kantholz44mm/cpu/documentation/protokolle/protokoll_17_10_2024.md

17.10.2024
Martin Rentschler, Matthias Raba
Besprechung zum Ablauf der Studienarbeit

# Protokoll
Allgemeines zur Betreuung (Martin):
- Individuelle Bewertung je nach Betreuer (hoher Freiheitsgrad)
- Bewertung anhand gleicher Bewertungsmatrix wie T2000 & Bachelorarbeit (evtl. kleine Gewichtungsänderungen)

Zur Wirtschaftlichkeit:
- Allgemeines wirtschaftliches Denken im Vorgehen (wie effizient ist eine Lösung)
- Dokumentierte Entscheidungsfindung mit wirtschaftlicher Betrachtung (Zeit, Prioritäten setzen, etc.)

Zwischenstand bei "Halbzeit":
- Bewertung nach gleichem Schema, gemeinesames Durchsprechen
- Daher Erwartungshaltung: Zur Halbzeit muss bewertbarer Stand vorliegen
    - Inhaltliche Struktur (Kapitelstruktur)
    - Grob die Hälfte ausgearbeitet

Frühzeitig anzeigen, wenn der Projektverlauf "aus den Fugen gerät"

Projektplanung:
- Nicht nur Zeitplan, sondern auch:
  - Bewertung, was kritische Teile sind
  - Wo steckt Potential für Verzögerungen
  - Verhalten im Problemfall
  - etc.
- Erstplan für gesamtes Projekt
  - Aktuelle Gegebenheiten
  - Realistisch darstellen, wie Ziel erreicht wird
  - Nicht final, aber seriöse, kritisch durchdachte Planung
  - Meilensteine mit Granularität von Monaten oder Wochen (von grob nach fein durcharbeiten)
  - Ist das Projekt machbar? Ist der Plan noch haltbar (kontinuierlich nachprüfen)
- Meilensteine
  - Entweder fixer Zeitpunkt
  - oder fixer Zeitpunkt mit fixem Featureset
  - Größenordnung: 3-5 Meilensteine
    - Halbzeit (Zeit)
    - Abgabe (Zeit)

Ausreichend Zeit für Puffer
Feature Creep bewusst vermeiden, auch im kleinen Rahmen

Intelligente Projektplanung:
Was ist der "Kern" der Arbeit, was ist "Bonus"
Visuell arbeiten: Alles aufs Papier, dann gruppieren und identifizieren -> Präzisierung des Rahmens

Frage Matthias: Wie viel Zeit sollte für Organisatorisches aufgewendet werden
-> Ca. 10% - 20% in planerische Fragen stecken (lieber zuviel als zu wenig)

Frage Matthias: Wie wird mit Hardware umgegangen? Wann soll ich bestellen/aufbauen
Perspektive aus Sicht des Ziels (pragmatisch): "Ich will am Ende X Leiterkarten haben, die in Schaltung XY resultieren"
Daraus Ableitung der Zwischenziele (erneut: reichlich Puffer einplanen)
Lücken in der Bearbeitungszeit (Warten auf Hardware, Bestückung, etc.) -> Andere Tätigkeiten abarbeiten
Betrachtung spätester/frühester Zeitpunkt, Hardware zu bestellen (auch für Teilbestellungen)
Brauche ich einen Prototypen? In welcher Reihenfolge werden die Komponenten aufgebaut (Stichpunkt Projektplanung)
-> Inkrementelles Vorgehen (im Kontrast zu iterativ)

Rahmenbedingungen Dokumentation:
- Standardstruktur (Stand der Technik: Grundarchitekturen, Grundlagen, etc., Fazit, Konzept, Umsetzung, Inbetriebnahme/Testing)
- 3 - 5 Kapitel
- ca. 50 - 80 Seiten

Frage Matthias: Wie viel Hardware, wie viel zur Software/Struktur/Logik
- Erklärung der Hardware-Grundbauelemente (Bottom up; Gatter, Resistoren, Dioden -> Module -> Bibliothek -> CPU)
- Hardwareteil ansonsten knapp
- Nach eigener Aufwandsabschätzung, wie viel Aufwand ist Software/Hardware
- Nicht kategorisch auftrennen, was inhaltlich oder in der Bearbeitung parallel passiert

Konkrete Aufgabenstellung:
- Bisher bereits hinreichend besprochen
- Konkretisierung: Was braucht wie lange, was wird gestrichen, was kommt dazu, was dient dem Lernziel

Empfehlung:
An etablierten Standards bleiben/orientieren
Wenn eigene ISA, dann ausreichende kritische Auseinandersetzung mit Literatur dazu (!)
Haptisches Eingabe-/Ausgabewerk, Displays/LEDs, Knöpfe, etc.
