kantholz44mm/cpu/documentation/paper/acronyms.tex

\DeclareAcronym{can}{
    short = CAN,
    long = Controller Area Network,
}

\DeclareAcronym{hmi}{
    short = HMI,
    long = Human Machine Interface,
}

\DeclareAcronym{ip}{
    short = IP,
    long = Internet Protocol,
}

\DeclareAcronym{api}{
    short = API,
    long = Application Programming Interface,
}

\DeclareAcronym{rest}{
    short = REST,
    long = Representational State Transfer,
}

\DeclareAcronym{ssh}{
    short = SSH,
    long = Secure Shell,
}

\DeclareAcronym{dll}{
    short = DLL,
    long = Dynamic-link Library,
}

\DeclareAcronym{json}{
    short = JSON,
    long = JavaScript Object Notation,
}

\DeclareAcronym{ascii}{
    short = ASCII,
    long = American Standard Code for Information Interchange
}

\DeclareAcronym{hal}{
    short = HAL,
    long = Hardware Abstraction Layer 
}

\DeclareAcronym{gui}{
    short = GUI,
    long = Graphical User Interface 
}

\DeclareAcronym{xml}{
    short = XML,
    long = Extensible Markup Language,
}

\DeclareAcronym{uuid}{
    short = UUID,
    long = Universally Unique Identifier,
}

\DeclareAcronym{usb}{
    short = USB,
    long = Universal Serial Bus,
}

\DeclareAcronym{ide}{
    short = IDE,
    long = Integrated Development Environment,
}

\DeclareAcronym{tls}{
    short = TLS,
    long = Transport Layer Security,
}

\DeclareAcronym{rpc}{
    short = RPC,
    long = Remote Procedure Call,
}

\DeclareAcronym{url}{
    short = URL,
    long = Uniform Resource Locator,
}

\DeclareAcronym{http}{
    short = HTTP,
    long = HyperText Transfer Protocol,
}

\DeclareAcronym{bsw}{
    short = BSW,
    long = Basis software,
}

\DeclareAcronym{eeprom}{
    short = EEPROM,
    long = Electronically Erasable Programmable Read-only Memory,
}

\DeclareAcronym{mcu}{
    short = MCU,
    long = Main Control Unit,
}

\DeclareAcronym{crc}{
    short = CRC,
    long = Cyclic Redundancy Check,
}

\DeclareAcronym{sent}{
    short = SENT,
    long = Single Edge Nibble Transmission,
}

\DeclareAcronym{ecu}{
    short = ECU,
    long = Electronic Control Unit,
}

\DeclareAcronym{sbc}{
    short = SBC,
    long = Single Board Computer,
}

\DeclareAcronym{cpu}{
    short = CPU,
    long = Central Processing Unit,
}

\DeclareAcronym{pcb}{
    short = PCB,
    long = Printed Circuit Board,
}

\DeclareAcronym{esd}{
    short = ESD,
    long = Electrostatic Discharge,
}

\DeclareAcronym{spc}{
    short = SPC,
    long = Short Pulse Code,
}

\DeclareAcronym{mosfet}{
    short = MOSFET,
    long = Metal Oxide Semiconductor Field Effect Transistor
}

\DeclareAcronym{bjt}{
    short = BJT,
    long = Bipolar Junction Transistor,
}

\DeclareAcronym{fm}{
    short = FM,
    long = Frequency Modulation,
}

\DeclareAcronym{am}{
    short = AM,
    long = Amplitude Modulation,
}

\DeclareAcronym{adc}{
    short = ADC,
    long = Analog to Digital Converter,
}

\DeclareAcronym{dc}{
    short = DC,
    long = Direct Current,
}

\DeclareAcronym{osi}{
    short = OSI,
    long = Open Systems Interconnect,
}

\DeclareAcronym{iso}{
    short = ISO,
    long = International Organisation for Standardisation,
}

\DeclareAcronym{tcpip}{
    short = TCP/IP,
    long = Transfer Control Protocol / Internet Protocol,
}

\DeclareAcronym{dma}{
    short = DMA,
    long = Direct memory access
}

\DeclareAcronym{pwm}{
    short = PWM,
    long = Pulse Width Modulation
}

\DeclareAcronym{i2s}{
    short = I2S,
    long = Inter-Integrated Circuit Sound
}

\DeclareAcronym{isa}{
    short = ISA,
    long = Instruction Set Architecture
}

\DeclareAcronym{lifo}{
    short = LIFO,
    long = \text{Last-In, First-Out}
}

\DeclareAcronym{mips}{
    short = MIPS,
    long = \text{Microprocessor without Interlocked Pipeline Stages}
}

\DeclareAcronym{risc}{
    short = RISC,
    long = \text{Reduced Instruction Set Computing}
}

\DeclareAcronym{cisc}{
    short = CISC,
    long = \text{Complex Instruction Set Computing}
}

\DeclareAcronym{alu}{
    short = ALU,
    long = Arithmetic Logic Unit
}

\DeclareAcronym{smd}{
    short = SMD,
    long = Surface mounted device
}

\DeclareAcronym{led}{
    short = LED,
    long = Light emitting diode
}

\DeclareAcronym{tht}{
    short = THT,
    long = Through Hole Technology
}

\DeclareAcronym{dut}{
    short = DUT,
    long = Device Under Test
}

\DeclareAcronym{ic}{
    short = IC,
    long = Integrated Circuit
}

\DeclareAcronym{ieee}{
    short = IEEE,
    long = Institute of Electrical and Electronics Engineers,
}

\DeclareAcronym{io}{
    short = IO,
    long = Input/Output,
}

\DeclareAcronym{ram}{
    short = RAM,
    long = Random access memory,
}

\DeclareAcronym{rom}{
    short = ROM,
    long = Read-Only memory
}

\DeclareAcronym{arm}{
    short = ARM,
    long = {Advanced RISC Machines (formerly Acorn RISC Machines)},
}

\DeclareAcronym{lc3}{
    short = {LC-3},
    long = {Little Computer 3},
}

\DeclareAcronym{ava}{
    short = AVA,
    long = Arithmetic Visualisation Architecture
}

\DeclareAcronym{jedec}{
    short = JEDEC,
    long = Joint Electron Device Engineering Council
}

\DeclareAcronym{ptc}{
    short = PTC,
    long = Positive Temperature Coefficient
}

\DeclareAcronym{ntc}{
    short = NTC,
    long = Negative Temperature Coefficient
}

\DeclareAcronym{uart}{
    short = UART,
    long = Universal Asynchonous Receiver/Transmitter
}

\DeclareAcronym{gpio}{
    short = GPIO,
    long = General Purpose Input/Output
}

\DeclareAcronym{icp}{
    short = ICP,
    long = In-circuit programming
}

\DeclareAcronym{icsp}{
    short = ICSP,
    long = In-circuit serial programming
}

\DeclareAcronym{emi}{
    short = EMI,
    long = Electromagnetic Interference
}

\DeclareAcronym{lsb}{
    short = LSB,
    long = Least Significant Bit
}

\DeclareAcronym{jvm}{
    short = JVM,
    long = Java Virtual Machine
}
