kantholz44mm/cpu/documentation/paper/cover.tex

\begin{titlepage}
    \begin{minipage}[t]{8.2cm}
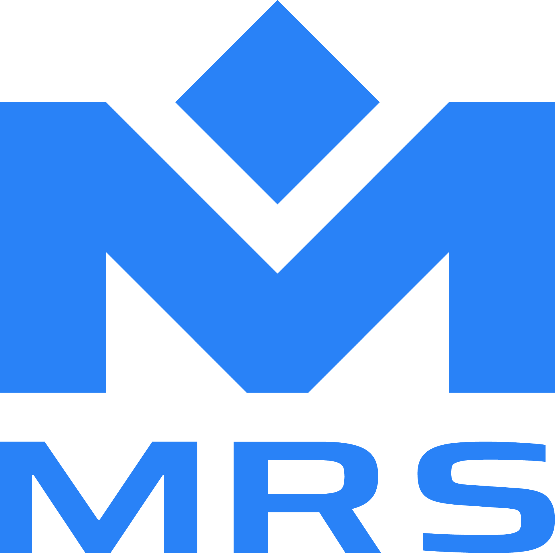
[picture p1: documentation/paper/images/logo.jpg]
        
    \end{minipage}
    \hfill
    \begin{minipage}[t]{5.4cm}
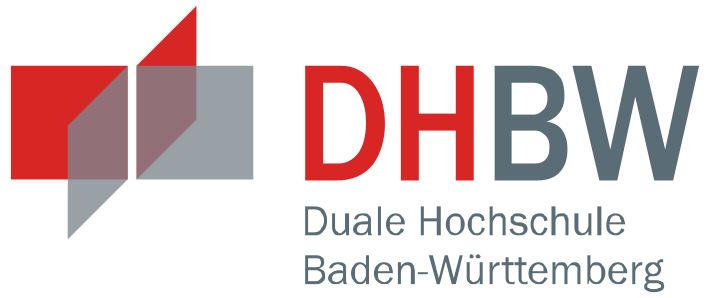
[picture p2: documentation/paper/images/dhbw.png]
        
    \end{minipage}
	\enlargethispage{20mm}
	\begin{center}
		\vspace*{12mm}	{\LARGE\textbf \vtitle }\\
		\vspace*{12mm}	{\large Student research project (T3\_3101)}\\
		\vspace*{12mm}	of the Computer Science program at\\
        \vspace*{3mm}   Cooperative State University of Baden-Württemberg (DHBW)\\
		\vspace*{12mm}	by\\
		\vspace*{3mm}		{\large\textbf  \vauthor}\\
		\vspace*{12mm}	\today\\
	\end{center}
    \begin{center}
        \renewcommand{\arraystretch}{1.2}
        \vfill
        \begin{tabular}{l|l}
            \textbf{Period of work} & \vtimespan \\
            \textbf{Registration number, Class} & \vregistrationnumber, \vcourse \\
            \textbf{Location} & Rottweil \\
            \textbf{training organisation} & \vcompany \\
            \textbf{Supervisor} & \vsupervisor \\
        \end{tabular}
        \renewcommand{\arraystretch}{1.0}
    \end{center}
    \vspace{3cm}
\end{titlepage}
