kantholz44mm/cpu/documentation/paper/appendix.tex

\appendix

\section*{}
\addtocounter{section}{1}

\subsection{Full ALU schematic} \label{app:schematic_alu}
\includepdf[pages=-, angle=90, width=0.9\textwidth]{images/appendix/schematic_alu.pdf}
\newpage

\subsection{IO unit schematic} \label{app:schematic_io}
\includepdf[pages=-, angle=90, width=0.9\textwidth]{images/appendix/schematic_io.pdf}
\newpage

\subsection{Register fabric schematic} \label{app:schematic_register_fabric}
\includepdf[pages=-, angle=90, width=0.9\textwidth]{images/appendix/schematic_register_fabric.pdf}
\newpage

\subsection{Register schematic} \label{app:schematic_register}
\includepdf[pages=-, angle=90, width=0.9\textwidth]{images/appendix/schematic_register.pdf}
\newpage

\subsection{Logic gate-level \ac{ava} simulation} \label{app:simulation_full}
\begin{center}
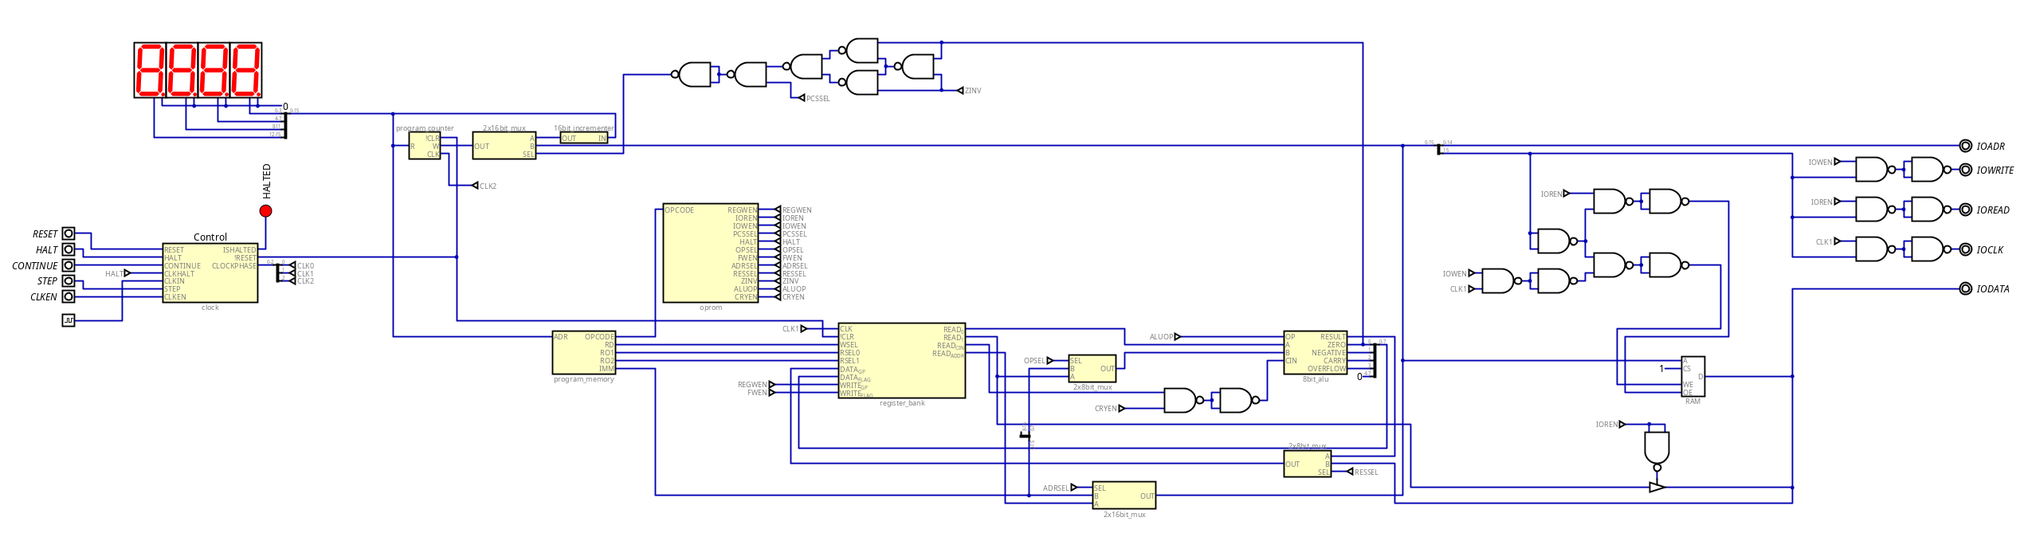
[picture p3: documentation/paper/images/appendix/logical_design_full.png]
    
\end{center}
\newpage

\subsection{Assembled CPU} \label{app:cpu_assembly}
\begin{center}
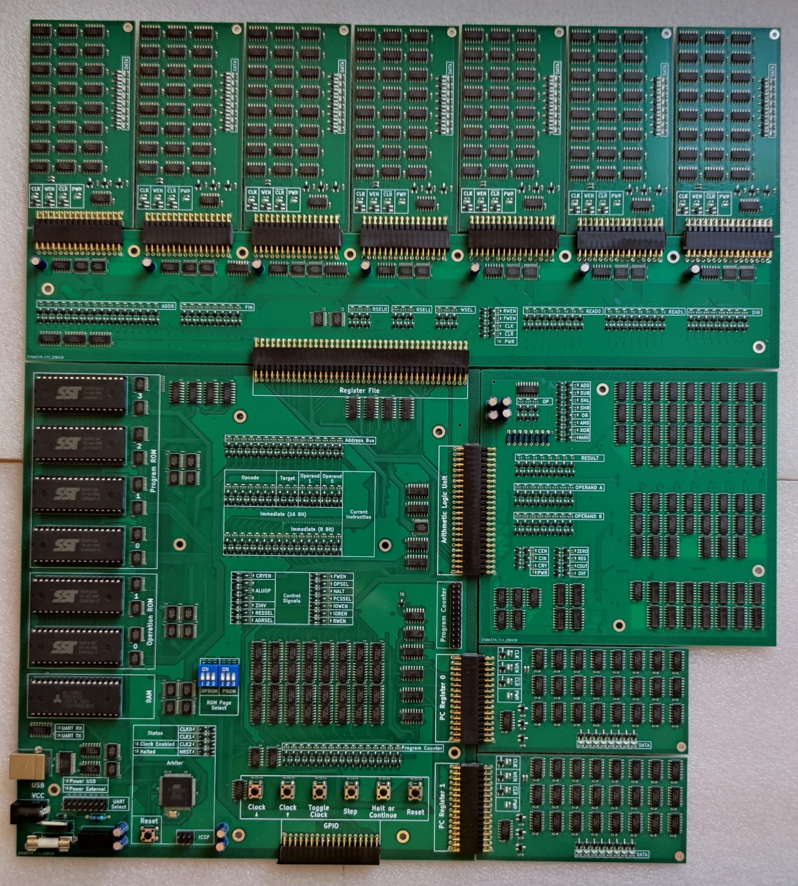
[picture p4: documentation/paper/images/pcb/full_assembly_front.jpg]

\end{center}
\newpage

\subsection{Assembled ALU circuit board} \label{app:alu_assembled}
\begin{center}
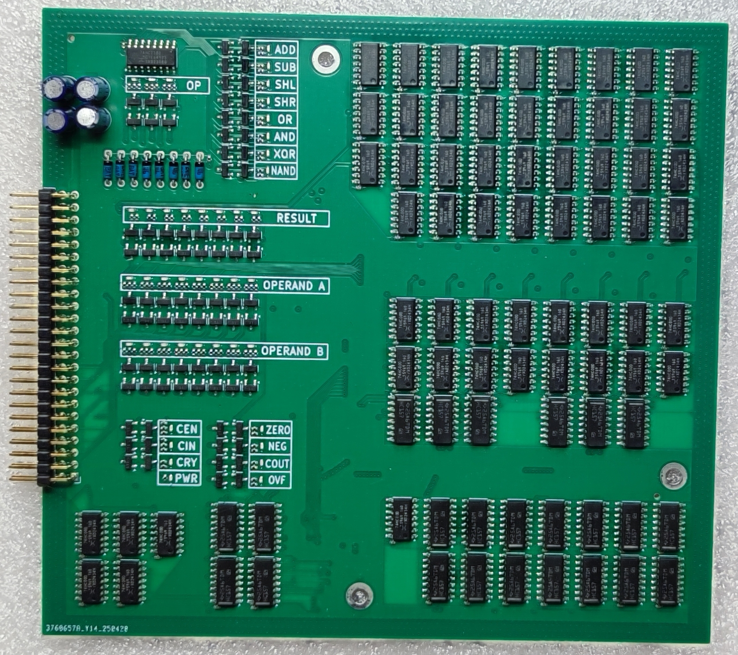
[picture p5: documentation/paper/images/pcb/alu_assembled_front.jpg]
    
\newpage
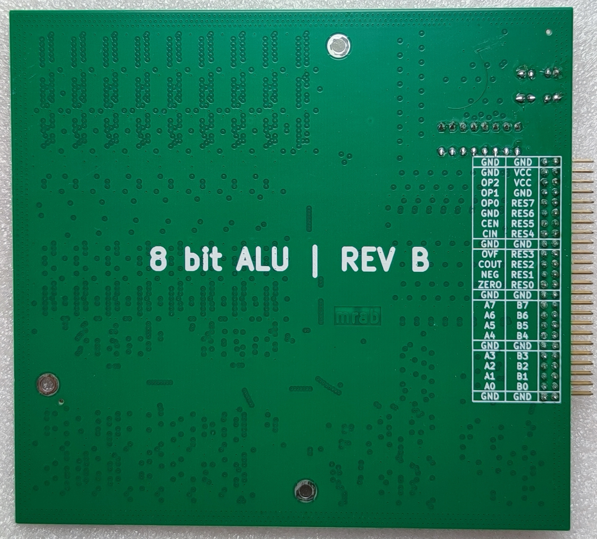
[picture p6: documentation/paper/images/pcb/alu_assembled_back.jpg]

\end{center}
\newpage

\subsection{Unassembled ALU circuit board} \label{app:alu_not_assembled}
\begin{center}
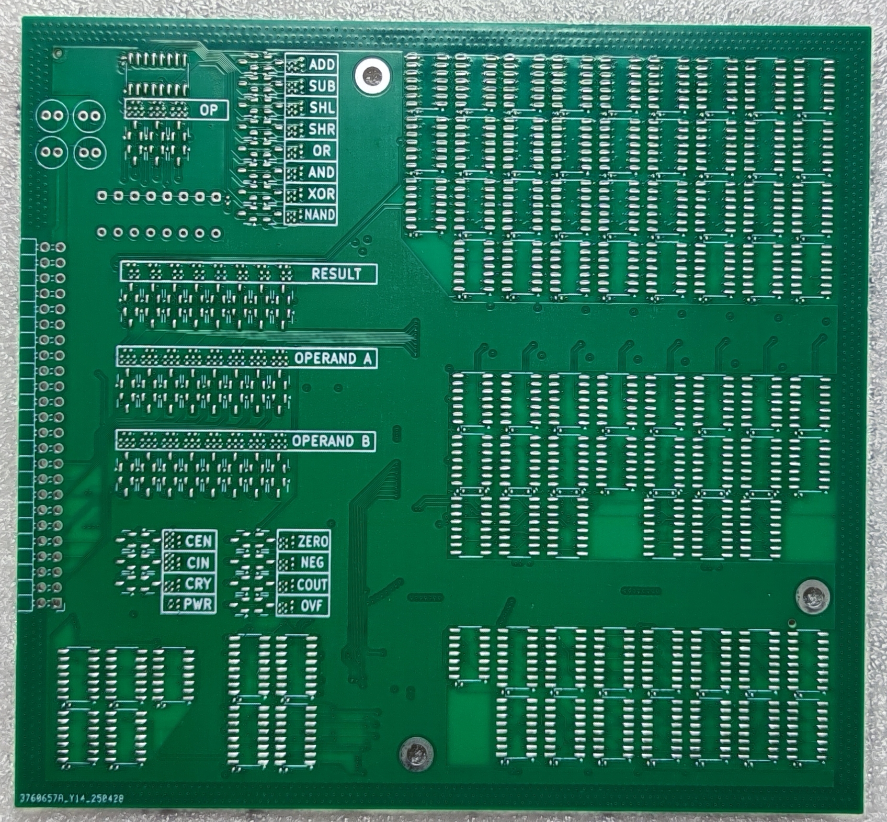
[picture p7: documentation/paper/images/pcb/alu_not_assembled_front.jpg]

\newpage
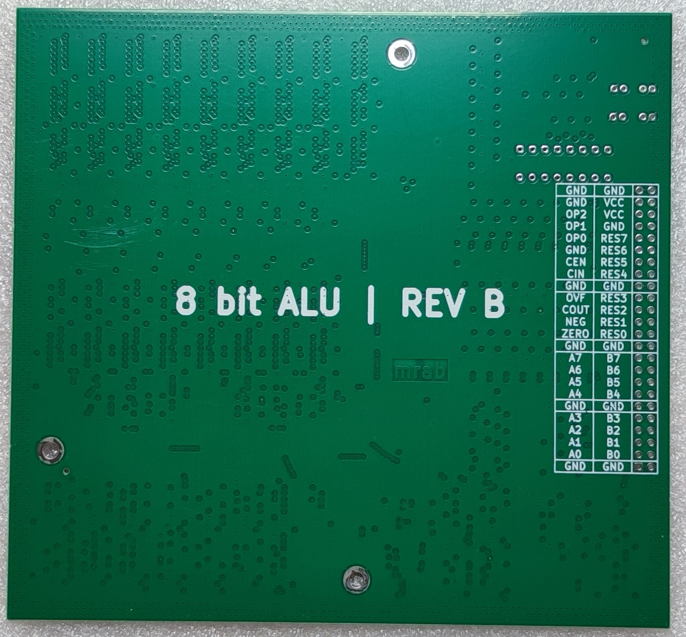
[picture p8: documentation/paper/images/pcb/alu_not_assembled_back.jpg]

\end{center}
\newpage

\subsection{Assembled register fabric circuit board} \label{app:register_fabric_assembled}
\begin{figure}[H]
    \centering
    \begin{subfigure}[b]{0.49\textwidth}
        \centering
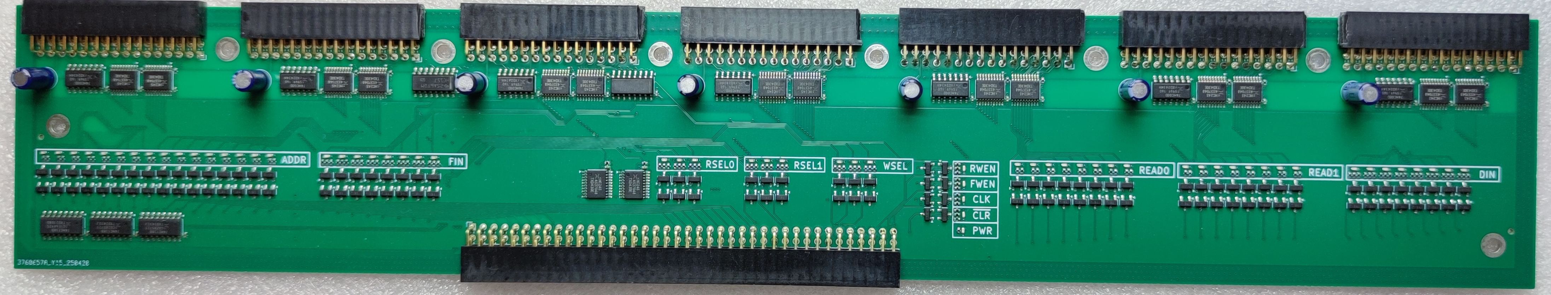
[picture p9: documentation/paper/images/pcb/fabric_assembled_front.jpg]
        
    \end{subfigure}
    \hfill % Adds spacing between subfigures
    \begin{subfigure}[b]{0.49\textwidth}
        \centering
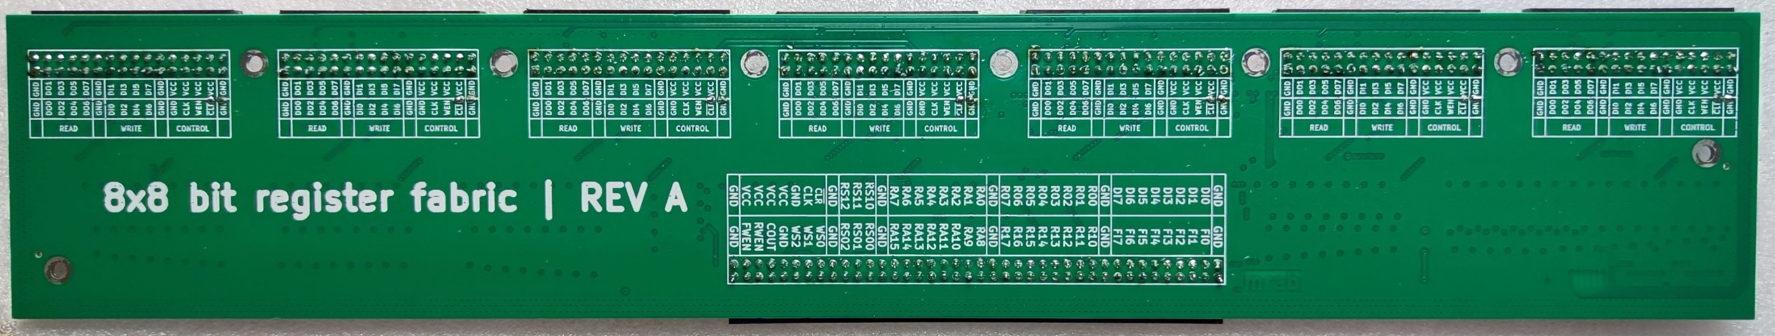
[picture p10: documentation/paper/images/pcb/fabric_assembled_back.jpg]
        
    \end{subfigure}
\end{figure}
\newpage

\subsection{Unassembled register fabric circuit board} \label{app:register_fabric_not_assembled}
\begin{figure}[H]
    \centering
    \begin{subfigure}[b]{0.49\textwidth}
        \centering
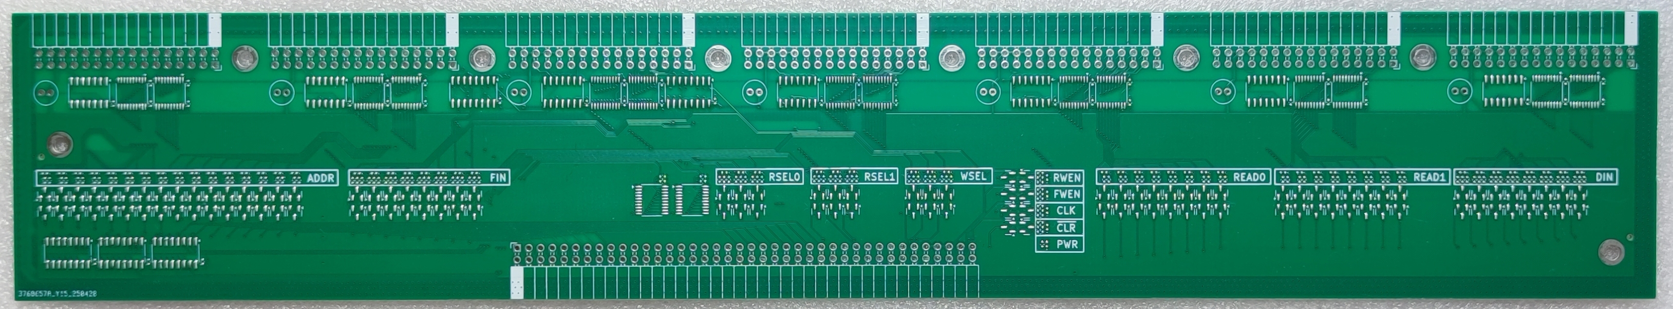
[picture p11: documentation/paper/images/pcb/fabric_not_assembled_front.jpg]
        
    \end{subfigure}
    \hfill % Adds spacing between subfigures
    \begin{subfigure}[b]{0.49\textwidth}
        \centering
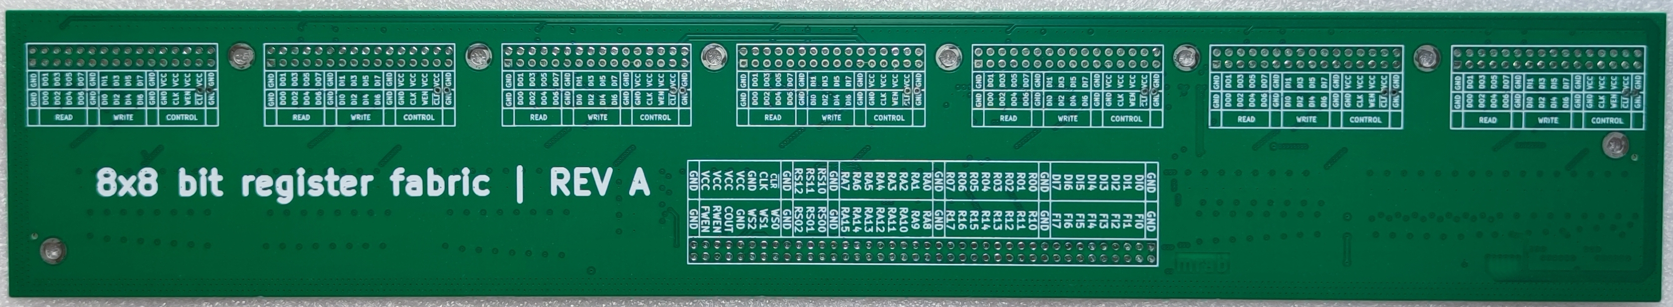
[picture p12: documentation/paper/images/pcb/fabric_not_assembled_back.jpg]
        
    \end{subfigure}
\end{figure}
\newpage

\subsection{Unassembled IO circuit board} \label{app:io_not_assembled}
\begin{center}
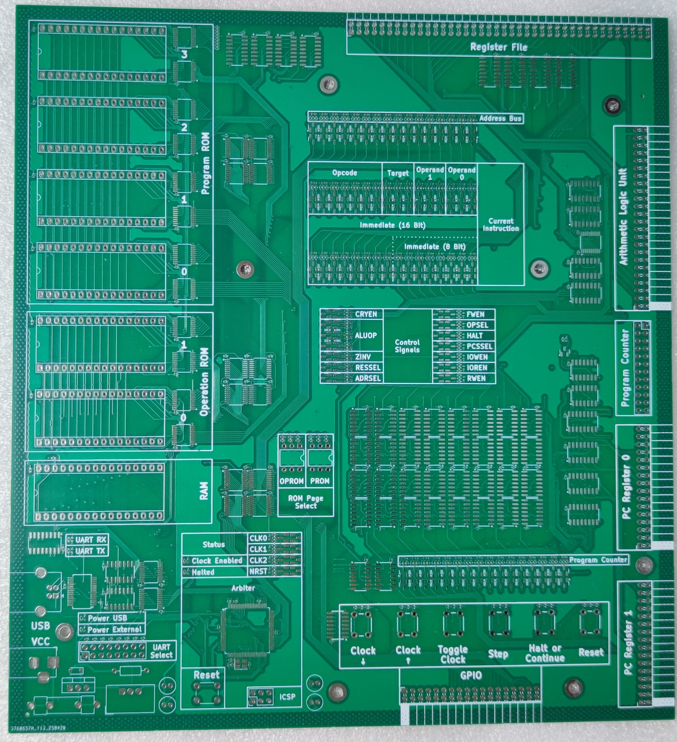
[picture p13: documentation/paper/images/pcb/io_not_assembled_front.jpg]

\newpage
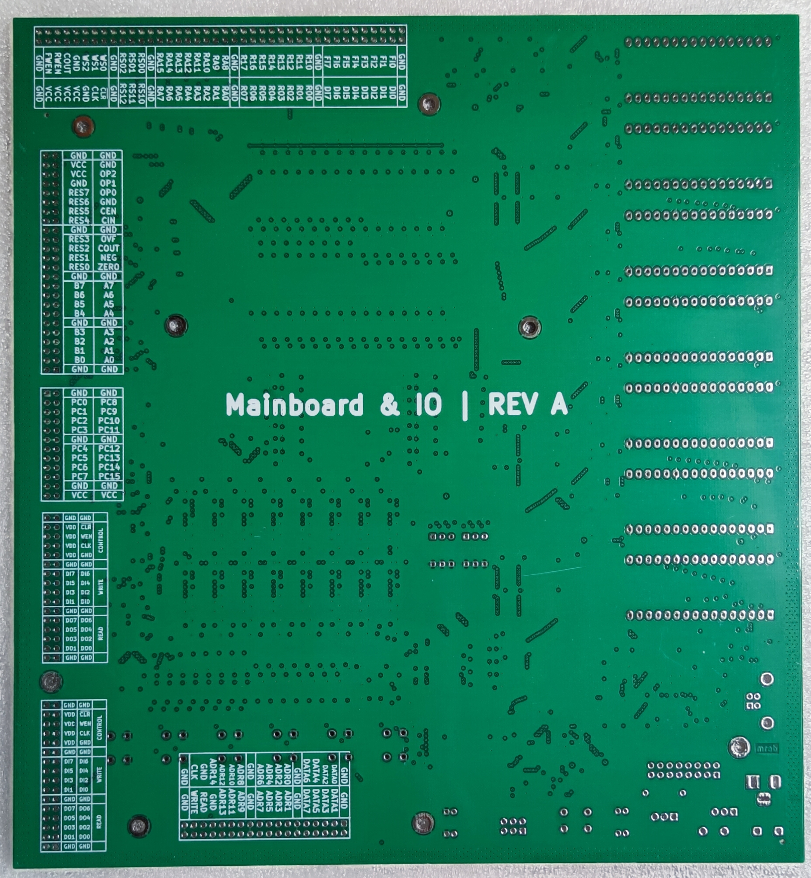
[picture p14: documentation/paper/images/pcb/io_not_assembled_back.jpg]

\end{center}
\newpage

\subsection{Assembled IO circuit board} \label{app:io_assembled}
\begin{center}
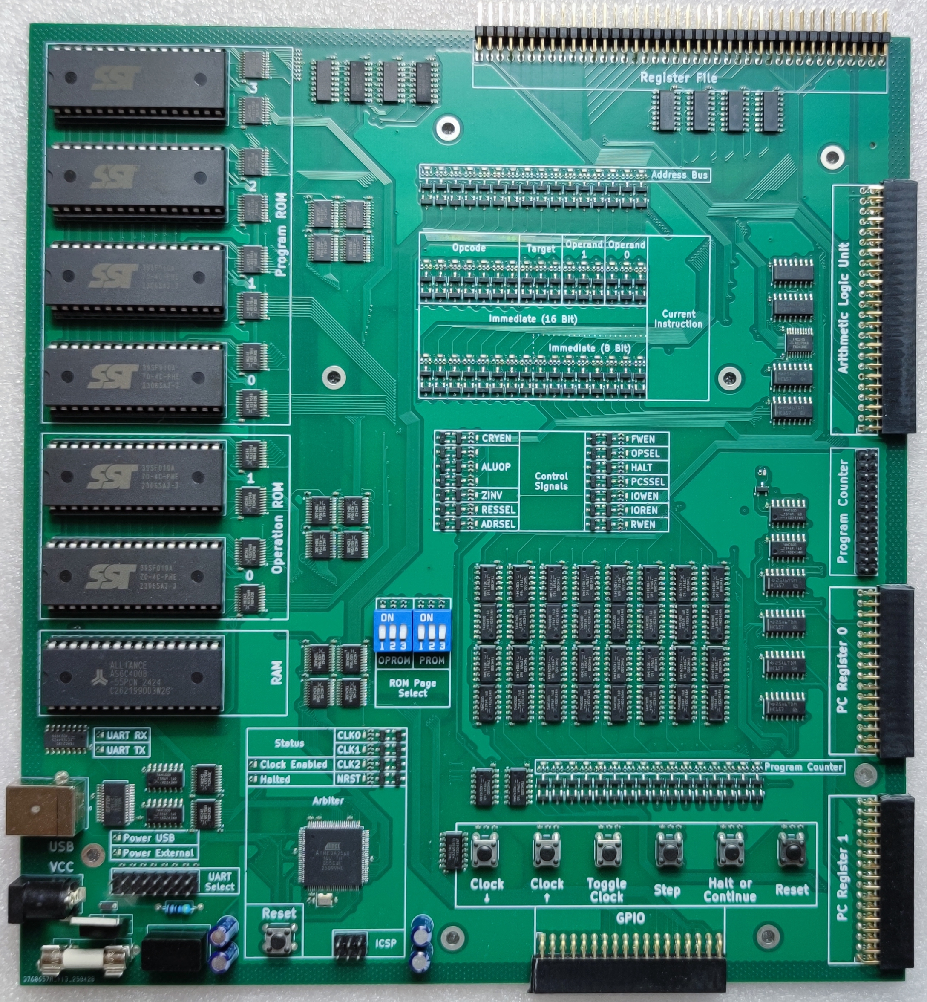
[picture p15: documentation/paper/images/pcb/io_assembled_front.jpg]

\newpage
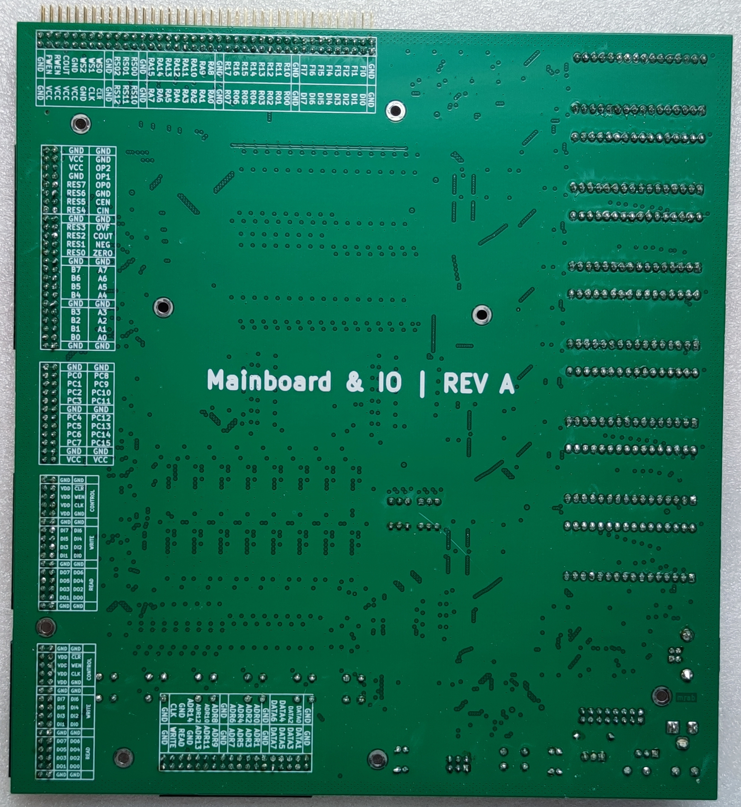
[picture p16: documentation/paper/images/pcb/io_assembled_back.jpg]

\end{center}
\newpage

\subsection{Assembled register circuit board} \label{app:register_assembled}
\begin{center}
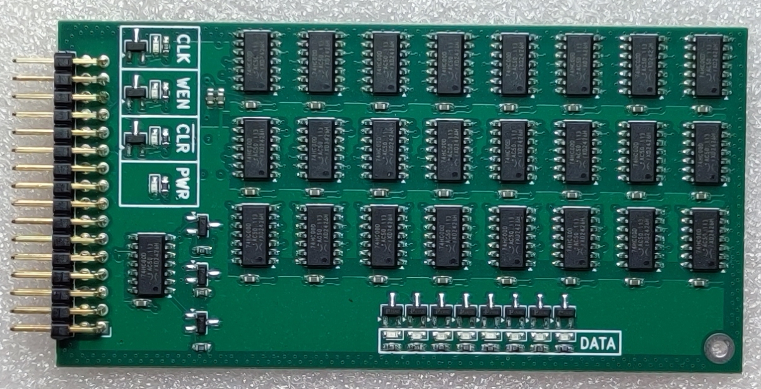
[picture p17: documentation/paper/images/pcb/register_assembled_front.jpg]
    
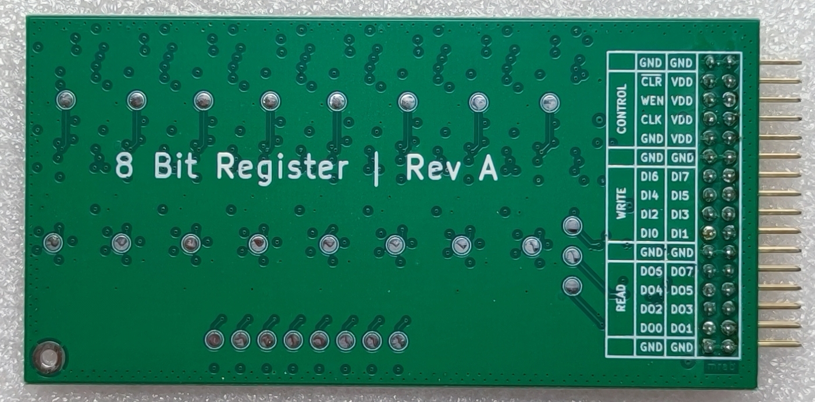
[picture p18: documentation/paper/images/pcb/register_assembled_back.jpg]

\end{center}
