kantholz44mm/cpu/documentation/organisation/notes.md

- Beschreibung Übersicht vervollständigen (Farbige Pfeile, Taktgesteuerte Elemente kennzeichnen?)
- Synchrone/Asynchrone Logik erklären
- Anfangs Designphilosophie erklären
- Kleine Historie und Einordnung in diese
