kantholz44mm/cpu/documentation/paper/statutory.tex

%!TEX root = ../dokumentation.tex

\thispagestyle{empty}
\vspace*{2em}

\section*{Statutory declaration}

I hereby declare that I have composed the present work {\itshape \vtitle} myself and without use of any other than the
cited sources and aids. Sentences or parts of sentences quoted literally are marked as such; other references
with regard to the statement and scope are indicated by full details of the publications concerned. The work
in the same or similar form has not been submitted to any examination body and has not been published.
This thesis was not yet, even in part, used in another examination or as a course performance.

I am aware that a false statement will have legal consequences.

\vspace{3em}

Horb, \today
\vspace{1em}

\\
\rule{6cm}{0.4pt}\\
\vauthor
