kantholz44mm/cpu/documentation/paper/sections/fundamentals/isa.tex

\subsection{Instruction Set Architecture}

An \ac{isa} defines the shared behavior of different implementations of said \ac{isa}. It is an abstract model that guarantees compatibility of software between computers of different implementation. This is called binary intercompatibility. It describes the supported set of instructions, their behavior, as well as a memory model. The memory model describes the number and roles of all registers, as well as the behavior of accessing memory and external interfaces. The latter part is also called the ``IO-Model'' of the \ac{isa}. An \ac{isa} may be designed to be extensible or closed for future modifications. An \ac{isa} may adhere more to the principles of \ac{risc} or \ac{cisc}, or a combination of both.

\subsubsection{ISA vs. Implementation} \label{sec:isa_vs_implementation}

An \ac{isa} is an abstract model and does not specify \textit{how} it is to be implemented. When a \ac{cpu} implementing a specific \ac{isa} is designed, the designers are largely free to choose the exact implementation details, as long as the end product adheres to the rules laid out by the \ac{isa}. The distinction between an \ac{isa} and an implementation is important; an \ac{isa} by itself cannot run code. There may be multiple implementations using vastly different electrical or logical technologies. Due to the boolean logic transformation rules mentioned in \autoref{sec:logical_operators}, there is an infinite number of possible implementations, even when the same set of electrical components is used. Many \acp{isa} also leave room for interpretation or choice when it comes to electrotechnical details such as the voltage levels used, etc. An implementation of an \ac{isa} is also referred to as a microarchitecture. For example, the microarchitecture used by Intel for their flagship x86 \acp{cpu} is called the ``P6'' microarchitecture \cite{intel1997p6}.

\subsubsection{Memory} \label{sec:fundamentals_isa_memory}

A digital computer operates on data, which is stored within some memory. An \ac{isa} must define how this data is organised and used so that software is guaranteed to behave as expected regardless of the implementation.

\paragraph*{Memory Model} \label{sec:fundamentals_isa_memory_model}

The memory model of an \ac{isa} specifies how the data within the system is laid out. A memory in this context is any electrical circuit that stores some number of bits of information for later use. Registers store temporary data such as operands, results or variables and are intended to be frequently read from and written to. They are addressed directly by the programmer through their individual names. Formally, this class of memory is called the internal storage of a \ac{cpu} \cite{bryant2015computer}. In addition to the set of registers, cache also falls into this category. However, since cache is implementation-dependent and may be implemented transparently to the programmer and to the \ac{isa}, it is not discussed here.

Most useful programs are larger than the amount of data that fits into the register set. Most programs also use far more memory to store temporary data such as variables. Therefore, in addition to the registers, other memories are available to the programmer. These memories are typically orders of magnitude slower to access when compared to the internal storage, especially the registers. However, in turn, they offer orders of magnitude more storage. In this context, all of these memories shall be referred to as ``main memories''. All memories that are physically implemented must be finite in size. Therefore, they are divided up into cells of usefully sized data.

A ``word'' is the smallest, atomic unit of data used by most operations of an \ac{isa}. It is specified as the number of bits that form one word, usually a power of two. For example, in a 32 bit architecture, the \texttt{ADD} operation will most likely operate on two 32 bit operands, ouputting another 32 bit result. The lowest level data storage units of the same \ac{isa} will most likely be designed to also contain 32 bit words to contain one operand or result each. Each word of $n$ bits can represent $2^n$ different values. This is typically a power of 2, since many of the circuits used to implement such systems naturally favor such sizes. This includes decoders, multiplexers and similar circuits. Early processors such as the Intel 4004 had a word size of 4 bits, meaning one word can represent 16 distinct values. Most modern systems have either 32 or 64 bit processors. However, even so, the venerable byte has remained as the smallest practical, individually addressable unit of bits, consisting of 8 bits each. It can therefore represent 256 distinct values. It has proven to be a good middle ground in terms of granularity and size. Most \ac{ram} and \ac{rom} components are byte-addressible, meaning they also handle data with a size of 8 bits each. If the programmer needs to process data that does not fit into a single word, multiple words can be used and processed in sequence to form arbitrarily large data. 

Similarly, multiple registers can be concatenated to hold a larger piece of data. For example, the \ac{mips} architecture uses two dedicated 32 bit registers ``HI'' and ``LO'' to store results of multiplication or division, since these can easily overflow a single 32 bit register when doing an operation with 32 bit operands \cite{mips1995}. Similarly, throughout the evolution of the x86 \ac{isa}, the initial 8 bit registers were first expanded to 16, then to 32, and most recently to 64 bit registers. To retain backwards compatibility, the smaller sections remain accessible to the programmer.  

\begin{figure}[H]
    \centering
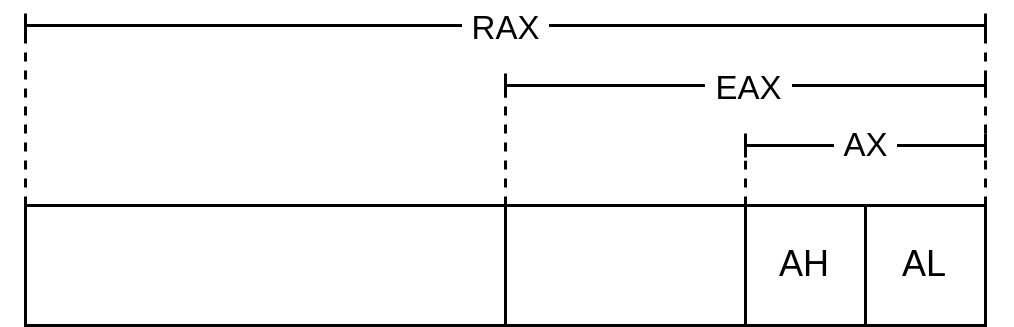
[picture p48: documentation/paper/images/drawio/x86_register_size.png]
      % Replace with your image file
    \caption[Composition of an x86 register]{Composition of a general purpose register in the x86 architecture. Each square represents one byte.}
    \label{fig:x86_register_sizes}
\end{figure}

\autoref{fig:x86_register_sizes} shows the composition of a single general purpose register in the x86 architecture. The Intel 8086 was the first processor to implement the x86 \ac{isa}. It featured 8 general purpose 8 bit registers, which could be accessed in pairs of two to form 4 16 bit registers \cite[p. 1-6]{intelASM86Manual1983}. For example, the \texttt{AH} and \texttt{AL} registers can be accessed by some instructions as the 16 bit register \texttt{AX}. This pattern was extended to form 32 and eventually 64 bit registers. Using multiple registers in combination to form a single larger memory can be used by an \ac{isa} to index into larger memories than would otherwise be possible. It is also common practice for an \ac{isa} to feature registers of different sizes, including ones larger than the native word size. Again, this way, larger memories can be indexed, which can be used to increase the maximum size and complexity of programs.
\clearpage
Depending on the way the memory can be accessed by the programmer, an \ac{isa} falls into one of three proven memory models:

\begin{itemize}
    \item Von Neumann
    \item Harvard
    \item Modified Harvard
\end{itemize}

In a machine obeying the Von Neumann memory model, there is only one global memory space, which contains both data and program instructions. In a Harvard architecture, these memories have a separate address space. A modified Harvard architecture is functionally the same as a regular Harvard one, but the software can access the instruction memory as if it was data, while still being stored in a separate memory. This is the memory model used by many modern \ac{isa}. Having two separate memories for storing data and program instructions has the main benefit of allowing different word and address sizes.

\paragraph*{Memory mapped \ac{io}}

Some of the address space available to the programmer can have an \ac{io} device connected to it. This is called ``memory mapped \ac{io}''. In this method, main memory and \ac{io} devices use the same, shared address space. This allows the \ac{cpu} to use regular memory operations to interact with heterogenous devices such as \ac{gpio}, \acp{adc} or other \acp{cpu} by simply reading or writing to the address. One example for this practice is the memory mapping of the original GameBoy console. The memory region \texttt{0x8000} - \texttt{0xA000} is mapped to the video \ac{ram} used by the graphics unit. Therefore, modifying data in this address region modifies the colors of the pixels shown by the display\cite{nintendo_gb_manual_v1_1}. 

Memory mapped \ac{io} is contrasted by port-based \ac{io}, in which there are dedicated \ac{io} ports with their own address or name space. These must be accessed by special instructions such as \texttt{OUTB} or \texttt{INB}.

\paragraph*{Execution Model} \label{sec:fundamentals_isa_execution_model}

An execution model describes how the computer achieves computation. This means the order of execution and the number and location of operands and results. As with the memory model, there are multiple options to choose from:

\begin{figure}[H]
    \centering
    \begin{subfigure}[b]{0.3\textwidth}
        \centering
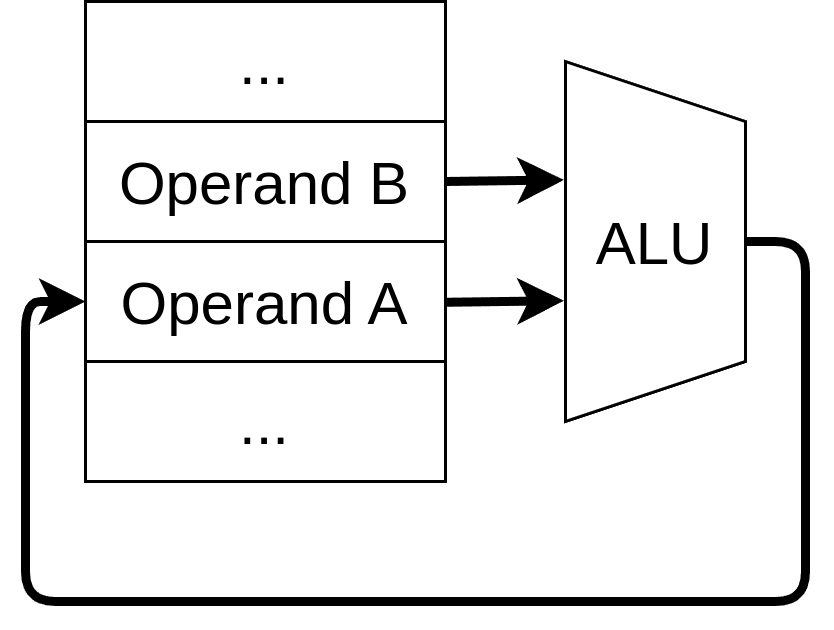
[picture p49: documentation/paper/images/drawio/stack_architecture.png]
         % Replace with your image file
        \caption{Stack based architecture}
        \label{fig:stack_based_architecture}
    \end{subfigure}
    \hfill % Adds spacing between subfigures
    \begin{subfigure}[b]{0.3\textwidth}
        \centering
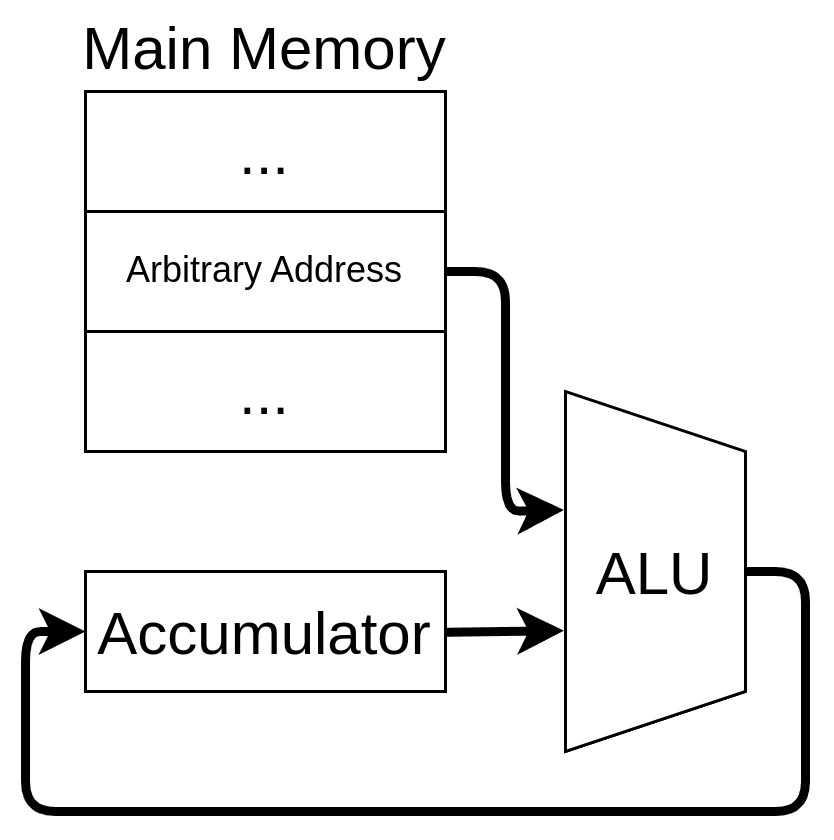
[picture p50: documentation/paper/images/drawio/accumulator_architecture.png]
         % Replace with your image file
        \caption{Accumulator architecture}
        \label{fig:accumulator_architecture}
    \end{subfigure}
    \hfill
    \begin{subfigure}[b]{0.3\textwidth}
        \centering
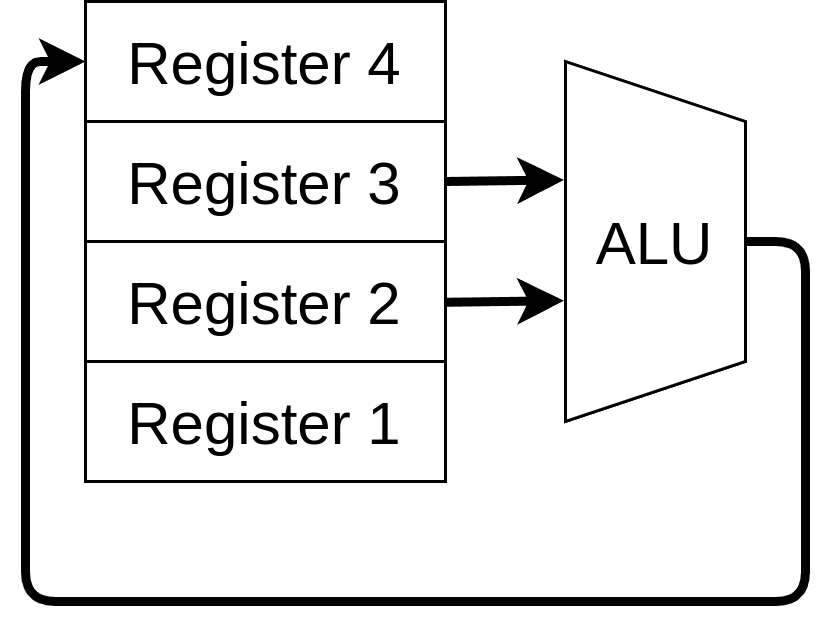
[picture p51: documentation/paper/images/drawio/register_architecture.png]
         % Replace with your image file
        \caption{Register architecture}
        \label{fig:register_architecture}
    \end{subfigure}

    \caption[Execution models]{Working principle of the three execution models Stack, Accumulator and Register}
    \label{fig:execution_models}
\end{figure}

The stack based model uses a single working memory, which is organised by the \ac{lifo} principle. The operands of an operation are always the elements at a specified offset from the stack top. For example, an addition may pop the top two elements off the top of the stack and push the result back ontop. This method has the advantage of not having to specify operand locations in the instruction, allowing for more compact code. However, it lacks the ability to randomly access memory and frequent stack operations can be slow. Since implementing a stack in software instead of hardware is trivial and quite performant on modern hardware, many programming languages are implemented as virtual stack machines. For example, the \ac{jvm}\cite{oracle_jvms_8} and popular python distribution ``CPython''\cite{ike-nwosu2024pythonvm} are implemented as stack machines.

The accumulator-based execution model has a fixed number of registers, one of which is the designated accumulator register. All operations that output a value will store this result in the accumulator register. The accumulator register is also always one of the operands to an operation. The other operand, if required, is read either from memory or from another register, which can either also be fixed or freely chosen by the programmer, depending on the instruction encoding scheme. This execution model is easy to implement and the instructions are also smaller compared to fully addressable operand/destination registers. It is often used in early \ac{cpu} such as the Intel 8008 and 6502 \cite{schlyter200513}. However, its performance is limited by the bottleneck of the accumulator register. it also requires frequent transfers between memory and registers or between registers to save intermediary results, which would otherwise be overwritten by another operation.

The register based execution model provides a fixed set of registers. This model is subdivided further into the ``Register-Register'' and ``Memory-Register'' models. \autoref{fig:register_architecture} shows the former, which is also known as a ``Load-Store architecture'', since the only way of transferring data between registers and memory is via the dedicated load and store operations. All operands and result destinations of an arithmetic operation are registers. The ``Memory-Register'' model allows operations to be read from memory instead. Due to the bottleneck in speed of modern memories, many modern register based architectures are of the Load-Store variant. The register based execution model is highly flexible and well understood. Operands and intermediary results can be reused efficiently and compilers can deterministically optimize register allocation, allowing for higher performance. This is the model used by most prevalent architectures.

\paragraph*{Addressing modes}

There are many different modes of addressing memories. An addressing mode specifies which memory is accessed, and how the address for that memory is calculated. \autoref{fig:addressing_modes_general} shows a hierarchical overview of types of modes of addressing. The complexity and number of arithmetic operations required for each mode increase with column, starting at the left. Within each column, complexity increases from top to bottom.

\begin{figure}[H]
    \centering
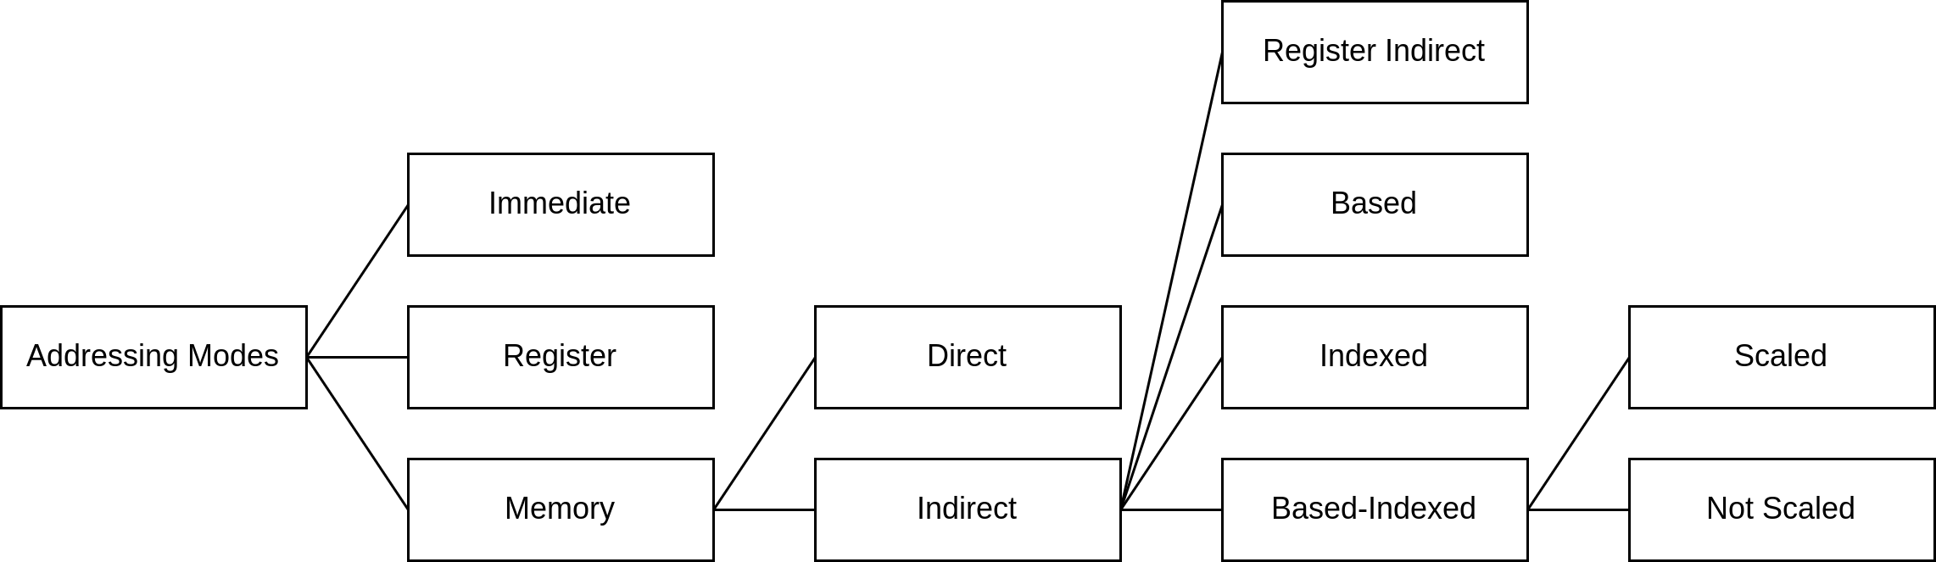
[picture p52: documentation/paper/images/drawio/addressing_modes_general.png]
      % Replace with your image file
    \caption[Hierarchical overview of addressing modes]{Hierarchical overview of addressing modes (Modified from S. Dandamudi, laid out horizontally and compacted for readability \cite{sivarama_addrmodes})}
    \label{fig:addressing_modes_general}
\end{figure}

Again, the complexity increases starting from the left. The more complex an addressing mode is, the more additional hardware is required. For the given modes, the most complex one is referred to as ``Base + Index + Scale + Displacement''. In this mode, the resulting memory address is calculated like so:

$$ \text{Base} + \text{Index} * \text{Scale} + \text{Displacement} $$

This requires additional hardware for performing the additions and multiplication. Note that the ``Scale'' is restricted to 1, 2, 4 or 8 and can therefore be implemented by shifting the index to the left by 1, 2, 3 or 4 bits. In most modern, and some older architectures, the addressing modes can be quite numerous and complex. For example, the Intel 6502 has 13 different addressing modes \cite[13.2.1]{schlyter200513}. However, an \ac{isa} need not implement a large number of addressing modes in order to be useful. For example, the Intel 8008 \ac{cpu} only has 3 addressing modes (Register, Register Indirect and Immediate) \cite{cpu-world8008}. The complex addressing modes are useful when implementing features of high-level programming languages such as arrays or structured data.

\subsubsection{Instructions}

An instruction is the atomic building block of programs. In \ac{risc} architectures, instructions generally do a single thing and side-effects are minimal. In \ac{cisc} architectures, a single instruction may do several things such as incrementing a counter and modifying both the contents of memory and some register.

\paragraph*{Opcodes}

Every instruction is identified by its unique ``Opcode'', which is a discrete number. Based on this number, the processor must infer the number and layout of operands and set up the internal state for execution of the given instruction. The number of bits available for encoding the opcodes determines the maximum number of instructions supported by an \ac{isa}. Not all opcodes within this available range must be assigned. Depending on the design philosophy, unassigned opcodes may be equivalent to NOPs or cause undefined behavior. In some \acp{isa}, the number of bits per opcode is variable. For example, in the widely used x86 \ac{isa}, the opcode can be between 8 and 24 bits \cite{mahoney2021enumerating}. More frequently used operations are assigned a shorter opcode to increase code density. An architecture may also split the opcode into multiple parts, deferring analysis of the full opcode to different stages of instruction decoding. This allows designers to more efficiently use the available index space of any n-bit opcode, also increasing code density.

\paragraph*{Types of Instruction}

Instructions can be divided up into different types based on their effects. There are instructions that perform some calculation and store the result in a target memory location. These instructions will be referred to as ``arithmetic instructions''. There are also instructions that do not calculate anything but simply move data between memories. Most \ac{risc} architectures follow the ``Load-Store'' paradigm. This paradigm says that only a select few instructions interact with main memory, whereas the rest of the instructions, including all arithmetic ones, interact only with immediate data and registers. These instructions will be referred to as ``transfer instructions''. Another important class of instruction is the ``control flow instruction''. As the name suggests, this type of instruction usually does not compute anything either, but is responsible for the decision making process within the \ac{cpu}. Upon executing such an instruction, the program counter, instead of being incremented, is overwritten with a value from a memory. This is called branching. There are unconditional and conditional branches, which only overwrite the program counter if some predicate is met. This predicate is typically dictated by a flag stemming from the result of the last arithmetic instruction. Branching is required for implementing function calls and general conditional execution, i.e ``Do X if Y, otherwise do Z''. An architecture may have instructions that fit into multiple categories. For example, the \ac{arm} architecture allows any instruction to be executed conditionally\cite{armv7m_manual} by storing condition bits in its instruction encoding.

\paragraph*{Instruction Encoding}

In order for a processor to understand each instruction, it must be laid out in a predictable, well defined manner. This is called the instruction encoding format. This encoding must include all information required for performing a desired operation. The encoding must include the opcode, all operands and any additional settings required for executing an operation. Since different operations require a different number and type of operands, it can be useful to define a variable length encoding scheme to save memory and increase code density. On the other hand, variable length encodings require additional logic to determine the length from a given opcode and fetch the required number of bytes from memory. This introduces complexity in an implementation, as well as increasing the number of logic gates required. Typically, this also causes the fetch phase to take more than a single clock cycle. For these reasons, many \ac{risc} architectures use a fixed length encoding. Since different types of instructions require different combinations of options and operands, \acp{isa} may define multiple distinct encoding schemes. The instruction decoder can then choose the corresponding format for each opcode.

\begin{figure}[H]
    \centering
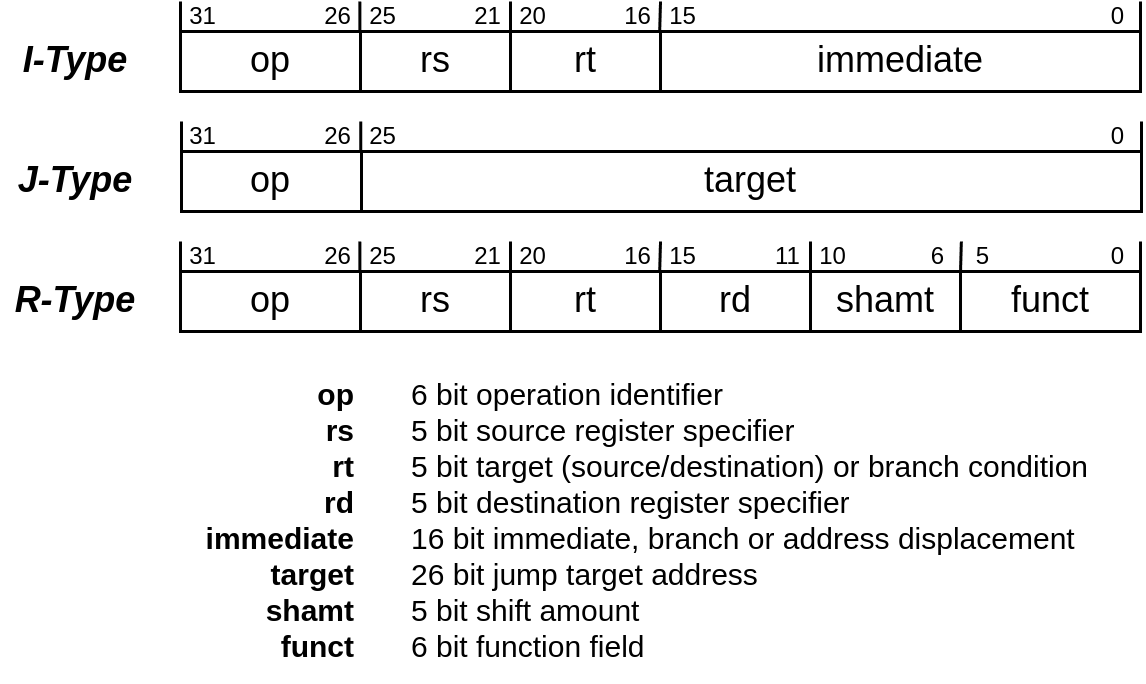
[picture p53: documentation/paper/images/drawio/mips_instruction_encoding.png]
      % Replace with your image file
    \caption[MIPS32 instruction encoding scheme]{MIPS 32 bit instruction encoding scheme and field descriptions. Numbers above fields represent bit positions within the instruction (modified from Charles Price, aggregated information of multiple tables in section A-15 and A-16 \cite{mips1995})}
    \label{fig:mips_instruction_encoding}
\end{figure}

\autoref{fig:mips_instruction_encoding} shows the instruction encoding scheme of the \ac{mips} architecture, including brief descriptions of the individual fields. Since \ac{mips} is intended to be used as an educational tool, the instruction encoding is rather simple when compared to other \acp{isa}. Each instruction is encoded as a fixed length datum of 32 bits, which corresponds to one machine word in \ac{mips} IV \cite{mips1995}. There are 3 types of encoding which cover every instruction in the architecture. I-type instructions use 16 bit immediate values, one source and one destination register. This encoding is used for arithmetic instructions that require access to an immediate value, hence the name. J-type instructions have only a single piece of data, which contains a 26 bit offset used for implementing far jumps and branches. R-type encoding is used for operations that require two operands from registers, as well as a destination register. The ``funct'' field identifies the arithmetic operation for the \ac{alu} to perform. For example, the value 32 in this field represents addition, while 34 represents subtraction \cite{mips1995}. The ``shamt'' field allows a programmer to shift the bits of the \ac{alu} result by a signed number. Since \ac{mips} defines 32 general purpose registers, all register identifiers in all encodings must have $log_2(32) = 5$ bits. Similarly, due to the length of 6 bits of the ``opcode'' field, the \ac{isa} is limited to a total of 64 different instructions (ignoring the ``funct'' field).

\begin{figure}[H]
    \centering
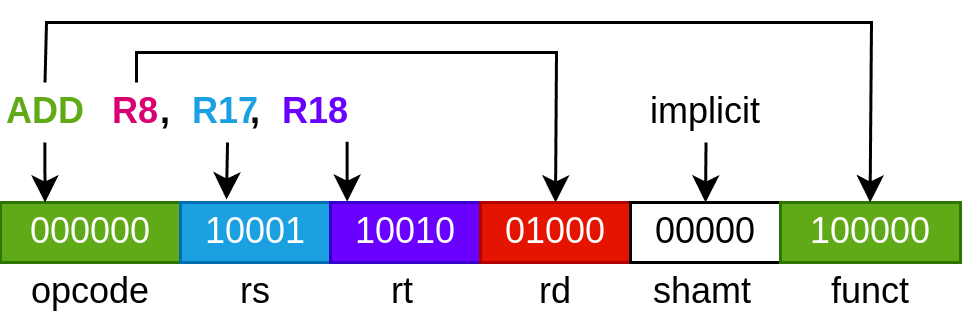
[picture p54: documentation/paper/images/drawio/mips_instruction_encoding_example.png]
      % Replace with your image file
    \caption[Exemplary instruction encoding in MIPS IV]{Exemplary instruction encoding of \texttt{ADD R8, R17, R18} in the MIPS IV architecture}
    \label{fig:mips_instruction_encoding_example}
\end{figure}

\autoref{fig:mips_instruction_encoding_example} shows an example of how this encoding works in practice. In the example, the instruction \texttt{ADD R8, R17, R18} is encoded. Since the operation requires two register operands as well as one output register, the R-type encoding is used. Each of the three operands is assigned as an integer value to its corresponding field. The opcode is 0 for all R-type instructions (This can be used by the decoder to recognize the type). The \ac{alu} operation of addition is assigned the value 32, therefore this is encoded into the ``funct'' field. The instruction contains no shifting of the result, therefore the ``shamt'' field is set to 0.

\paragraph*{Microcode}

With increasing complexity of individual instructions, more and more complex hardware is required to execute them. To retain a manageable level of complexity, complex operations can be split further into suboperations. These suboperations or microoperations form the instruction set that is directly executable on any given implementation or microarchitecture. The set of all supported microoperations is called microcode of an implementation. Any given instruction on the \ac{isa} level can then be implemented by one or more of these microoperations. Since programmers write their software for an \ac{isa} and not for a microarchitecture, this must be implemented in a way that is transparent to the programmer.

Depending on the level of abstraction that this microcode provides, it is classified as either ``horizontal'' or ``vertical''. Horizontal microcode provides less of an abstraction over the hardware than its vertical counterpart. In microarchitectures using horizontal microcode, each microoperation is a direct binary representation of control signals. When the microoperation is executed, the control signals are applied to the relevant multiplexers and switches within the \ac{cpu}. In vertical microcode, each microoperation has a distinct opcode, similar to the \ac{isa}-level opcodes. The opcode serves as an identifier instead of a set of control signals. An additional hardware unit the decodes and interprets each microoperation. This approach resembles its own \ac{risc} computer that then implements another, possibly even \ac{cisc} \ac{isa}. As an example for vertical microcode, this set of microinstructions may be used to implement addition:

\newpage
\begin{enumerate}
    \item Enable register A output
    \item Enable ALU input A
    \item Enable register B output
    \item Enable ALU input B
    \item Compute A + B
    \item Enable register C input
\end{enumerate}

In horizontal microcode, each \ac{isa} operation may correspond to one or more microcode control words. During each clock cycle, one control word is executed. Therefore, executing an instruction with $n$ control words takes $n$ clock cycles. If a microarchitecture consists only of instructions where $n = 1$, it is called a single cycle processor. Otherwise, it is considered a multicycle processor. All control words must be the same size, therefore every instruction must provide a value for every control signal. Many instructions use only a small portion of the available hardware units, therefore a lot of the control word table is used for instructing hardware to remain inert.

\begin{figure}[H]
    \centering
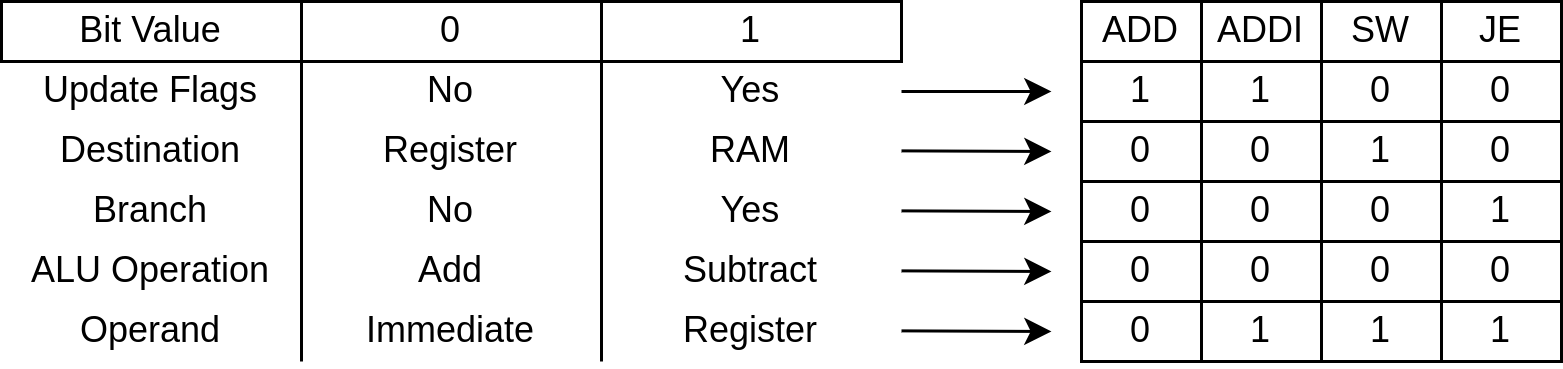
[picture p55: documentation/paper/images/drawio/microcode_horizontal.png]
      % Replace with your image file
    \caption[Control signals in horizontal microcde]{Exemplary equivalent of individual instructions in horizontal microcode}
    \label{fig:horizontal_microcode}
\end{figure}

\autoref{fig:horizontal_microcode} shows the control signals that each \ac{isa} operation maps to in an exemplary \ac{isa}. Each control signal may be used to setup internal multiplexers or other switching circuitry. In \autoref{fig:horizontal_microcode}, only the JE instruction has the ``Branch'' bit set. In practice, this can be used to control a multiplexer that selects whether to increment the program counter or load a jump target. This can be seen in \autoref{fig:pc_multiplexer}.

\begin{figure}[H]
    \centering
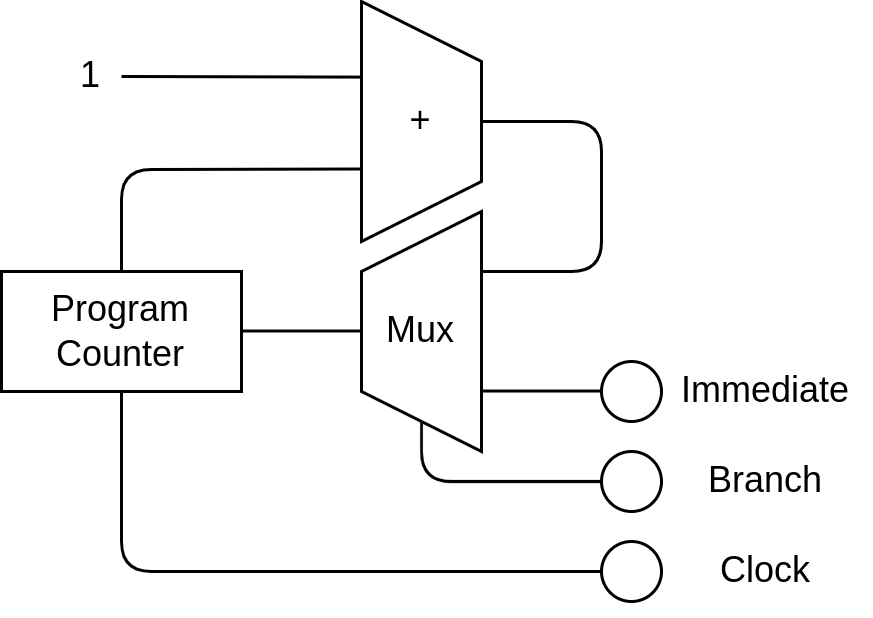
[picture p56: documentation/paper/images/drawio/pc_multiplexer.png]
    
    \caption[Multiplexer implementing conditional branching]{Multiplexer used to select between incrementing PC and loading a branch address}
    \label{fig:pc_multiplexer}
\end{figure}
