kantholz44mm/cpu/documentation/paper/images/1bit_register_schematic.png

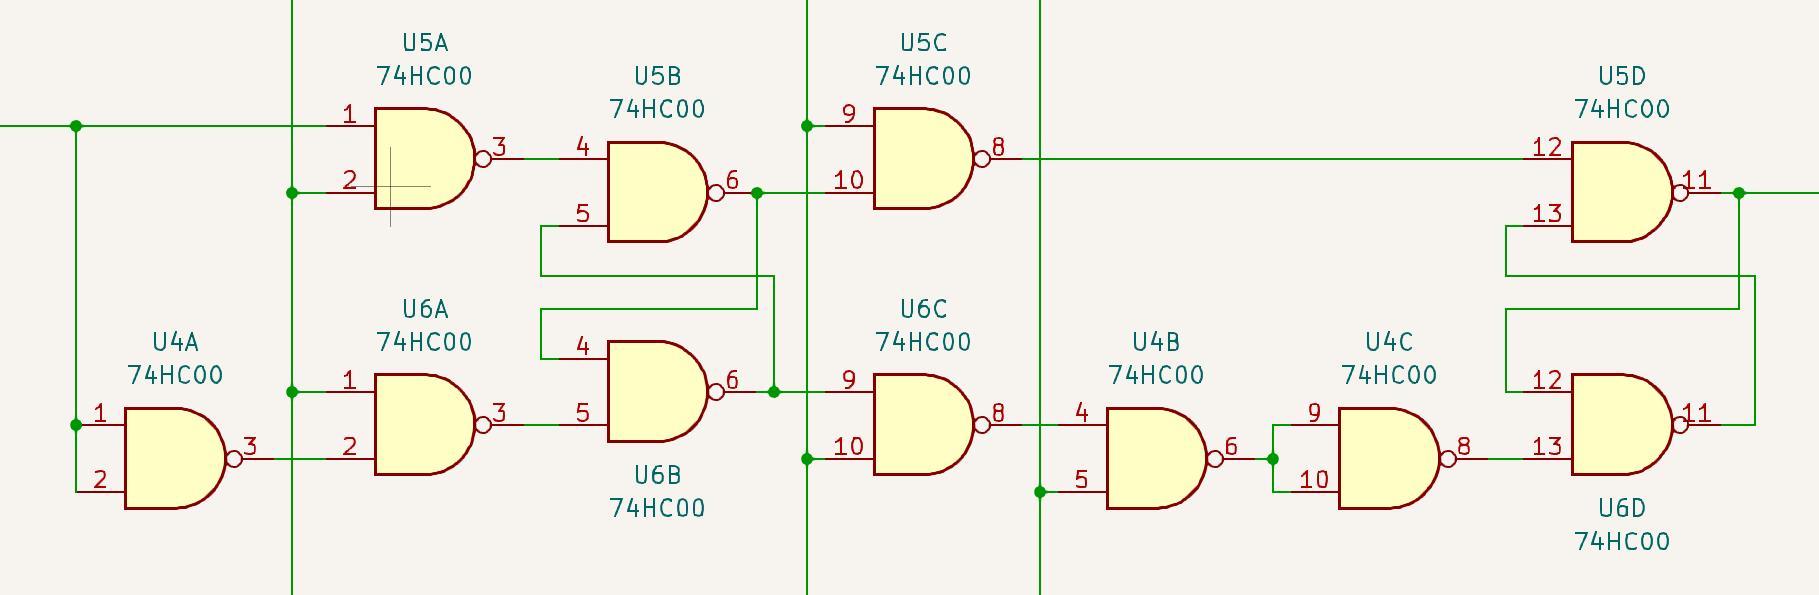
documentation/paper/images/1bit_register_schematic.png
