kantholz44mm/cpu/documentation/paper/images/pcb/IMG_20250529_153454.jpg

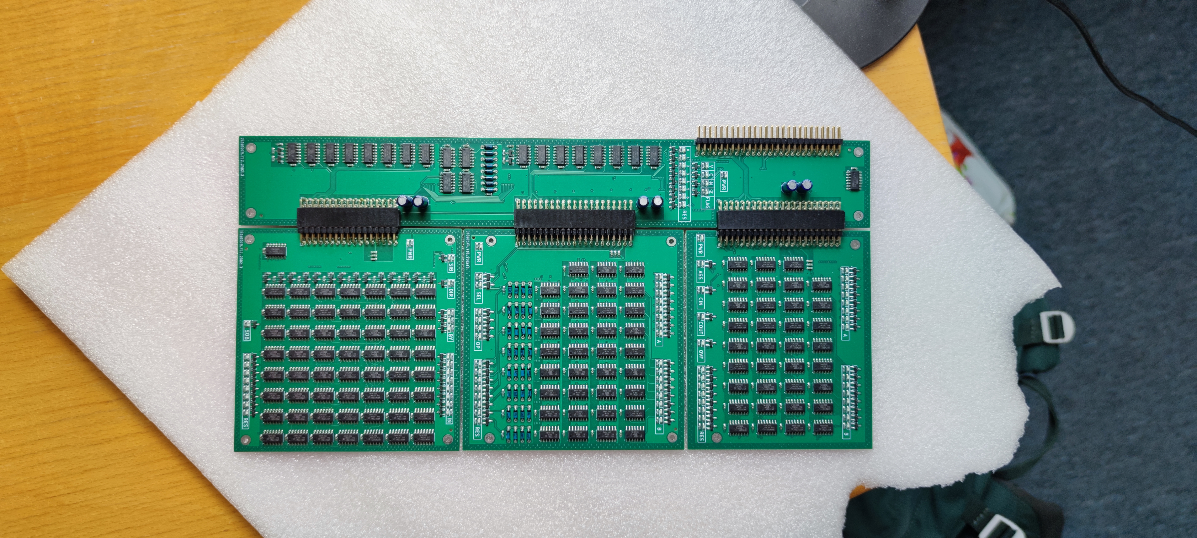
documentation/paper/images/pcb/IMG_20250529_153454.jpg
