kantholz44mm/cpu/documentation/paper/images/pcb/IMG_20250529_153522.jpg

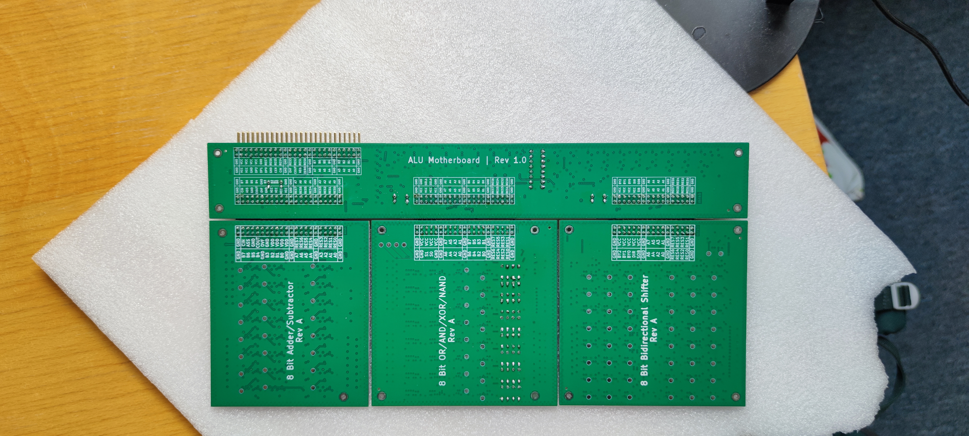
documentation/paper/images/pcb/IMG_20250529_153522.jpg
