kantholz44mm/cpu/documentation/paper/images/pcb/IMG_20250529_154052.jpg

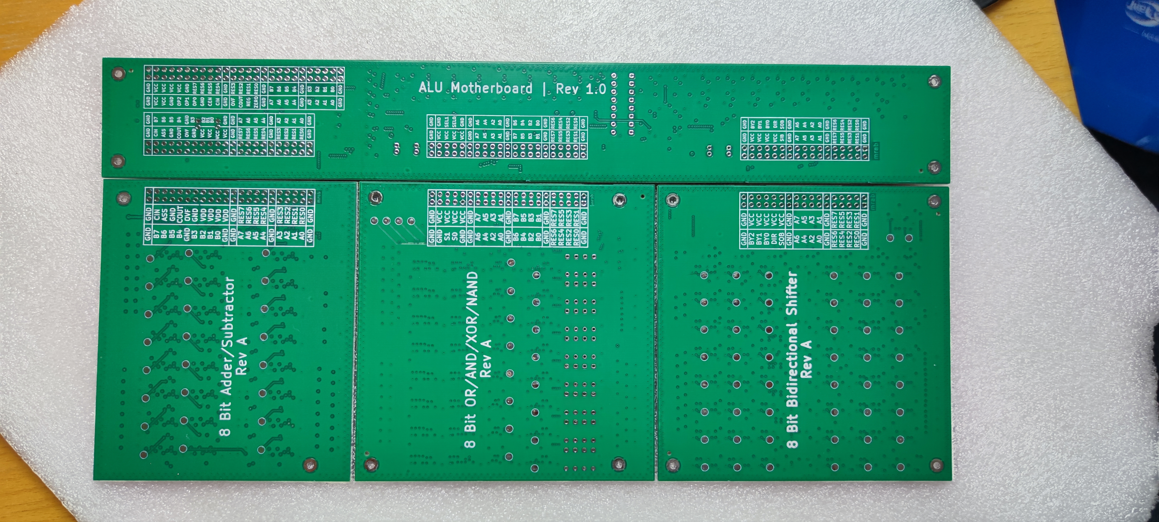
documentation/paper/images/pcb/IMG_20250529_154052.jpg
