kantholz44mm/cpu/documentation/paper/images/register_connector_schematic.png

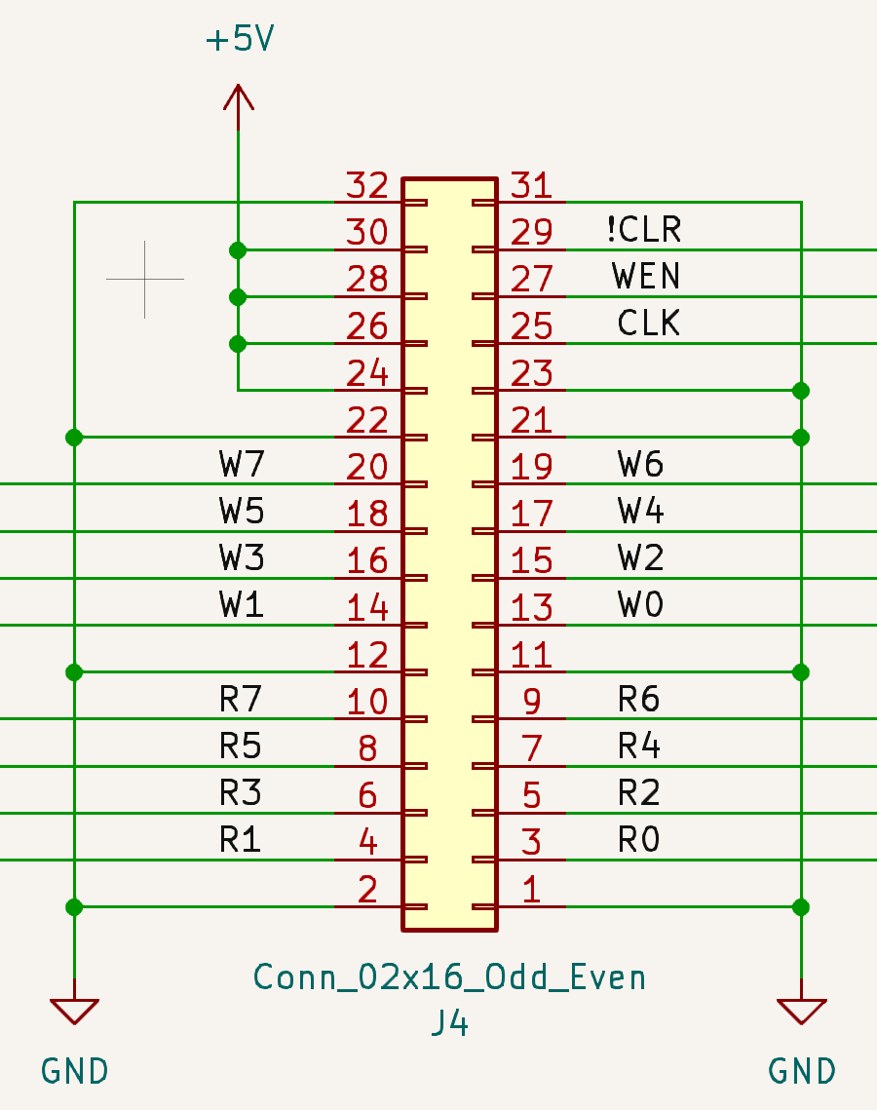
documentation/paper/images/register_connector_schematic.png
