kantholz44mm/cpu/hardware/documentation/connector_add_sub.png

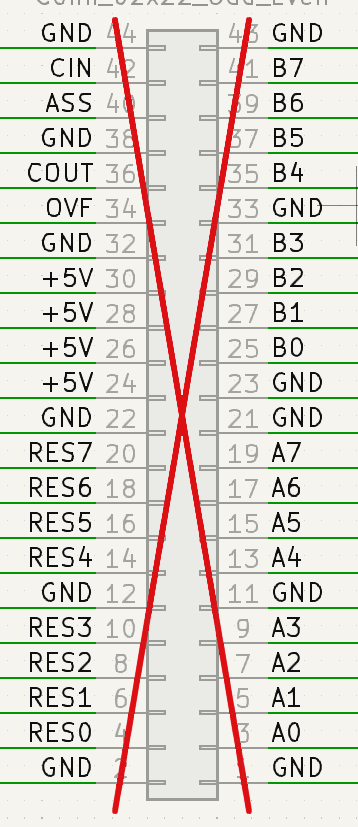
hardware/documentation/connector_add_sub.png
