kantholz44mm/cpu/hardware/documentation/connector_bitops.png

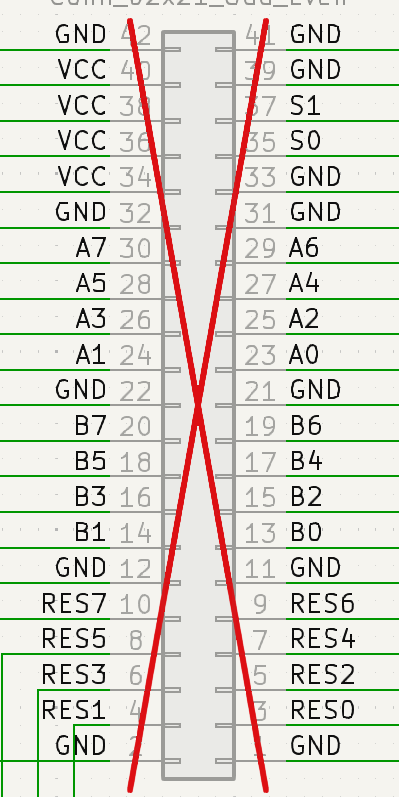
hardware/documentation/connector_bitops.png
