kantholz44mm/cpu/hardware/documentation/connector_shift.png

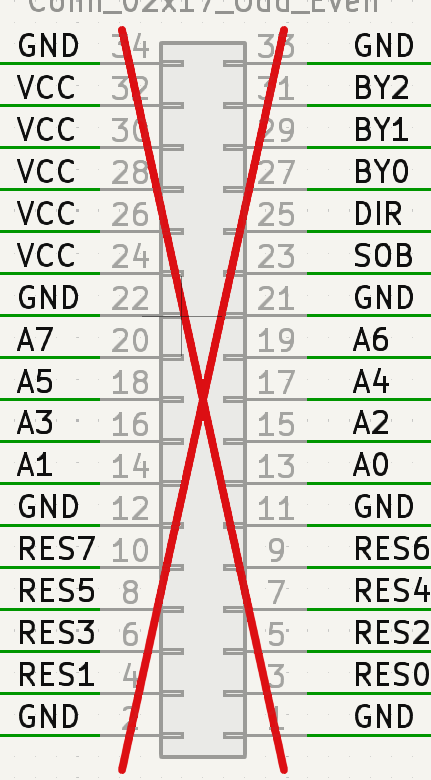
hardware/documentation/connector_shift.png
