kantholz44mm/cpu/hardware/documentation/datapath.png

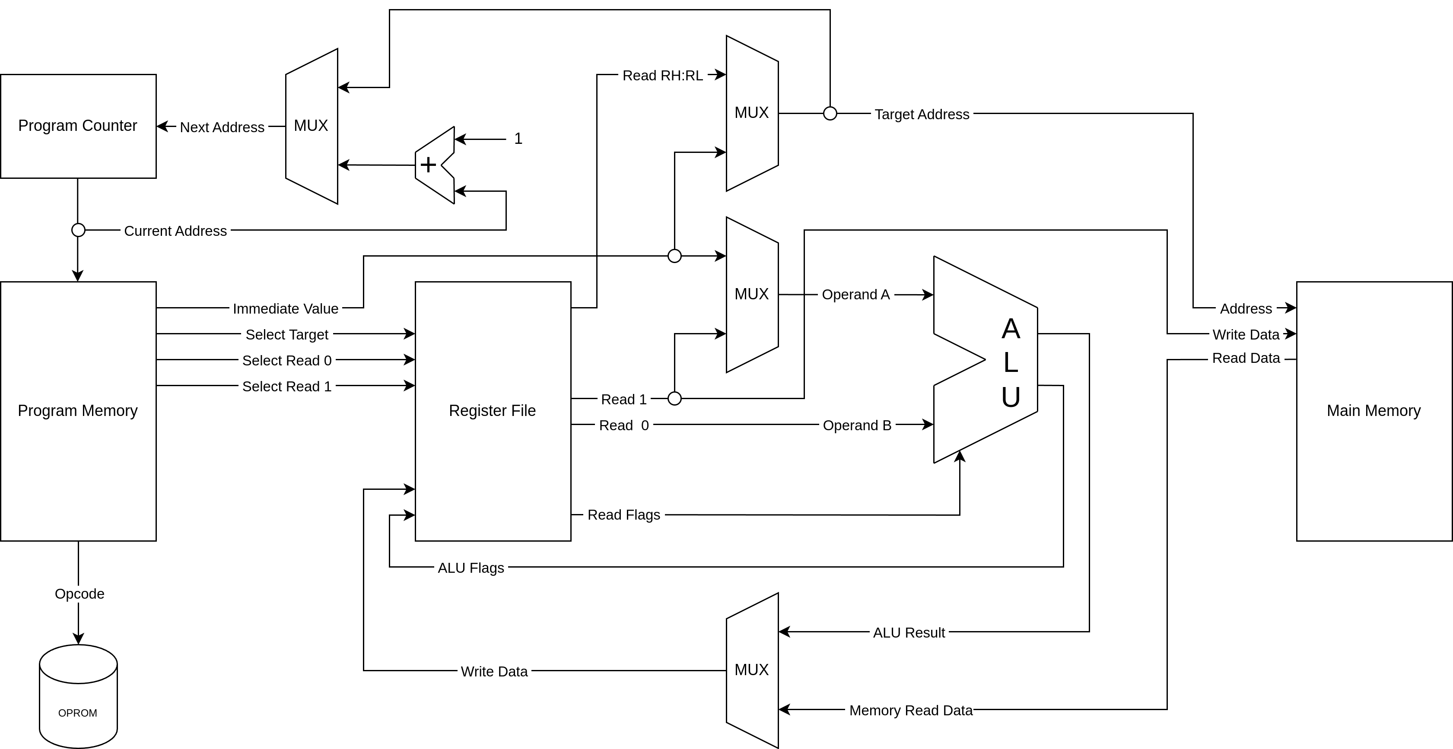
hardware/documentation/datapath.png
