kantholz44mm/cpu/hardware/documentation/layout.png

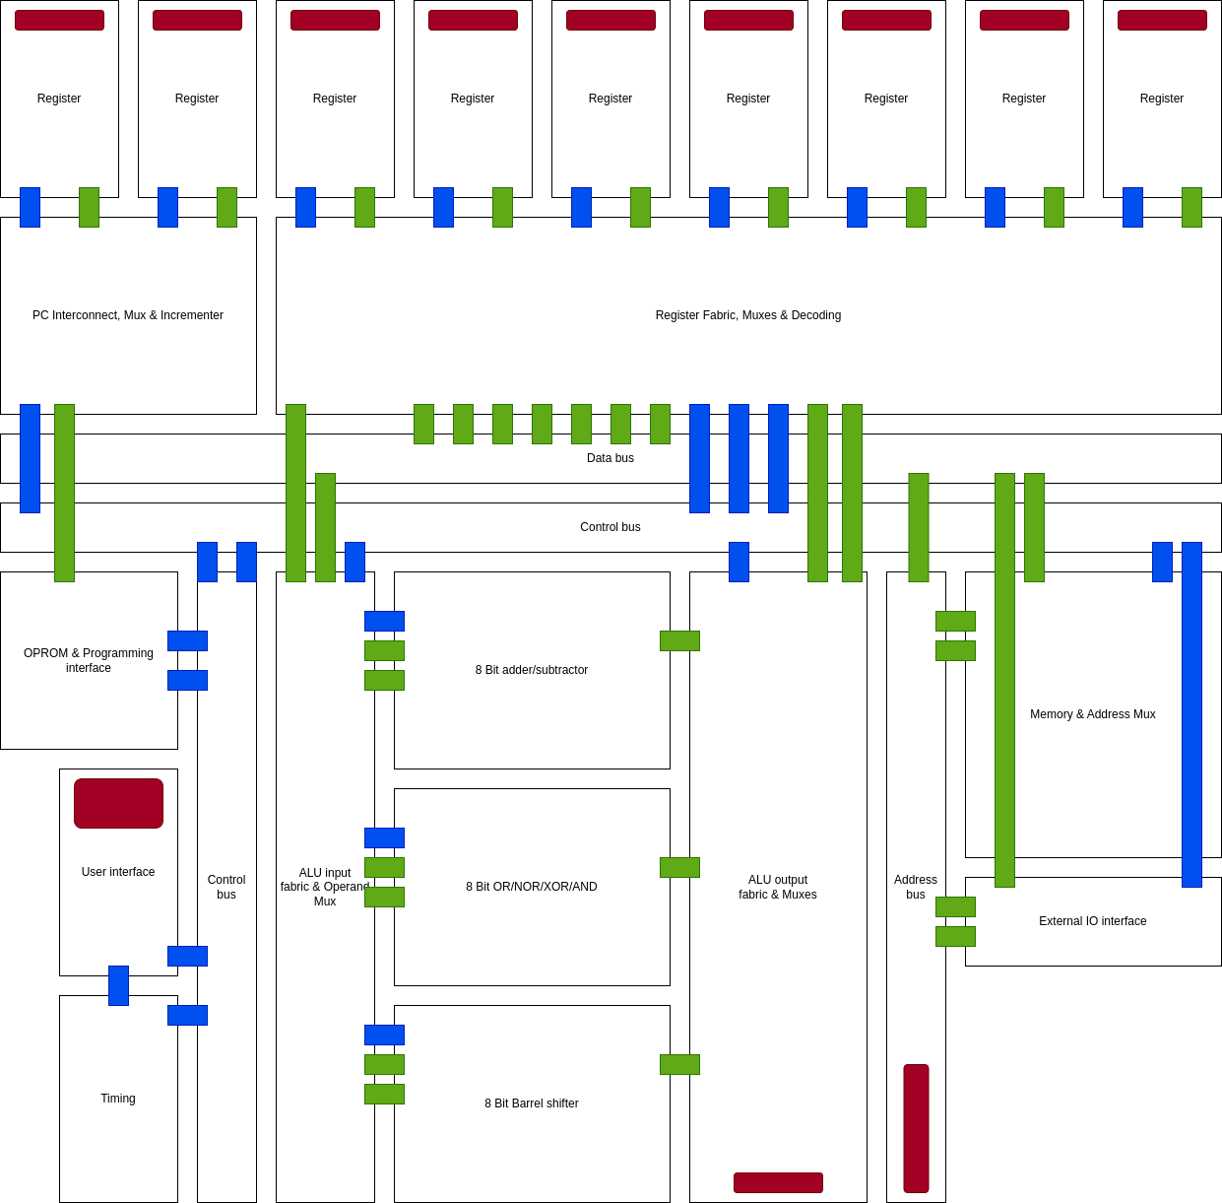
hardware/documentation/layout.png
