kantholz44mm/cpu/hardware/register/production/bom.csv

Designator | Footprint | Quantity | Value | LCSC Part #
C1, C10, C11, C12, C13, C14, C15, C16, C17, C18, C19, C2, C20, C21, C22, C23, C24, C25, C3, C4, C5, C6, C7, C8, C9 | 0603 | 25 | 330nF | C2918485
C26, C27 | 0603 | 2 | 10uF | C2909630
D1, D10, D11, D12, D2, D3, D4, D5, D6, D7, D8, D9 | 0603 | 12 | LED | C84267
Q1, Q10, Q11, Q12, Q13, Q14, Q2, Q3, Q4, Q5, Q6, Q7, Q8, Q9 | SOT-23_Handsoldering | 14 | IRLML6244 | C5123965
R1, R10, R11, R12, R13, R14, R15, R2, R3, R4, R5, R6, R7, R8, R9 | 0603 | 15 | 1000 | C21190
U1, U10, U11, U12, U13, U14, U15, U16, U17, U18, U19, U2, U20, U21, U22, U23, U24, U25, U3, U4, U5, U6, U7, U8, U9 | SOIC-14_3.9x8.7mm_P1.27mm | 25 | 74HC00 | C5586
