kantholz44mm/cpu/hardware/alu_shift/production/bom.csv

Designator | Footprint | Quantity | Value | LCSC Part #
C1, C10, C11, C14, C15, C16, C17, C18, C19, C20, C21, C24, C25, C26, C27, C28, C29, C30, C31, C34, C35, C36, C37, C38, C39, C4, C40, C41, C44, C45, C46, C47, C48, C49, C5, C50, C51, C54, C55, C56, C57, C58, C59, C6, C60, C61, C64, C65, C66, C67, C68, C69, C7, C70, C71, C8, C9 | 0603 | 57 | 330nF | C2918485
C12, C2, C3 | 0603 | 3 | 10uF | C2909630
D1, D10, D11, D12, D13, D14, D15, D16, D17, D18, D19, D2, D20, D21, D22, D23, D3, D4, D5, D6, D7, D8, D9 | 0603 | 23 | LED | C84267
Q1, Q10, Q11, Q12, Q13, Q14, Q15, Q16, Q17, Q18, Q19, Q2, Q20, Q21, Q22, Q23, Q24, Q25, Q26, Q27, Q28, Q29, Q3, Q30, Q31, Q32, Q33, Q34, Q35, Q36, Q4, Q5, Q6, Q7, Q8, Q9 | SOT-23-3 | 36 | IRLML6244 | C5123965
R1, R10, R11, R12, R13, R14, R15, R16, R17, R18, R19, R2, R20, R21, R22, R23, R24, R25, R26, R27, R28, R29, R3, R30, R31, R32, R33, R34, R35, R36, R37, R38, R39, R4, R40, R41, R42, R43, R44, R5, R6, R7, R8, R9 | 0603 | 44 | 1000 | C21190
U1, U10, U11, U12, U13, U14, U15, U16, U17, U18, U19, U2, U20, U21, U22, U23, U24, U25, U26, U27, U28, U29, U3, U30, U31, U32, U33, U34, U35, U36, U37, U38, U39, U4, U40, U41, U42, U43, U44, U45, U46, U47, U48, U49, U5, U50, U51, U52, U53, U54, U55, U56, U57, U6, U7, U8, U9 | SOIC-14_3.9x8.7mm_P1.27mm | 57 | 74HC00 | C5586
