kantholz44mm/cpu/documentation/paper/images/alu_adder_subtractor_back_assembled.jpg

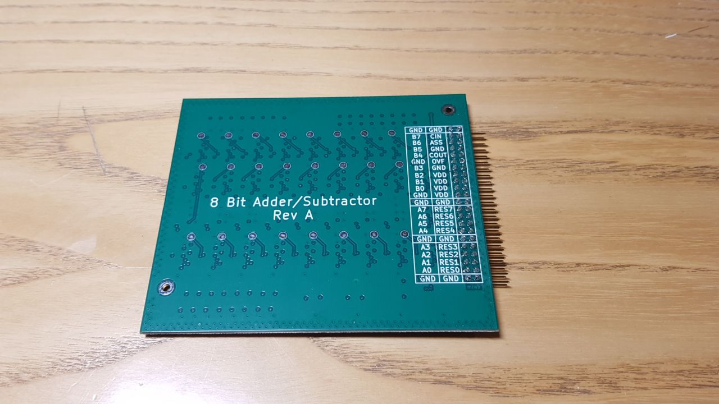
documentation/paper/images/alu_adder_subtractor_back_assembled.jpg
