kantholz44mm/cpu/documentation/paper/images/alu_adder_subtractor_front_assembled.jpg

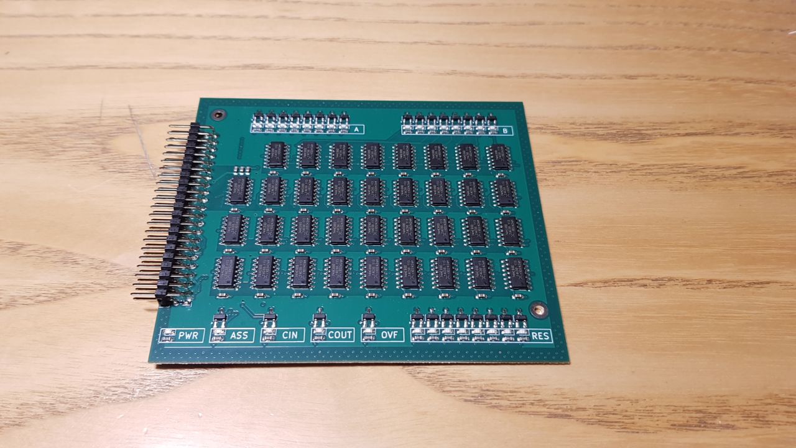
documentation/paper/images/alu_adder_subtractor_front_assembled.jpg
