kantholz44mm/cpu/documentation/paper/images/register_back_assembled.jpg

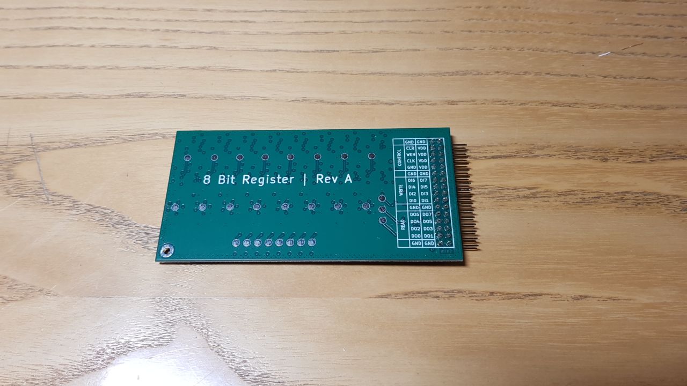
documentation/paper/images/register_back_assembled.jpg
