kantholz44mm/cpu/documentation/paper/images/register_front_assembled.jpg

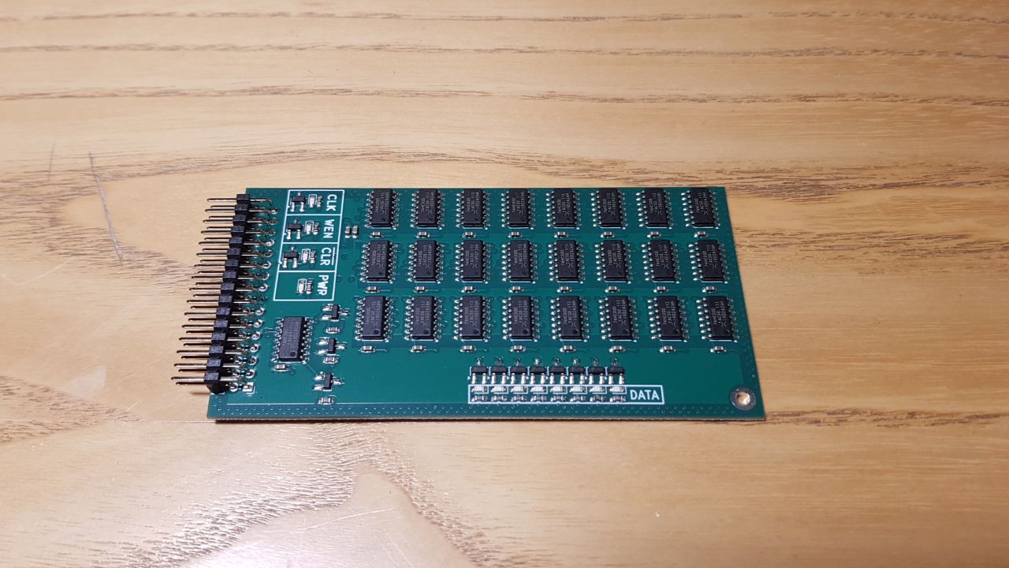
documentation/paper/images/register_front_assembled.jpg
