kantholz44mm/cpu/documentation/paper/images/alu_adder_subtractor_in_test_jig.jpg

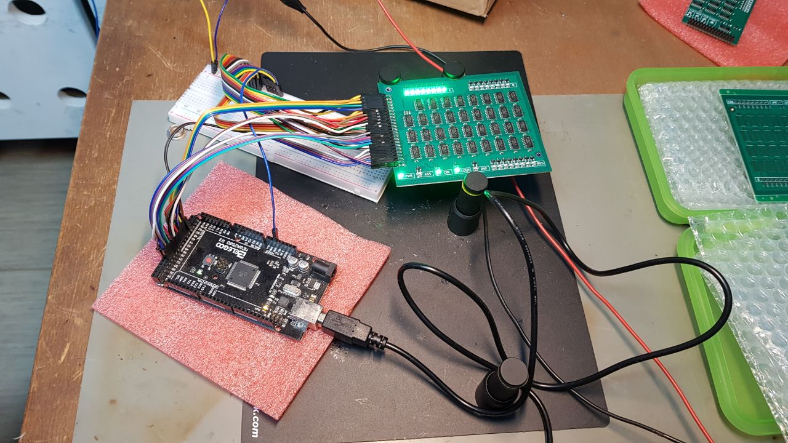
documentation/paper/images/alu_adder_subtractor_in_test_jig.jpg
