kantholz44mm/cpu/documentation/paper/images/appendix/schematic_alu.pdf

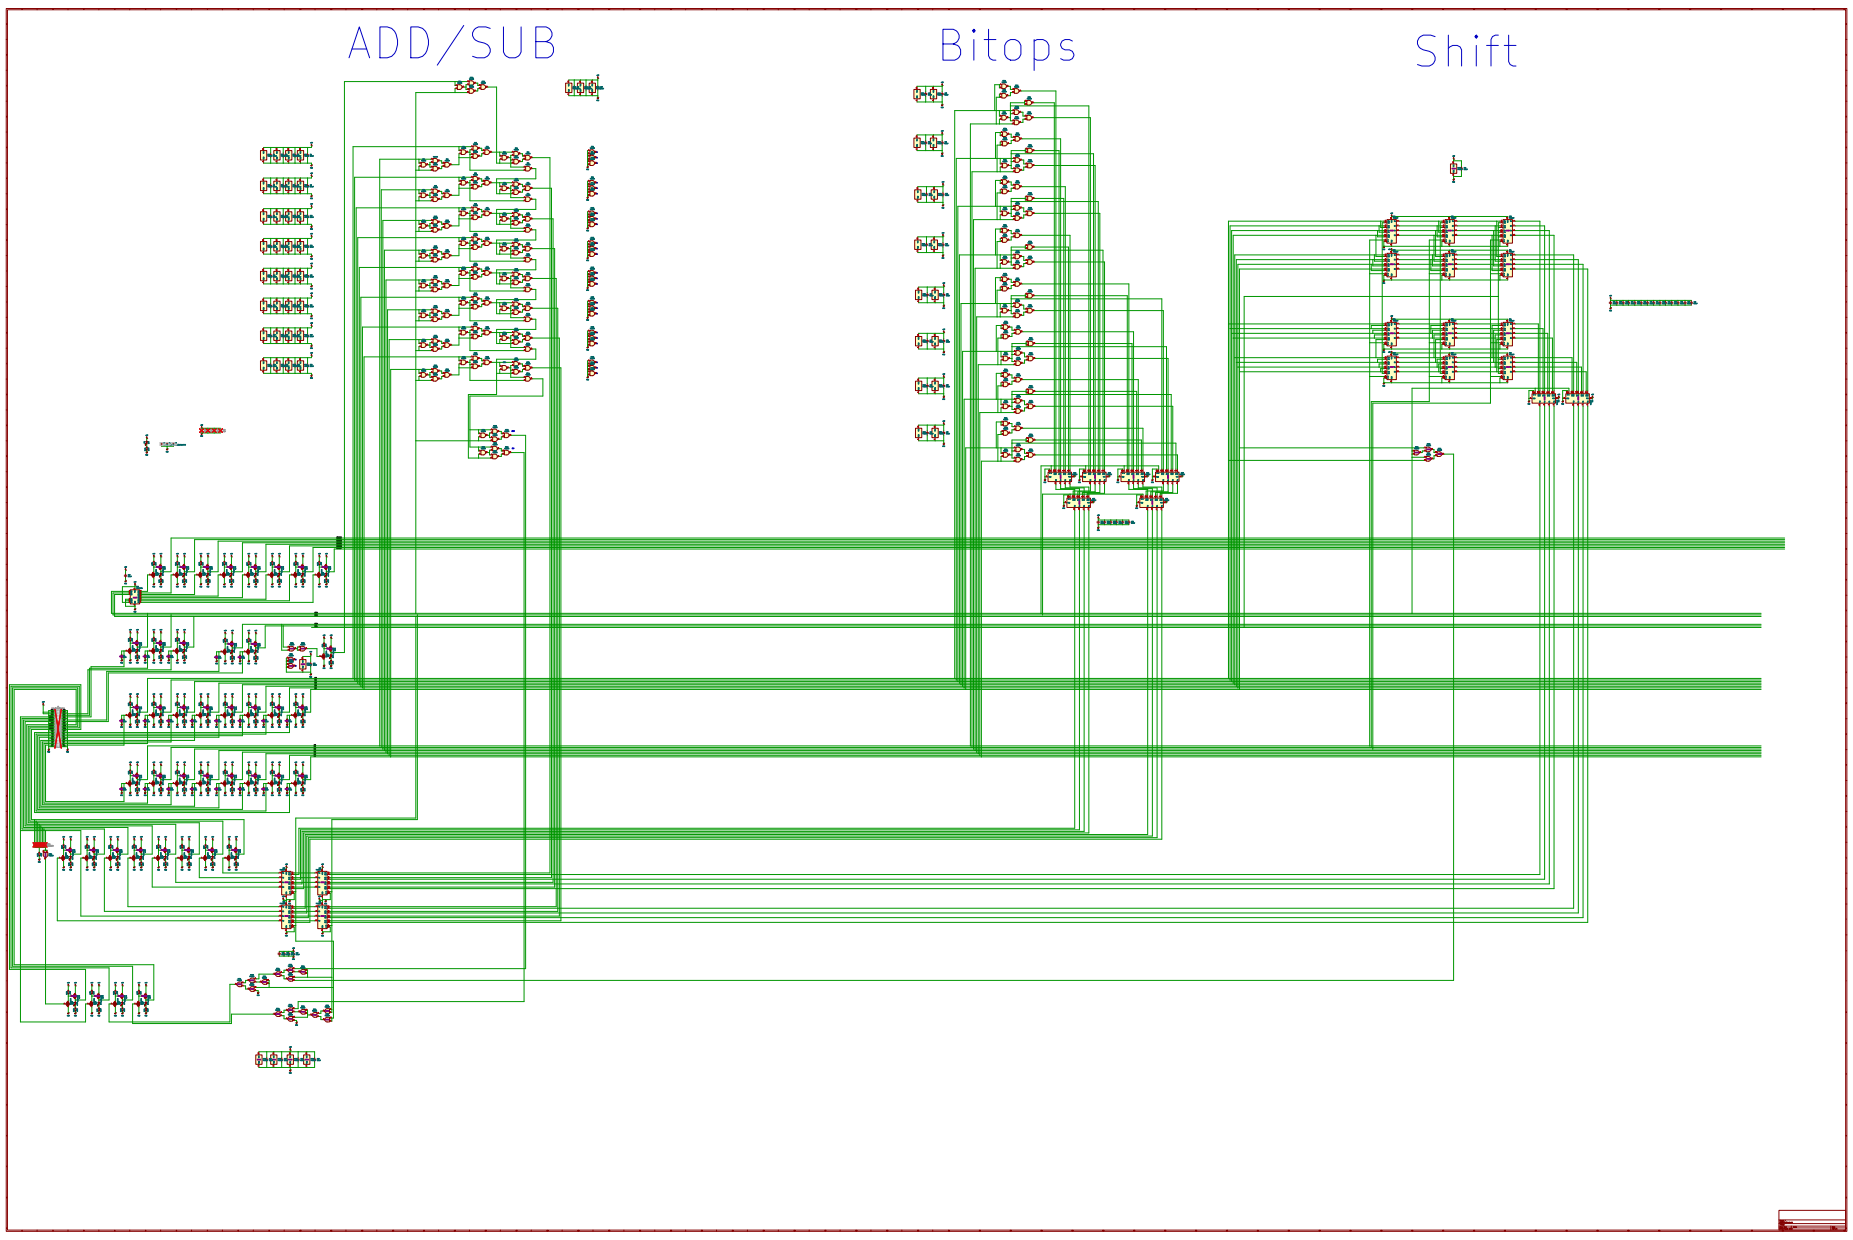
[picture p94: page 1]
