kantholz44mm/cpu/documentation/paper/images/appendix/schematic_io.pdf

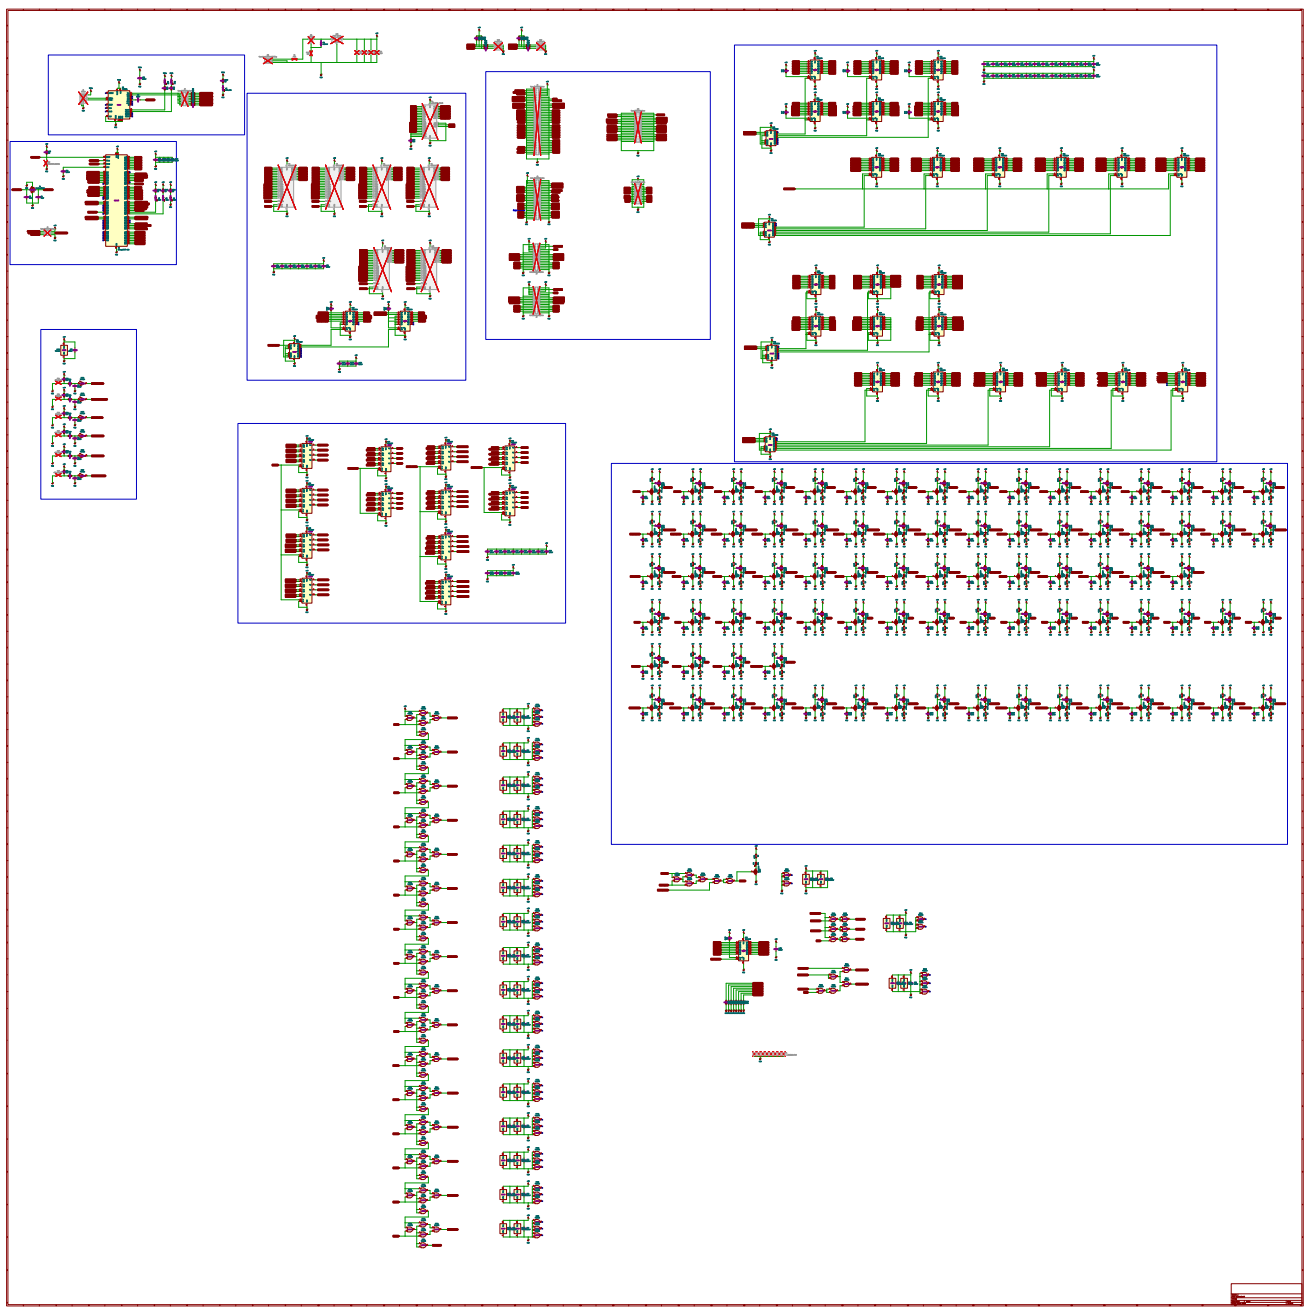
[picture p95: page 1]
