kantholz44mm/cpu/documentation/paper/images/appendix/schematic_register.pdf

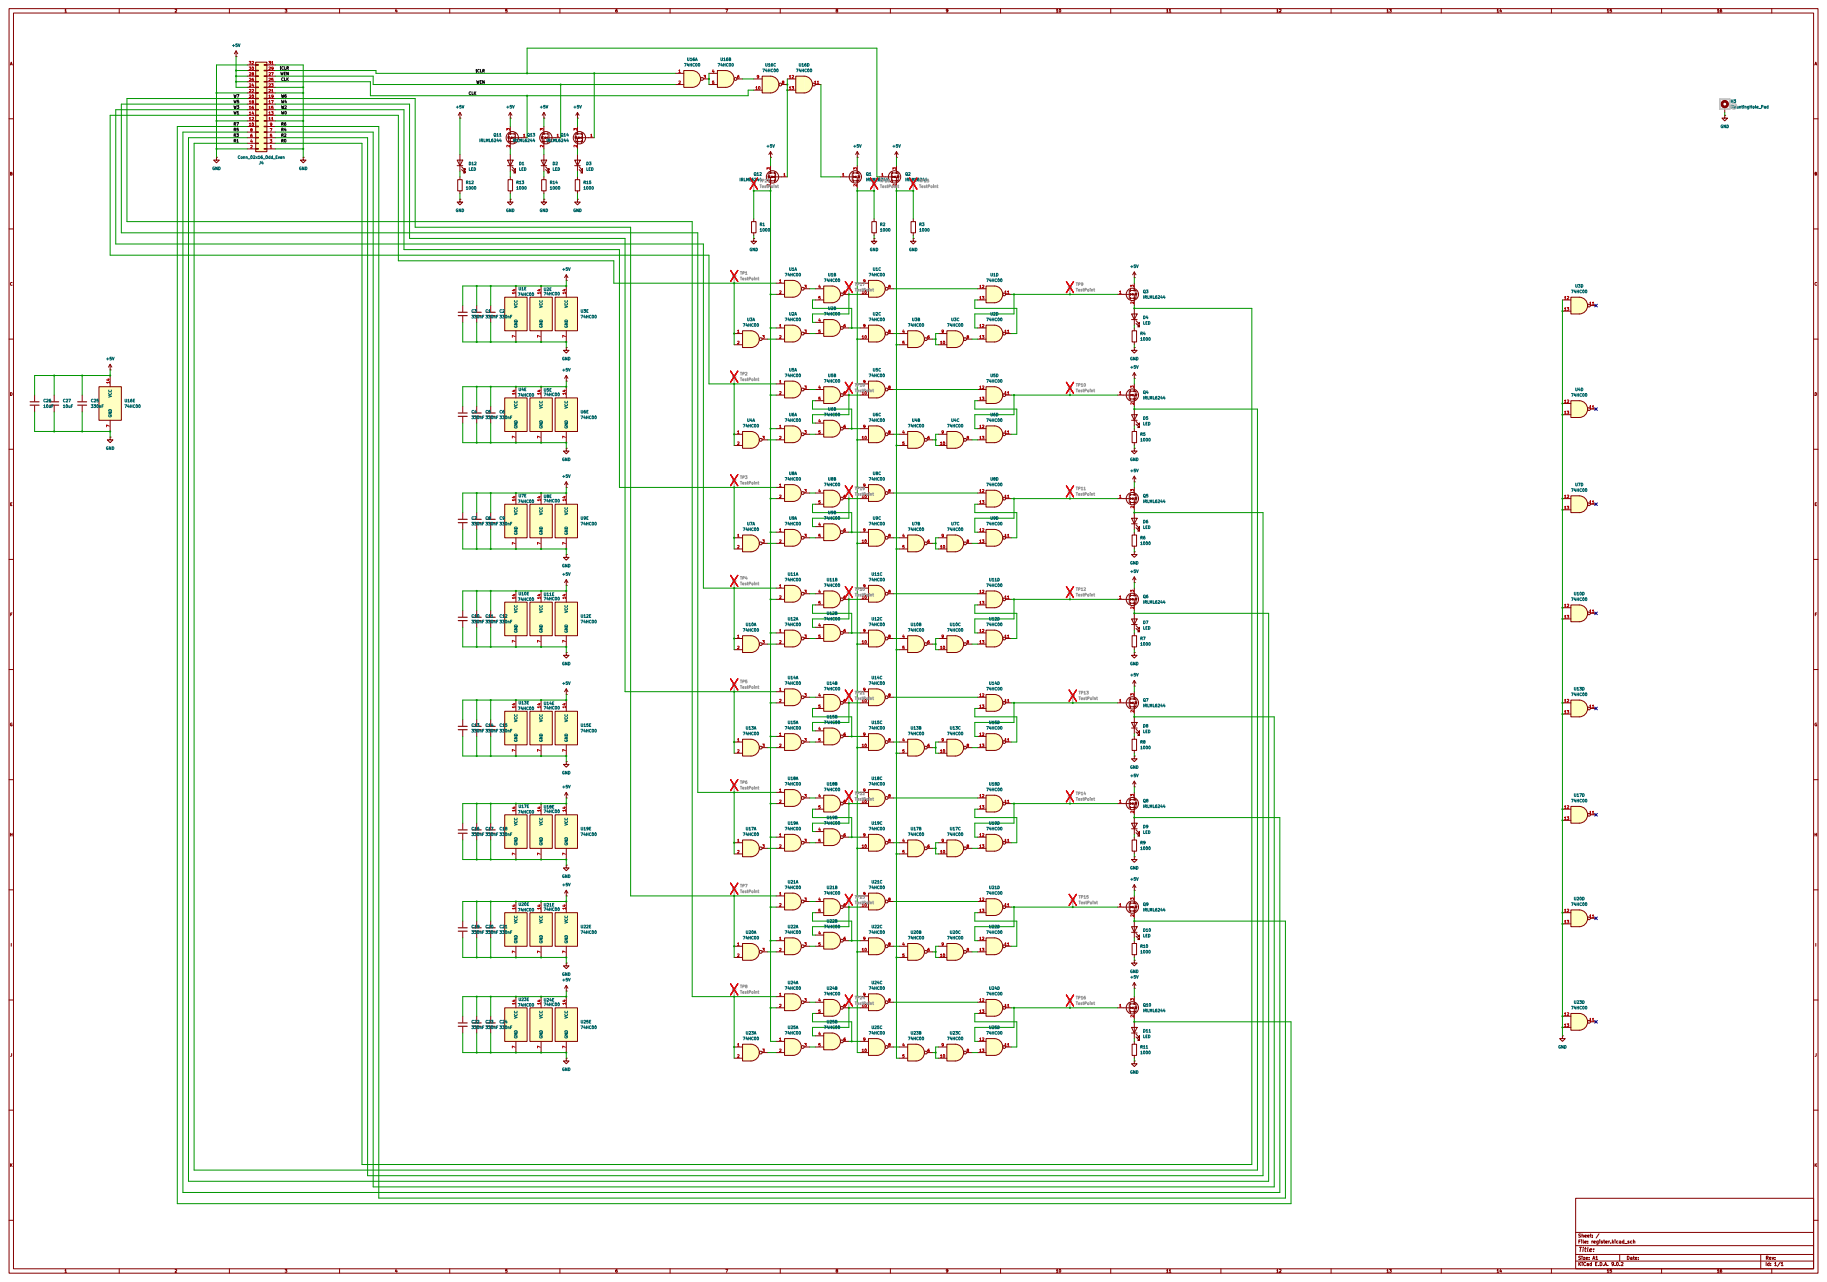
[picture p96: page 1]
