kantholz44mm/cpu/documentation/paper/images/appendix/schematic_register_fabric.pdf

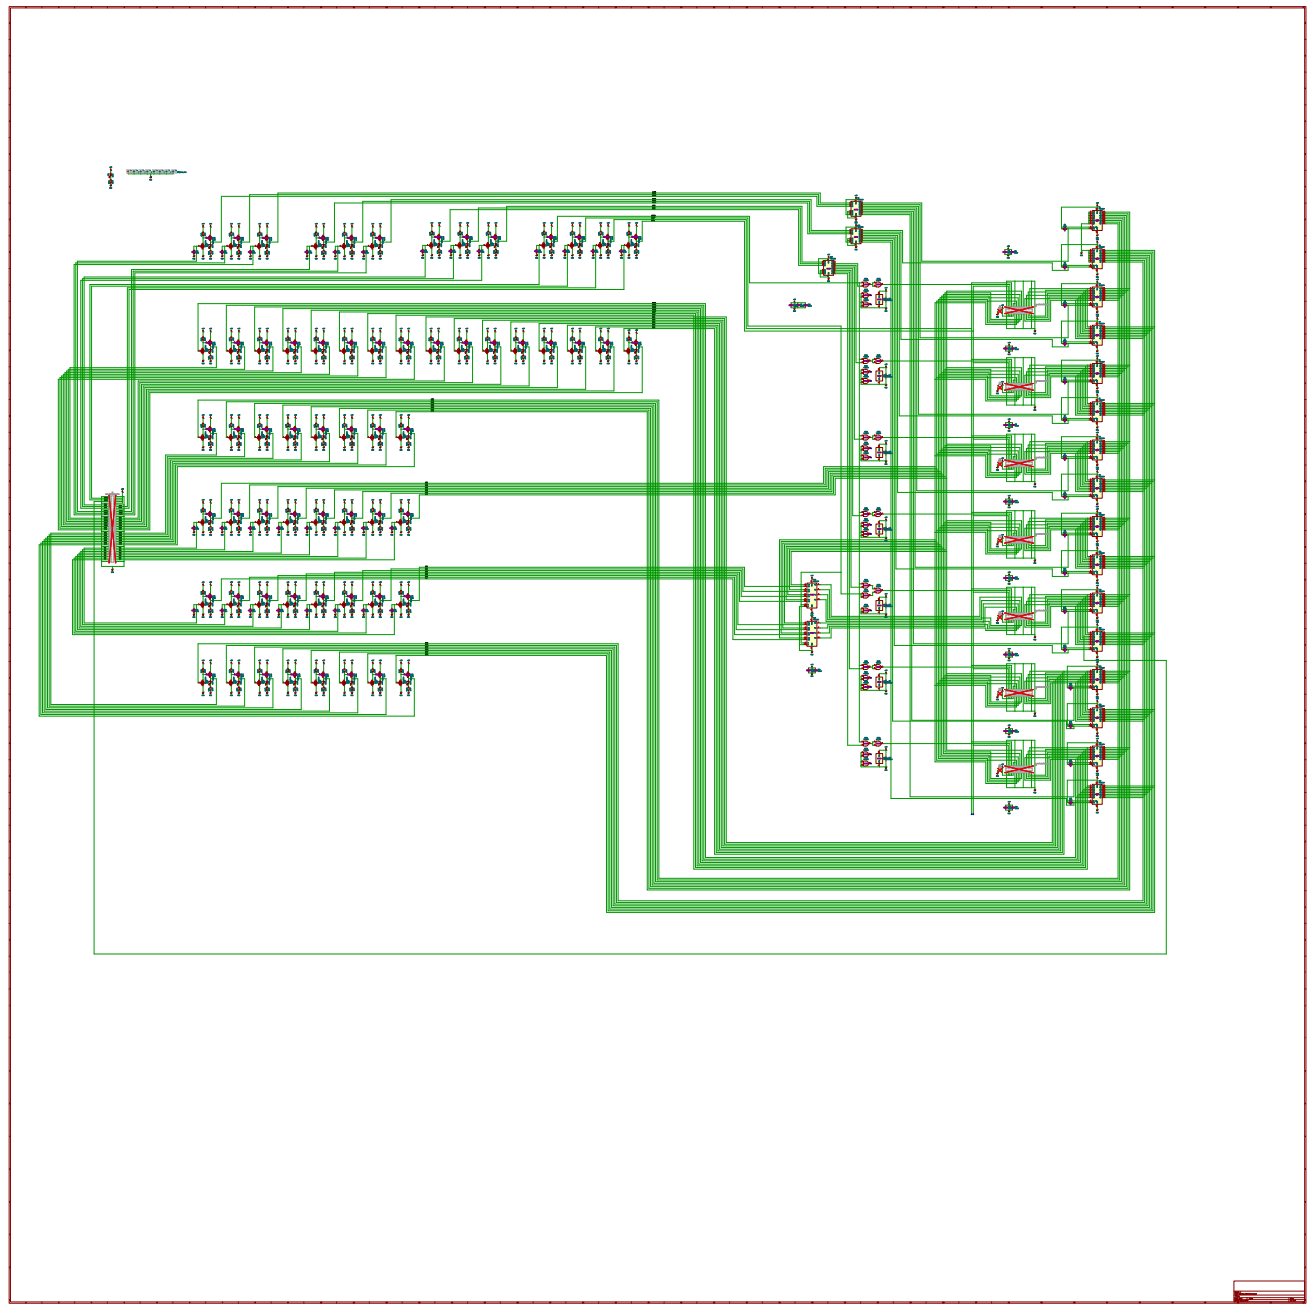
[picture p97: page 1]
