kantholz44mm/cpu/(list of files, drawings)

Other design files:
hardware/alu_add_sub/freerouting.dsn
hardware/alu_add_sub/temp-freerouting.dsn
