kantholz44mm/cpu/hardware/alu/alu.kicad_pcb

## KiCad design hardware/alu/alu.kicad_pcb (2025-04-27)

Schematic: alu.kicad_sch

Parts:
C1, C2, C3, C4, C5, C6, C7, C8, C9, C10, C11, C12, C13, C14, C15, C16, C17, C18, C19, C20, C21, C22, C23, C24, C25, C26, C27, C28, C29, C30, C31, C32, C33, C34, C35, C40, C41, C42, C43, C44, C45, C46, C47, C50, C51, C52, C53, C54, C55, C56, C57, C58, C59, C60, C61, C62, C63, C64, C65, C66, C67, C68, C69, C70, C71, C72, C73, C77, C78, C79, C80, C81, C82, C83, C84, C85, C90, C91, C92, C93, C94, C95: 330nF; C_0402_1005Metric; LCSC C77020
C86, C87, C88, C89: 22pF; C_Radial_D5.0mm_H11.0mm_P2.00mm; not fitted
D30, D31, D32, D33, D34, D35, D36, D37, D38, D39, D40, D41, D42, D43, D44, D45, D46, D47, D48, D49, D50, D51, D52, D63, D89, D90, D91, D92, D93, D137, D138, D139, D140, D141, D142, D143, D144, D145, D146, D147, D148, D149, D150: LED; LED_0402_1005Metric; LCSC C965793
D124, D125, D126, D127, D128, D129, D130, D131: D_Schottky; DO35_Packed; not fitted
H1, H2, H3: MountingHole_Pad; MountingHole_3.2mm_M3_ISO7380_Pad_TopBottom
J8: Conn_02x24_Odd_Even; PinHeader_2x24_P2.54mm_Horizontal; not fitted
Q93, Q96, Q98, Q100, Q102, Q104, Q106, Q108, Q110, Q112, Q114, Q116, Q118, Q120, Q122, Q124, Q126, Q128, Q130, Q132, Q134, Q136, Q138, Q140, Q142, Q144, Q146, Q148, Q150, Q152, Q154, Q156, Q158, Q160, Q162, Q164, Q166, Q168, Q170, Q172, Q174, Q176: IRLML6402; SOT-23; LCSC C2886430
Q94, Q95, Q97, Q99, Q101, Q103, Q105, Q107, Q109, Q111, Q113, Q115, Q117, Q119, Q121, Q123, Q125, Q127, Q129, Q131, Q133, Q135, Q137, Q139, Q141, Q143, Q145, Q147, Q149, Q151, Q153, Q155, Q157, Q159, Q161, Q163, Q165, Q167, Q169, Q171, Q173, Q175: IRLML6244; SOT-23; LCSC C5123965
R1, R2, R3, R4, R5, R6, R7, R8, R9, R10, R11, R12, R13, R14, R15, R16, R17, R18, R19, R20, R21: 100K; R_0402_1005Metric; LCSC C60491
R107, R108, R109, R110, R111, R112, R113, R114, R115, R116, R117, R118, R119, R120, R121, R122, R123, R124, R125, R126, R127, R128, R129, R130, R131, R132, R133, R134, R135, R136, R137, R138, R139, R140, R141, R142, R143, R144, R145, R146, R147, R148, R149, R150, R151, R152, R153, R154, R155, R156, R157, R158, R159, R160, R161, R162, R163, R164, R165, R166, R167, R168, R169, R170, R171, R172, R173, R174, R175, R176, R177, R178, R179, R180, R181, R182, R183, R184, R185, R186, R187, R188, R189, R190, R191, R192: 1000; R_0402_1005Metric; LCSC C106235
U1, U2, U3, U4, U5, U6, U7, U8, U9, U10, U11, U12, U13, U14, U15, U16, U17, U18, U19, U20, U21, U22, U23, U24, U25, U26, U27, U28, U29, U30, U31, U32, U33, U34, U35, U36, U37, U38, U39, U40, U41, U44, U45, U46, U47, U48, U49, U56, U57, U64, U65, U72, U73, U74, U75, U83, U87: 74HC00; SOIC-14_3.9x8.7mm_P1.27mm; LCSC C5586
U42, U43, U50, U51, U52, U53, U54, U55, U58, U59, U60, U61, U62, U63, U66, U67, U71, U84, U85, U86, U88, U89, U90, U91: 74LS157; SOIC-16_3.9x9.9mm_P1.27mm; LCSC C6823
U68: 74HCT238; SOIC-16_3.9x9.9mm_P1.27mm; LCSC C5620

Connections:
+5V: C1.1, C2.1, C3.1, C4.1, C5.1, C6.1, C7.1, C8.1, C9.1, C10.1, C11.1, C12.1, C13.1, C14.1, C15.1, C16.1, C17.1, C18.1, C19.1, C20.1, C21.1, C22.1, C23.1, C24.1, C25.1, C26.1, C27.1, C28.1, C29.1, C30.1, C31.1, C32.1, C33.1, C34.1, C35.1, C40.1, C41.1, C42.1, C43.1, C44.1, C45.1, C46.1, C47.1, C50.1, C51.1, C52.1, C53.1, C54.1, C55.1, C56.1, C57.1, C58.1, C59.1, C60.1, C61.1, C62.1, C63.1, C64.1, C65.1, C66.1, C67.1, C68.1, C69.1, C70.1, C71.1, C72.1, C73.1, C77.1, C78.1, C79.1, C80.1, C81.1, C82.1, C83.1, C84.1, C85.1, C86.1, C87.1, C88.1, C89.1, C90.1, C91.1, C92.1, C93.1, C94.1, C95.1, D52.2 (A), J8.44, J8.46, Q93.2 (S), Q96.2 (S), Q98.2 (S), Q100.2 (S), Q102.2 (S), Q104.2 (S), Q106.2 (S), Q108.2 (S), Q110.2 (S), Q112.2 (S), Q114.2 (S), Q116.2 (S), Q118.2 (S), Q120.2 (S), Q122.2 (S), Q124.2 (S), Q126.2 (S), Q128.2 (S), Q130.2 (S), Q132.2 (S), Q134.2 (S), Q136.2 (S), Q138.2 (S), Q140.2 (S), Q142.2 (S), Q144.2 (S), Q146.2 (S), Q148.2 (S), Q150.2 (S), Q152.2 (S), Q154.2 (S), Q156.2 (S), Q158.2 (S), Q160.2 (S), Q162.2 (S), Q164.2 (S), Q166.2 (S), Q168.2 (S), Q170.2 (S), Q172.2 (S), Q174.2 (S), Q176.2 (S), R107.2, R108.2, R109.2, R110.2, R111.2, R112.2, R113.2, R114.2, R115.2, R116.2, R117.2, R118.2, R119.2, R120.2, R121.2, R122.2, R123.2, R124.2, R125.2, R126.2, R127.2, R128.2, R129.2, R130.2, R131.2, R132.2, R133.2, R134.2, R135.2, R136.2, R137.2, R138.2, R139.2, R140.2, R141.2, R142.2, R144.2, R146.2, R184.2, R186.2, R188.2, R190.2, U1.14 (VCC), U2.14 (VCC), U3.14 (VCC), U4.14 (VCC), U5.14 (VCC), U6.14 (VCC), U7.14 (VCC), U8.14 (VCC), U9.14 (VCC), U10.14 (VCC), U11.14 (VCC), U12.14 (VCC), U13.14 (VCC), U14.14 (VCC), U15.14 (VCC), U16.14 (VCC), U17.14 (VCC), U18.14 (VCC), U19.14 (VCC), U20.14 (VCC), U21.14 (VCC), U22.14 (VCC), U23.14 (VCC), U24.14 (VCC), U25.14 (VCC), U26.14 (VCC), U27.14 (VCC), U28.14 (VCC), U29.14 (VCC), U30.14 (VCC), U31.14 (VCC), U32.14 (VCC), U33.14 (VCC), U34.14 (VCC), U35.14 (VCC), U36.14 (VCC), U37.14 (VCC), U38.14 (VCC), U39.14 (VCC), U40.14 (VCC), U41.14 (VCC), U42.16 (VCC), U43.16 (VCC), U44.14 (VCC), U45.14 (VCC), U46.14 (VCC), U47.14 (VCC), U48.14 (VCC), U49.14 (VCC), U50.16 (VCC), U51.16 (VCC), U52.16 (VCC), U53.16 (VCC), U54.16 (VCC), U55.16 (VCC), U56.14 (VCC), U57.14 (VCC), U58.16 (VCC), U59.16 (VCC), U60.16 (VCC), U61.16 (VCC), U62.16 (VCC), U63.16 (VCC), U64.14 (VCC), U65.14 (VCC), U66.16 (VCC), U67.16 (VCC), U68.6 (E3), U68.16 (VCC), U71.16 (VCC), U72.14 (VCC), U73.14 (VCC), U74.14 (VCC), U75.14 (VCC), U83.14 (VCC), U84.16 (VCC), U85.16 (VCC), U86.16 (VCC), U87.14 (VCC), U88.16 (VCC), U89.16 (VCC), U90.16 (VCC), U91.16 (VCC)
/A0: J8.3, Q94.1 (G), R1.1
/A1: J8.5, Q95.1 (G), R3.1
/A2: J8.7, Q97.1 (G), R2.1
/A3: J8.9, Q99.1 (G), R4.1
/A4: J8.13, Q101.1 (G), R5.1
/A5: J8.15, Q103.1 (G), R6.1
/A6: J8.17, Q105.1 (G), R7.1
/A7: J8.19, Q107.1 (G), R8.1
/B0: J8.4, Q109.1 (G), R21.1
/B1: J8.6, Q111.1 (G), R20.1
/B2: J8.8, Q113.1 (G), R19.1
/B3: J8.10, Q115.1 (G), R18.1
/B4: J8.14, Q117.1 (G), R17.1
/B5: J8.16, Q119.1 (G), R16.1
/B6: J8.18, Q121.1 (G), R15.1
/B7: J8.20, Q123.1 (G), R14.1
/CEN: J8.35, Q125.1 (G), R12.1
/CIN: J8.33, Q127.1 (G), R13.1
/COUT: D50.2 (A), J8.27, Q174.3 (D)
/IA0: D35.2 (A), Q93.3 (D), U1.1, U1.4, U36.1, U36.2, U44.1, U44.4, U54.2 (I0a), U54.6 (I1b), U62.2 (I0a), U87.10
/IA1: D36.2 (A), Q96.3 (D), U5.1, U5.4, U37.1, U37.2, U45.1, U45.4, U54.5 (I0b), U54.10 (I1c), U62.3 (I1a), U62.5 (I0b)
/IA2: D37.2 (A), Q98.3 (D), U9.1, U9.4, U38.1, U38.2, U46.1, U46.4, U54.11 (I0c), U54.13 (I1d), U62.6 (I1b), U62.11 (I0c)
/IA3: D38.2 (A), Q100.3 (D), U13.1, U13.4, U39.1, U39.2, U47.1, U47.4, U54.14 (I0d), U55.3 (I1a), U62.10 (I1c), U62.14 (I0d)
/IA4: D39.2 (A), Q102.3 (D), U17.1, U17.4, U40.1, U40.2, U48.1, U48.4, U55.2 (I0a), U55.6 (I1b), U62.13 (I1d), U63.2 (I0a)
/IA5: D40.2 (A), Q104.3 (D), U21.1, U21.4, U55.5 (I0b), U55.10 (I1c), U56.1, U56.2, U63.3 (I1a), U63.5 (I0b), U64.1, U64.4
/IA6: D41.2 (A), Q106.3 (D), U25.1, U25.4, U41.1, U41.2, U49.1, U49.4, U55.11 (I0c), U55.13 (I1d), U63.6 (I1b), U63.11 (I0c)
/IA7: D42.2 (A), Q108.3 (D), U29.1, U29.4, U55.14 (I0d), U57.1, U57.2, U63.10 (I1c), U63.14 (I0d), U65.1, U65.4, U87.4
/IB0: D141.2 (A), Q110.3 (D), U4.1, U4.4, U36.4, U36.5, U44.2, U44.10, U54.1 (S), U55.1 (S), U62.1 (S), U63.1 (S)
/IB1: D140.2 (A), Q112.3 (D), U8.1, U8.4, U37.4, U37.5, U45.2, U45.10, U58.1 (S), U59.1 (S), U66.1 (S), U67.1 (S)
/IB2: D139.2 (A), Q114.3 (D), U12.1, U12.4, U38.4, U38.5, U46.2, U46.10, U60.1 (S), U61.1 (S), U71.1 (S), U84.1 (S)
/IB3: D138.2 (A), Q116.3 (D), U16.1, U16.4, U39.4, U39.5, U47.2, U47.10
/IB4: D137.2 (A), Q118.3 (D), U20.1, U20.4, U40.4, U40.5, U48.2, U48.10
/IB5: D45.2 (A), Q120.3 (D), U24.1, U24.4, U56.4, U56.5, U64.2, U64.10
/IB6: D44.2 (A), Q122.3 (D), U28.1, U28.4, U41.4, U41.5, U49.2, U49.10
/IB7: D43.2 (A), Q124.3 (D), U32.1, U32.4, U57.4, U57.5, U65.2, U65.10
/ICEN: D33.2 (A), Q126.3 (D), U83.2
/ICIN: D34.2 (A), Q128.3 (D), U83.1
/ICRY: D144.2 (A), Q152.3 (D), U33.1, U33.4, U54.3 (I1a), U58.3 (I1a), U58.6 (I1b), U60.3 (I1a), U60.6 (I1b), U60.10 (I1c), U60.13 (I1d), U63.13 (I1d), U67.10 (I1c), U67.13 (I1d), U84.3 (I1a), U84.6 (I1b), U84.10 (I1c), U84.13 (I1d)
/IOP0: D30.2 (A), Q130.3 (D), U4.2, U4.10, U8.2, U8.10, U12.2, U12.10, U16.2, U16.10, U20.2, U20.10, U24.2, U24.10, U28.2, U28.10, U32.2, U32.10, U33.2, U33.10, U35.2, U35.10, U42.1 (S), U43.1 (S), U51.1 (S), U53.1 (S), U68.1 (A0), U85.1 (S), U86.1 (S), U87.1, U87.2, U87.9
/IOP1: D31.2 (A), Q132.3 (D), U50.1 (S), U52.1 (S), U68.2 (A1), U72.10, U72.12, U72.13, U75.4, U75.5, U90.1 (S), U91.1 (S)
/IOP2: D32.2 (A), Q134.3 (D), U68.3 (A2), U73.10, U73.12, U73.13, U75.9, U75.10, U88.1 (S), U89.1 (S)
/IOPSEL0: D63.2 (A), Q136.3 (D)
/IOPSEL1: D89.2 (A), Q138.3 (D)
/IOPSEL2: D90.2 (A), Q140.3 (D)
/IOPSEL3: D91.2 (A), Q142.3 (D)
/IOPSEL4: D92.2 (A), Q144.3 (D)
/IOPSEL5: D93.2 (A), Q146.3 (D)
/IOPSEL6: D142.2 (A), Q148.3 (D)
/IOPSEL7: D143.2 (A), Q150.3 (D)
/NEG: D49.2 (A), J8.25, Q172.3 (D)
/OP0: J8.39, Q129.1 (G), R9.1
/OP1: J8.41, Q131.1 (G), R10.1
/OP2: J8.43, Q133.1 (G), R11.1
/ORES0: D48.2 (A), D128.2 (A), J8.24, Q168.3 (D)
/ORES1: D47.2 (A), D129.2 (A), J8.26, Q166.3 (D)
/ORES2: D46.2 (A), D130.2 (A), J8.28, Q164.3 (D)
/ORES3: D131.2 (A), D149.2 (A), J8.30, Q162.3 (D)
/ORES4: D127.2 (A), D148.2 (A), J8.34, Q160.3 (D)
/ORES5: D126.2 (A), D147.2 (A), J8.36, Q158.3 (D)
/ORES6: D125.2 (A), D146.2 (A), J8.38, Q156.3 (D)
/ORES7: D124.2 (A), D145.2 (A), J8.40, Q154.3 (D), Q171.1 (G)
/OVF: D51.2 (A), J8.29, Q176.3 (D)
/ZERO: D150.2 (A), J8.23, Q170.3 (D)
GND: C1.2, C2.2, C3.2, C4.2, C5.2, C6.2, C7.2, C8.2, C9.2, C10.2, C11.2, C12.2, C13.2, C14.2, C15.2, C16.2, C17.2, C18.2, C19.2, C20.2, C21.2, C22.2, C23.2, C24.2, C25.2, C26.2, C27.2, C28.2, C29.2, C30.2, C31.2, C32.2, C33.2, C34.2, C35.2, C40.2, C41.2, C42.2, C43.2, C44.2, C45.2, C46.2, C47.2, C50.2, C51.2, C52.2, C53.2, C54.2, C55.2, C56.2, C57.2, C58.2, C59.2, C60.2, C61.2, C62.2, C63.2, C64.2, C65.2, C66.2, C67.2, C68.2, C69.2, C70.2, C71.2, C72.2, C73.2, C77.2, C78.2, C79.2, C80.2, C81.2, C82.2, C83.2, C84.2, C85.2, C86.2, C87.2, C88.2, C89.2, C90.2, C91.2, C92.2, C93.2, C94.2, C95.2, H1.1, H2.1, H3.1, J8.1, J8.2, J8.11, J8.12, J8.21, J8.22, J8.31, J8.32, J8.37, J8.42, J8.45, J8.47, J8.48, Q94.2 (S), Q95.2 (S), Q97.2 (S), Q99.2 (S), Q101.2 (S), Q103.2 (S), Q105.2 (S), Q107.2 (S), Q109.2 (S), Q111.2 (S), Q113.2 (S), Q115.2 (S), Q117.2 (S), Q119.2 (S), Q121.2 (S), Q123.2 (S), Q125.2 (S), Q127.2 (S), Q129.2 (S), Q131.2 (S), Q133.2 (S), Q135.2 (S), Q137.2 (S), Q139.2 (S), Q141.2 (S), Q143.2 (S), Q145.2 (S), Q147.2 (S), Q149.2 (S), Q151.2 (S), Q153.2 (S), Q155.2 (S), Q157.2 (S), Q159.2 (S), Q161.2 (S), Q163.2 (S), Q165.2 (S), Q167.2 (S), Q169.2 (S), Q171.2 (S), Q173.2 (S), Q175.2 (S), R1.2, R2.2, R3.2, R4.2, R5.2, R6.2, R7.2, R8.2, R9.2, R10.2, R11.2, R12.2, R13.2, R14.2, R15.2, R16.2, R17.2, R18.2, R19.2, R20.2, R21.2, R143.1, R145.1, R147.1, R148.1, R149.1, R150.1, R151.1, R152.1, R153.1, R154.1, R155.1, R156.1, R157.1, R158.1, R159.1, R160.1, R161.1, R162.1, R163.1, R164.1, R165.1, R166.1, R167.1, R168.1, R169.1, R170.1, R171.1, R172.1, R173.1, R174.1, R175.1, R176.1, R177.1, R178.1, R179.1, R180.1, R181.1, R182.1, R183.1, R185.1, R187.1, R189.1, R191.1, R192.1, U1.7 (GND), U2.7 (GND), U3.4, U3.5, U3.7 (GND), U3.9, U3.10, U3.12, U3.13, U4.7 (GND), U5.7 (GND), U6.7 (GND), U7.4, U7.5, U7.7 (GND), U7.9, U7.10, U7.12, U7.13, U8.7 (GND), U9.7 (GND), U10.7 (GND), U11.4, U11.5, U11.7 (GND), U11.9, U11.10, U11.12, U11.13, U12.7 (GND), U13.7 (GND), U14.7 (GND), U15.4, U15.5, U15.7 (GND), U15.9, U15.10, U15.12, U15.13, U16.7 (GND), U17.7 (GND), U18.7 (GND), U19.4, U19.5, U19.7 (GND), U19.9, U19.10, U19.12, U19.13, U20.7 (GND), U21.7 (GND), U22.7 (GND), U23.4, U23.5, U23.7 (GND), U23.9, U23.10, U23.12, U23.13, U24.7 (GND), U25.7 (GND), U26.7 (GND), U27.4, U27.5, U27.7 (GND), U27.9, U27.10, U27.12, U27.13, U28.7 (GND), U29.7 (GND), U30.7 (GND), U31.4, U31.5, U31.7 (GND), U31.9, U31.10, U31.12, U31.13, U32.7 (GND), U33.7 (GND), U34.7 (GND), U35.7 (GND), U36.7 (GND), U37.7 (GND), U38.7 (GND), U39.7 (GND), U40.7 (GND), U41.7 (GND), U42.8 (GND), U42.15 (E), U43.8 (GND), U43.15 (E), U44.7 (GND), U45.7 (GND), U46.7 (GND), U47.7 (GND), U48.7 (GND), U49.7 (GND), U50.8 (GND), U50.15 (E), U51.8 (GND), U51.15 (E), U52.8 (GND), U52.15 (E), U53.8 (GND), U53.15 (E), U54.8 (GND), U54.15 (E), U55.8 (GND), U55.15 (E), U56.7 (GND), U57.7 (GND), U58.8 (GND), U58.15 (E), U59.8 (GND), U59.15 (E), U60.8 (GND), U60.15 (E), U61.8 (GND), U61.15 (E), U62.8 (GND), U62.15 (E), U63.8 (GND), U63.15 (E), U64.7 (GND), U65.7 (GND), U66.8 (GND), U66.15 (E), U67.8 (GND), U67.15 (E), U68.4 (~E1), U68.5 (~E2), U68.8 (GND), U71.8 (GND), U71.15 (E), U72.7 (GND), U73.7 (GND), U73.9, U74.7 (GND), U74.9, U75.7 (GND), U83.7 (GND), U83.9, U83.10, U83.12, U83.13, U84.8 (GND), U84.15 (E), U85.8 (GND), U85.15 (E), U86.8 (GND), U86.15 (E), U87.7 (GND), U88.8 (GND), U88.15 (E), U89.8 (GND), U89.15 (E), U90.8 (GND), U90.15 (E), U91.8 (GND), U91.15 (E)
unnamed: D30.1 (K), R143.2
unnamed: D31.1 (K), R145.2
unnamed: D32.1 (K), R147.2
unnamed: D33.1 (K), R148.2
unnamed: D34.1 (K), R149.2
unnamed: D35.1 (K), R150.2
unnamed: D36.1 (K), R151.2
unnamed: D37.1 (K), R152.2
unnamed: D38.1 (K), R153.2
unnamed: D39.1 (K), R154.2
unnamed: D40.1 (K), R155.2
unnamed: D41.1 (K), R156.2
unnamed: D42.1 (K), R157.2
unnamed: D43.1 (K), R158.2
unnamed: D44.1 (K), R159.2
unnamed: D45.1 (K), R160.2
unnamed: D46.1 (K), R180.2
unnamed: D47.1 (K), R181.2
unnamed: D48.1 (K), R182.2
unnamed: D49.1 (K), R187.2
unnamed: D50.1 (K), R189.2
unnamed: D51.1 (K), R191.2
unnamed: D52.1 (K), R192.2
unnamed: D63.1 (K), R166.2
unnamed: D89.1 (K), R167.2
unnamed: D90.1 (K), R168.2
unnamed: D91.1 (K), R169.2
unnamed: D92.1 (K), R170.2
unnamed: D93.1 (K), R171.2
unnamed: D124.1 (K), D125.1 (K), D126.1 (K), D127.1 (K), D128.1 (K), D129.1 (K), D130.1 (K), D131.1 (K), R183.2, U75.12, U75.13
unnamed: D137.1 (K), R161.2
unnamed: D138.1 (K), R162.2
unnamed: D139.1 (K), R163.2
unnamed: D140.1 (K), R164.2
unnamed: D141.1 (K), R165.2
unnamed: D142.1 (K), R172.2
unnamed: D143.1 (K), R173.2
unnamed: D144.1 (K), R174.2
unnamed: D145.1 (K), R175.2
unnamed: D146.1 (K), R176.2
unnamed: D147.1 (K), R177.2
unnamed: D148.1 (K), R178.2
unnamed: D149.1 (K), R179.2
unnamed: D150.1 (K), R185.2
unnamed: Q93.1 (G), Q94.3 (D), R107.1
unnamed: Q95.3 (D), Q96.1 (G), R108.1
unnamed: Q97.3 (D), Q98.1 (G), R110.1
unnamed: Q99.3 (D), Q100.1 (G), R112.1
unnamed: Q101.3 (D), Q102.1 (G), R114.1
unnamed: Q103.3 (D), Q104.1 (G), R116.1
unnamed: Q105.3 (D), Q106.1 (G), R118.1
unnamed: Q107.3 (D), Q108.1 (G), R120.1
unnamed: Q109.3 (D), Q110.1 (G), R122.1
unnamed: Q111.3 (D), Q112.1 (G), R124.1
unnamed: Q113.3 (D), Q114.1 (G), R126.1
unnamed: Q115.3 (D), Q116.1 (G), R128.1
unnamed: Q117.3 (D), Q118.1 (G), R130.1
unnamed: Q119.3 (D), Q120.1 (G), R132.1
unnamed: Q121.3 (D), Q122.1 (G), R134.1
unnamed: Q123.3 (D), Q124.1 (G), R136.1
unnamed: Q125.3 (D), Q126.1 (G), R138.1
unnamed: Q127.3 (D), Q128.1 (G), R140.1
unnamed: Q129.3 (D), Q130.1 (G), R142.1
unnamed: Q131.3 (D), Q132.1 (G), R144.1
unnamed: Q133.3 (D), Q134.1 (G), R146.1
unnamed: Q135.3 (D), Q136.1 (G), R109.1
unnamed: Q135.1 (G), U68.15 (Y0)
unnamed: Q137.3 (D), Q138.1 (G), R111.1
unnamed: Q137.1 (G), U68.14 (Y1)
unnamed: Q139.3 (D), Q140.1 (G), R113.1
unnamed: Q139.1 (G), U68.13 (Y2)
unnamed: Q141.3 (D), Q142.1 (G), R115.1
unnamed: Q141.1 (G), U68.12 (Y3)
unnamed: Q143.3 (D), Q144.1 (G), R117.1
unnamed: Q143.1 (G), U68.11 (Y4)
unnamed: Q145.3 (D), Q146.1 (G), R119.1
unnamed: Q145.1 (G), U68.10 (Y5)
unnamed: Q147.3 (D), Q148.1 (G), R121.1
unnamed: Q147.1 (G), U68.9 (Y6)
unnamed: Q149.3 (D), Q150.1 (G), R123.1
unnamed: Q149.1 (G), U68.7 (Y7)
unnamed: Q151.3 (D), Q152.1 (G), R141.1
unnamed: Q151.1 (G), U83.6
unnamed: Q153.3 (D), Q154.1 (G), R125.1
unnamed: Q153.1 (G), U89.12 (Zd)
unnamed: Q155.3 (D), Q156.1 (G), R127.1
unnamed: Q155.1 (G), U89.9 (Zc)
unnamed: Q157.3 (D), Q158.1 (G), R129.1
unnamed: Q157.1 (G), U89.7 (Zb)
unnamed: Q159.3 (D), Q160.1 (G), R131.1
unnamed: Q159.1 (G), U89.4 (Za)
unnamed: Q161.3 (D), Q162.1 (G), R133.1
unnamed: Q161.1 (G), U88.12 (Zd)
unnamed: Q163.3 (D), Q164.1 (G), R135.1
unnamed: Q163.1 (G), U88.9 (Zc)
unnamed: Q165.3 (D), Q166.1 (G), R137.1
unnamed: Q165.1 (G), U88.7 (Zb)
unnamed: Q167.3 (D), Q168.1 (G), R139.1
unnamed: Q167.1 (G), U88.4 (Za)
unnamed: Q169.3 (D), Q170.1 (G), R184.1
unnamed: Q169.1 (G), U75.11
unnamed: Q171.3 (D), Q172.1 (G), R186.1
unnamed: Q173.3 (D), Q174.1 (G), R188.1
unnamed: Q173.1 (G), U73.3
unnamed: Q175.3 (D), Q176.1 (G), R190.1
unnamed: Q175.1 (G), U74.3
unnamed: U1.3, U1.5, U1.9, U3.2
unnamed: U1.2, U1.10, U4.11
unnamed: U1.11, U2.1, U2.4
unnamed: U1.6, U1.12
unnamed: U1.8, U1.13
unnamed: U2.3, U2.5, U2.9, U3.1
unnamed: U2.2, U2.10, U33.11
unnamed: U2.6, U2.12
unnamed: U2.8, U2.13
unnamed: U3.3, U6.2, U6.10
unnamed: U4.3, U4.5, U4.9
unnamed: U4.6, U4.12
unnamed: U4.8, U4.13
unnamed: U5.3, U5.5, U5.9, U7.2
unnamed: U5.2, U5.10, U8.11
unnamed: U5.11, U6.1, U6.4
unnamed: U5.6, U5.12
unnamed: U5.8, U5.13
unnamed: U6.3, U6.5, U6.9, U7.1
unnamed: U6.6, U6.12
unnamed: U6.8, U6.13
unnamed: U8.3, U8.5, U8.9
unnamed: U8.6, U8.12
unnamed: U8.8, U8.13
unnamed: U9.6, U9.12
unnamed: U9.8, U9.13
unnamed: U9.11, U10.1, U10.4
unnamed: U10.3, U10.5, U10.9, U11.1
unnamed: U7.3, U10.2, U10.10
unnamed: U10.6, U10.12
unnamed: U10.8, U10.13
unnamed: U9.3, U9.5, U9.9, U11.2
unnamed: U11.3, U14.2, U14.10
unnamed: U12.3, U12.5, U12.9
unnamed: U9.2, U9.10, U12.11
unnamed: U12.6, U12.12
unnamed: U12.8, U12.13
unnamed: U13.3, U13.5, U13.9, U15.2
unnamed: U13.2, U13.10, U16.11
unnamed: U13.11, U14.1, U14.4
unnamed: U13.6, U13.12
unnamed: U13.8, U13.13
unnamed: U14.3, U14.5, U14.9, U15.1
unnamed: U14.6, U14.12
unnamed: U14.8, U14.13
unnamed: U15.3, U18.2, U18.10
unnamed: U16.3, U16.5, U16.9
unnamed: U16.6, U16.12
unnamed: U16.8, U16.13
unnamed: U17.3, U17.5, U17.9, U19.2
unnamed: U17.2, U17.10, U20.11
unnamed: U17.11, U18.1, U18.4
unnamed: U17.6, U17.12
unnamed: U17.8, U17.13
unnamed: U18.3, U18.5, U18.9, U19.1
unnamed: U18.6, U18.12
unnamed: U18.8, U18.13
unnamed: U19.3, U22.2, U22.10
unnamed: U20.3, U20.5, U20.9
unnamed: U20.6, U20.12
unnamed: U20.8, U20.13
unnamed: U21.3, U21.5, U21.9, U23.2
unnamed: U21.2, U21.10, U24.11
unnamed: U21.11, U22.1, U22.4
unnamed: U21.6, U21.12
unnamed: U21.8, U21.13
unnamed: U22.3, U22.5, U22.9, U23.1
unnamed: U22.6, U22.12
unnamed: U22.8, U22.13
unnamed: U23.3, U26.2, U26.10
unnamed: U24.3, U24.5, U24.9
unnamed: U24.6, U24.12
unnamed: U24.8, U24.13
unnamed: U25.3, U25.5, U25.9, U27.2
unnamed: U25.2, U25.10, U28.11
unnamed: U25.11, U26.1, U26.4
unnamed: U25.6, U25.12
unnamed: U25.8, U25.13
unnamed: U26.3, U26.5, U26.9, U27.1
unnamed: U26.6, U26.12
unnamed: U26.8, U26.13
unnamed: U27.3, U30.2, U30.10, U34.2, U34.10
unnamed: U28.3, U28.5, U28.9
unnamed: U28.6, U28.12
unnamed: U28.8, U28.13
unnamed: U29.3, U29.5, U29.9, U31.2
unnamed: U29.2, U29.10, U32.11
unnamed: U29.11, U30.1, U30.4
unnamed: U29.6, U29.12
unnamed: U29.8, U29.13
unnamed: U30.3, U30.5, U30.9, U31.1
unnamed: U30.6, U30.12
unnamed: U30.8, U30.13
unnamed: U31.3, U34.1, U34.4, U35.1, U35.4
unnamed: U32.3, U32.5, U32.9
unnamed: U32.6, U32.12
unnamed: U32.8, U32.13
unnamed: U33.3, U33.5, U33.9
unnamed: U33.6, U33.12
unnamed: U33.8, U33.13
unnamed: U34.3, U34.5, U34.9
unnamed: U34.11, U74.5
unnamed: U34.6, U34.12
unnamed: U34.8, U34.13
unnamed: U35.3, U35.5, U35.9
unnamed: U35.11, U72.5
unnamed: U35.6, U35.12
unnamed: U35.8, U35.13
unnamed: U36.3, U36.9
unnamed: U36.6, U36.10
unnamed: U37.3, U37.9
unnamed: U37.6, U37.10
unnamed: U38.3, U38.9
unnamed: U38.6, U38.10
unnamed: U39.3, U39.9
unnamed: U39.6, U39.10
unnamed: U40.3, U40.9
unnamed: U40.6, U40.10
unnamed: U41.3, U41.9
unnamed: U41.6, U41.10
unnamed: U39.8, U42.2 (I0a)
unnamed: U38.8, U42.5 (I0b)
unnamed: U37.8, U42.11 (I0c)
unnamed: U36.8, U42.14 (I0d)
unnamed: U39.11, U42.3 (I1a)
unnamed: U38.11, U42.6 (I1b)
unnamed: U37.11, U42.10 (I1c)
unnamed: U36.11, U42.13 (I1d)
unnamed: U42.4 (Za), U50.2 (I0a)
unnamed: U42.7 (Zb), U50.5 (I0b)
unnamed: U42.9 (Zc), U50.11 (I0c)
unnamed: U42.12 (Zd), U50.14 (I0d)
unnamed: U43.2 (I0a), U47.11
unnamed: U43.5 (I0b), U46.11
unnamed: U43.11 (I0c), U45.11
unnamed: U43.14 (I0d), U44.11
unnamed: U39.12, U39.13, U43.3 (I1a), U47.3, U47.5, U47.9
unnamed: U38.12, U38.13, U43.6 (I1b), U46.3, U46.5, U46.9
unnamed: U37.12, U37.13, U43.10 (I1c), U45.3, U45.5, U45.9
unnamed: U36.12, U36.13, U43.13 (I1d), U44.3, U44.5, U44.9
unnamed: U43.4 (Za), U50.3 (I1a)
unnamed: U43.7 (Zb), U50.6 (I1b)
unnamed: U43.9 (Zc), U50.10 (I1c)
unnamed: U43.12 (Zd), U50.13 (I1d)
unnamed: U44.6, U44.12
unnamed: U44.8, U44.13
unnamed: U45.6, U45.12
unnamed: U45.8, U45.13
unnamed: U46.6, U46.12
unnamed: U46.8, U46.13
unnamed: U47.6, U47.12
unnamed: U47.8, U47.13
unnamed: U48.6, U48.12
unnamed: U48.8, U48.13
unnamed: U49.6, U49.12
unnamed: U49.8, U49.13
unnamed: U50.4 (Za), U88.13 (I1d)
unnamed: U50.7 (Zb), U88.10 (I1c)
unnamed: U50.9 (Zc), U88.6 (I1b)
unnamed: U50.12 (Zd), U88.3 (I1a)
unnamed: U51.2 (I0a), U57.8
unnamed: U41.8, U51.5 (I0b)
unnamed: U51.11 (I0c), U56.8
unnamed: U40.8, U51.14 (I0d)
unnamed: U51.3 (I1a), U57.11
unnamed: U41.11, U51.6 (I1b)
unnamed: U51.10 (I1c), U56.11
unnamed: U40.11, U51.13 (I1d)
unnamed: U51.4 (Za), U52.2 (I0a)
unnamed: U51.7 (Zb), U52.5 (I0b)
unnamed: U51.9 (Zc), U52.11 (I0c)
unnamed: U51.12 (Zd), U52.14 (I0d)
unnamed: U52.3 (I1a), U53.4 (Za)
unnamed: U52.6 (I1b), U53.7 (Zb)
unnamed: U52.10 (I1c), U53.9 (Zc)
unnamed: U52.13 (I1d), U53.12 (Zd)
unnamed: U52.4 (Za), U89.13 (I1d)
unnamed: U52.7 (Zb), U89.10 (I1c)
unnamed: U52.9 (Zc), U89.6 (I1b)
unnamed: U52.12 (Zd), U89.3 (I1a)
unnamed: U53.2 (I0a), U65.11
unnamed: U49.11, U53.5 (I0b)
unnamed: U53.11 (I0c), U64.11
unnamed: U48.11, U53.14 (I0d)
unnamed: U53.3 (I1a), U57.12, U57.13, U65.3, U65.5, U65.9
unnamed: U41.12, U41.13, U49.3, U49.5, U49.9, U53.6 (I1b)
unnamed: U53.10 (I1c), U56.12, U56.13, U64.3, U64.5, U64.9
unnamed: U40.12, U40.13, U48.3, U48.5, U48.9, U53.13 (I1d)
unnamed: U54.4 (Za), U58.2 (I0a), U58.10 (I1c)
unnamed: U54.7 (Zb), U58.5 (I0b), U58.13 (I1d)
unnamed: U54.9 (Zc), U58.11 (I0c), U59.3 (I1a)
unnamed: U54.12 (Zd), U58.14 (I0d), U59.6 (I1b)
unnamed: U55.4 (Za), U59.2 (I0a), U59.10 (I1c)
unnamed: U55.7 (Zb), U59.5 (I0b), U59.13 (I1d)
unnamed: U55.9 (Zc), U59.11 (I0c)
unnamed: U55.12 (Zd), U59.14 (I0d)
unnamed: U56.3, U56.9
unnamed: U56.6, U56.10
unnamed: U57.3, U57.9
unnamed: U57.6, U57.10
unnamed: U58.4 (Za), U60.2 (I0a), U61.3 (I1a)
unnamed: U58.7 (Zb), U60.5 (I0b), U61.6 (I1b)
unnamed: U58.9 (Zc), U60.11 (I0c), U61.10 (I1c)
unnamed: U58.12 (Zd), U60.14 (I0d), U61.13 (I1d)
unnamed: U59.4 (Za), U61.2 (I0a)
unnamed: U59.7 (Zb), U61.5 (I0b)
unnamed: U59.9 (Zc), U61.11 (I0c)
unnamed: U59.12 (Zd), U61.14 (I0d)
unnamed: U60.4 (Za), U86.14 (I0d)
unnamed: U60.7 (Zb), U86.11 (I0c)
unnamed: U60.9 (Zc), U86.5 (I0b)
unnamed: U60.12 (Zd), U86.2 (I0a)
unnamed: U61.4 (Za), U85.14 (I0d)
unnamed: U61.7 (Zb), U85.11 (I0c)
unnamed: U61.9 (Zc), U85.5 (I0b)
unnamed: U61.12 (Zd), U85.2 (I0a)
unnamed: U62.4 (Za), U66.2 (I0a)
unnamed: U62.7 (Zb), U66.5 (I0b)
unnamed: U62.9 (Zc), U66.3 (I1a), U66.11 (I0c)
unnamed: U62.12 (Zd), U66.6 (I1b), U66.14 (I0d)
unnamed: U63.4 (Za), U66.10 (I1c), U67.2 (I0a)
unnamed: U63.7 (Zb), U66.13 (I1d), U67.5 (I0b)
unnamed: U63.9 (Zc), U67.3 (I1a), U67.11 (I0c)
unnamed: U63.12 (Zd), U67.6 (I1b), U67.14 (I0d)
unnamed: U64.6, U64.12
unnamed: U64.8, U64.13
unnamed: U65.6, U65.12
unnamed: U65.8, U65.13
unnamed: U66.4 (Za), U71.2 (I0a)
unnamed: U66.7 (Zb), U71.5 (I0b)
unnamed: U66.9 (Zc), U71.11 (I0c)
unnamed: U66.12 (Zd), U71.14 (I0d)
unnamed: U67.4 (Za), U71.3 (I1a), U84.2 (I0a)
unnamed: U67.7 (Zb), U71.6 (I1b), U84.5 (I0b)
unnamed: U67.9 (Zc), U71.10 (I1c), U84.11 (I0c)
unnamed: U67.12 (Zd), U71.13 (I1d), U84.14 (I0d)
unnamed: U71.4 (Za), U86.13 (I1d)
unnamed: U71.7 (Zb), U86.10 (I1c)
unnamed: U71.9 (Zc), U86.6 (I1b)
unnamed: U71.12 (Zd), U86.3 (I1a)
unnamed: U72.1, U72.8
unnamed: U72.2, U72.6
unnamed: U72.3, U73.5
unnamed: U72.9, U87.11
unnamed: U72.4, U72.11
unnamed: U73.1, U73.8
unnamed: U73.2, U73.6
unnamed: U73.4, U73.11
unnamed: U74.1, U74.8
unnamed: U74.2, U74.6
unnamed: U74.10, U74.12, U74.13, U75.3
unnamed: U74.4, U74.11
unnamed: U75.1, U75.8
unnamed: U75.2, U75.6
unnamed: U83.3, U83.4, U83.5
unnamed: U84.4 (Za), U85.13 (I1d)
unnamed: U84.7 (Zb), U85.10 (I1c)
unnamed: U84.9 (Zc), U85.6 (I1b)
unnamed: U84.12 (Zd), U85.3 (I1a)
unnamed: U85.4 (Za), U91.13 (I1d)
unnamed: U85.7 (Zb), U91.10 (I1c)
unnamed: U85.9 (Zc), U91.6 (I1b)
unnamed: U85.12 (Zd), U91.3 (I1a)
unnamed: U86.4 (Za), U90.13 (I1d)
unnamed: U86.7 (Zb), U90.10 (I1c)
unnamed: U86.9 (Zc), U90.6 (I1b)
unnamed: U86.12 (Zd), U90.3 (I1a)
unnamed: U87.3, U87.5
unnamed: U87.6, U87.12
unnamed: U87.8, U87.13
unnamed: U88.2 (I0a), U90.4 (Za)
unnamed: U88.5 (I0b), U90.7 (Zb)
unnamed: U88.11 (I0c), U90.9 (Zc)
unnamed: U88.14 (I0d), U90.12 (Zd)
unnamed: U89.2 (I0a), U91.4 (Za)
unnamed: U89.5 (I0b), U91.7 (Zb)
unnamed: U89.11 (I0c), U91.9 (Zc)
unnamed: U89.14 (I0d), U91.12 (Zd)
unnamed: U2.11, U90.2 (I0a)
unnamed: U6.11, U90.5 (I0b)
unnamed: U10.11, U90.11 (I0c)
unnamed: U14.11, U90.14 (I0d)
unnamed: U18.11, U91.2 (I0a)
unnamed: U22.11, U91.5 (I0b)
unnamed: U26.11, U91.11 (I0c)
unnamed: U30.11, U91.14 (I0d)

Notes on the sheet:
Shift
Bitops
OVF
COUT
ADD/SUB

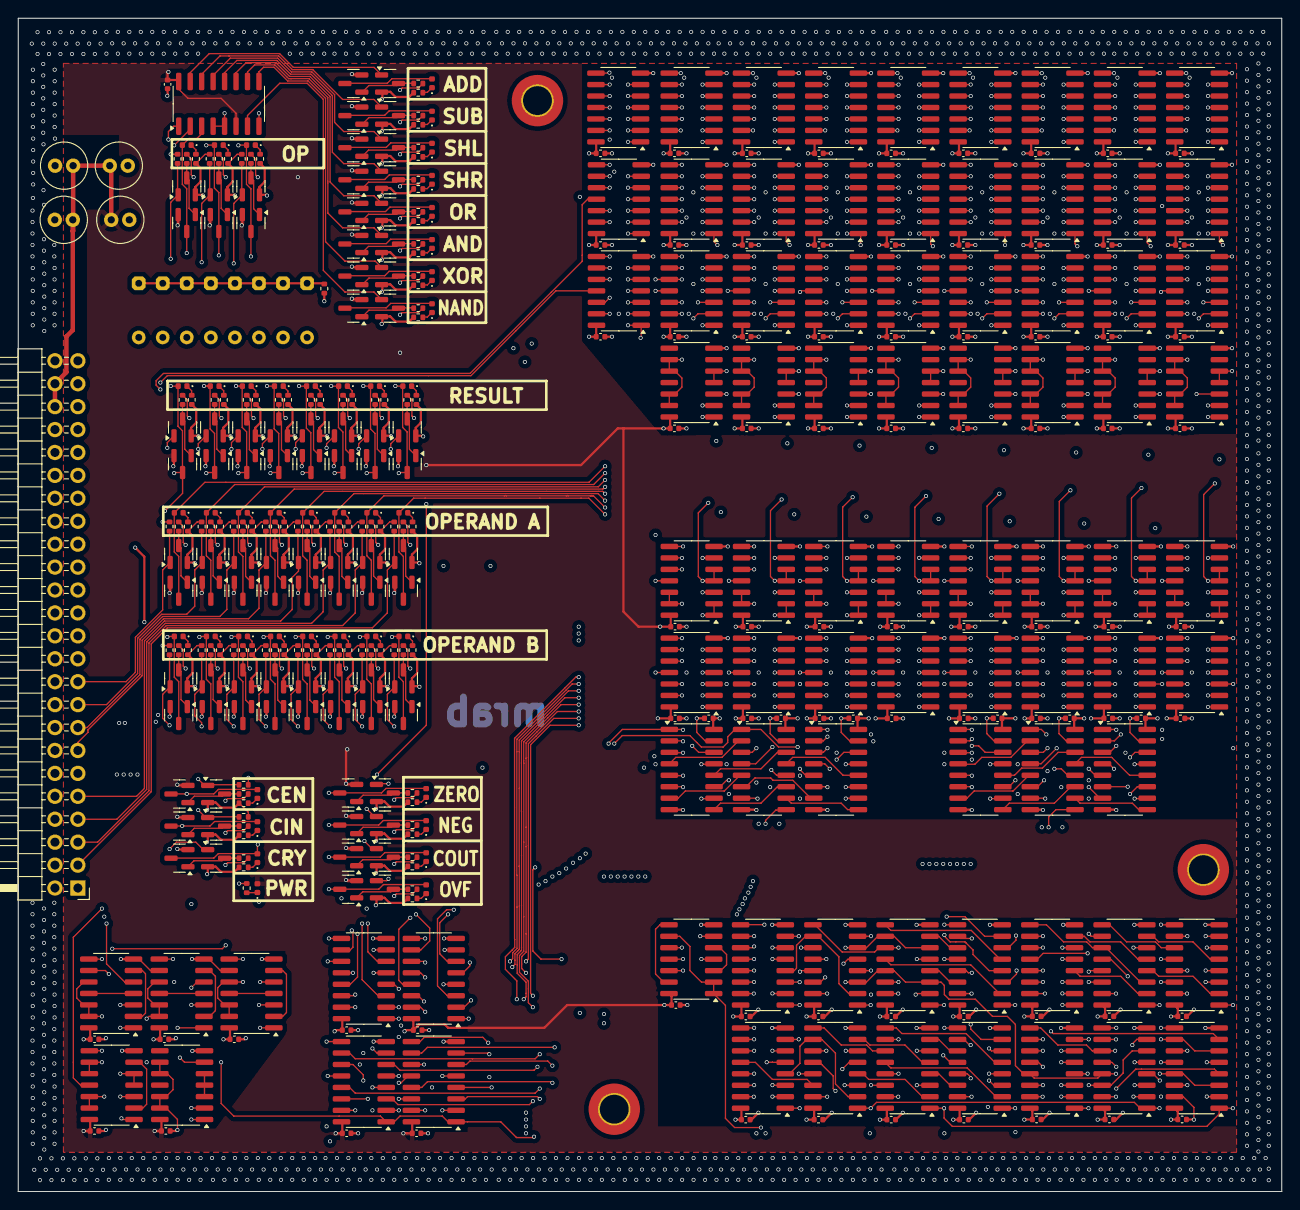
[picture p98: board alu.kicad_pcb from above]

Board: 4 copper layers, 140.0 x 130.0 mm, 414 parts (0 on the bottom side), 457 nets.
