kantholz44mm/cpu/hardware/register/register.kicad_pcb

## KiCad design hardware/register/register.kicad_pcb (2025-03-20)

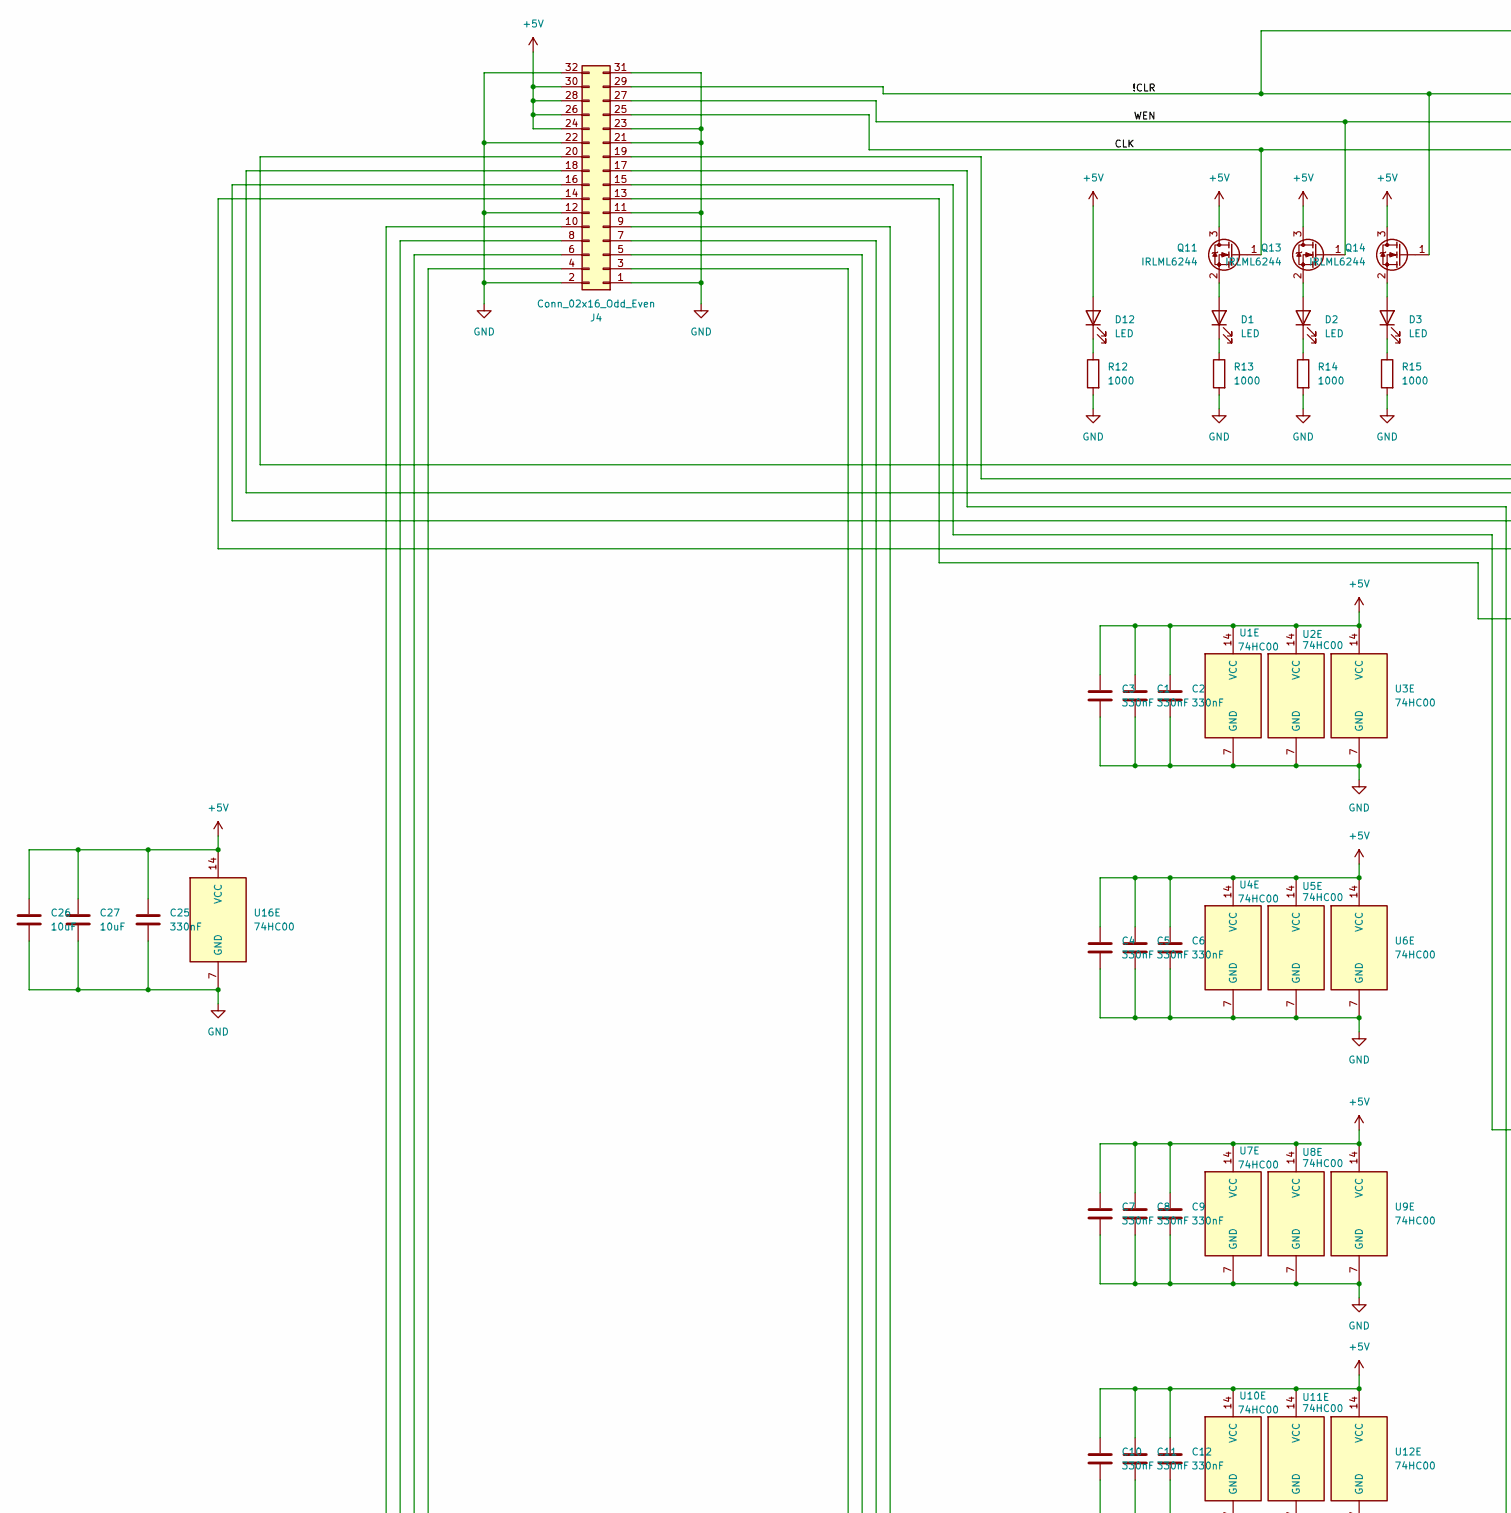
[picture p99: schematic register.kicad_sch, part in row 1, column 1]

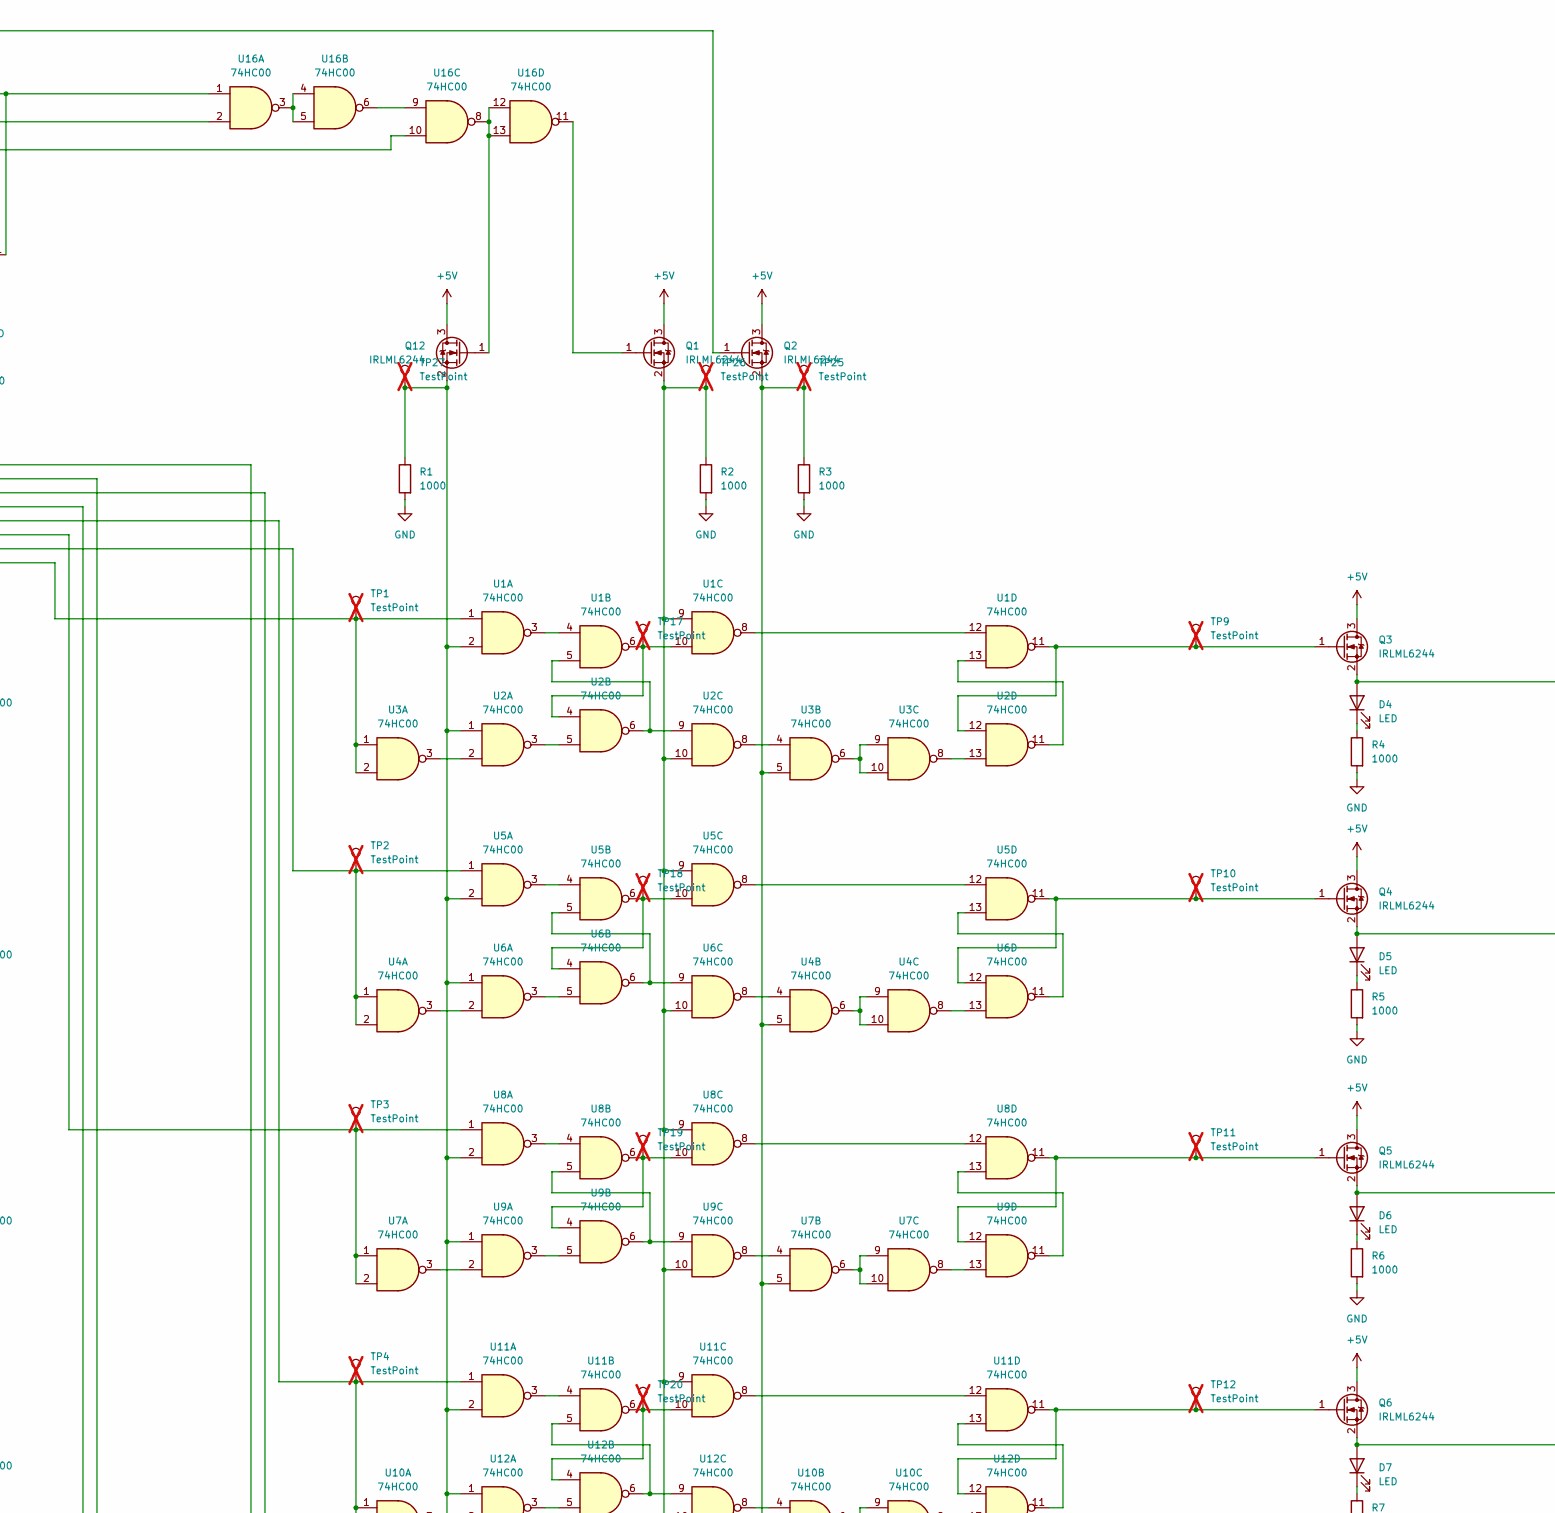
[picture p100: schematic register.kicad_sch, part in row 1, column 2]

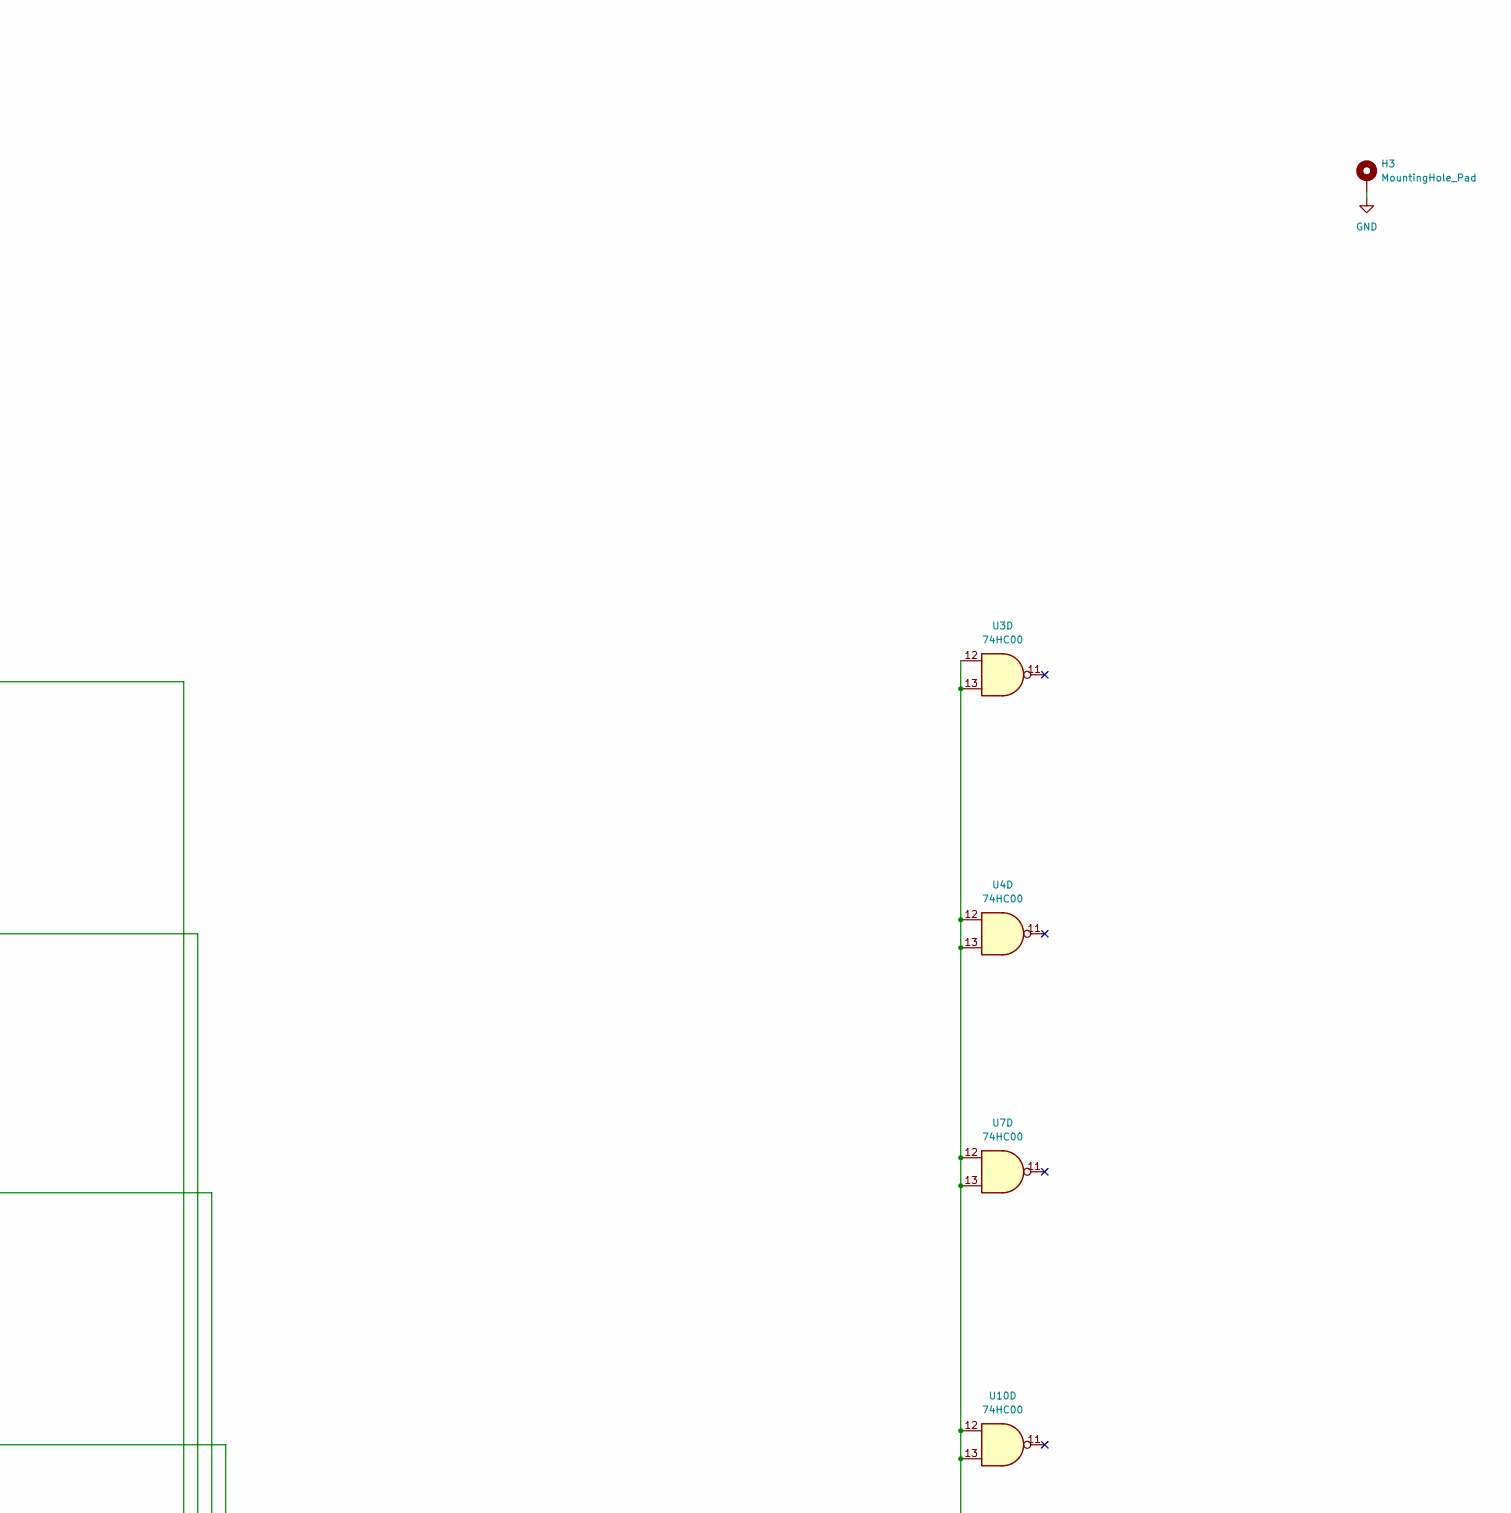
[picture p101: schematic register.kicad_sch, part in row 1, column 3]

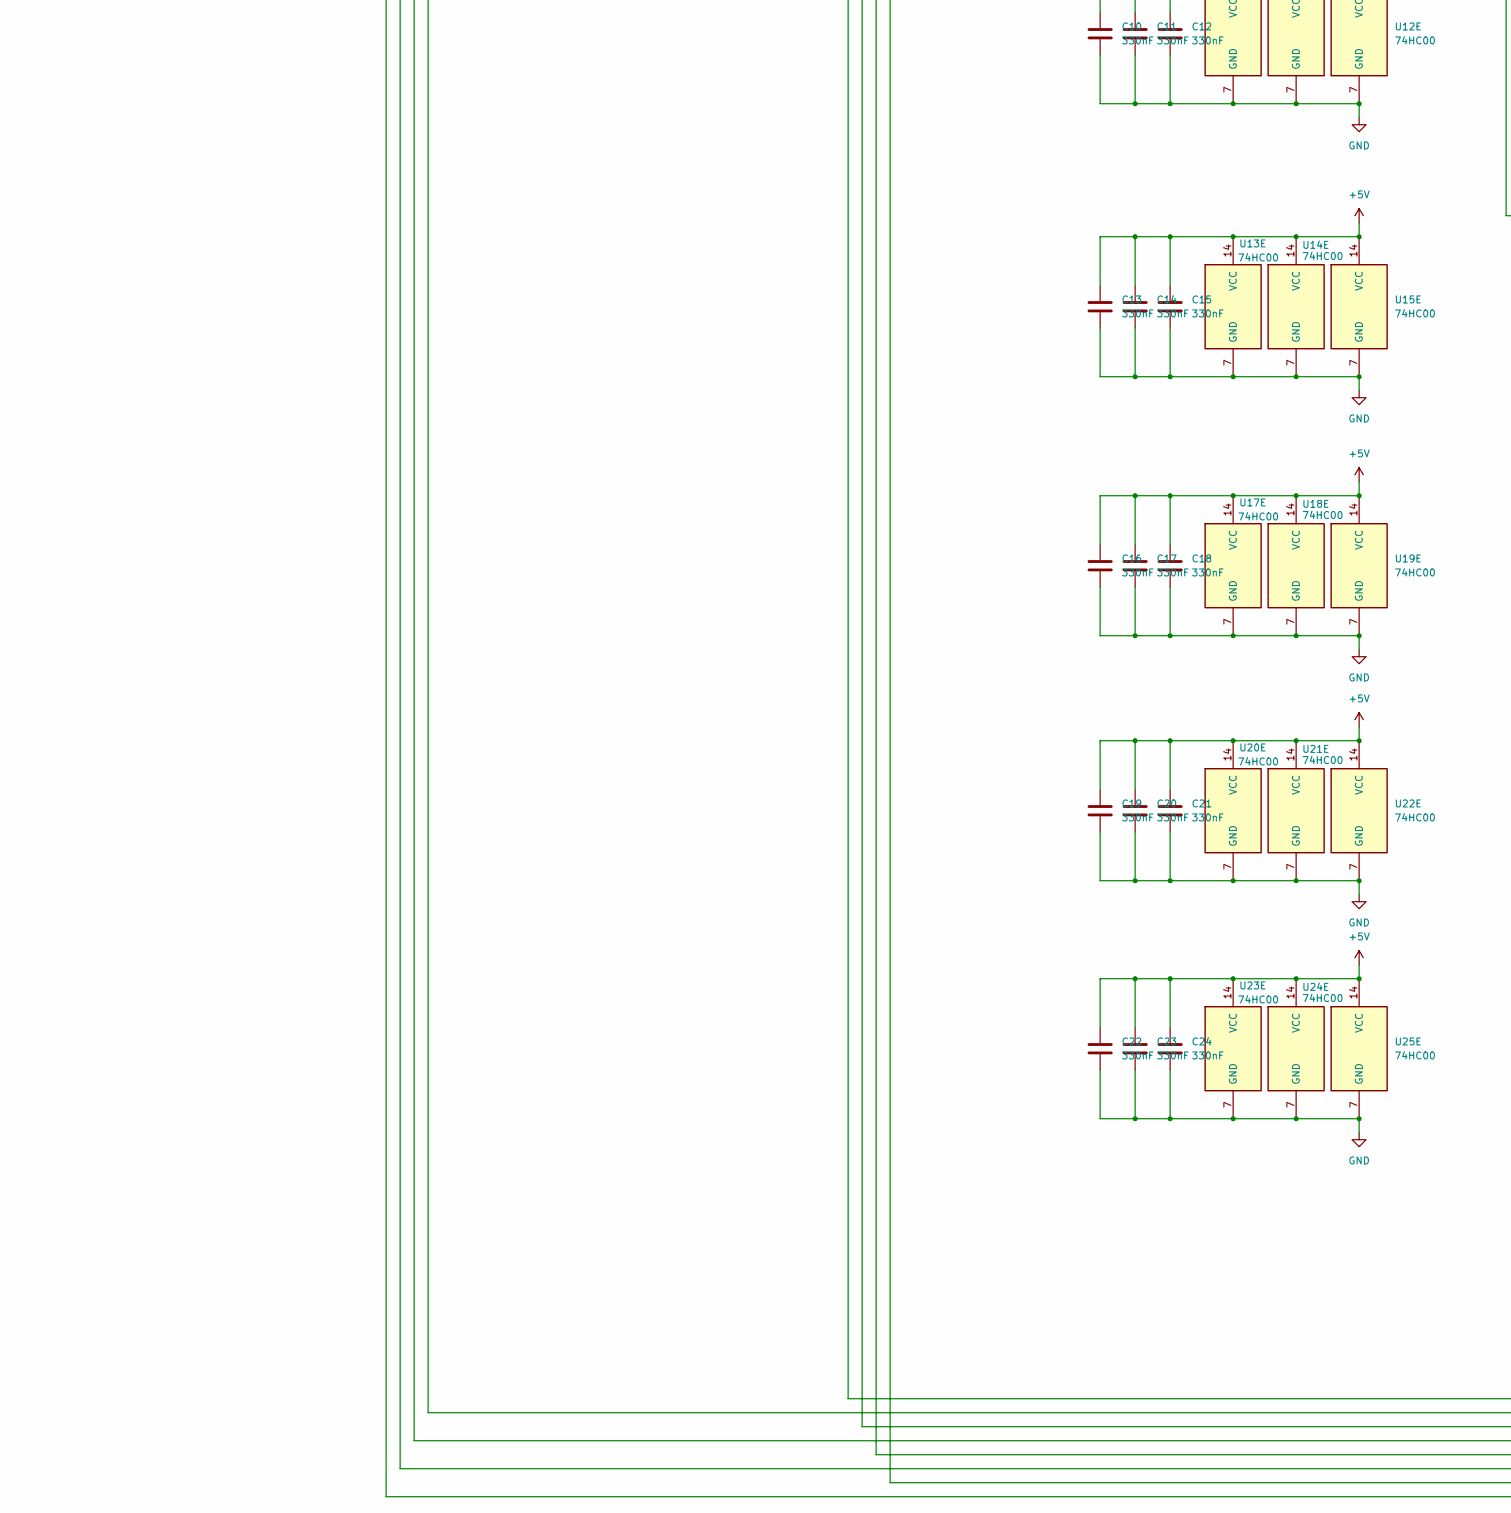
[picture p102: schematic register.kicad_sch, part in row 2, column 1]

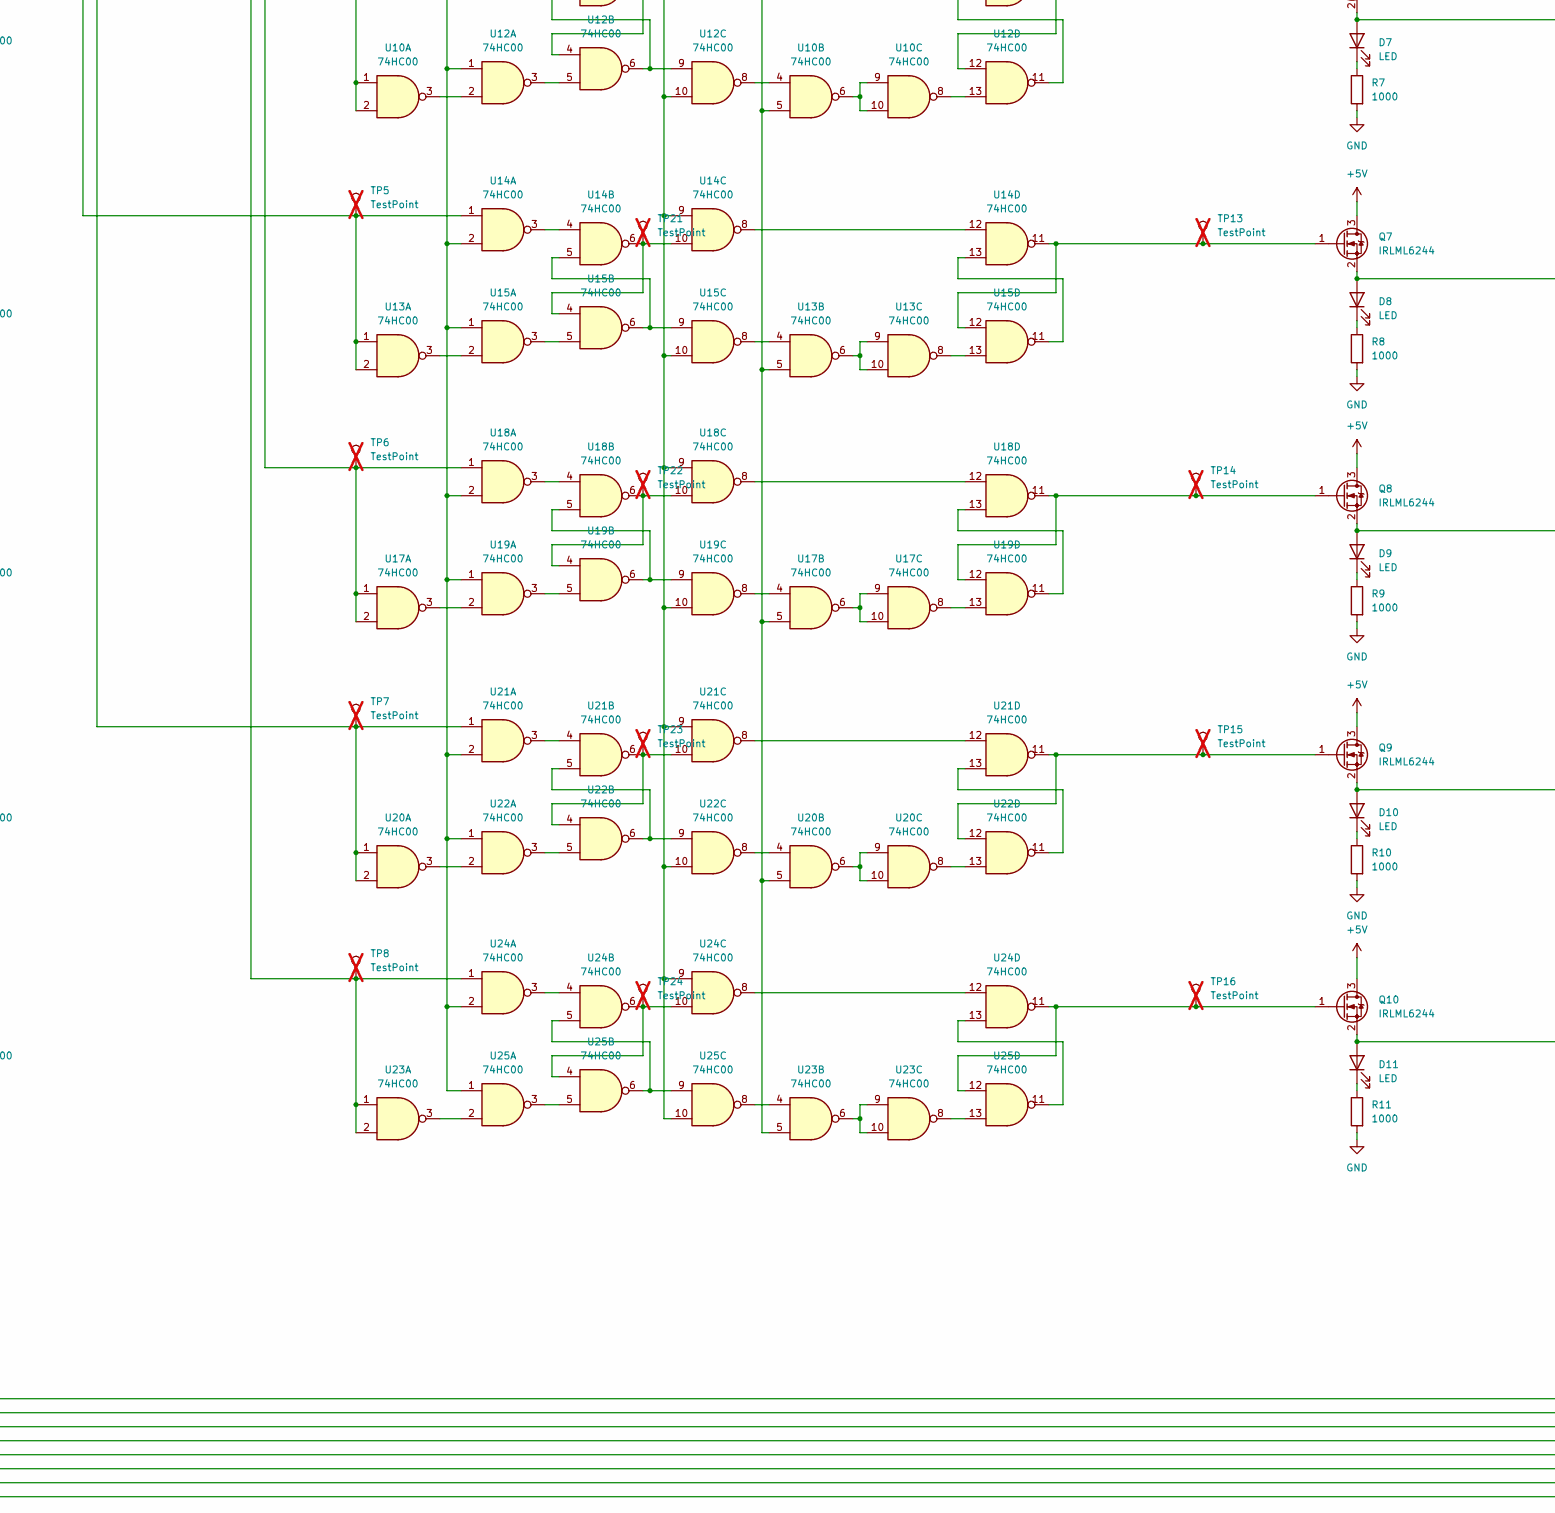
[picture p103: schematic register.kicad_sch, part in row 2, column 2]

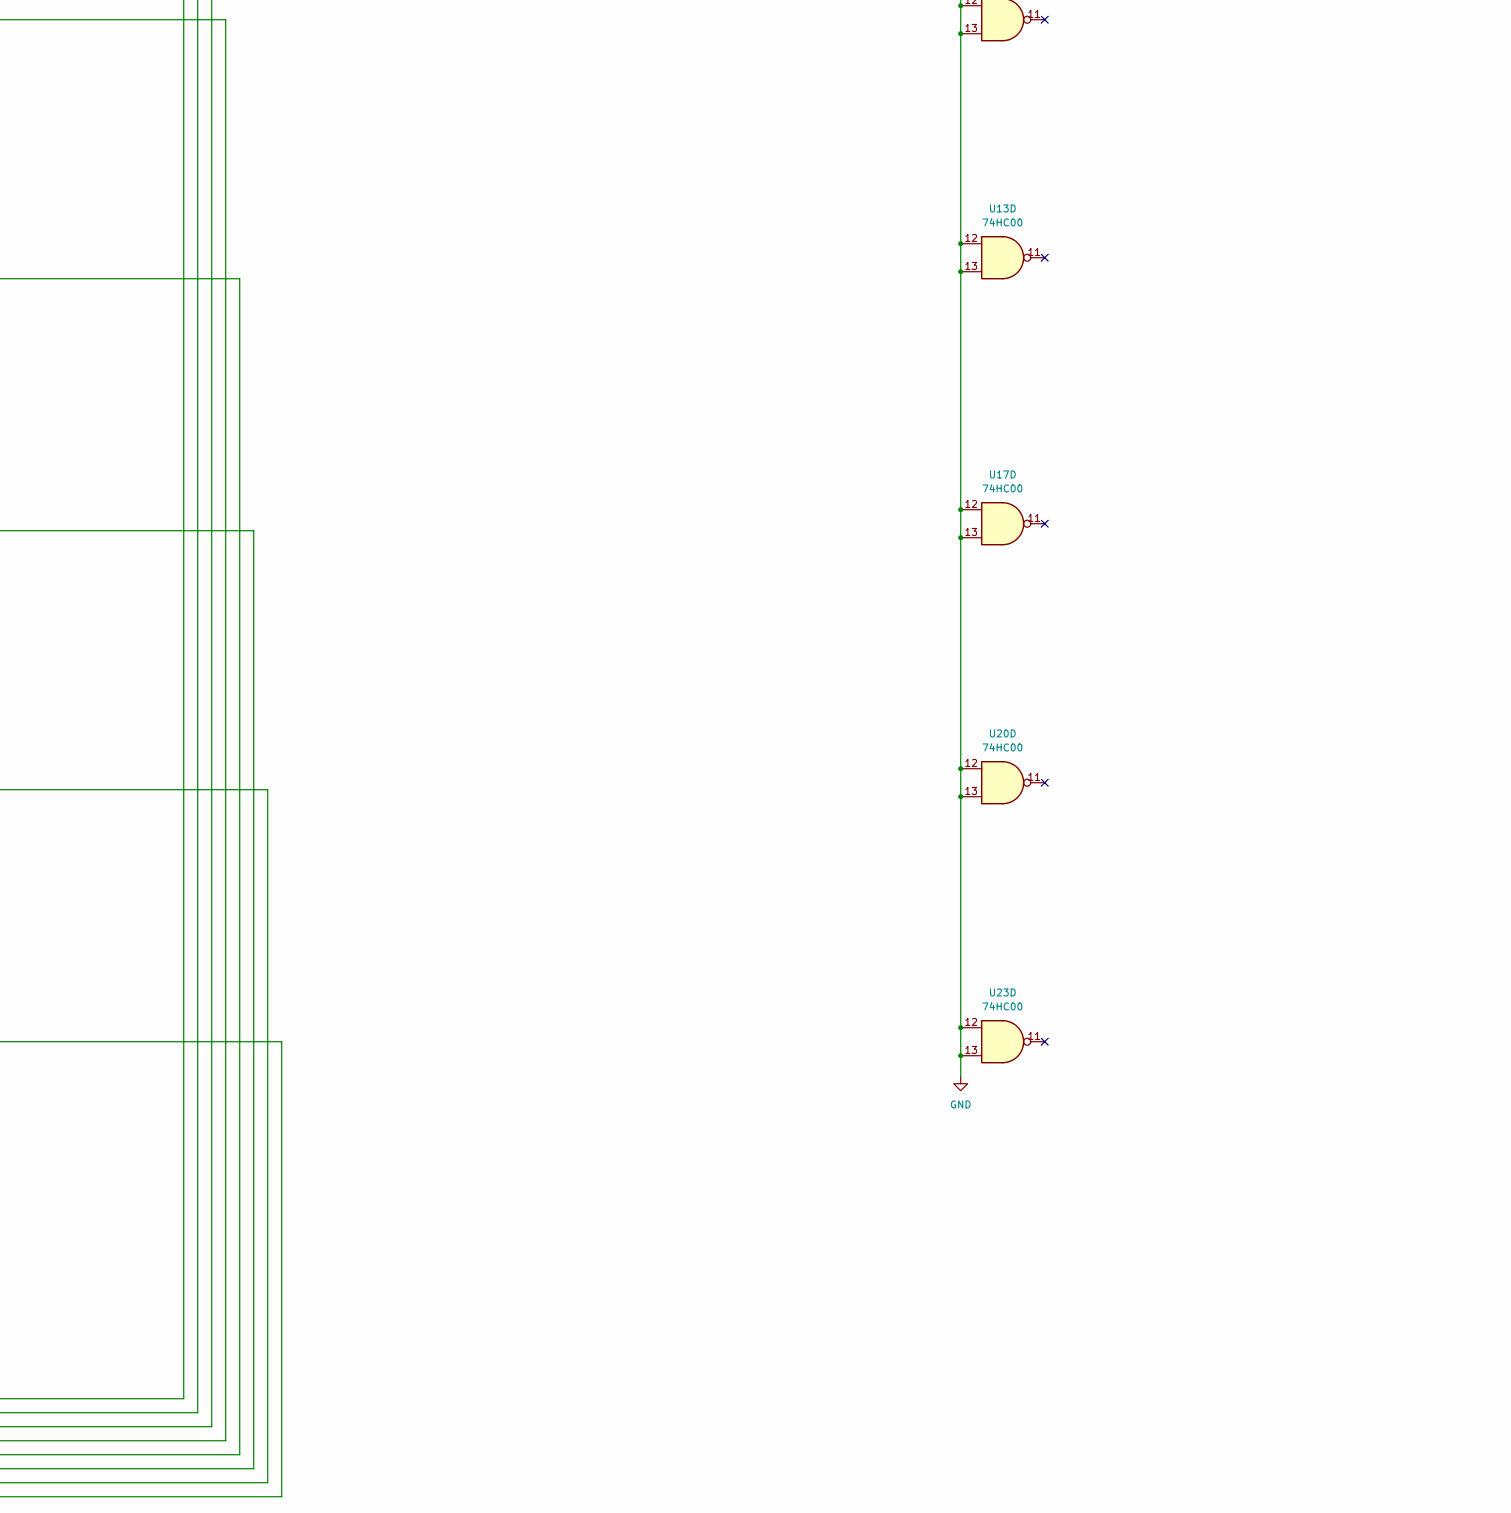
[picture p104: schematic register.kicad_sch, part in row 2, column 3]

Parts:
C1, C2, C3, C4, C5, C6, C7, C8, C9, C10, C11, C12, C13, C14, C15, C16, C17, C18, C19, C20, C21, C22, C23, C24, C25: 330nF; C_0603_1608Metric_Pad1.08x0.95mm_HandSolder; LCSC C2918485
C26, C27: 10uF; C_0603_1608Metric_Pad1.08x0.95mm_HandSolder; LCSC C2909630
D1, D2, D3, D4, D5, D6, D7, D8, D9, D10, D11, D12: LED; LED_0603_1608Metric_Pad1.05x0.95mm_HandSolder; LCSC C84267
H3: MountingHole_Pad; MountingHole_2.2mm_M2_Pad
J4: Conn_02x16_Odd_Even; PinHeader_2x16_P2.54mm_Horizontal
Q1, Q2, Q3, Q4, Q5, Q6, Q7, Q8, Q9, Q10, Q11, Q12, Q13, Q14: IRLML6244; SOT-23_Handsoldering; LCSC C5123965
R1, R2, R3, R4, R5, R6, R7, R8, R9, R10, R11, R12, R13, R14, R15: 1000; R_0603_1608Metric_Pad0.98x0.95mm_HandSolder; LCSC C21190
TP1, TP2, TP3, TP4, TP5, TP6, TP7, TP8, TP9, TP10, TP11, TP12, TP13, TP14, TP15, TP16, TP17, TP18, TP19, TP20, TP21, TP22, TP23, TP24, TP25, TP26, TP27: TestPoint; TestPoint_Pad_D2.0mm; not fitted
U1, U2, U3, U4, U5, U6, U7, U8, U9, U10, U11, U12, U13, U14, U15, U16, U17, U18, U19, U20, U21, U22, U23, U24, U25: 74HC00; SOIC-14_3.9x8.7mm_P1.27mm; LCSC C5586

Connections:
+5V: C1.1, C2.1, C3.1, C4.1, C5.1, C6.1, C7.1, C8.1, C9.1, C10.1, C11.1, C12.1, C13.1, C14.1, C15.1, C16.1, C17.1, C18.1, C19.1, C20.1, C21.1, C22.1, C23.1, C24.1, C25.1, C26.1, C27.1, D12.2 (A), J4.24, J4.26, J4.28, J4.30, Q1.3 (D), Q2.3 (D), Q3.3 (D), Q4.3 (D), Q5.3 (D), Q6.3 (D), Q7.3 (D), Q8.3 (D), Q9.3 (D), Q10.3 (D), Q11.3 (D), Q12.3 (D), Q13.3 (D), Q14.3 (D), U1.14 (VCC), U2.14 (VCC), U3.14 (VCC), U4.14 (VCC), U5.14 (VCC), U6.14 (VCC), U7.14 (VCC), U8.14 (VCC), U9.14 (VCC), U10.14 (VCC), U11.14 (VCC), U12.14 (VCC), U13.14 (VCC), U14.14 (VCC), U15.14 (VCC), U16.14 (VCC), U17.14 (VCC), U18.14 (VCC), U19.14 (VCC), U20.14 (VCC), U21.14 (VCC), U22.14 (VCC), U23.14 (VCC), U24.14 (VCC), U25.14 (VCC)
/!CLR: J4.29, Q2.1 (G), Q14.1 (G), U16.1
/CLK: J4.25, Q11.1 (G), U16.10
/WEN: J4.27, Q13.1 (G), U16.2
GND: C1.2, C2.2, C3.2, C4.2, C5.2, C6.2, C7.2, C8.2, C9.2, C10.2, C11.2, C12.2, C13.2, C14.2, C15.2, C16.2, C17.2, C18.2, C19.2, C20.2, C21.2, C22.2, C23.2, C24.2, C25.2, C26.2, C27.2, H3.1, J4.1, J4.2, J4.11, J4.12, J4.21, J4.22, J4.23, J4.31, J4.32, R1.2, R2.2, R3.2, R4.2, R5.2, R6.2, R7.2, R8.2, R9.2, R10.2, R11.2, R12.2, R13.2, R14.2, R15.2, U1.7 (GND), U2.7 (GND), U3.7 (GND), U3.12, U3.13, U4.7 (GND), U4.12, U4.13, U5.7 (GND), U6.7 (GND), U7.7 (GND), U7.12, U7.13, U8.7 (GND), U9.7 (GND), U10.7 (GND), U10.12, U10.13, U11.7 (GND), U12.7 (GND), U13.7 (GND), U13.12, U13.13, U14.7 (GND), U15.7 (GND), U16.7 (GND), U17.7 (GND), U17.12, U17.13, U18.7 (GND), U19.7 (GND), U20.7 (GND), U20.12, U20.13, U21.7 (GND), U22.7 (GND), U23.7 (GND), U23.12, U23.13, U24.7 (GND), U25.7 (GND)
unnamed: D1.2 (A), Q11.2 (S)
unnamed: D1.1 (K), R13.1
unnamed: D2.2 (A), Q13.2 (S)
unnamed: D2.1 (K), R14.1
unnamed: D3.2 (A), Q14.2 (S)
unnamed: D3.1 (K), R15.1
unnamed: D4.2 (A), J4.3, Q3.2 (S)
unnamed: D4.1 (K), R4.1
unnamed: D5.2 (A), J4.4, Q4.2 (S)
unnamed: D5.1 (K), R5.1
unnamed: D6.2 (A), J4.5, Q5.2 (S)
unnamed: D6.1 (K), R6.1
unnamed: D7.2 (A), J4.6, Q6.2 (S)
unnamed: D7.1 (K), R7.1
unnamed: D8.2 (A), J4.7, Q7.2 (S)
unnamed: D8.1 (K), R8.1
unnamed: D9.2 (A), J4.8, Q8.2 (S)
unnamed: D9.1 (K), R9.1
unnamed: D10.2 (A), J4.9, Q9.2 (S)
unnamed: D10.1 (K), R10.1
unnamed: D11.2 (A), J4.10, Q10.2 (S)
unnamed: D11.1 (K), R11.1
unnamed: D12.1 (K), R12.1
unnamed: J4.13, TP1.1, U1.1, U3.1, U3.2
unnamed: J4.14, TP2.1, U4.1, U4.2, U5.1
unnamed: J4.15, TP3.1, U7.1, U7.2, U8.1
unnamed: J4.16, TP4.1, U10.1, U10.2, U11.1
unnamed: J4.17, TP5.1, U13.1, U13.2, U14.1
unnamed: J4.18, TP6.1, U17.1, U17.2, U18.1
unnamed: J4.19, TP7.1, U20.1, U20.2, U21.1
unnamed: J4.20, TP8.1, U23.1, U23.2, U24.1
unnamed: Q1.1 (G), U16.11
unnamed: Q1.2 (S), R2.1, TP26.1, U1.9, U2.10, U5.9, U6.10, U8.9, U9.10, U11.9, U12.10, U14.9, U15.10, U18.9, U19.10, U21.9, U22.10, U24.9, U25.10
unnamed: Q2.2 (S), R3.1, TP25.1, U3.5, U4.5, U7.5, U10.5, U13.5, U17.5, U20.5, U23.5
unnamed: Q3.1 (G), TP9.1, U1.11, U2.12
unnamed: Q4.1 (G), TP10.1, U5.11, U6.12
unnamed: Q5.1 (G), TP11.1, U8.11, U9.12
unnamed: Q6.1 (G), TP12.1, U11.11, U12.12
unnamed: Q7.1 (G), TP13.1, U14.11, U15.12
unnamed: Q8.1 (G), TP14.1, U18.11, U19.12
unnamed: Q9.1 (G), TP15.1, U21.11, U22.12
unnamed: Q10.1 (G), TP16.1, U24.11, U25.12
unnamed: Q12.1 (G), U16.8, U16.12, U16.13
unnamed: Q12.2 (S), R1.1, TP27.1, U1.2, U2.1, U5.2, U6.1, U8.2, U9.1, U11.2, U12.1, U14.2, U15.1, U18.2, U19.1, U21.2, U22.1, U24.2, U25.1
unnamed: TP17.1, U1.6, U1.10, U2.4
unnamed: TP18.1, U5.6, U5.10, U6.4
unnamed: TP19.1, U8.6, U8.10, U9.4
unnamed: TP20.1, U11.6, U11.10, U12.4
unnamed: TP21.1, U14.6, U14.10, U15.4
unnamed: TP22.1, U18.6, U18.10, U19.4
unnamed: TP23.1, U21.6, U21.10, U22.4
unnamed: TP24.1, U24.6, U24.10, U25.4
unnamed: U1.3, U1.4
unnamed: U1.5, U2.6, U2.9
unnamed: U1.8, U1.12
unnamed: U1.13, U2.11
unnamed: U2.2, U3.3
unnamed: U2.3, U2.5
unnamed: U2.8, U3.4
unnamed: U2.13, U3.8
unnamed: U3.6, U3.9, U3.10
unnamed: U4.3, U6.2
unnamed: U4.4, U6.8
unnamed: U4.8, U6.13
unnamed: U4.6, U4.9, U4.10
unnamed: U5.3, U5.4
unnamed: U5.5, U6.6, U6.9
unnamed: U5.8, U5.12
unnamed: U5.13, U6.11
unnamed: U6.3, U6.5
unnamed: U7.3, U9.2
unnamed: U7.4, U9.8
unnamed: U7.8, U9.13
unnamed: U7.6, U7.9, U7.10
unnamed: U8.3, U8.4
unnamed: U8.5, U9.6, U9.9
unnamed: U8.8, U8.12
unnamed: U8.13, U9.11
unnamed: U9.3, U9.5
unnamed: U10.3, U12.2
unnamed: U10.4, U12.8
unnamed: U10.8, U12.13
unnamed: U10.6, U10.9, U10.10
unnamed: U11.3, U11.4
unnamed: U11.5, U12.6, U12.9
unnamed: U11.8, U11.12
unnamed: U11.13, U12.11
unnamed: U12.3, U12.5
unnamed: U13.3, U15.2
unnamed: U13.4, U15.8
unnamed: U13.8, U15.13
unnamed: U13.6, U13.9, U13.10
unnamed: U14.3, U14.4
unnamed: U14.5, U15.6, U15.9
unnamed: U14.8, U14.12
unnamed: U14.13, U15.11
unnamed: U15.3, U15.5
unnamed: U16.3, U16.4, U16.5
unnamed: U16.6, U16.9
unnamed: U17.3, U19.2
unnamed: U17.4, U19.8
unnamed: U17.8, U19.13
unnamed: U17.6, U17.9, U17.10
unnamed: U18.3, U18.4
unnamed: U18.5, U19.6, U19.9
unnamed: U18.8, U18.12
unnamed: U18.13, U19.11
unnamed: U19.3, U19.5
unnamed: U20.3, U22.2
unnamed: U20.4, U22.8
unnamed: U20.8, U22.13
unnamed: U20.6, U20.9, U20.10
unnamed: U21.3, U21.4
unnamed: U21.5, U22.6, U22.9
unnamed: U21.8, U21.12
unnamed: U21.13, U22.11
unnamed: U22.3, U22.5
unnamed: U23.3, U25.2
unnamed: U23.4, U25.8
unnamed: U23.8, U25.13
unnamed: U23.6, U23.9, U23.10
unnamed: U24.3, U24.4
unnamed: U24.5, U25.6, U25.9
unnamed: U24.8, U24.12
unnamed: U24.13, U25.11
unnamed: U25.3, U25.5

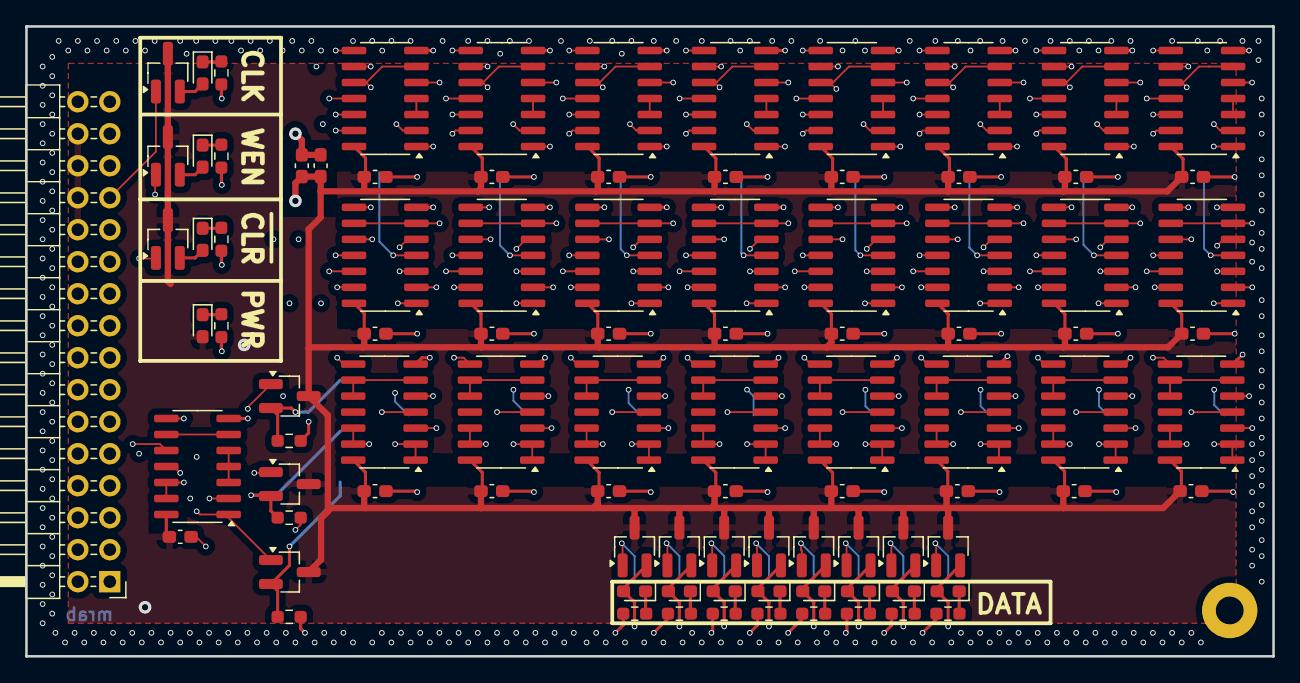
[picture p105: board register.kicad_pcb from above]

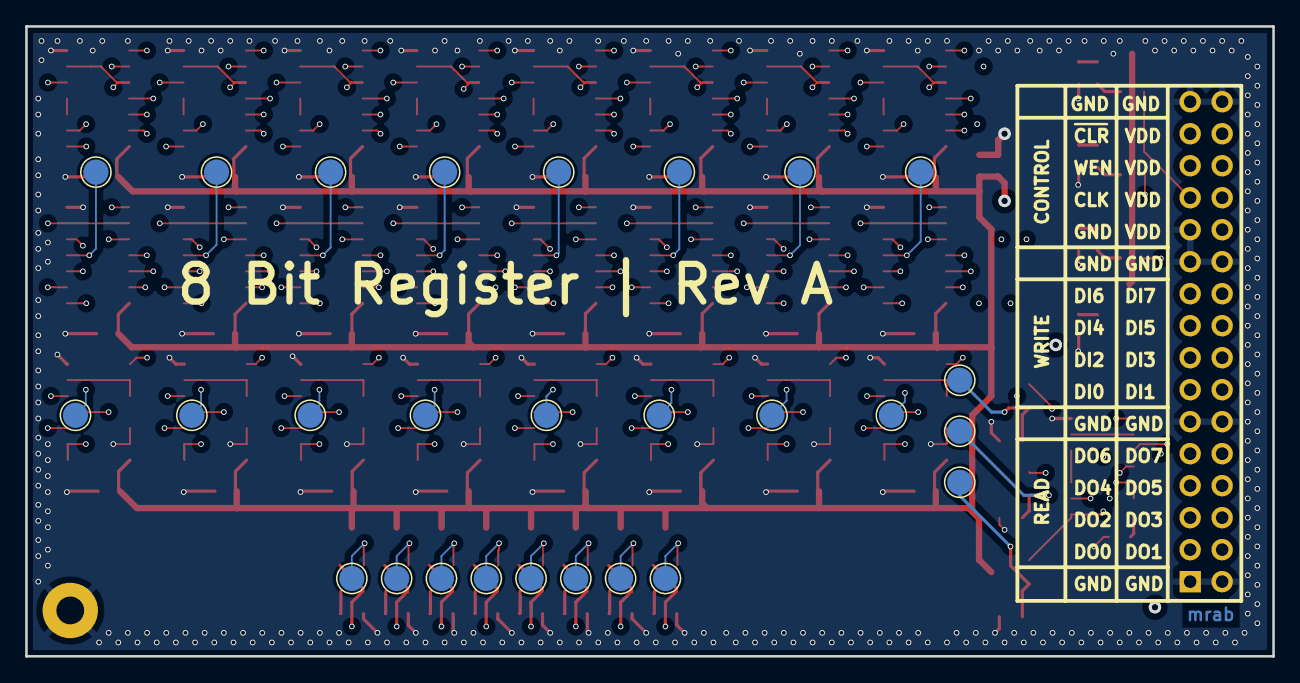
[picture p106: board register.kicad_pcb from below]

Board: 4 copper layers, 99.0 x 50.0 mm, 122 parts (27 on the bottom side), 131 nets.
