kantholz44mm/cpu/hardware/alu_shift/alu_shift.kicad_pcb

## KiCad design hardware/alu_shift/alu_shift.kicad_pcb (2025-02-12)

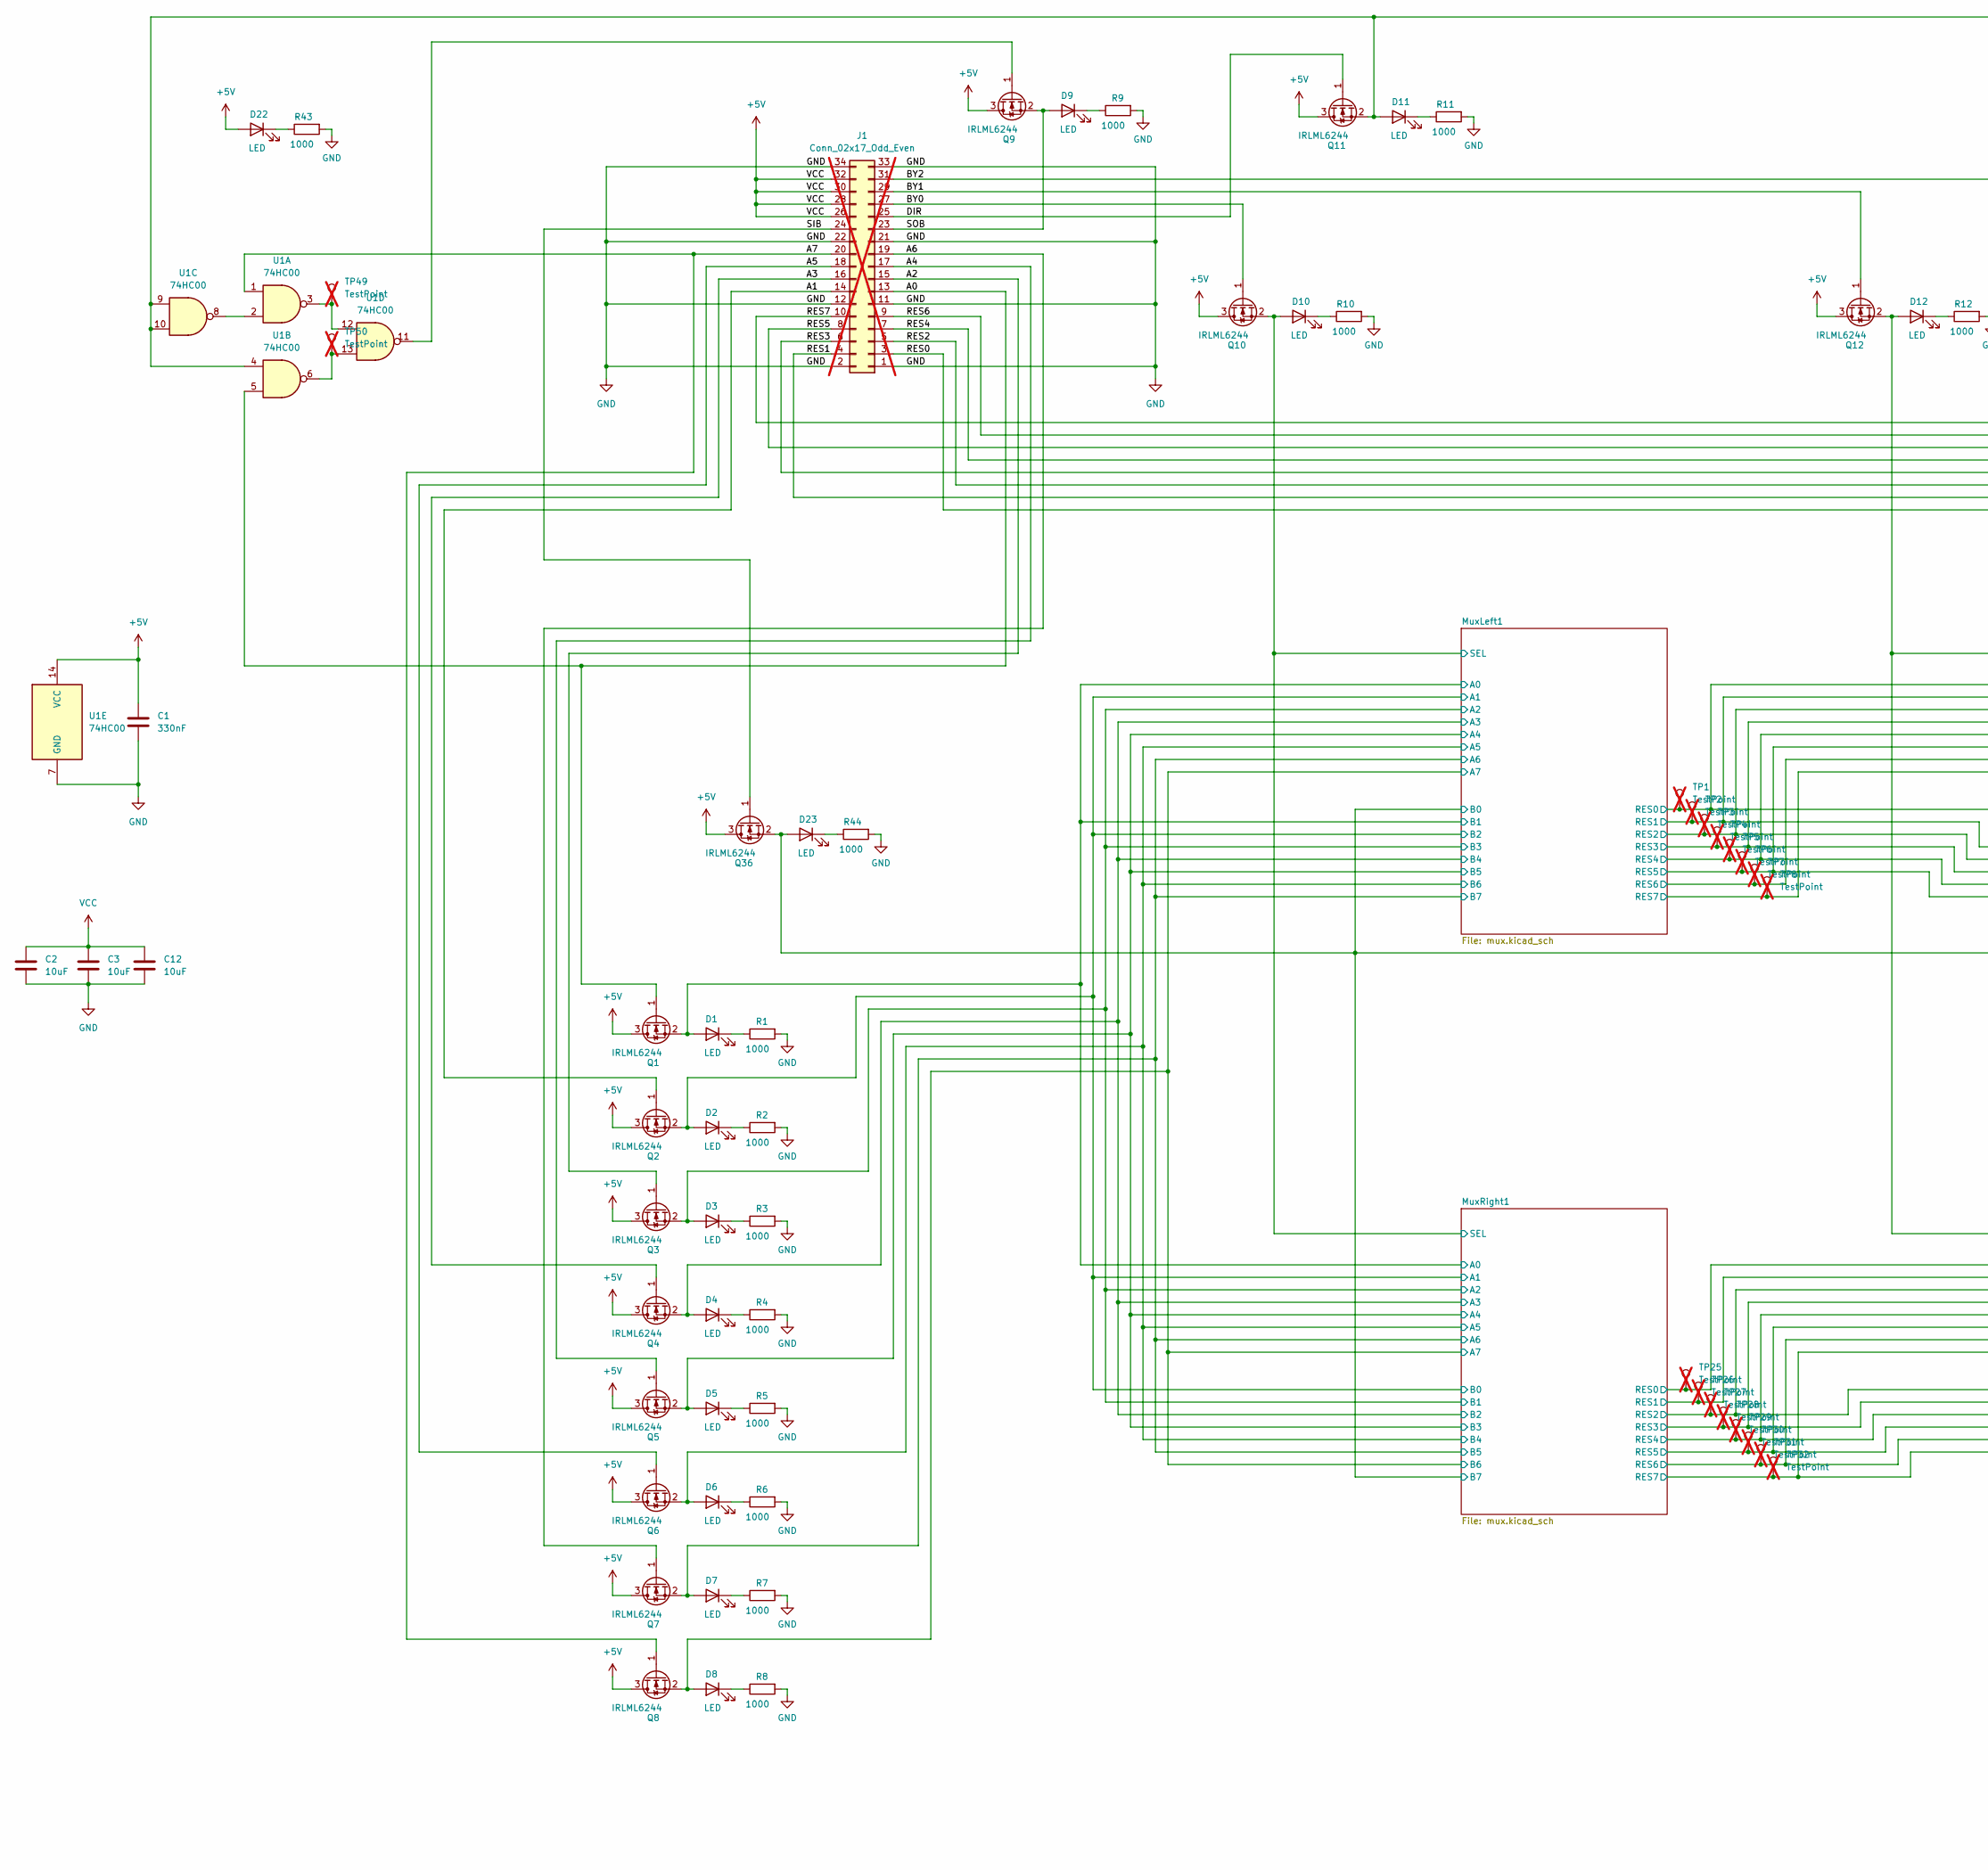
[picture p107: schematic alu_shift.kicad_sch, part in row 1, column 1]

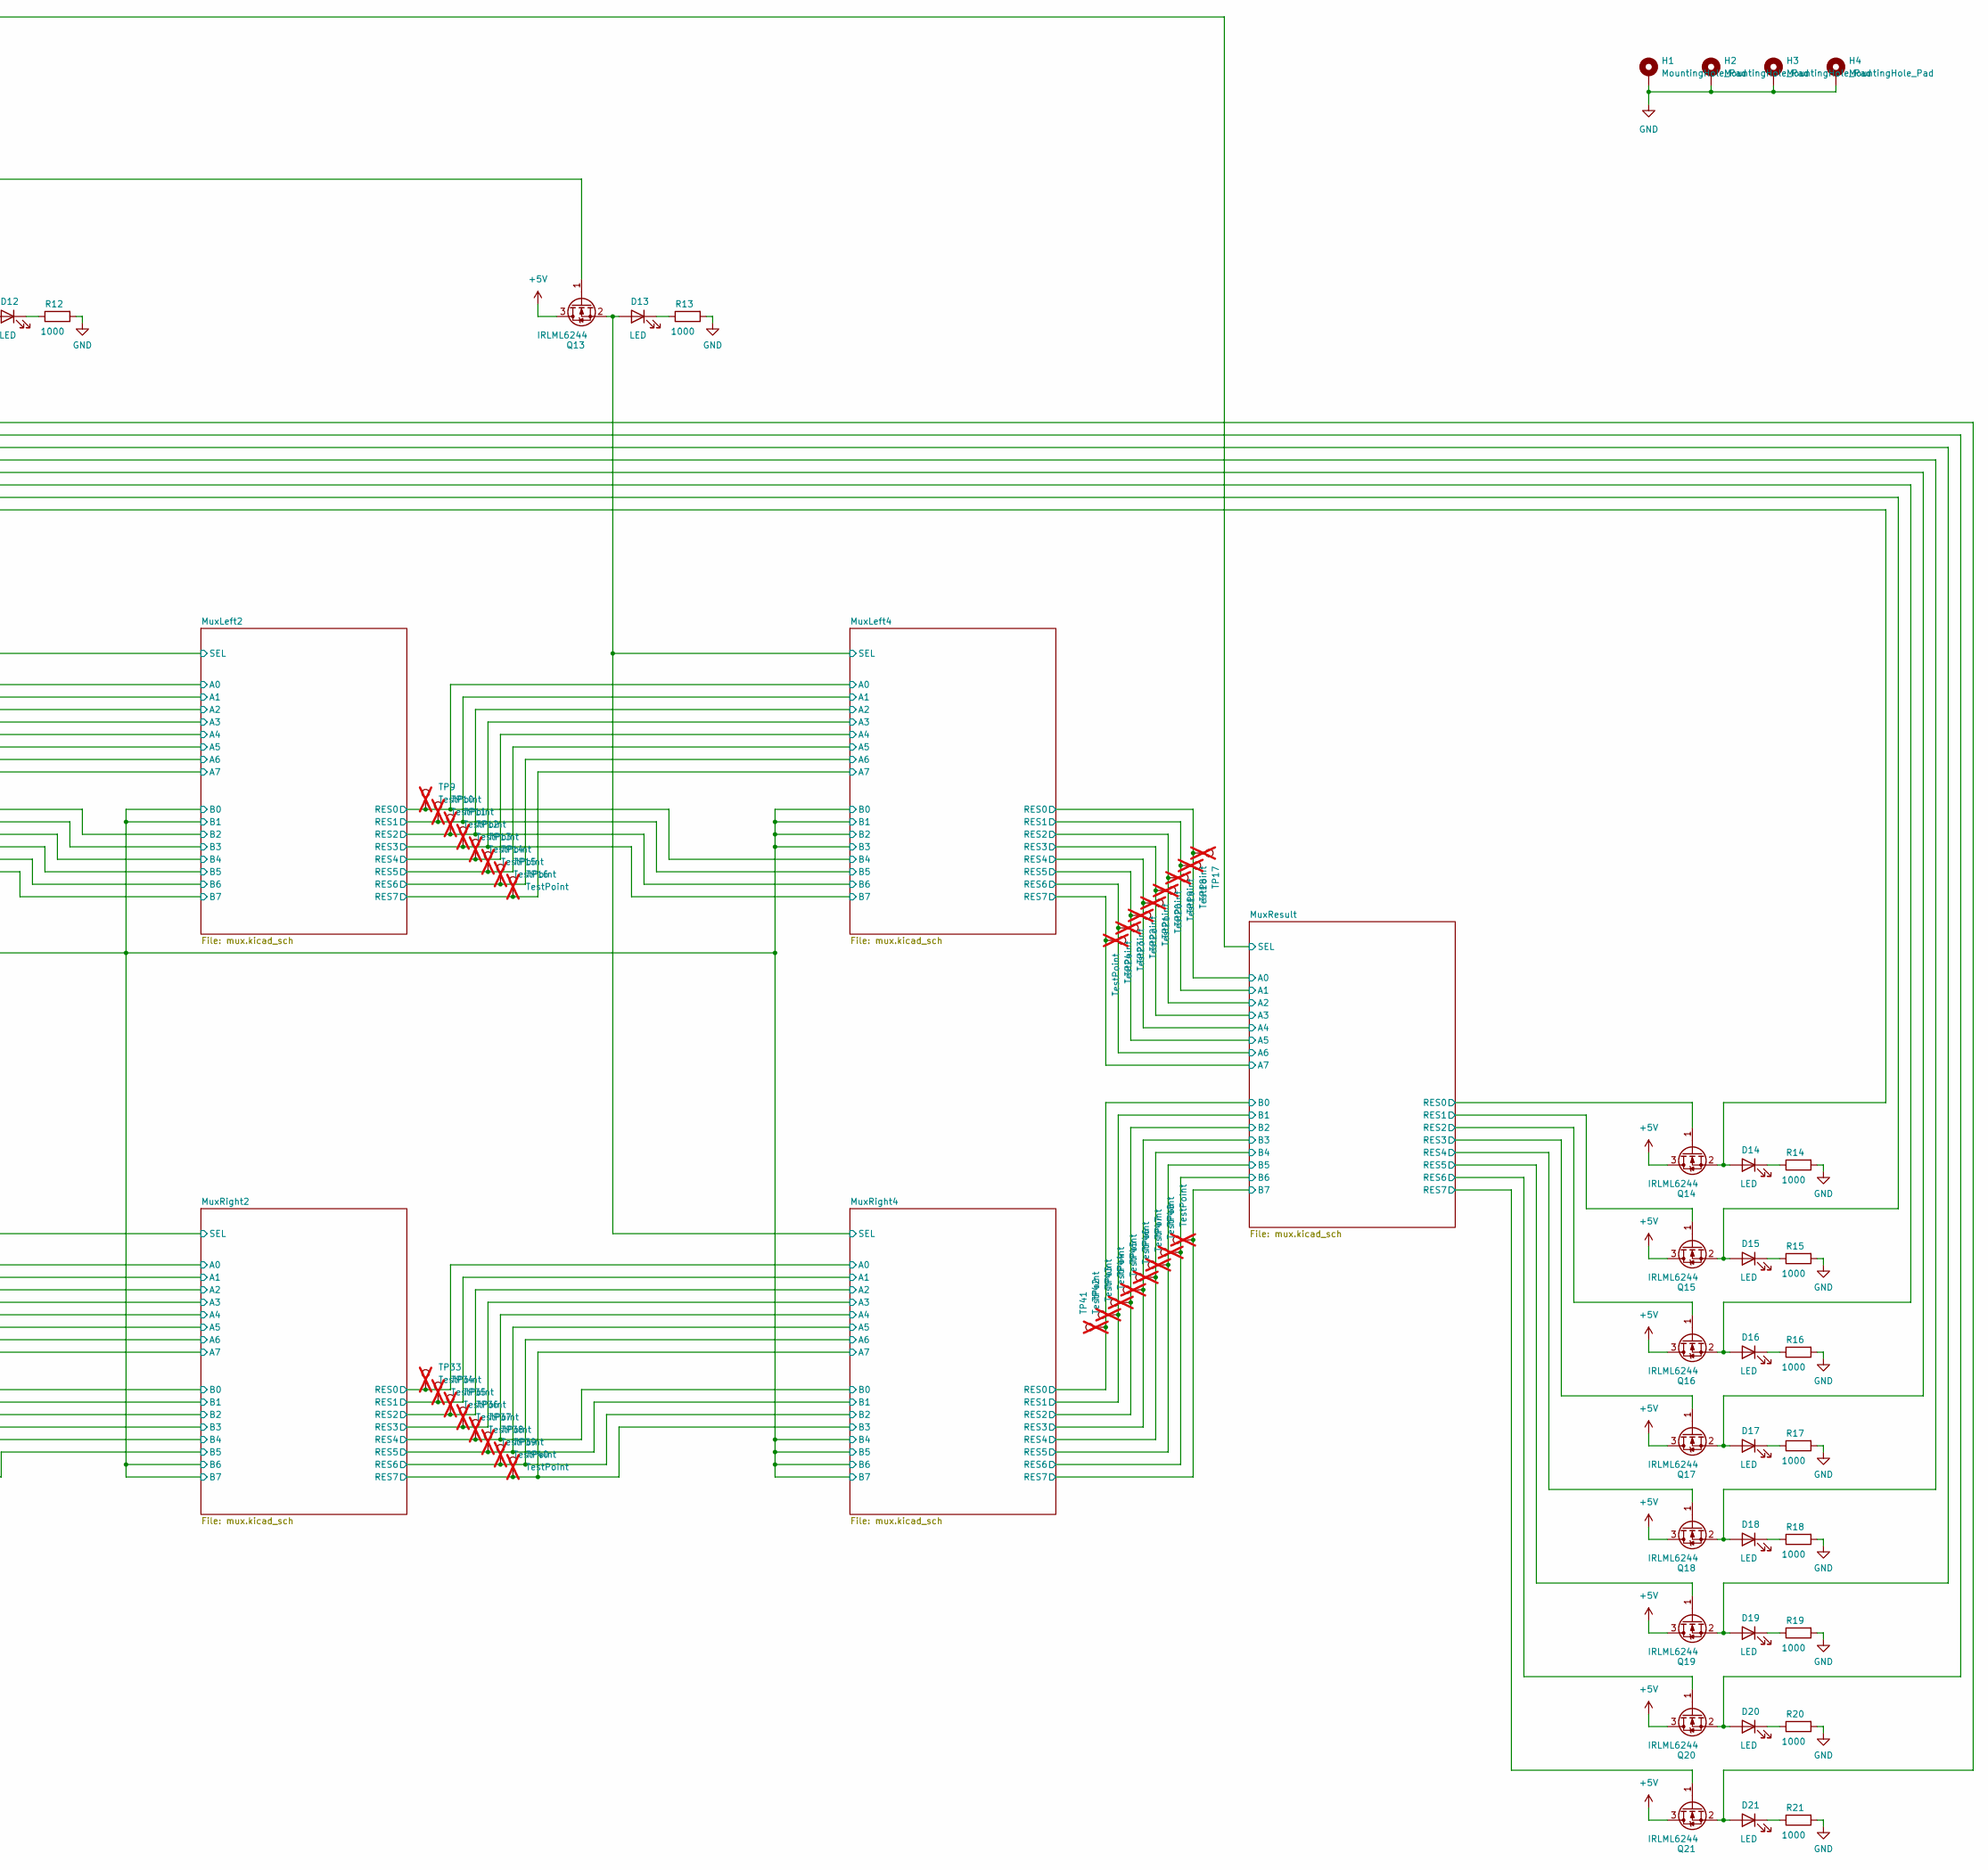
[picture p108: schematic alu_shift.kicad_sch, part in row 1, column 2]

Parts:
C1: 330nF; C_0603_1608Metric_Pad1.08x0.95mm_HandSolder; LCSC C2918485
C2, C3, C12: 10uF; C_0603_1608Metric_Pad1.08x0.95mm_HandSolder; LCSC C2909630
D1, D2, D3, D4, D5, D6, D7, D8, D9, D10, D11, D12, D13, D14, D15, D16, D17, D18, D19, D20, D21, D22, D23: LED; LED_0603_1608Metric_Pad1.05x0.95mm_HandSolder; LCSC C84267
H1, H2, H3, H4: MountingHole_Pad; MountingHole_2.2mm_M2_Pad
J1: Conn_02x17_Odd_Even; PinHeader_2x17_P2.54mm_Horizontal; not fitted
Q1, Q2, Q3, Q4, Q5, Q6, Q7, Q8, Q9, Q10, Q11, Q12, Q13, Q14, Q15, Q16, Q17, Q18, Q19, Q20, Q21, Q36: IRLML6244; SOT-23-3; LCSC C5123965
R1, R2, R3, R4, R5, R6, R7, R8, R9, R10, R11, R12, R13, R14, R15, R16, R17, R18, R19, R20, R21, R43, R44: 1000; R_0603_1608Metric_Pad0.98x0.95mm_HandSolder; LCSC C21190
TP1, TP2, TP3, TP4, TP5, TP6, TP7, TP8, TP9, TP10, TP11, TP12, TP13, TP14, TP15, TP16, TP17, TP18, TP19, TP20, TP21, TP22, TP23, TP24, TP25, TP26, TP27, TP28, TP29, TP30, TP31, TP32, TP33, TP34, TP35, TP36, TP37, TP38, TP39, TP40, TP41, TP42, TP43, TP44, TP45, TP46, TP47, TP48, TP49, TP50: TestPoint; TestPoint_Pad_D2.0mm; not fitted
U1: 74HC00; SOIC-14_3.9x8.7mm_P1.27mm; LCSC C5586

Connections:
+5V: C1.1, C2.1, C3.1, C12.1, D22.2 (A), J1.26, J1.28, J1.30, J1.32, Q1.3 (D), Q2.3 (D), Q3.3 (D), Q4.3 (D), Q5.3 (D), Q6.3 (D), Q7.3 (D), Q8.3 (D), Q9.3 (D), Q10.3 (D), Q11.3 (D), Q12.3 (D), Q13.3 (D), Q14.3 (D), Q15.3 (D), Q16.3 (D), Q17.3 (D), Q18.3 (D), Q19.3 (D), Q20.3 (D), Q21.3 (D), Q36.3 (D), U1.14 (VCC); also elsewhere on the board
/A0: J1.13, Q1.1 (G), U1.5
/A1: J1.14, Q2.1 (G)
/A2: J1.15, Q3.1 (G)
/A3: J1.16, Q4.1 (G)
/A4: J1.17, Q5.1 (G)
/A5: J1.18, Q6.1 (G)
/A6: J1.19, Q7.1 (G)
/A7: J1.20, Q8.1 (G), U1.1
/BY0: J1.27, Q10.1 (G)
/BY1: J1.29, Q12.1 (G)
/BY2: J1.31, Q13.1 (G)
/DIR: J1.25, Q11.1 (G)
/MuxLeft1/A0: D1.2 (A), Q1.2 (S); also elsewhere on the board
/MuxLeft1/A1: D2.2 (A), Q2.2 (S); also elsewhere on the board
/MuxLeft1/A2: D3.2 (A), Q3.2 (S); also elsewhere on the board
/MuxLeft1/A3: D4.2 (A), Q4.2 (S); also elsewhere on the board
/MuxLeft1/A4: D5.2 (A), Q5.2 (S); also elsewhere on the board
/MuxLeft1/A5: D6.2 (A), Q6.2 (S); also elsewhere on the board
/MuxLeft1/A6: D7.2 (A), Q7.2 (S); also elsewhere on the board
/MuxLeft1/A7: D8.2 (A), Q8.2 (S); also elsewhere on the board
/MuxLeft1/B0: D23.2 (A), Q36.2 (S); also elsewhere on the board
/MuxLeft1/RES0: TP1.1; also elsewhere on the board
/MuxLeft1/RES1: TP2.1; also elsewhere on the board
/MuxLeft1/RES2: TP3.1; also elsewhere on the board
/MuxLeft1/RES3: TP4.1; also elsewhere on the board
/MuxLeft1/RES4: TP5.1; also elsewhere on the board
/MuxLeft1/RES5: TP6.1; also elsewhere on the board
/MuxLeft1/RES6: TP7.1; also elsewhere on the board
/MuxLeft1/RES7: TP8.1; also elsewhere on the board
/MuxLeft1/SEL: D10.2 (A), Q10.2 (S); also elsewhere on the board
/MuxLeft2/RES0: TP9.1; also elsewhere on the board
/MuxLeft2/RES1: TP10.1; also elsewhere on the board
/MuxLeft2/RES2: TP11.1; also elsewhere on the board
/MuxLeft2/RES3: TP12.1; also elsewhere on the board
/MuxLeft2/RES4: TP13.1; also elsewhere on the board
/MuxLeft2/RES5: TP14.1; also elsewhere on the board
/MuxLeft2/RES6: TP15.1; also elsewhere on the board
/MuxLeft2/RES7: TP16.1; also elsewhere on the board
/MuxLeft2/SEL: D12.2 (A), Q12.2 (S); also elsewhere on the board
/MuxLeft4/RES0: TP17.1; also elsewhere on the board
/MuxLeft4/RES1: TP18.1; also elsewhere on the board
/MuxLeft4/RES2: TP19.1; also elsewhere on the board
/MuxLeft4/RES3: TP20.1; also elsewhere on the board
/MuxLeft4/RES4: TP21.1; also elsewhere on the board
/MuxLeft4/RES5: TP22.1; also elsewhere on the board
/MuxLeft4/RES6: TP23.1; also elsewhere on the board
/MuxLeft4/RES7: TP24.1; also elsewhere on the board
/MuxLeft4/SEL: D13.2 (A), Q13.2 (S); also elsewhere on the board
/MuxResult/B0: TP41.1; also elsewhere on the board
/MuxResult/B1: TP42.1; also elsewhere on the board
/MuxResult/B2: TP43.1; also elsewhere on the board
/MuxResult/B3: TP44.1; also elsewhere on the board
/MuxResult/B4: TP45.1; also elsewhere on the board
/MuxResult/B5: TP46.1; also elsewhere on the board
/MuxResult/B6: TP47.1; also elsewhere on the board
/MuxResult/B7: TP48.1; also elsewhere on the board
/MuxResult/RES0: Q14.1 (G); also elsewhere on the board
/MuxResult/RES1: Q15.1 (G); also elsewhere on the board
/MuxResult/RES2: Q16.1 (G); also elsewhere on the board
/MuxResult/RES3: Q17.1 (G); also elsewhere on the board
/MuxResult/RES4: Q18.1 (G); also elsewhere on the board
/MuxResult/RES5: Q19.1 (G); also elsewhere on the board
/MuxResult/RES6: Q20.1 (G); also elsewhere on the board
/MuxResult/RES7: Q21.1 (G); also elsewhere on the board
/MuxResult/SEL: D11.2 (A), Q11.2 (S), U1.4, U1.9, U1.10; also elsewhere on the board
/MuxRight1/RES0: TP25.1; also elsewhere on the board
/MuxRight1/RES1: TP26.1; also elsewhere on the board
/MuxRight1/RES2: TP27.1; also elsewhere on the board
/MuxRight1/RES3: TP28.1; also elsewhere on the board
/MuxRight1/RES4: TP29.1; also elsewhere on the board
/MuxRight1/RES5: TP30.1; also elsewhere on the board
/MuxRight1/RES6: TP31.1; also elsewhere on the board
/MuxRight1/RES7: TP32.1; also elsewhere on the board
/MuxRight2/RES0: TP33.1; also elsewhere on the board
/MuxRight2/RES1: TP34.1; also elsewhere on the board
/MuxRight2/RES2: TP35.1; also elsewhere on the board
/MuxRight2/RES3: TP36.1; also elsewhere on the board
/MuxRight2/RES4: TP37.1; also elsewhere on the board
/MuxRight2/RES5: TP38.1; also elsewhere on the board
/MuxRight2/RES6: TP39.1; also elsewhere on the board
/MuxRight2/RES7: TP40.1; also elsewhere on the board
/RES0: D14.2 (A), J1.3, Q14.2 (S)
/RES1: D15.2 (A), J1.4, Q15.2 (S)
/RES2: D16.2 (A), J1.5, Q16.2 (S)
/RES3: D17.2 (A), J1.6, Q17.2 (S)
/RES4: D18.2 (A), J1.7, Q18.2 (S)
/RES5: D19.2 (A), J1.8, Q19.2 (S)
/RES6: D20.2 (A), J1.9, Q20.2 (S)
/RES7: D21.2 (A), J1.10, Q21.2 (S)
/SIB: J1.24, Q36.1 (G)
/SOB: D9.2 (A), J1.23, Q9.2 (S)
GND: C1.2, C2.2, C3.2, C12.2, H1.1, H2.1, H3.1, H4.1, J1.1, J1.2, J1.11, J1.12, J1.21, J1.22, J1.33, J1.34, R1.2, R2.2, R3.2, R4.2, R5.2, R6.2, R7.2, R8.2, R9.2, R10.2, R11.2, R12.2, R13.2, R14.2, R15.2, R16.2, R17.2, R18.2, R19.2, R20.2, R21.2, R43.2, R44.2, U1.7 (GND); also elsewhere on the board
unnamed: D1.1 (K), R1.1
unnamed: D2.1 (K), R2.1
unnamed: D3.1 (K), R3.1
unnamed: D4.1 (K), R4.1
unnamed: D5.1 (K), R5.1
unnamed: D6.1 (K), R6.1
unnamed: D7.1 (K), R7.1
unnamed: D8.1 (K), R8.1
unnamed: D9.1 (K), R9.1
unnamed: D10.1 (K), R10.1
unnamed: D11.1 (K), R11.1
unnamed: D12.1 (K), R12.1
unnamed: D13.1 (K), R13.1
unnamed: D14.1 (K), R14.1
unnamed: D15.1 (K), R15.1
unnamed: D16.1 (K), R16.1
unnamed: D17.1 (K), R17.1
unnamed: D18.1 (K), R18.1
unnamed: D19.1 (K), R19.1
unnamed: D20.1 (K), R20.1
unnamed: D21.1 (K), R21.1
unnamed: D22.1 (K), R43.1
unnamed: D23.1 (K), R44.1
unnamed: Q9.1 (G), U1.11
unnamed: TP49.1, U1.3, U1.12
unnamed: TP50.1, U1.6, U1.13
unnamed: U1.2, U1.8
