kantholz44mm/cpu/hardware/alu_shift/alu_shift.kicad_pcb

## KiCad design hardware/alu_shift/alu_shift.kicad_pcb (continued)

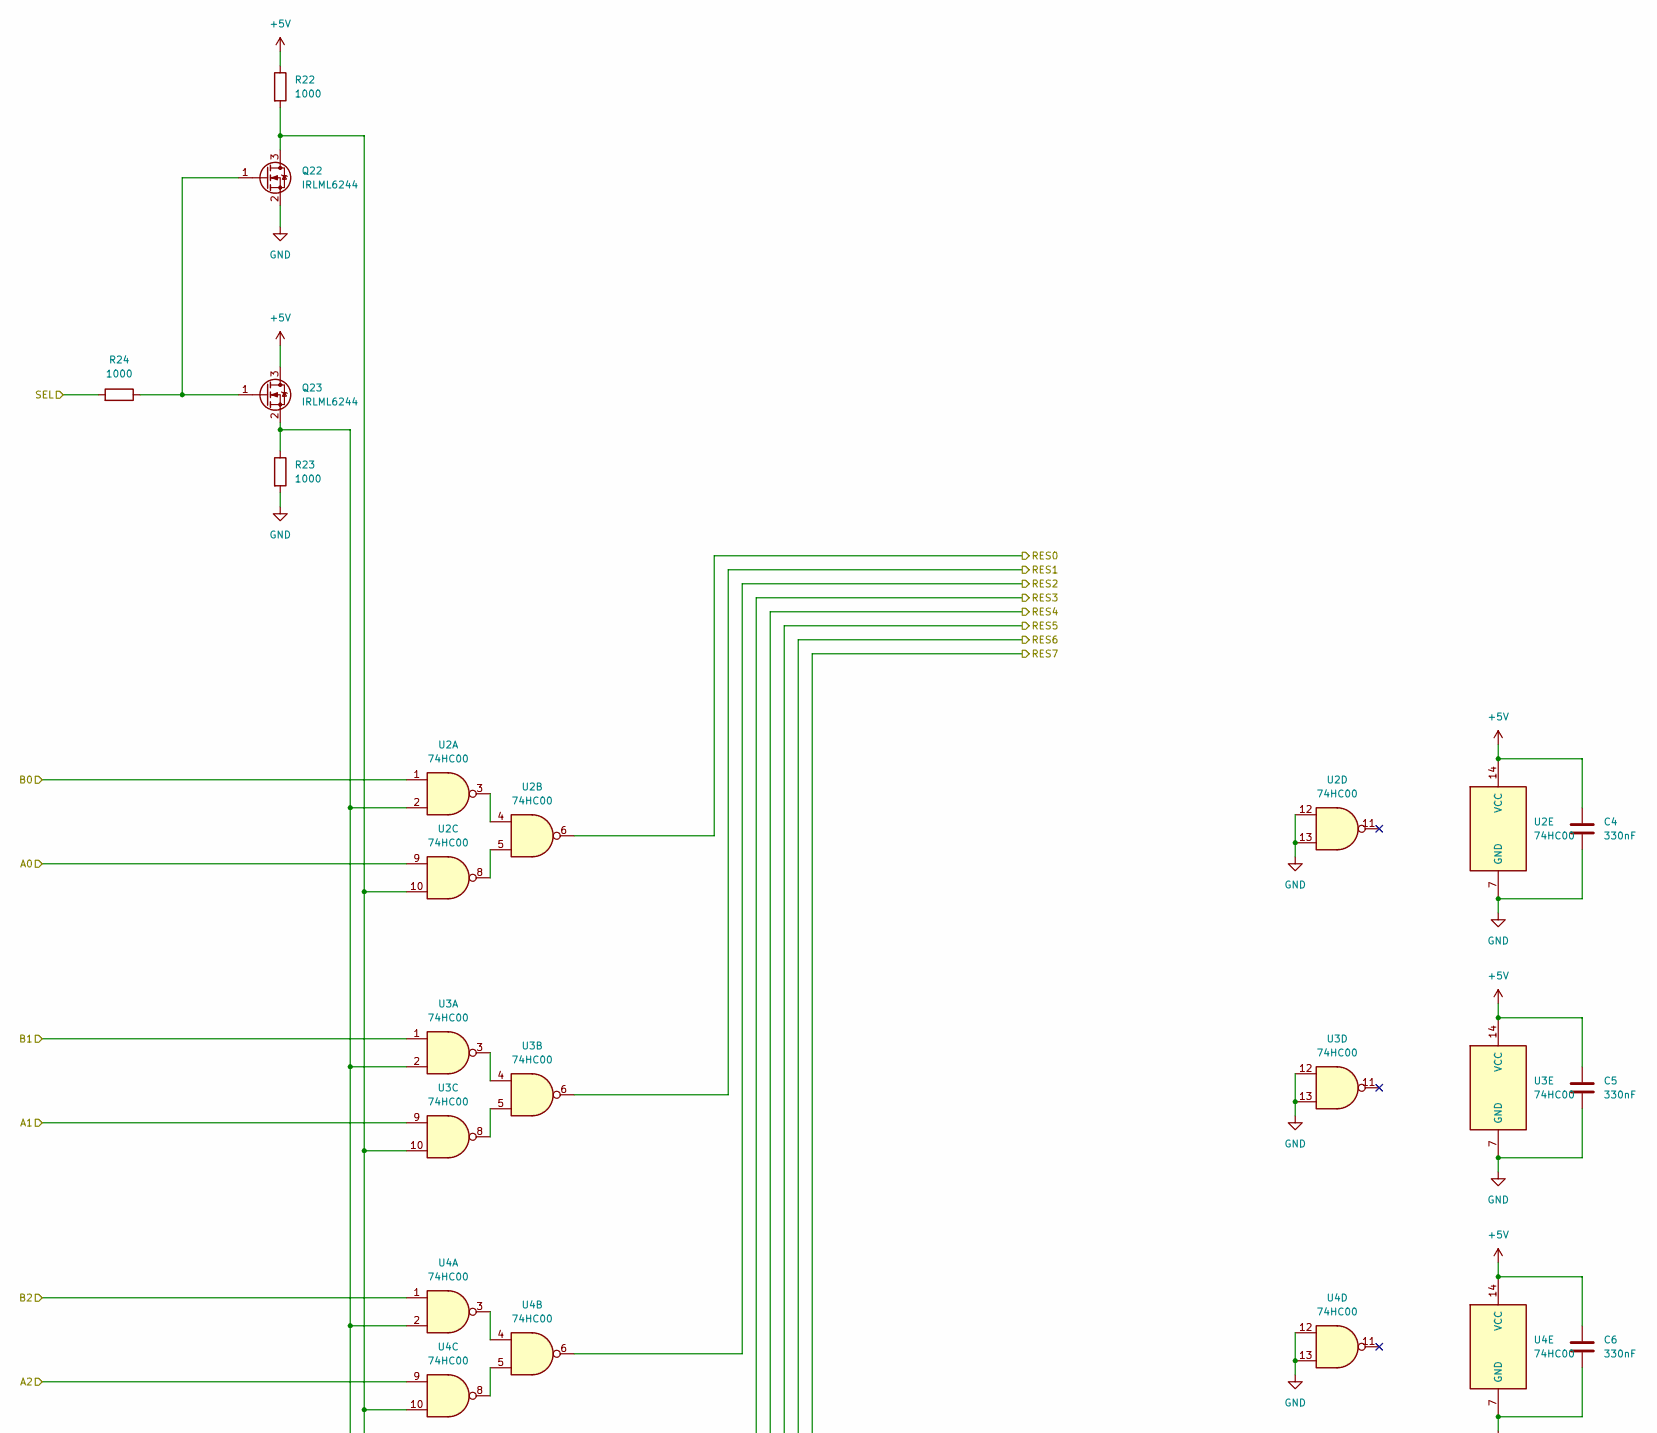
[picture p109: schematic mux.kicad_sch, part in row 1, column 1]

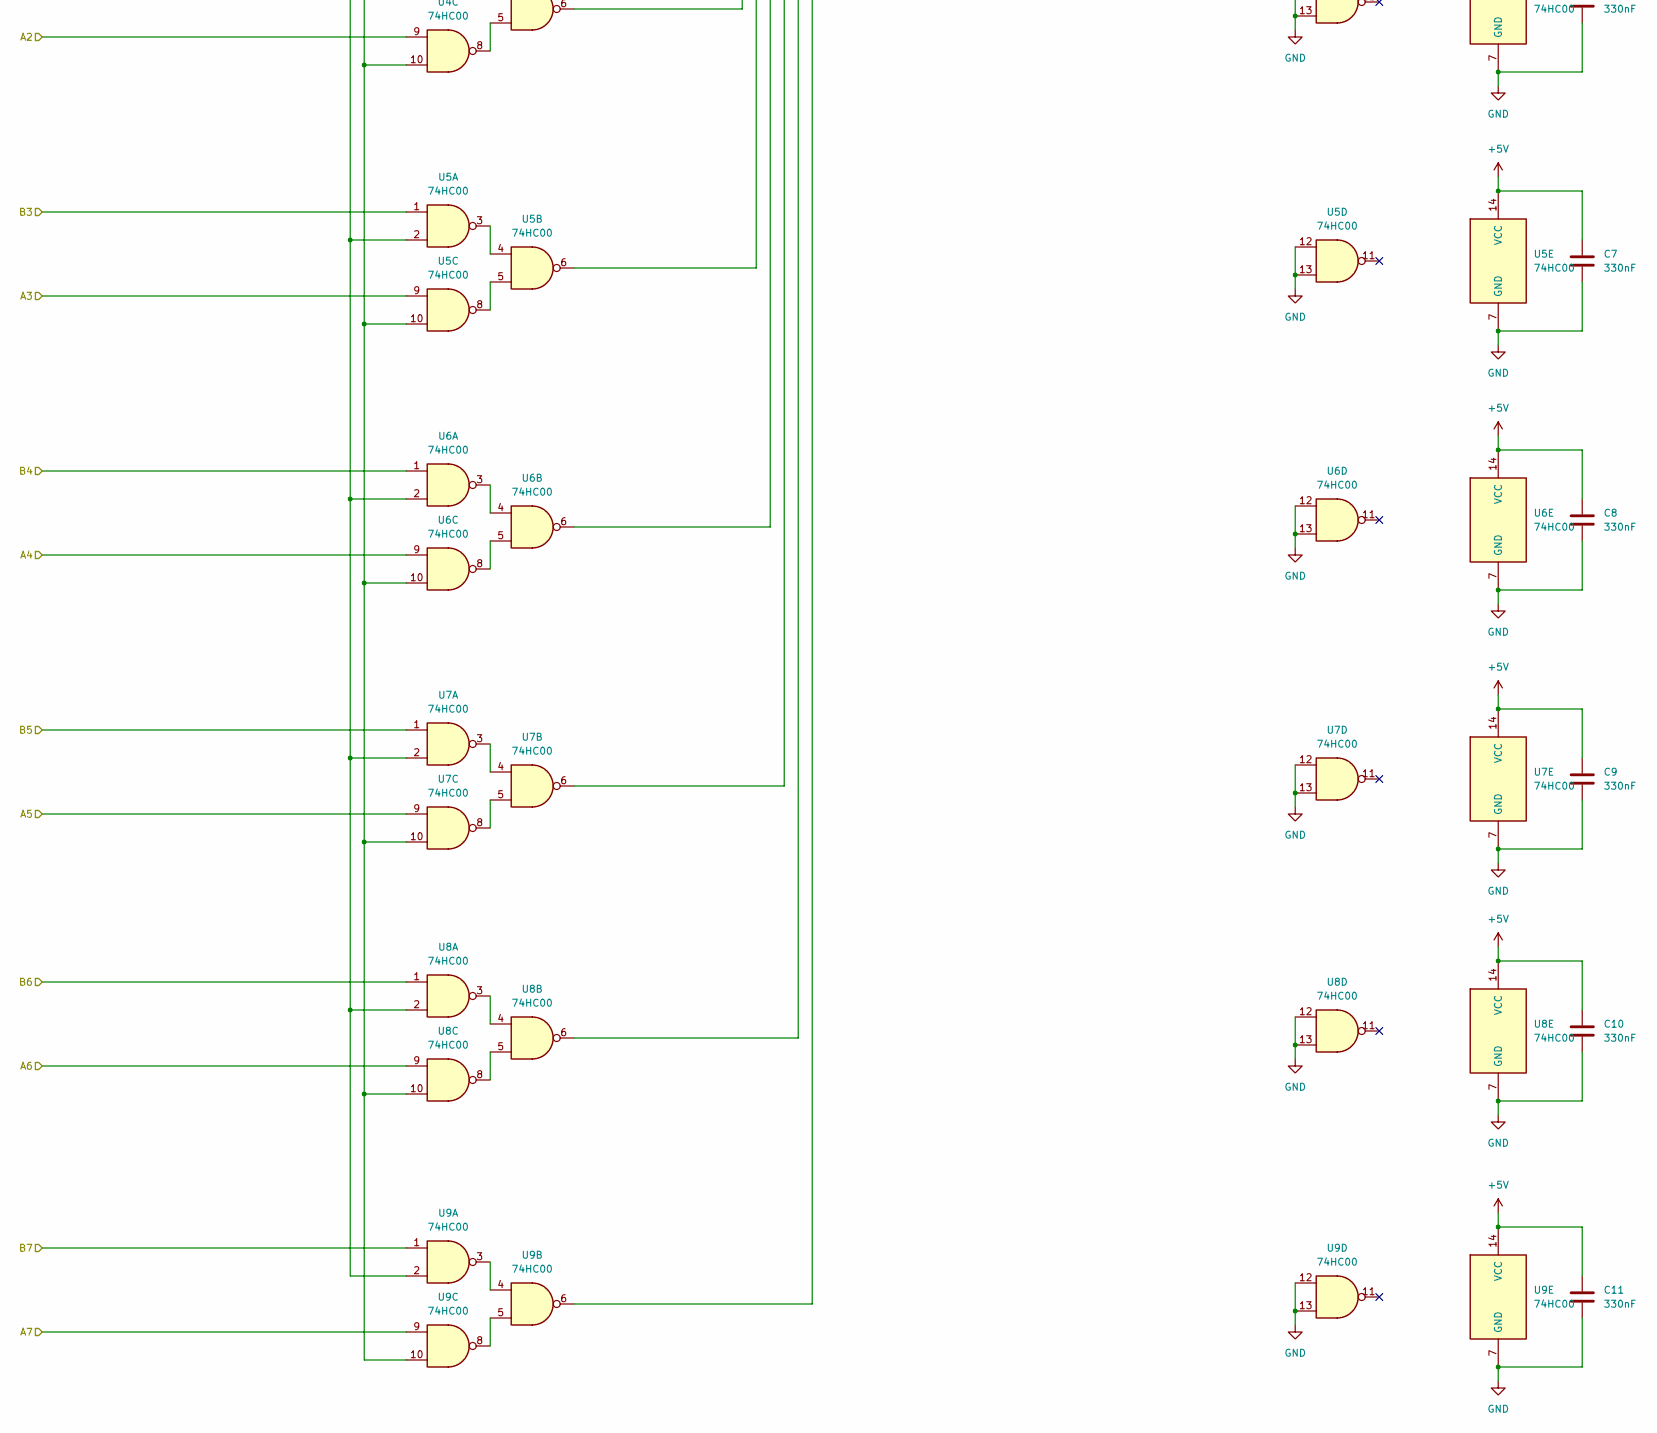
[picture p110: schematic mux.kicad_sch, part in row 2, column 1]

Parts:
C4, C5, C6, C7, C8, C9, C10, C11: 330nF; C_0603_1608Metric_Pad1.08x0.95mm_HandSolder; LCSC C2918485
Q22, Q23: IRLML6244; SOT-23-3; LCSC C5123965
R22, R23, R24: 1000; R_0603_1608Metric_Pad0.98x0.95mm_HandSolder; LCSC C21190
U2, U3, U4, U5, U6, U7, U8, U9: 74HC00; SOIC-14_3.9x8.7mm_P1.27mm; LCSC C5586

Connections:
+5V: C4.1, C5.1, C6.1, C7.1, C8.1, C9.1, C10.1, C11.1, Q23.3 (D), R22.1, U2.14 (VCC), U3.14 (VCC), U4.14 (VCC), U5.14 (VCC), U6.14 (VCC), U7.14 (VCC), U8.14 (VCC), U9.14 (VCC); also elsewhere on the board
/MuxLeft1/A0: U2.9, U3.1; also elsewhere on the board
/MuxLeft1/A1: U3.9, U4.1; also elsewhere on the board
/MuxLeft1/A2: U4.9, U5.1; also elsewhere on the board
/MuxLeft1/A3: U5.9, U6.1; also elsewhere on the board
/MuxLeft1/A4: U6.9, U7.1; also elsewhere on the board
/MuxLeft1/A5: U7.9, U8.1; also elsewhere on the board
/MuxLeft1/A6: U8.9, U9.1; also elsewhere on the board
/MuxLeft1/A7: U9.9; also elsewhere on the board
/MuxLeft1/B0: U2.1; also elsewhere on the board
/MuxLeft1/RES0: U2.6; also elsewhere on the board
/MuxLeft1/RES1: U3.6; also elsewhere on the board
/MuxLeft1/RES2: U4.6; also elsewhere on the board
/MuxLeft1/RES3: U5.6; also elsewhere on the board
/MuxLeft1/RES4: U6.6; also elsewhere on the board
/MuxLeft1/RES5: U7.6; also elsewhere on the board
/MuxLeft1/RES6: U8.6; also elsewhere on the board
/MuxLeft1/RES7: U9.6; also elsewhere on the board
/MuxLeft1/SEL: R24.2; also elsewhere on the board
GND: C4.2, C5.2, C6.2, C7.2, C8.2, C9.2, C10.2, C11.2, Q22.2 (S), R23.2, U2.7 (GND), U2.12, U2.13, U3.7 (GND), U3.12, U3.13, U4.7 (GND), U4.12, U4.13, U5.7 (GND), U5.12, U5.13, U6.7 (GND), U6.12, U6.13, U7.7 (GND), U7.12, U7.13, U8.7 (GND), U8.12, U8.13, U9.7 (GND), U9.12, U9.13; also elsewhere on the board
unnamed: Q22.3 (D), R22.2, U2.10, U3.10, U4.10, U5.10, U6.10, U7.10, U8.10, U9.10
unnamed: Q22.1 (G), Q23.1 (G), R24.1
unnamed: Q23.2 (S), R23.1, U2.2, U3.2, U4.2, U5.2, U6.2, U7.2, U8.2, U9.2
unnamed: U2.3, U2.4
unnamed: U2.5, U2.8
unnamed: U3.3, U3.4
unnamed: U3.5, U3.8
unnamed: U4.3, U4.4
unnamed: U4.5, U4.8
unnamed: U5.3, U5.4
unnamed: U5.5, U5.8
unnamed: U6.3, U6.4
unnamed: U6.5, U6.8
unnamed: U7.3, U7.4
unnamed: U7.5, U7.8
unnamed: U8.3, U8.4
unnamed: U8.5, U8.8
unnamed: U9.3, U9.4
unnamed: U9.5, U9.8

Parts of its further copies:
C14, C15, C16, C17, C18, C19, C20, C21, C24, C25, C26, C27, C28, C29, C30, C31, C34, C35, C36, C37, C38, C39, C40, C41, C44, C45, C46, C47, C48, C49, C50, C51, C54, C55, C56, C57, C58, C59, C60, C61, C64, C65, C66, C67, C68, C69, C70, C71: 330nF; C_0603_1608Metric_Pad1.08x0.95mm_HandSolder; LCSC C2918485
Q24, Q25, Q26, Q27, Q28, Q29, Q30, Q31, Q32, Q33, Q34, Q35: IRLML6244; SOT-23-3; LCSC C5123965
R25, R26, R27, R28, R29, R30, R31, R32, R33, R34, R35, R36, R37, R38, R39, R40, R41, R42: 1000; R_0603_1608Metric_Pad0.98x0.95mm_HandSolder; LCSC C21190
U10, U11, U12, U13, U14, U15, U16, U17, U18, U19, U20, U21, U22, U23, U24, U25, U26, U27, U28, U29, U30, U31, U32, U33, U34, U35, U36, U37, U38, U39, U40, U41, U42, U43, U44, U45, U46, U47, U48, U49, U50, U51, U52, U53, U54, U55, U56, U57: 74HC00; SOIC-14_3.9x8.7mm_P1.27mm; LCSC C5586

Connections of its further copies:
+5V: C14.1, C15.1, C16.1, C17.1, C18.1, C19.1, C20.1, C21.1, C24.1, C25.1, C26.1, C27.1, C28.1, C29.1, C30.1, C31.1, C34.1, C35.1, C36.1, C37.1, C38.1, C39.1, C40.1, C41.1, C44.1, C45.1, C46.1, C47.1, C48.1, C49.1, C50.1, C51.1, C54.1, C55.1, C56.1, C57.1, C58.1, C59.1, C60.1, C61.1, C64.1, C65.1, C66.1, C67.1, C68.1, C69.1, C70.1, C71.1, Q25.3 (D), Q27.3 (D), Q29.3 (D), Q31.3 (D), Q33.3 (D), Q35.3 (D), R25.1, R28.1, R31.1, R34.1, R37.1, R40.1, U10.14 (VCC), U11.14 (VCC), U12.14 (VCC), U13.14 (VCC), U14.14 (VCC), U15.14 (VCC), U16.14 (VCC), U17.14 (VCC), U18.14 (VCC), U19.14 (VCC), U20.14 (VCC), U21.14 (VCC), U22.14 (VCC), U23.14 (VCC), U24.14 (VCC), U25.14 (VCC), U26.14 (VCC), U27.14 (VCC), U28.14 (VCC), U29.14 (VCC), U30.14 (VCC), U31.14 (VCC), U32.14 (VCC), U33.14 (VCC), U34.14 (VCC), U35.14 (VCC), U36.14 (VCC), U37.14 (VCC), U38.14 (VCC), U39.14 (VCC), U40.14 (VCC), U41.14 (VCC), U42.14 (VCC), U43.14 (VCC), U44.14 (VCC), U45.14 (VCC), U46.14 (VCC), U47.14 (VCC), U48.14 (VCC), U49.14 (VCC), U50.14 (VCC), U51.14 (VCC), U52.14 (VCC), U53.14 (VCC), U54.14 (VCC), U55.14 (VCC), U56.14 (VCC), U57.14 (VCC); also elsewhere on the board
/MuxLeft1/A0: U10.9; also elsewhere on the board
/MuxLeft1/A1: U10.1, U11.9; also elsewhere on the board
/MuxLeft1/A2: U11.1, U12.9; also elsewhere on the board
/MuxLeft1/A3: U12.1, U13.9; also elsewhere on the board
/MuxLeft1/A4: U13.1, U14.9; also elsewhere on the board
/MuxLeft1/A5: U14.1, U15.9; also elsewhere on the board
/MuxLeft1/A6: U15.1, U16.9; also elsewhere on the board
/MuxLeft1/A7: U16.1, U17.9; also elsewhere on the board
/MuxLeft1/B0: U17.1, U24.1, U25.1, U30.1, U31.1, U32.1, U33.1, U42.1, U43.1, U44.1, U45.1, U50.1, U51.1; also elsewhere on the board
/MuxLeft1/RES0: U50.9, U52.1; also elsewhere on the board
/MuxLeft1/RES1: U51.9, U53.1; also elsewhere on the board
/MuxLeft1/RES2: U52.9, U54.1; also elsewhere on the board
/MuxLeft1/RES3: U53.9, U55.1; also elsewhere on the board
/MuxLeft1/RES4: U54.9, U56.1; also elsewhere on the board
/MuxLeft1/RES5: U55.9, U57.1; also elsewhere on the board
/MuxLeft1/RES6: U56.9; also elsewhere on the board
/MuxLeft1/RES7: U57.9; also elsewhere on the board
/MuxLeft1/SEL: R27.2; also elsewhere on the board
/MuxLeft2/RES0: U42.9, U46.1, U50.6; also elsewhere on the board
/MuxLeft2/RES1: U43.9, U47.1, U51.6; also elsewhere on the board
/MuxLeft2/RES2: U44.9, U48.1, U52.6; also elsewhere on the board
/MuxLeft2/RES3: U45.9, U49.1, U53.6; also elsewhere on the board
/MuxLeft2/RES4: U46.9, U54.6; also elsewhere on the board
/MuxLeft2/RES5: U47.9, U55.6; also elsewhere on the board
/MuxLeft2/RES6: U48.9, U56.6; also elsewhere on the board
/MuxLeft2/RES7: U49.9, U57.6; also elsewhere on the board
/MuxLeft2/SEL: R30.2, R42.2; also elsewhere on the board
/MuxLeft4/RES0: U34.9, U42.6; also elsewhere on the board
/MuxLeft4/RES1: U35.9, U43.6; also elsewhere on the board
/MuxLeft4/RES2: U36.9, U44.6; also elsewhere on the board
/MuxLeft4/RES3: U37.9, U45.6; also elsewhere on the board
/MuxLeft4/RES4: U38.9, U46.6; also elsewhere on the board
/MuxLeft4/RES5: U39.9, U47.6; also elsewhere on the board
/MuxLeft4/RES6: U40.9, U48.6; also elsewhere on the board
/MuxLeft4/RES7: U41.9, U49.6; also elsewhere on the board
/MuxLeft4/SEL: R33.2, R39.2; also elsewhere on the board
/MuxResult/B0: U26.6, U34.1; also elsewhere on the board
/MuxResult/B1: U27.6, U35.1; also elsewhere on the board
/MuxResult/B2: U28.6, U36.1; also elsewhere on the board
/MuxResult/B3: U29.6, U37.1; also elsewhere on the board
/MuxResult/B4: U30.6, U38.1; also elsewhere on the board
/MuxResult/B5: U31.6, U39.1; also elsewhere on the board
/MuxResult/B6: U32.6, U40.1; also elsewhere on the board
/MuxResult/B7: U33.6, U41.1; also elsewhere on the board
/MuxResult/RES0: U34.6; also elsewhere on the board
/MuxResult/RES1: U35.6; also elsewhere on the board
/MuxResult/RES2: U36.6; also elsewhere on the board
/MuxResult/RES3: U37.6; also elsewhere on the board
/MuxResult/RES4: U38.6; also elsewhere on the board
/MuxResult/RES5: U39.6; also elsewhere on the board
/MuxResult/RES6: U40.6; also elsewhere on the board
/MuxResult/RES7: U41.6; also elsewhere on the board
/MuxResult/SEL: R36.2; also elsewhere on the board
/MuxRight1/RES0: U10.6, U18.9; also elsewhere on the board
/MuxRight1/RES1: U11.6, U19.9; also elsewhere on the board
/MuxRight1/RES2: U12.6, U18.1, U20.9; also elsewhere on the board
/MuxRight1/RES3: U13.6, U19.1, U21.9; also elsewhere on the board
/MuxRight1/RES4: U14.6, U20.1, U22.9; also elsewhere on the board
/MuxRight1/RES5: U15.6, U21.1, U23.9; also elsewhere on the board
/MuxRight1/RES6: U16.6, U22.1, U24.9; also elsewhere on the board
/MuxRight1/RES7: U17.6, U23.1, U25.9; also elsewhere on the board
/MuxRight2/RES0: U18.6, U26.9; also elsewhere on the board
/MuxRight2/RES1: U19.6, U27.9; also elsewhere on the board
/MuxRight2/RES2: U20.6, U28.9; also elsewhere on the board
/MuxRight2/RES3: U21.6, U29.9; also elsewhere on the board
/MuxRight2/RES4: U22.6, U26.1, U30.9; also elsewhere on the board
/MuxRight2/RES5: U23.6, U27.1, U31.9; also elsewhere on the board
/MuxRight2/RES6: U24.6, U28.1, U32.9; also elsewhere on the board
/MuxRight2/RES7: U25.6, U29.1, U33.9; also elsewhere on the board
GND: C14.2, C15.2, C16.2, C17.2, C18.2, C19.2, C20.2, C21.2, C24.2, C25.2, C26.2, C27.2, C28.2, C29.2, C30.2, C31.2, C34.2, C35.2, C36.2, C37.2, C38.2, C39.2, C40.2, C41.2, C44.2, C45.2, C46.2, C47.2, C48.2, C49.2, C50.2, C51.2, C54.2, C55.2, C56.2, C57.2, C58.2, C59.2, C60.2, C61.2, C64.2, C65.2, C66.2, C67.2, C68.2, C69.2, C70.2, C71.2, Q24.2 (S), Q26.2 (S), Q28.2 (S), Q30.2 (S), Q32.2 (S), Q34.2 (S), R26.2, R29.2, R32.2, R35.2, R38.2, R41.2, U10.7 (GND), U10.12, U10.13, U11.7 (GND), U11.12, U11.13, U12.7 (GND), U12.12, U12.13, U13.7 (GND), U13.12, U13.13, U14.7 (GND), U14.12, U14.13, U15.7 (GND), U15.12, U15.13, U16.7 (GND), U16.12, U16.13, U17.7 (GND), U17.12, U17.13, U18.7 (GND), U18.12, U18.13, U19.7 (GND), U19.12, U19.13, U20.7 (GND), U20.12, U20.13, U21.7 (GND), U21.12, U21.13, U22.7 (GND), U22.12, U22.13, U23.7 (GND), U23.12, U23.13, U24.7 (GND), U24.12, U24.13, U25.7 (GND), U25.12, U25.13, U26.7 (GND), U26.12, U26.13, U27.7 (GND), U27.12, U27.13, U28.7 (GND), U28.12, U28.13, U29.7 (GND), U29.12, U29.13, U30.7 (GND), U30.12, U30.13, U31.7 (GND), U31.12, U31.13, U32.7 (GND), U32.12, U32.13, U33.7 (GND), U33.12, U33.13, U34.7 (GND), U34.12, U34.13, U35.7 (GND), U35.12, U35.13, U36.7 (GND), U36.12, U36.13, U37.7 (GND), U37.12, U37.13, U38.7 (GND), U38.12, U38.13, U39.7 (GND), U39.12, U39.13, U40.7 (GND), U40.12, U40.13, U41.7 (GND), U41.12, U41.13, U42.7 (GND), U42.12, U42.13, U43.7 (GND), U43.12, U43.13, U44.7 (GND), U44.12, U44.13, U45.7 (GND), U45.12, U45.13, U46.7 (GND), U46.12, U46.13, U47.7 (GND), U47.12, U47.13, U48.7 (GND), U48.12, U48.13, U49.7 (GND), U49.12, U49.13, U50.7 (GND), U50.12, U50.13, U51.7 (GND), U51.12, U51.13, U52.7 (GND), U52.12, U52.13, U53.7 (GND), U53.12, U53.13, U54.7 (GND), U54.12, U54.13, U55.7 (GND), U55.12, U55.13, U56.7 (GND), U56.12, U56.13, U57.7 (GND), U57.12, U57.13; also elsewhere on the board
unnamed: Q24.3 (D), R25.2, U10.10, U11.10, U12.10, U13.10, U14.10, U15.10, U16.10, U17.10
unnamed: Q24.1 (G), Q25.1 (G), R27.1
unnamed: Q25.2 (S), R26.1, U10.2, U11.2, U12.2, U13.2, U14.2, U15.2, U16.2, U17.2
unnamed: Q26.3 (D), R28.2, U18.10, U19.10, U20.10, U21.10, U22.10, U23.10, U24.10, U25.10
unnamed: Q26.1 (G), Q27.1 (G), R30.1
unnamed: Q27.2 (S), R29.1, U18.2, U19.2, U20.2, U21.2, U22.2, U23.2, U24.2, U25.2
unnamed: Q28.3 (D), R31.2, U26.10, U27.10, U28.10, U29.10, U30.10, U31.10, U32.10, U33.10
unnamed: Q28.1 (G), Q29.1 (G), R33.1
unnamed: Q29.2 (S), R32.1, U26.2, U27.2, U28.2, U29.2, U30.2, U31.2, U32.2, U33.2
unnamed: Q30.3 (D), R34.2, U34.10, U35.10, U36.10, U37.10, U38.10, U39.10, U40.10, U41.10
unnamed: Q30.1 (G), Q31.1 (G), R36.1
unnamed: Q31.2 (S), R35.1, U34.2, U35.2, U36.2, U37.2, U38.2, U39.2, U40.2, U41.2
unnamed: Q32.3 (D), R37.2, U42.10, U43.10, U44.10, U45.10, U46.10, U47.10, U48.10, U49.10
unnamed: Q32.1 (G), Q33.1 (G), R39.1
unnamed: Q33.2 (S), R38.1, U42.2, U43.2, U44.2, U45.2, U46.2, U47.2, U48.2, U49.2
unnamed: Q34.3 (D), R40.2, U50.10, U51.10, U52.10, U53.10, U54.10, U55.10, U56.10, U57.10
unnamed: Q34.1 (G), Q35.1 (G), R42.1
unnamed: Q35.2 (S), R41.1, U50.2, U51.2, U52.2, U53.2, U54.2, U55.2, U56.2, U57.2
unnamed: U10.3, U10.4
unnamed: U10.5, U10.8
unnamed: U11.3, U11.4
unnamed: U11.5, U11.8
unnamed: U12.3, U12.4
unnamed: U12.5, U12.8
unnamed: U13.3, U13.4
unnamed: U13.5, U13.8
unnamed: U14.3, U14.4
unnamed: U14.5, U14.8
unnamed: U15.3, U15.4
unnamed: U15.5, U15.8
unnamed: U16.3, U16.4
unnamed: U16.5, U16.8
unnamed: U17.3, U17.4
unnamed: U17.5, U17.8
unnamed: U18.3, U18.4
unnamed: U18.5, U18.8
unnamed: U19.3, U19.4
unnamed: U19.5, U19.8
unnamed: U20.3, U20.4
unnamed: U20.5, U20.8
unnamed: U21.3, U21.4
unnamed: U21.5, U21.8
unnamed: U22.3, U22.4
unnamed: U22.5, U22.8
unnamed: U23.3, U23.4
unnamed: U23.5, U23.8
unnamed: U24.3, U24.4
unnamed: U24.5, U24.8
unnamed: U25.3, U25.4
unnamed: U25.5, U25.8
unnamed: U26.3, U26.4
unnamed: U26.5, U26.8
unnamed: U27.3, U27.4
unnamed: U27.5, U27.8
unnamed: U28.3, U28.4
unnamed: U28.5, U28.8
unnamed: U29.3, U29.4
unnamed: U29.5, U29.8
unnamed: U30.3, U30.4
unnamed: U30.5, U30.8
unnamed: U31.3, U31.4
unnamed: U31.5, U31.8
unnamed: U32.3, U32.4
unnamed: U32.5, U32.8
unnamed: U33.3, U33.4
unnamed: U33.5, U33.8
unnamed: U34.3, U34.4
unnamed: U34.5, U34.8
unnamed: U35.3, U35.4
unnamed: U35.5, U35.8
unnamed: U36.3, U36.4
unnamed: U36.5, U36.8
unnamed: U37.3, U37.4
unnamed: U37.5, U37.8
unnamed: U38.3, U38.4
unnamed: U38.5, U38.8
unnamed: U39.3, U39.4
unnamed: U39.5, U39.8
unnamed: U40.3, U40.4
unnamed: U40.5, U40.8
unnamed: U41.3, U41.4
unnamed: U41.5, U41.8
unnamed: U42.3, U42.4
unnamed: U42.5, U42.8
unnamed: U43.3, U43.4
unnamed: U43.5, U43.8
unnamed: U44.3, U44.4
unnamed: U44.5, U44.8
unnamed: U45.3, U45.4
unnamed: U45.5, U45.8
unnamed: U46.3, U46.4
unnamed: U46.5, U46.8
unnamed: U47.3, U47.4
unnamed: U47.5, U47.8
unnamed: U48.3, U48.4
unnamed: U48.5, U48.8
unnamed: U49.3, U49.4
unnamed: U49.5, U49.8
unnamed: U50.3, U50.4
unnamed: U50.5, U50.8
unnamed: U51.3, U51.4
unnamed: U51.5, U51.8
unnamed: U52.3, U52.4
unnamed: U52.5, U52.8
unnamed: U53.3, U53.4
unnamed: U53.5, U53.8
unnamed: U54.3, U54.4
unnamed: U54.5, U54.8
unnamed: U55.3, U55.4
unnamed: U55.5, U55.8
unnamed: U56.3, U56.4
unnamed: U56.5, U56.8
unnamed: U57.3, U57.4
unnamed: U57.5, U57.8

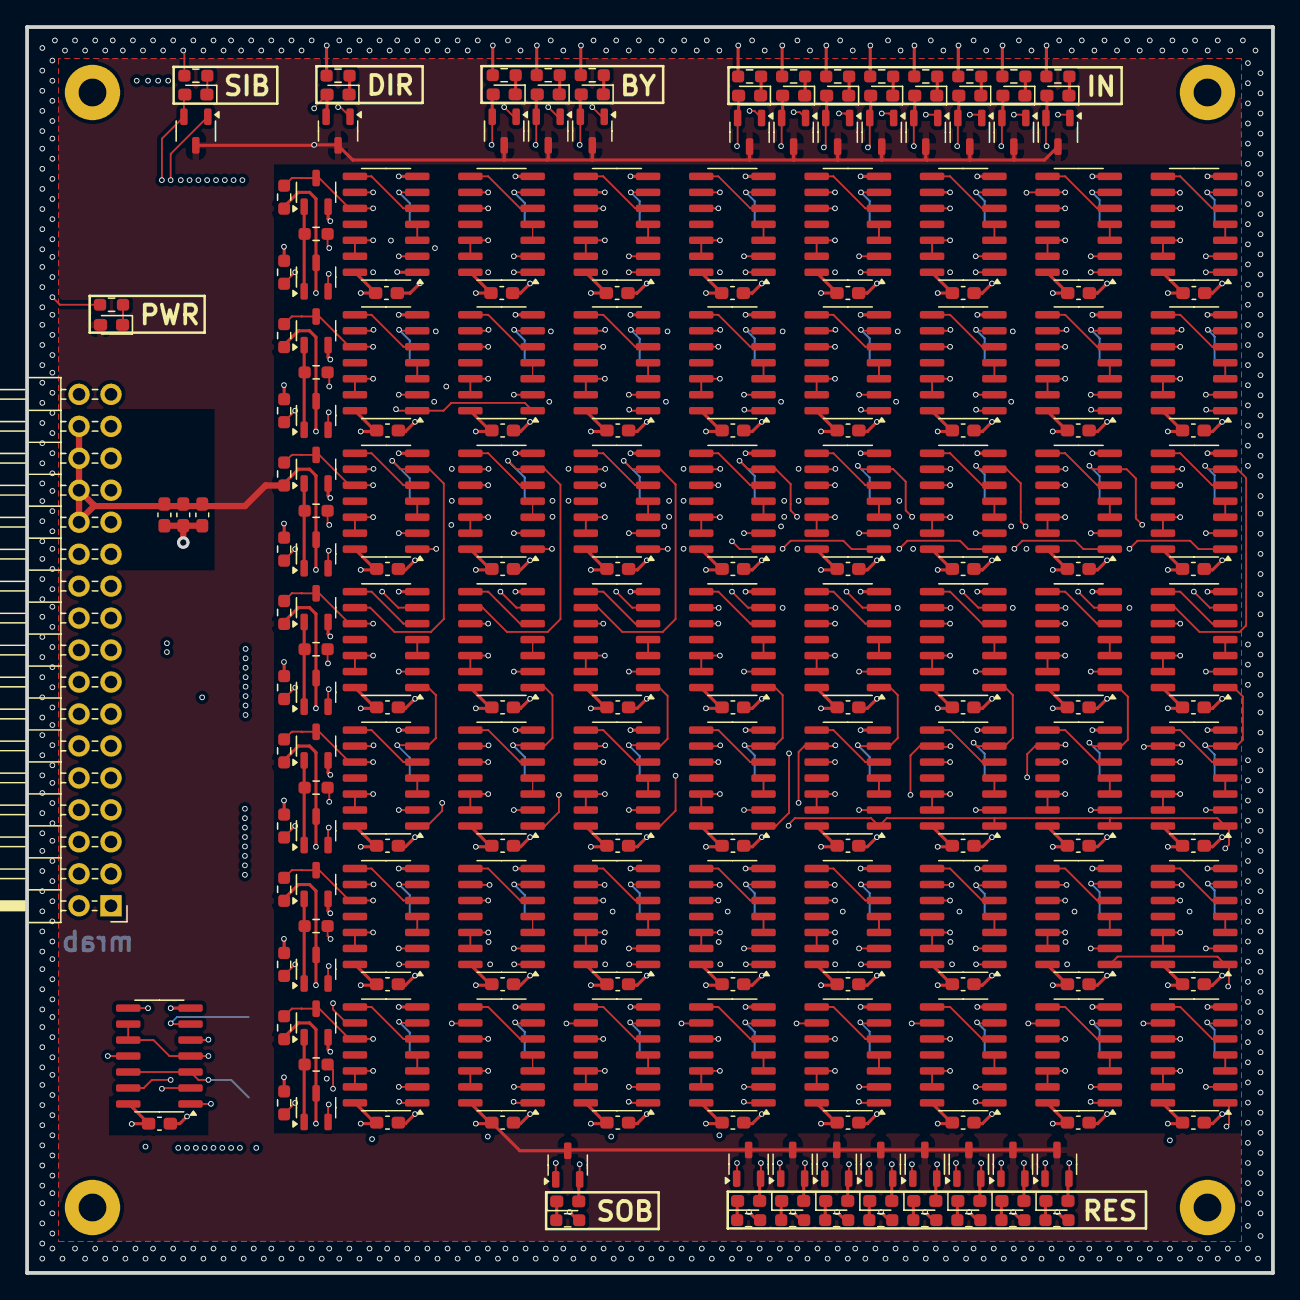
[picture p111: board alu_shift.kicad_pcb from above]

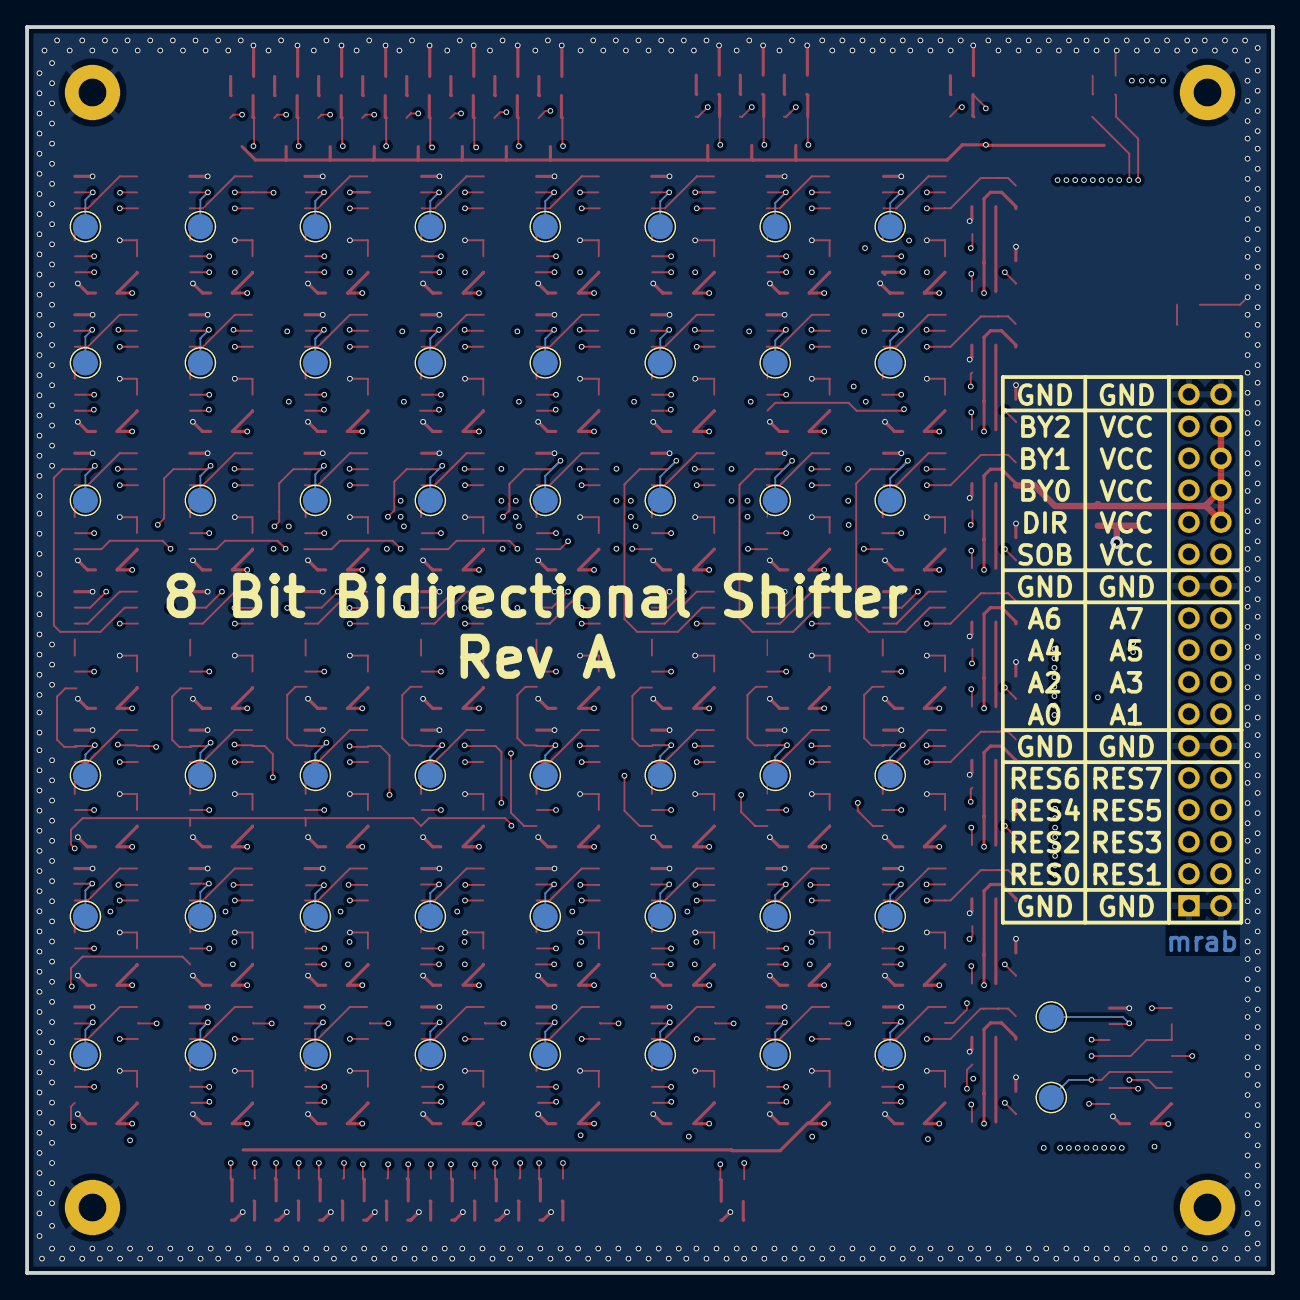
[picture p112: board alu_shift.kicad_pcb from below]

Board: 4 copper layers, 99.0 x 99.0 mm, 275 parts (50 on the bottom side), 253 nets.
