kantholz44mm/cpu/hardware/alu_motherboard/alu_motherboard.kicad_pcb

## KiCad design hardware/alu_motherboard/alu_motherboard.kicad_pcb (2025-02-12)

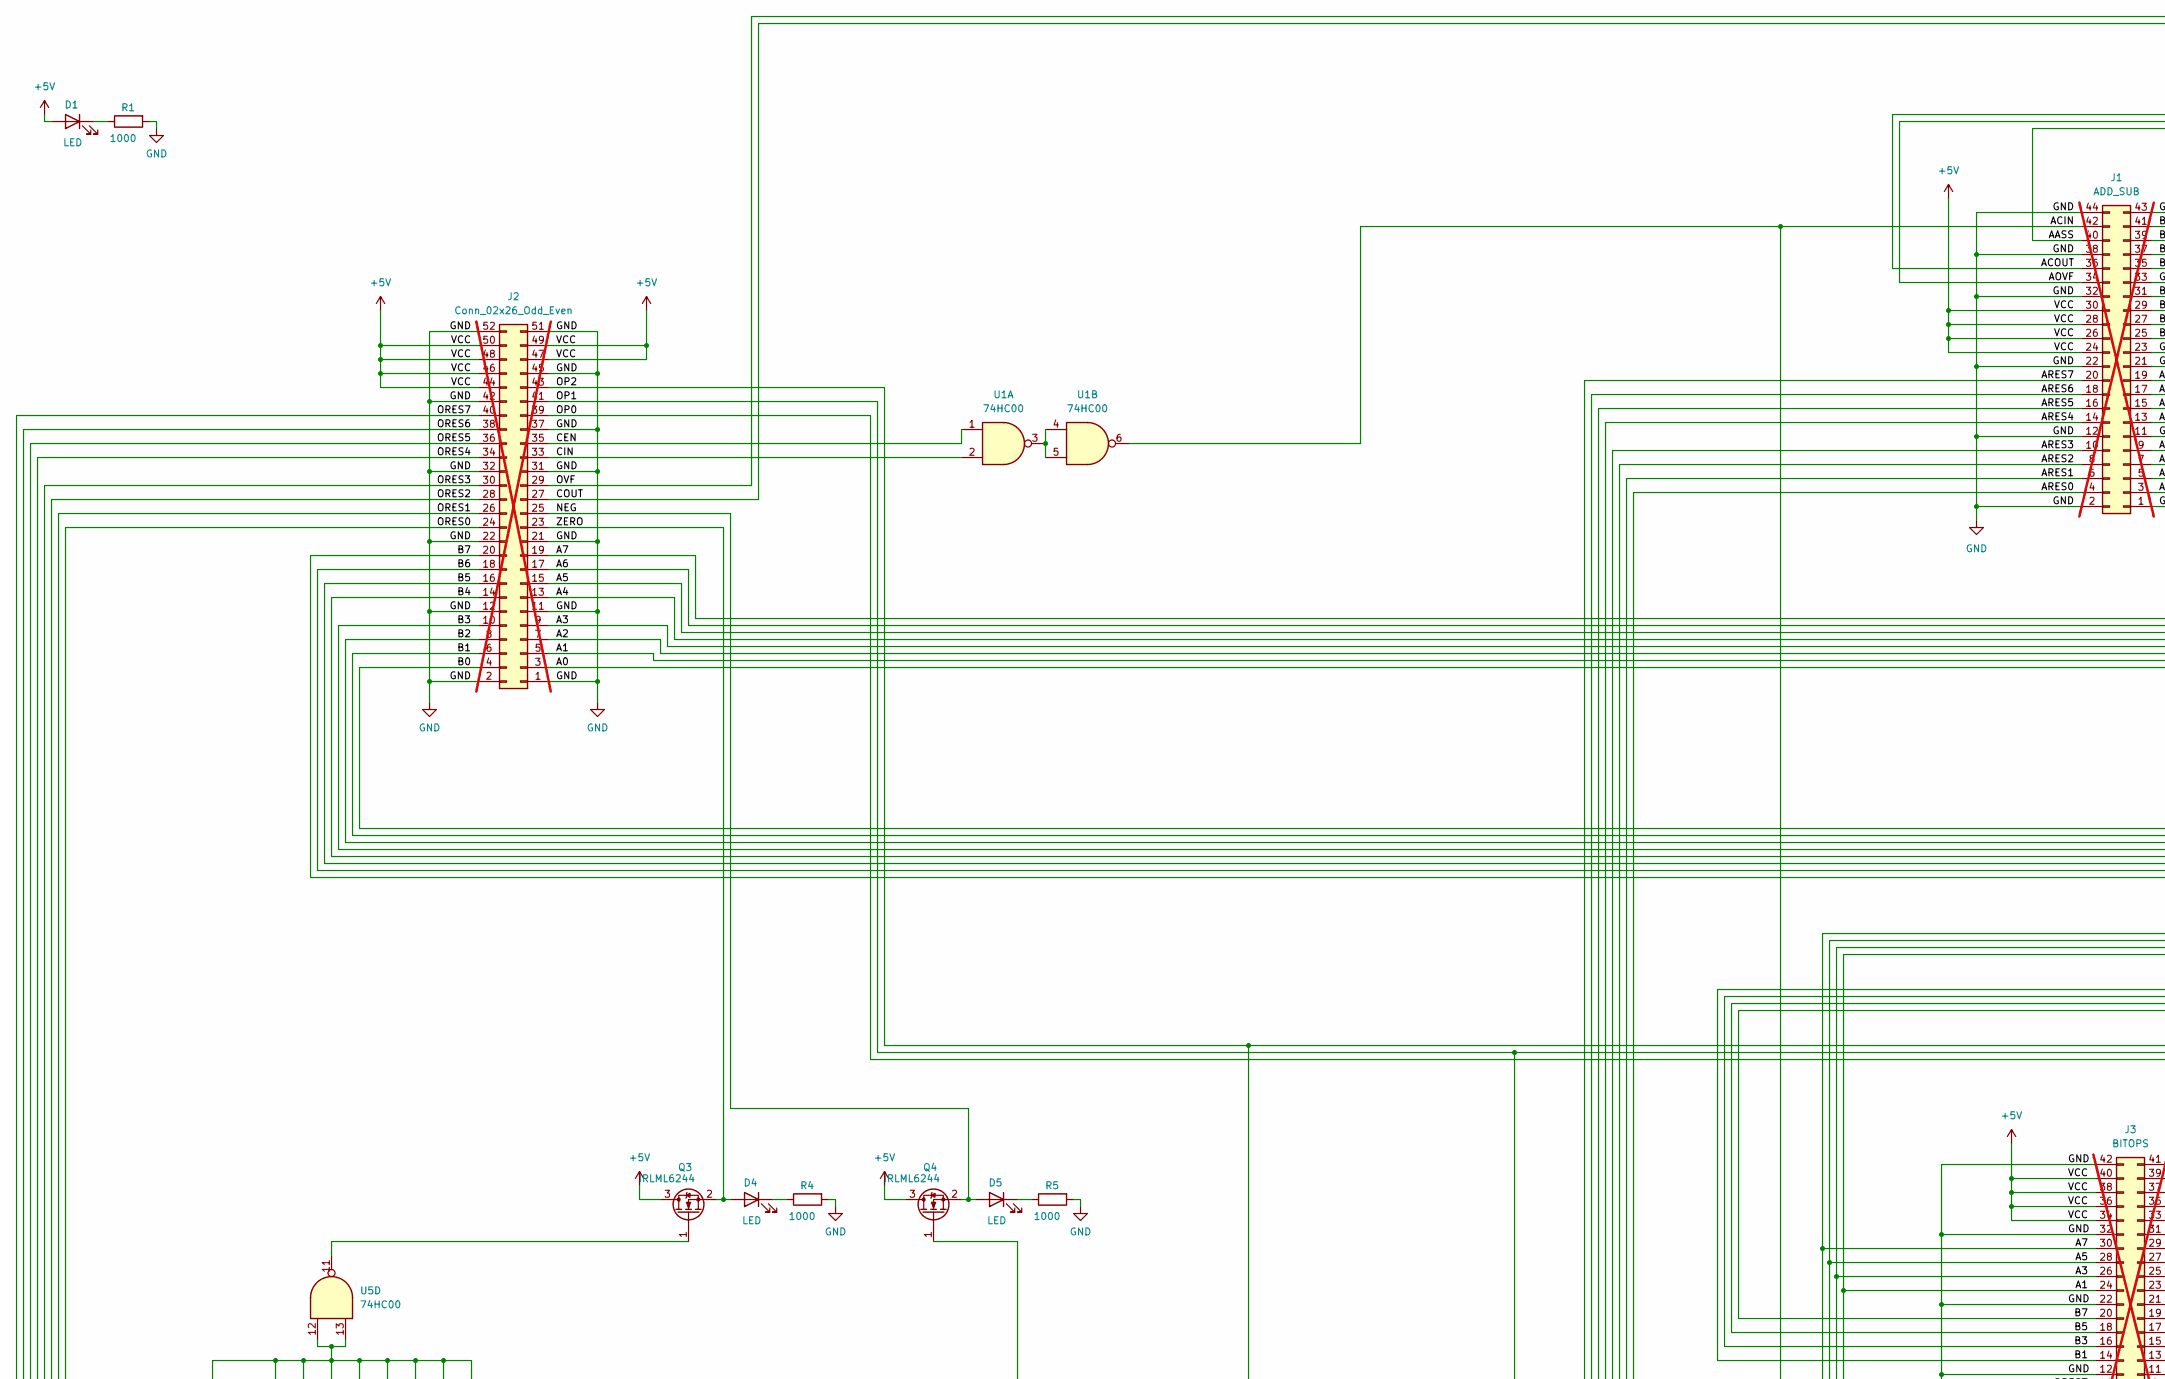
[picture p113: schematic alu_motherboard.kicad_sch, part in row 1, column 1]

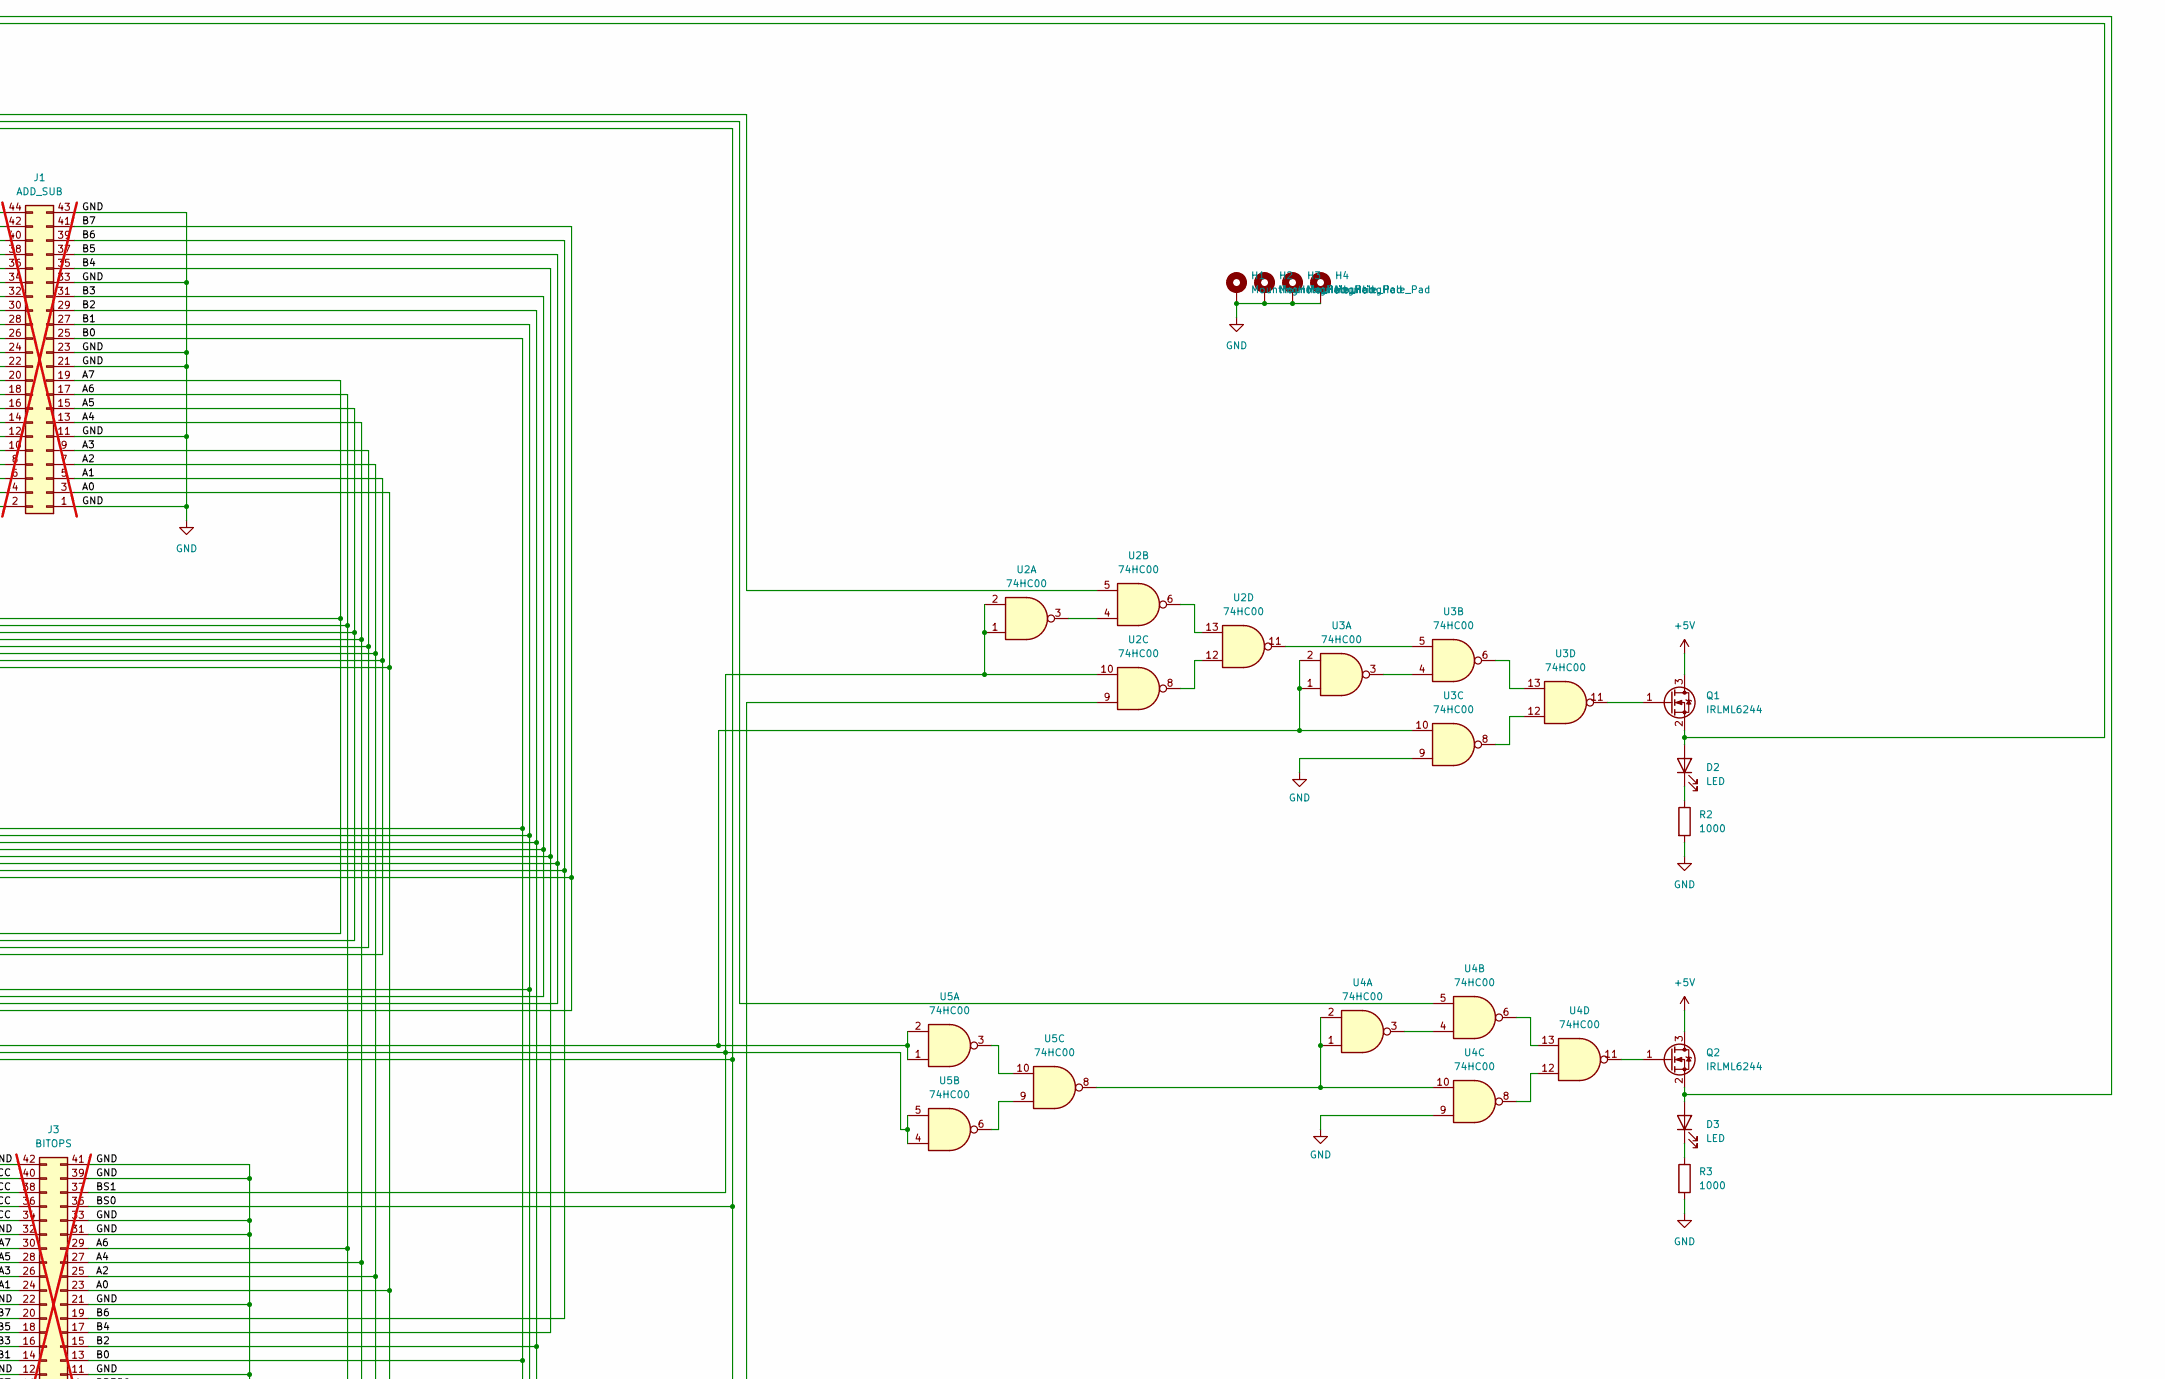
[picture p114: schematic alu_motherboard.kicad_sch, part in row 1, column 2]

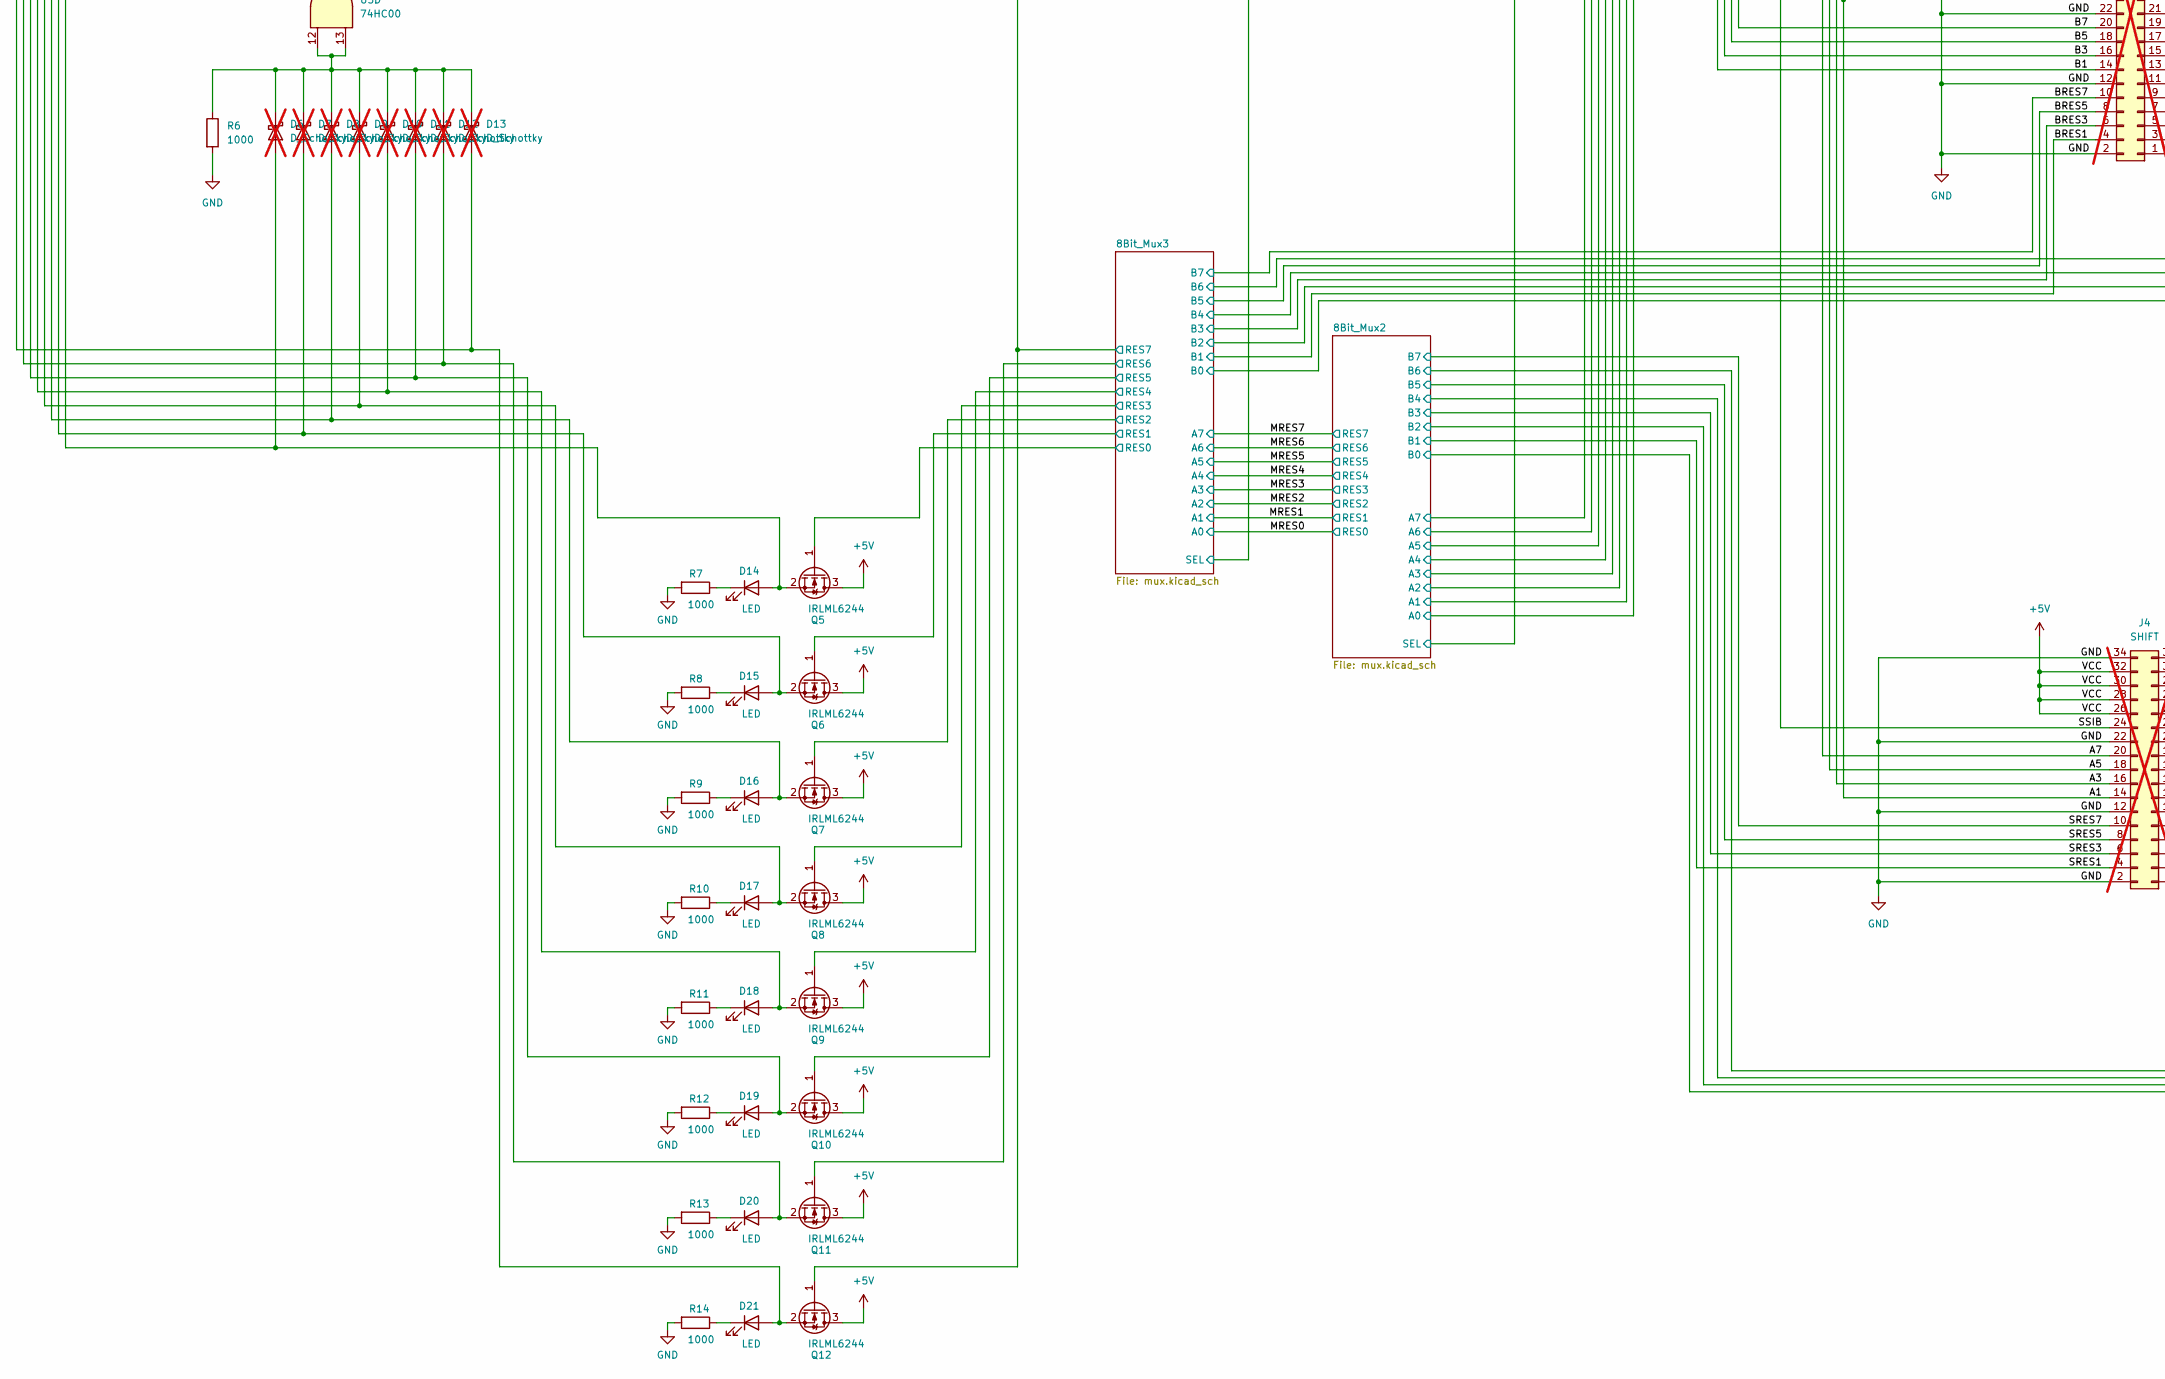
[picture p115: schematic alu_motherboard.kicad_sch, part in row 2, column 1]

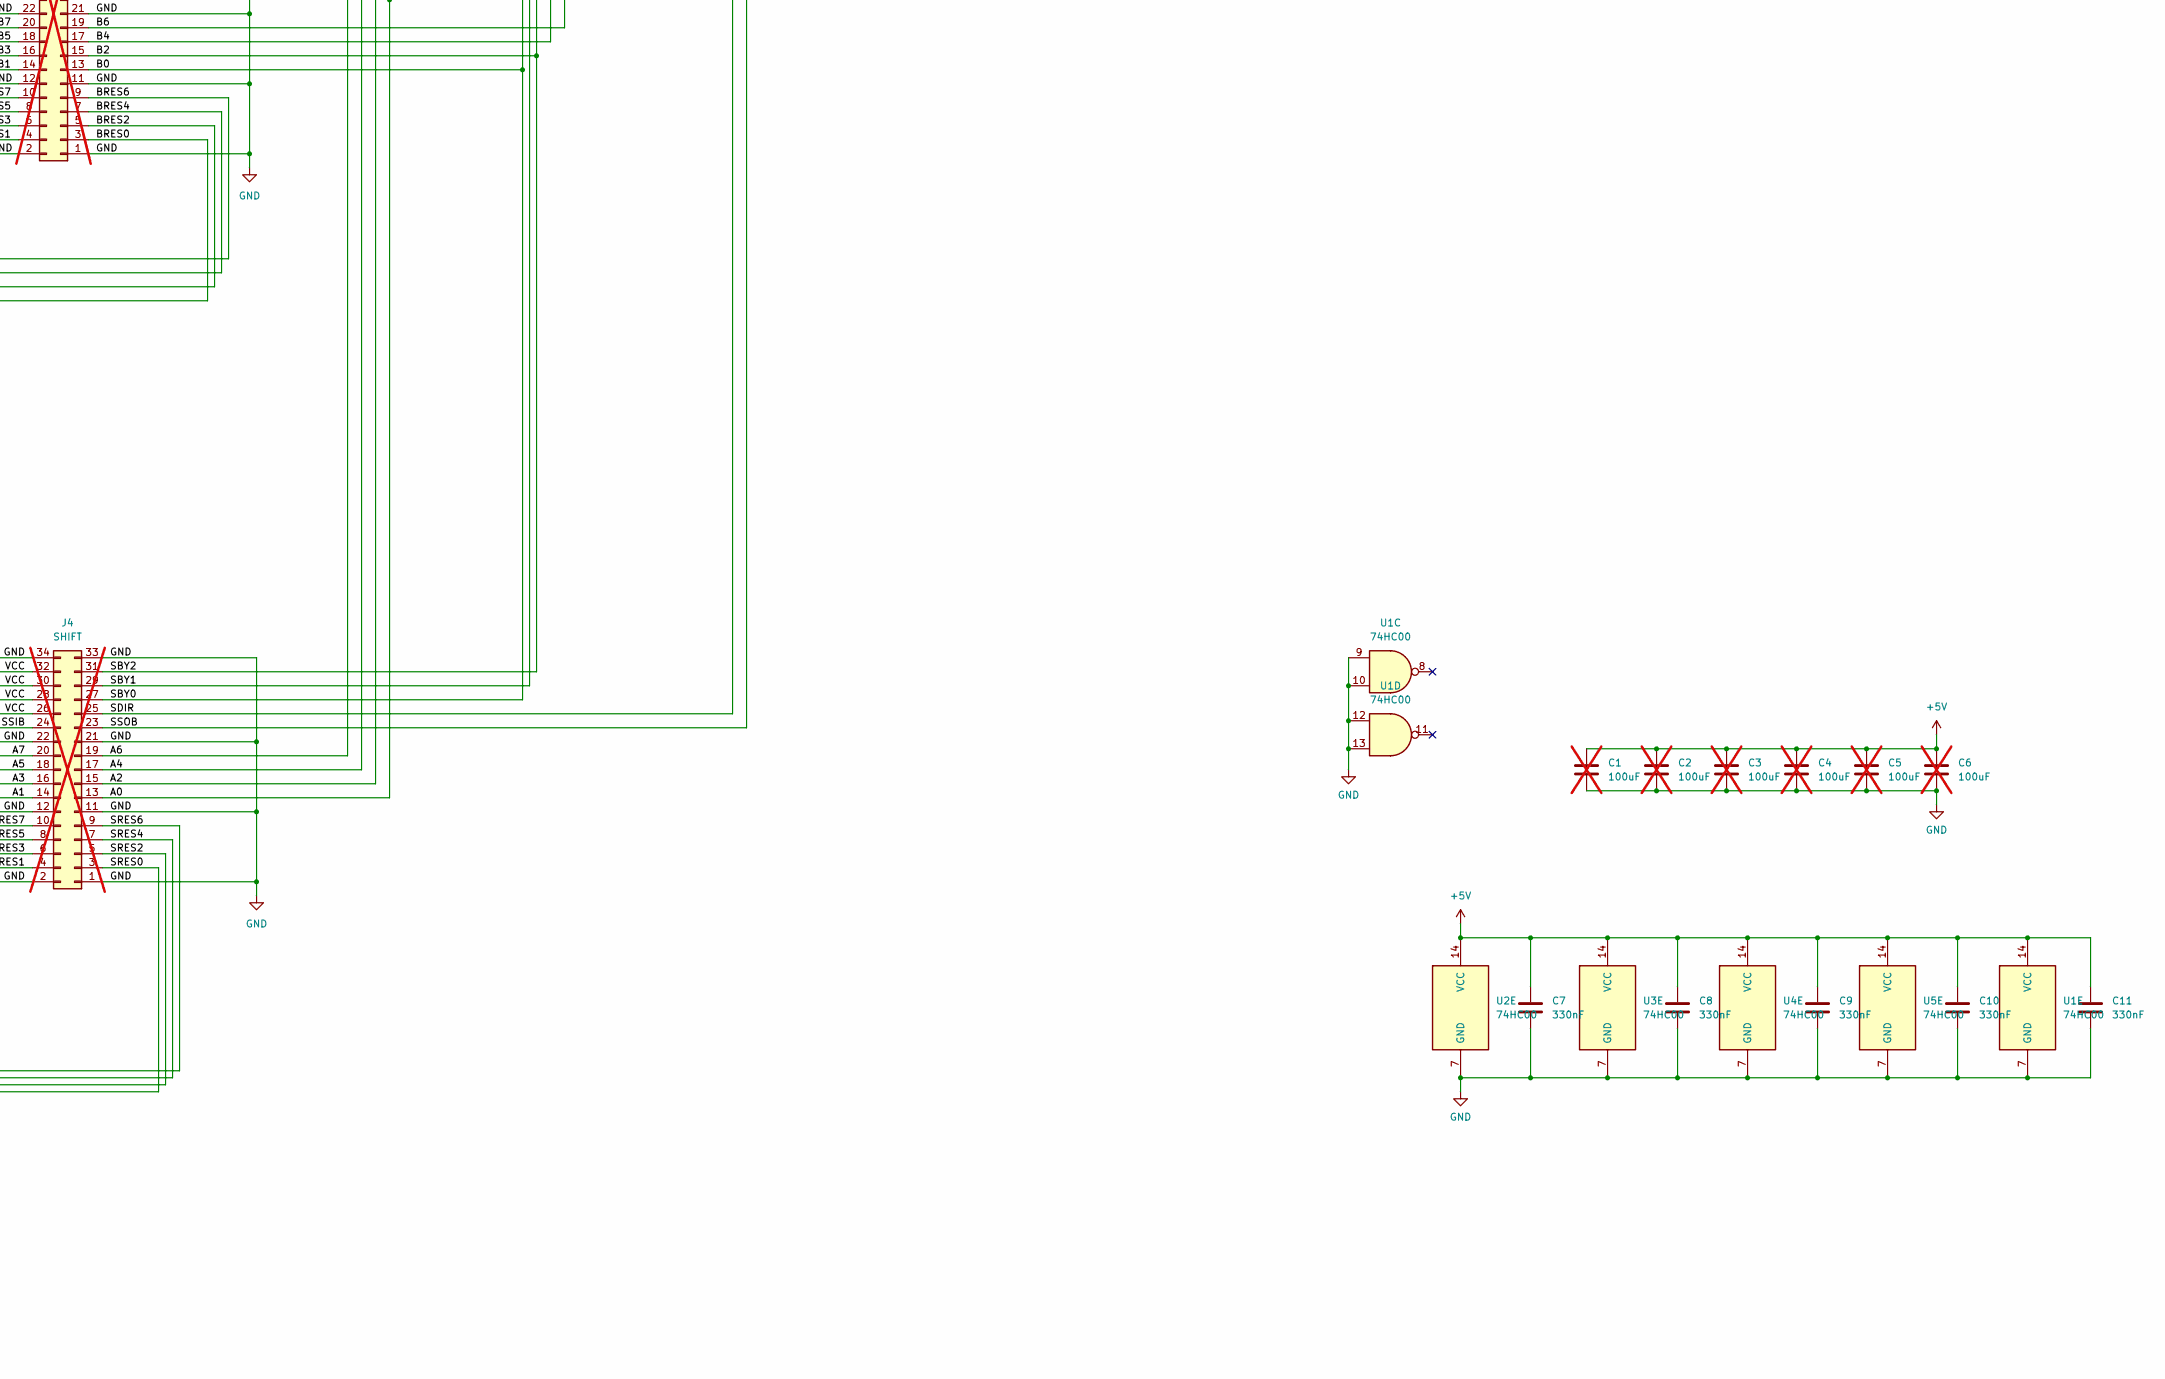
[picture p116: schematic alu_motherboard.kicad_sch, part in row 2, column 2]

Parts:
C1, C2, C3, C4, C5, C6: 100uF; C_Radial_D5.0mm_H11.0mm_P2.00mm; not fitted
C7, C8, C9, C10, C11: 330nF; C_0603_1608Metric_Pad1.08x0.95mm_HandSolder; LCSC C2918485
D1, D2, D3, D4, D5, D14, D15, D16, D17, D18, D19, D20, D21: LED; LED_0603_1608Metric_Pad1.05x0.95mm_HandSolder; LCSC C84267
D6, D7, D8, D9, D10, D11, D12, D13: D_Schottky; DO35_Packed; not fitted
H1, H2, H3, H4: MountingHole_Pad; MountingHole_2.2mm_M2_Pad
J1: ADD_SUB; PinSocket_2x22_P2.54mm_Horizontal; not fitted
J2: Conn_02x26_Odd_Even; PinHeader_2x26_P2.54mm_Horizontal; not fitted
J3: BITOPS; PinSocket_2x21_P2.54mm_Horizontal; not fitted
J4: SHIFT; PinSocket_2x17_P2.54mm_Horizontal; not fitted
Q1, Q2, Q3, Q4, Q5, Q6, Q7, Q8, Q9, Q10, Q11, Q12: IRLML6244; SOT-23-3; LCSC C5123965
R1, R2, R3, R4, R5, R6, R7, R8, R9, R10, R11, R12, R13, R14: 1000; R_0603_1608Metric_Pad0.98x0.95mm_HandSolder; LCSC C21190
U1, U2, U3, U4, U5: 74HC00; SOIC-14_3.9x8.7mm_P1.27mm; LCSC C5586

Connections:
+5V: C1.1, C2.1, C3.1, C4.1, C5.1, C6.1, C7.1, C8.1, C9.1, C10.1, C11.1, D1.2 (A), J1.24, J1.26, J1.28, J1.30, J2.44, J2.46, J2.47, J2.48, J2.49, J2.50, J3.34, J3.36, J3.38, J3.40, J4.26, J4.28, J4.30, J4.32, Q1.3 (D), Q2.3 (D), Q3.3 (D), Q4.3 (D), Q5.3 (D), Q6.3 (D), Q7.3 (D), Q8.3 (D), Q9.3 (D), Q10.3 (D), Q11.3 (D), Q12.3 (D), U1.14 (VCC), U2.14 (VCC), U3.14 (VCC), U4.14 (VCC), U5.14 (VCC); also elsewhere on the board
/8Bit_Mux3/RES0: Q5.1 (G); also elsewhere on the board
/8Bit_Mux3/RES1: Q6.1 (G); also elsewhere on the board
/8Bit_Mux3/RES2: Q7.1 (G); also elsewhere on the board
/8Bit_Mux3/RES3: Q8.1 (G); also elsewhere on the board
/8Bit_Mux3/RES4: Q9.1 (G); also elsewhere on the board
/8Bit_Mux3/RES5: Q10.1 (G); also elsewhere on the board
/8Bit_Mux3/RES6: Q11.1 (G); also elsewhere on the board
/8Bit_Mux3/RES7: Q4.1 (G), Q12.1 (G); also elsewhere on the board
/A0: J1.3, J2.3, J3.23, J4.13
/A1: J1.5, J2.5, J3.24, J4.14
/A2: J1.7, J2.7, J3.25, J4.15
/A3: J1.9, J2.9, J3.26, J4.16
/A4: J1.13, J2.13, J3.27, J4.17
/A5: J1.15, J2.15, J3.28, J4.18
/A6: J1.17, J2.17, J3.29, J4.19
/A7: J1.19, J2.19, J3.30, J4.20
/AASS: J1.40, J2.39, J3.35, J4.25
/ACIN: J1.42, J4.24, U1.6
/ACOUT: J1.36, U2.5
/AOVF: J1.34, U4.5
/ARES0: J1.4; also elsewhere on the board
/ARES1: J1.6; also elsewhere on the board
/ARES2: J1.8; also elsewhere on the board
/ARES3: J1.10; also elsewhere on the board
/ARES4: J1.14; also elsewhere on the board
/ARES5: J1.16; also elsewhere on the board
/ARES6: J1.18; also elsewhere on the board
/ARES7: J1.20; also elsewhere on the board
/B0: J1.25, J2.4, J3.13, J4.27
/B1: J1.27, J2.6, J3.14, J4.29
/B2: J1.29, J2.8, J3.15, J4.31
/B3: J1.31, J2.10, J3.16
/B4: J1.35, J2.14, J3.17
/B5: J1.37, J2.16, J3.18
/B6: J1.39, J2.18, J3.19
/B7: J1.41, J2.20, J3.20
/BRES0: J3.3; also elsewhere on the board
/BRES1: J3.4; also elsewhere on the board
/BRES2: J3.5; also elsewhere on the board
/BRES3: J3.6; also elsewhere on the board
/BRES4: J3.7; also elsewhere on the board
/BRES5: J3.8; also elsewhere on the board
/BRES6: J3.9; also elsewhere on the board
/BRES7: J3.10; also elsewhere on the board
/BS1: J2.41, J3.37, U2.1, U2.2, U2.10, U5.4, U5.5; also elsewhere on the board
/CEN: J2.35, U1.1
/CIN: J2.33, U1.2
/COUT: D2.2 (A), J2.27, Q1.2 (S)
/NEG: D5.2 (A), J2.25, Q4.2 (S)
/OP2: J2.43, U3.1, U3.2, U3.10, U5.1, U5.2; also elsewhere on the board
/ORES0: D6.2 (A), D14.2 (A), J2.24, Q5.2 (S)
/ORES1: D7.2 (A), D15.2 (A), J2.26, Q6.2 (S)
/ORES2: D8.2 (A), D16.2 (A), J2.28, Q7.2 (S)
/ORES3: D9.2 (A), D17.2 (A), J2.30, Q8.2 (S)
/ORES4: D10.2 (A), D18.2 (A), J2.34, Q9.2 (S)
/ORES5: D11.2 (A), D19.2 (A), J2.36, Q10.2 (S)
/ORES6: D12.2 (A), D20.2 (A), J2.38, Q11.2 (S)
/ORES7: D13.2 (A), D21.2 (A), J2.40, Q12.2 (S)
/OVF: D3.2 (A), J2.29, Q2.2 (S)
/SRES0: J4.3; also elsewhere on the board
/SRES1: J4.4; also elsewhere on the board
/SRES2: J4.5; also elsewhere on the board
/SRES3: J4.6; also elsewhere on the board
/SRES4: J4.7; also elsewhere on the board
/SRES5: J4.8; also elsewhere on the board
/SRES6: J4.9; also elsewhere on the board
/SRES7: J4.10; also elsewhere on the board
/SSOB: J4.23, U2.9
/ZERO: D4.2 (A), J2.23, Q3.2 (S)
GND: C1.2, C2.2, C3.2, C4.2, C5.2, C6.2, C7.2, C8.2, C9.2, C10.2, C11.2, H1.1, H2.1, H3.1, H4.1, J1.1, J1.2, J1.11, J1.12, J1.21, J1.22, J1.23, J1.32, J1.33, J1.38, J1.43, J1.44, J2.1, J2.2, J2.11, J2.12, J2.21, J2.22, J2.31, J2.32, J2.37, J2.42, J2.45, J2.51, J2.52, J3.1, J3.2, J3.11, J3.12, J3.21, J3.22, J3.31, J3.32, J3.33, J3.39, J3.41, J3.42, J4.1, J4.2, J4.11, J4.12, J4.21, J4.22, J4.33, J4.34, R1.2, R2.2, R3.2, R4.2, R5.2, R6.2, R7.2, R8.2, R9.2, R10.2, R11.2, R12.2, R13.2, R14.2, U1.7 (GND), U1.9, U1.10, U1.12, U1.13, U2.7 (GND), U3.7 (GND), U3.9, U4.7 (GND), U4.9, U5.7 (GND); also elsewhere on the board
unnamed: D1.1 (K), R1.1
unnamed: D2.1 (K), R2.1
unnamed: D3.1 (K), R3.1
unnamed: D4.1 (K), R4.1
unnamed: D5.1 (K), R5.1
unnamed: D6.1 (K), D7.1 (K), D8.1 (K), D9.1 (K), D10.1 (K), D11.1 (K), D12.1 (K), D13.1 (K), R6.1, U5.12, U5.13
unnamed: D14.1 (K), R7.1
unnamed: D15.1 (K), R8.1
unnamed: D16.1 (K), R9.1
unnamed: D17.1 (K), R10.1
unnamed: D18.1 (K), R11.1
unnamed: D19.1 (K), R12.1
unnamed: D20.1 (K), R13.1
unnamed: D21.1 (K), R14.1
unnamed: Q1.1 (G), U3.11
unnamed: Q2.1 (G), U4.11
unnamed: Q3.1 (G), U5.11
unnamed: U1.3, U1.4, U1.5
unnamed: U2.3, U2.4
unnamed: U2.11, U3.5
unnamed: U2.8, U2.12
unnamed: U2.6, U2.13
unnamed: U3.3, U3.4
unnamed: U3.8, U3.12
unnamed: U3.6, U3.13
unnamed: U4.1, U4.2, U4.10, U5.8
unnamed: U4.3, U4.4
unnamed: U4.8, U4.12
unnamed: U4.6, U4.13
unnamed: U5.6, U5.9
unnamed: U5.3, U5.10
