kantholz44mm/cpu/hardware/alu_motherboard/alu_motherboard.kicad_pcb

## KiCad design hardware/alu_motherboard/alu_motherboard.kicad_pcb (continued)

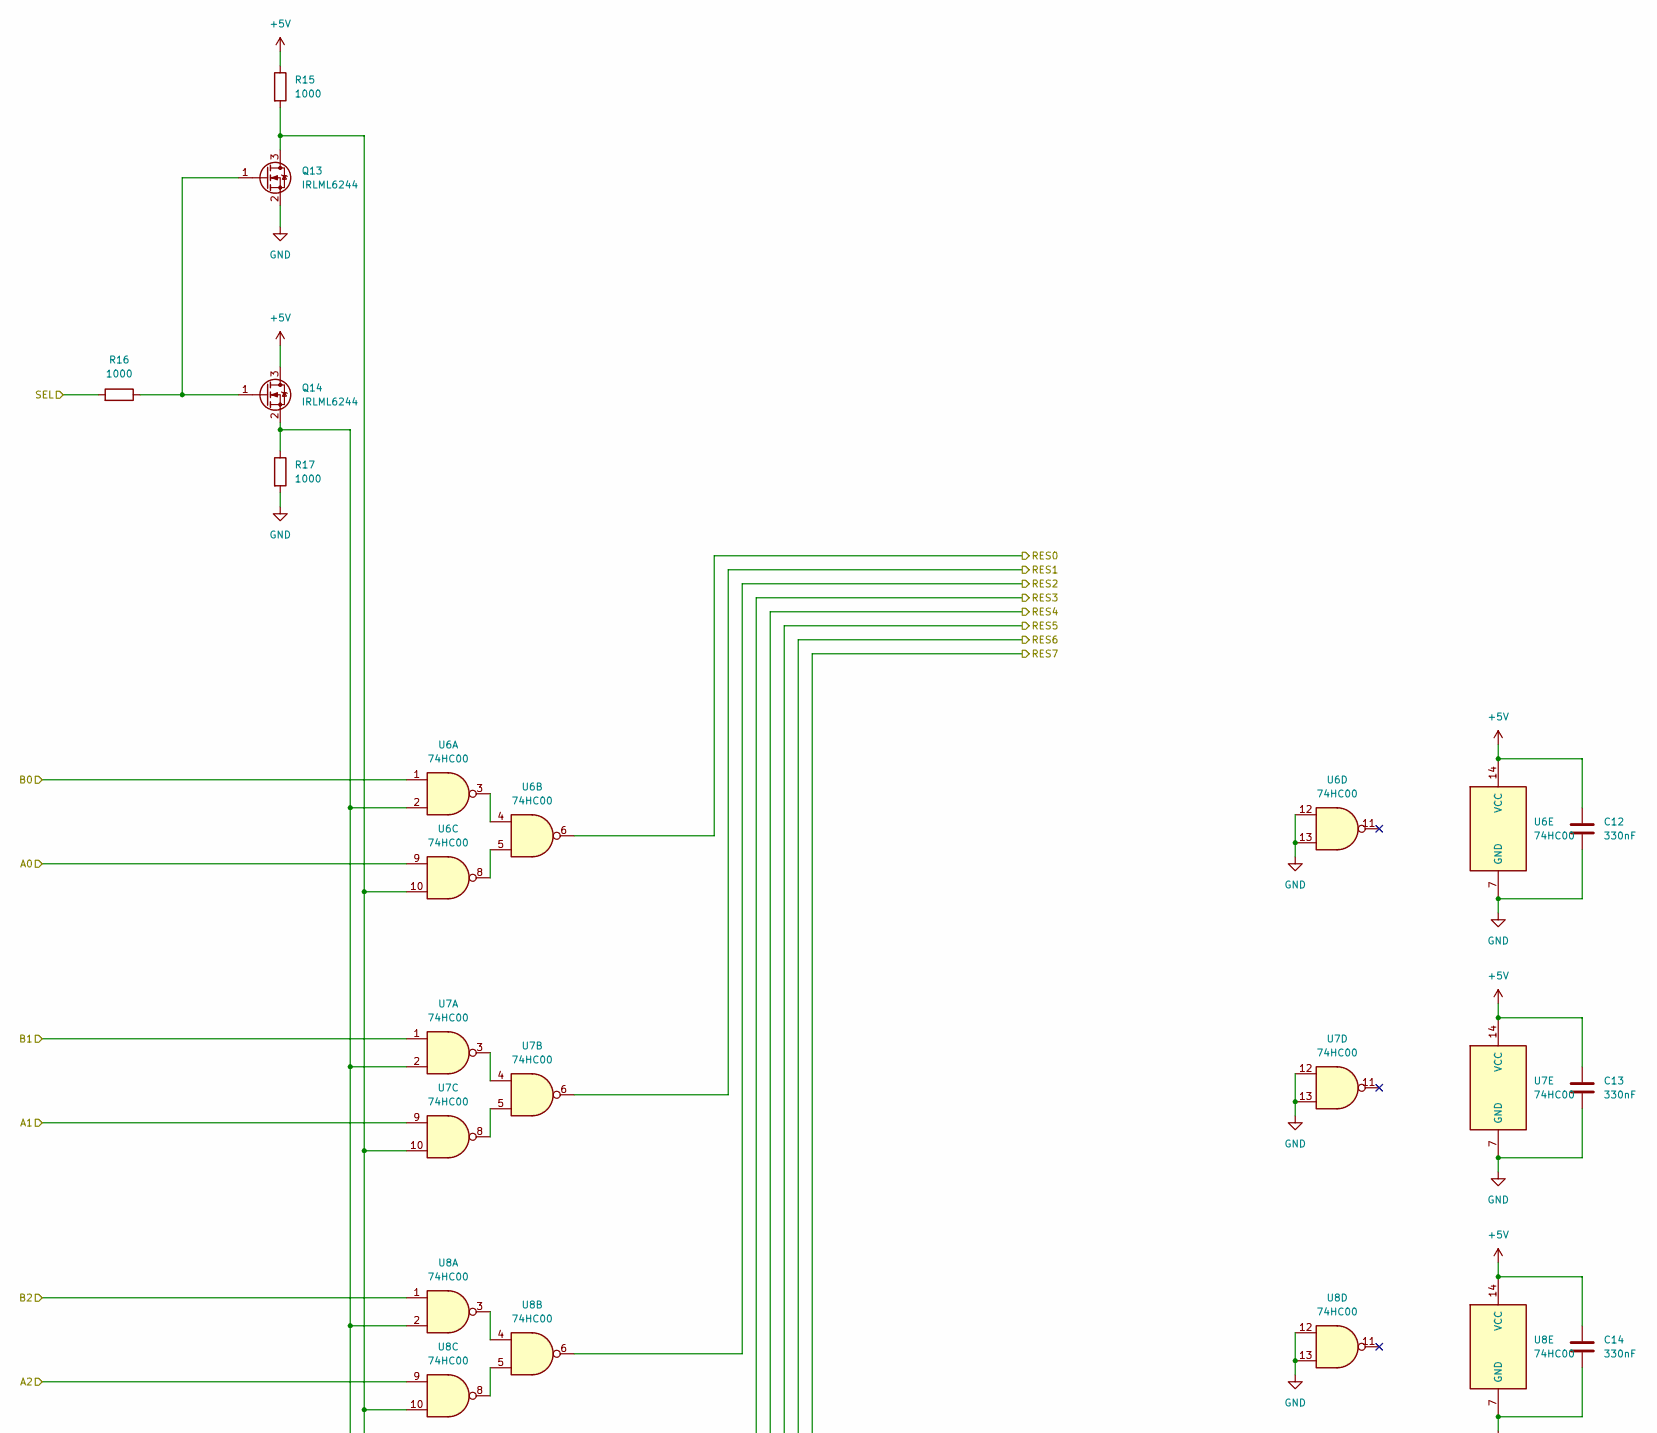
[picture p117: schematic mux.kicad_sch, part in row 1, column 1]

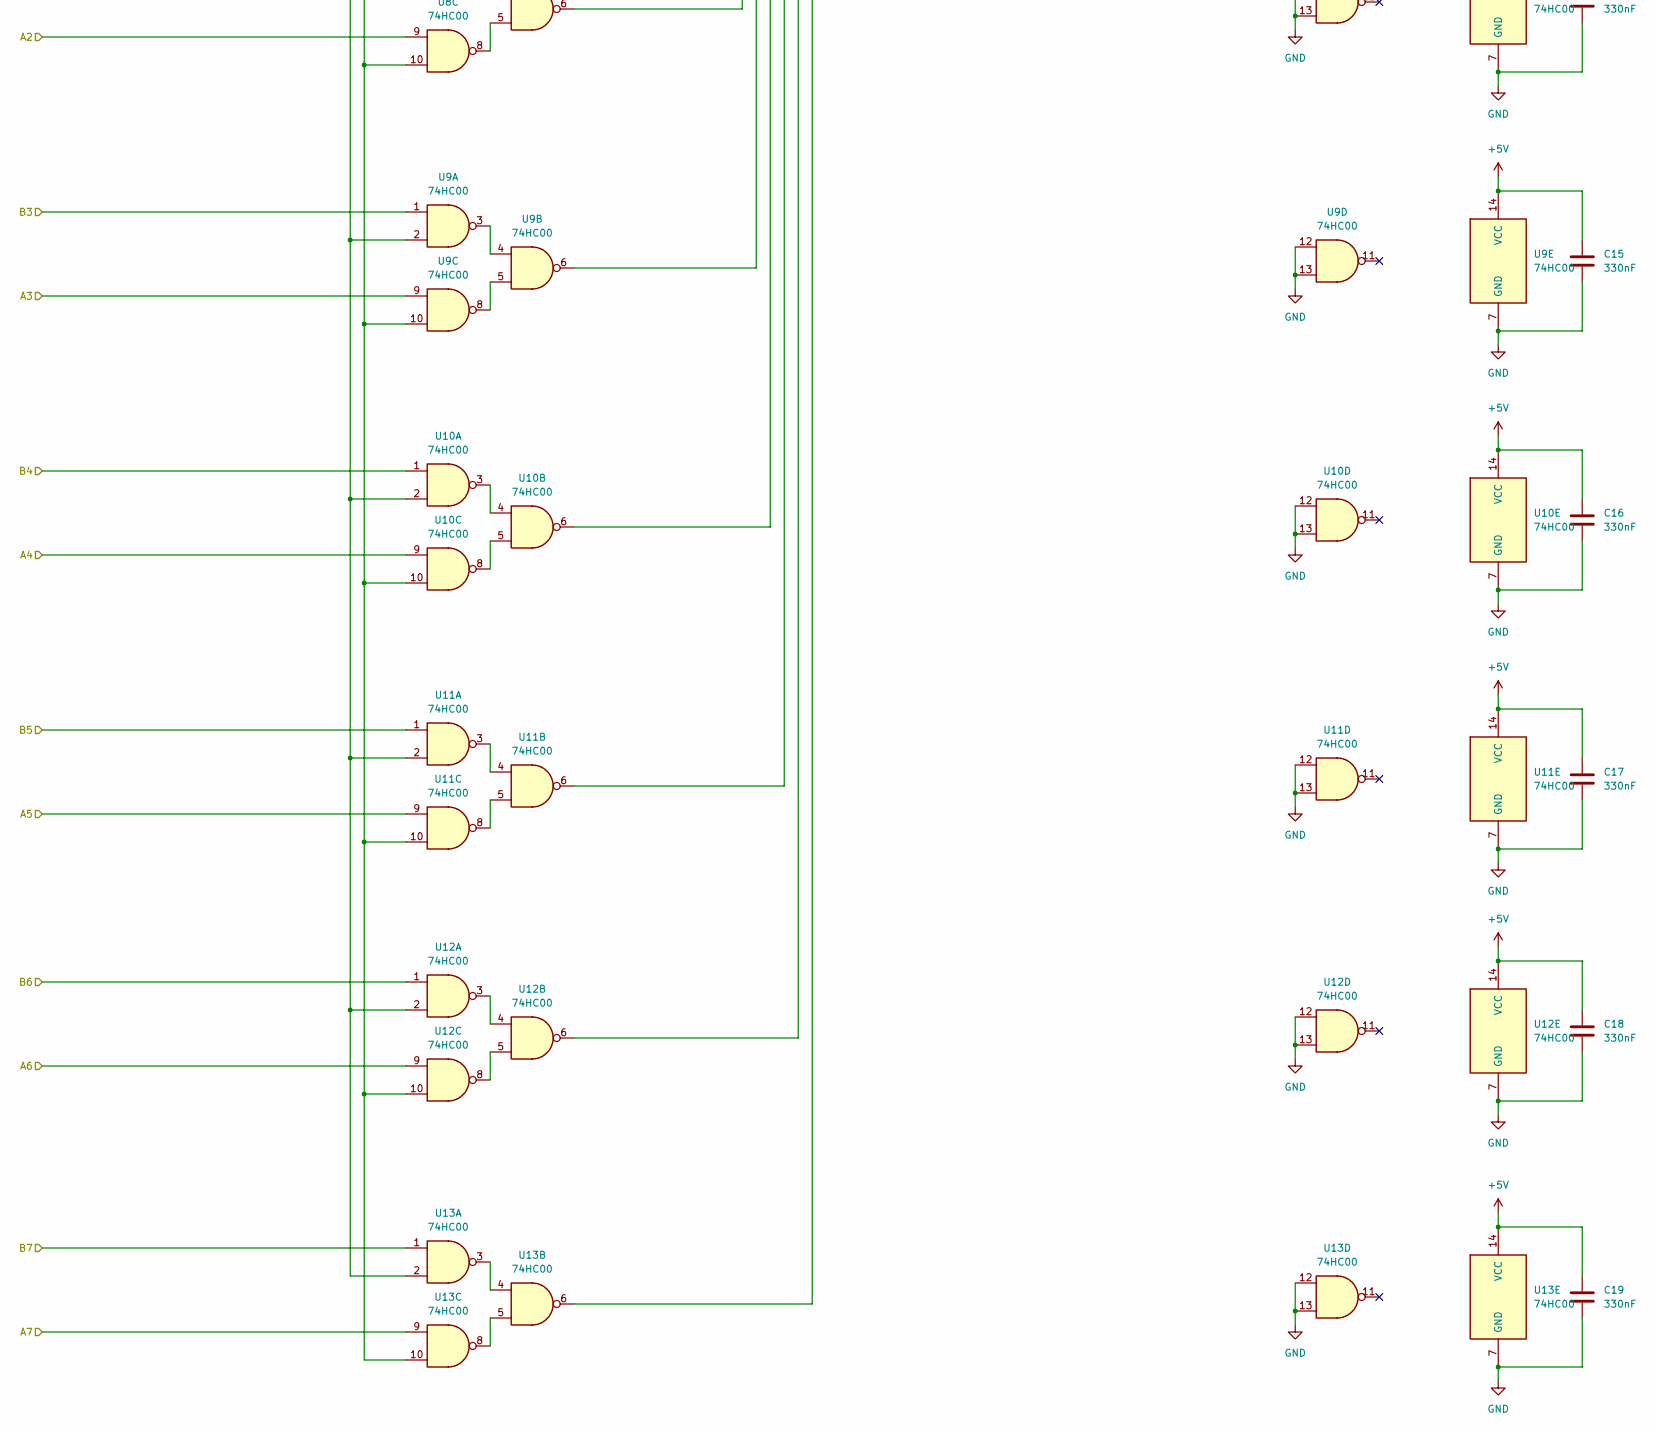
[picture p118: schematic mux.kicad_sch, part in row 2, column 1]

Parts:
C12, C13, C14, C15, C16, C17, C18, C19: 330nF; C_0603_1608Metric_Pad1.08x0.95mm_HandSolder; LCSC C2918485
Q13, Q14: IRLML6244; SOT-23-3; LCSC C5123965
R15, R16, R17: 1000; R_0603_1608Metric_Pad0.98x0.95mm_HandSolder; LCSC C21190
U6, U7, U8, U9, U10, U11, U12, U13: 74HC00; SOIC-14_3.9x8.7mm_P1.27mm; LCSC C5586

Connections:
+5V: C12.1, C13.1, C14.1, C15.1, C16.1, C17.1, C18.1, C19.1, Q14.3 (D), R15.1, U6.14 (VCC), U7.14 (VCC), U8.14 (VCC), U9.14 (VCC), U10.14 (VCC), U11.14 (VCC), U12.14 (VCC), U13.14 (VCC); also elsewhere on the board
/ARES0: U6.9; also elsewhere on the board
/ARES1: U7.9; also elsewhere on the board
/ARES2: U8.9; also elsewhere on the board
/ARES3: U9.9; also elsewhere on the board
/ARES4: U10.9; also elsewhere on the board
/ARES5: U11.9; also elsewhere on the board
/ARES6: U12.9; also elsewhere on the board
/ARES7: U13.9; also elsewhere on the board
/BS1: R16.2; also elsewhere on the board
/MRES0: U6.6; also elsewhere on the board
/MRES1: U7.6; also elsewhere on the board
/MRES2: U8.6; also elsewhere on the board
/MRES3: U9.6; also elsewhere on the board
/MRES4: U10.6; also elsewhere on the board
/MRES5: U11.6; also elsewhere on the board
/MRES6: U12.6; also elsewhere on the board
/MRES7: U13.6; also elsewhere on the board
/SRES0: U6.1; also elsewhere on the board
/SRES1: U7.1; also elsewhere on the board
/SRES2: U8.1; also elsewhere on the board
/SRES3: U9.1; also elsewhere on the board
/SRES4: U10.1; also elsewhere on the board
/SRES5: U11.1; also elsewhere on the board
/SRES6: U12.1; also elsewhere on the board
/SRES7: U13.1; also elsewhere on the board
GND: C12.2, C13.2, C14.2, C15.2, C16.2, C17.2, C18.2, C19.2, Q13.2 (S), R17.2, U6.7 (GND), U6.12, U6.13, U7.7 (GND), U7.12, U7.13, U8.7 (GND), U8.12, U8.13, U9.7 (GND), U9.12, U9.13, U10.7 (GND), U10.12, U10.13, U11.7 (GND), U11.12, U11.13, U12.7 (GND), U12.12, U12.13, U13.7 (GND), U13.12, U13.13; also elsewhere on the board
unnamed: Q13.3 (D), R15.2, U6.10, U7.10, U8.10, U9.10, U10.10, U11.10, U12.10, U13.10
unnamed: Q13.1 (G), Q14.1 (G), R16.1
unnamed: Q14.2 (S), R17.1, U6.2, U7.2, U8.2, U9.2, U10.2, U11.2, U12.2, U13.2
unnamed: U6.3, U6.4
unnamed: U6.5, U6.8
unnamed: U7.3, U7.4
unnamed: U7.5, U7.8
unnamed: U8.3, U8.4
unnamed: U8.5, U8.8
unnamed: U9.3, U9.4
unnamed: U9.5, U9.8
unnamed: U10.3, U10.4
unnamed: U10.5, U10.8
unnamed: U11.3, U11.4
unnamed: U11.5, U11.8
unnamed: U12.3, U12.4
unnamed: U12.5, U12.8
unnamed: U13.3, U13.4
unnamed: U13.5, U13.8

Parts of its further copies:
C20, C21, C22, C23, C24, C25, C26, C27: 330nF; C_0603_1608Metric_Pad1.08x0.95mm_HandSolder; LCSC C2918485
Q15, Q16: IRLML6244; SOT-23-3; LCSC C5123965
R18, R19, R20: 1000; R_0603_1608Metric_Pad0.98x0.95mm_HandSolder; LCSC C21190
U14, U15, U16, U17, U18, U19, U20, U21: 74HC00; SOIC-14_3.9x8.7mm_P1.27mm; LCSC C5586

Connections of its further copies:
+5V: C20.1, C21.1, C22.1, C23.1, C24.1, C25.1, C26.1, C27.1, Q16.3 (D), R18.1, U14.14 (VCC), U15.14 (VCC), U16.14 (VCC), U17.14 (VCC), U18.14 (VCC), U19.14 (VCC), U20.14 (VCC), U21.14 (VCC); also elsewhere on the board
/8Bit_Mux3/RES0: U14.6; also elsewhere on the board
/8Bit_Mux3/RES1: U15.6; also elsewhere on the board
/8Bit_Mux3/RES2: U16.6; also elsewhere on the board
/8Bit_Mux3/RES3: U17.6; also elsewhere on the board
/8Bit_Mux3/RES4: U18.6; also elsewhere on the board
/8Bit_Mux3/RES5: U19.6; also elsewhere on the board
/8Bit_Mux3/RES6: U20.6; also elsewhere on the board
/8Bit_Mux3/RES7: U21.6; also elsewhere on the board
/BRES0: U14.1; also elsewhere on the board
/BRES1: U15.1; also elsewhere on the board
/BRES2: U16.1; also elsewhere on the board
/BRES3: U17.1; also elsewhere on the board
/BRES4: U18.1; also elsewhere on the board
/BRES5: U19.1; also elsewhere on the board
/BRES6: U20.1; also elsewhere on the board
/BRES7: U21.1; also elsewhere on the board
/MRES0: U14.9; also elsewhere on the board
/MRES1: U15.9; also elsewhere on the board
/MRES2: U16.9; also elsewhere on the board
/MRES3: U17.9; also elsewhere on the board
/MRES4: U18.9; also elsewhere on the board
/MRES5: U19.9; also elsewhere on the board
/MRES6: U20.9; also elsewhere on the board
/MRES7: U21.9; also elsewhere on the board
/OP2: R19.2; also elsewhere on the board
GND: C20.2, C21.2, C22.2, C23.2, C24.2, C25.2, C26.2, C27.2, Q15.2 (S), R20.2, U14.7 (GND), U14.12, U14.13, U15.7 (GND), U15.12, U15.13, U16.7 (GND), U16.12, U16.13, U17.7 (GND), U17.12, U17.13, U18.7 (GND), U18.12, U18.13, U19.7 (GND), U19.12, U19.13, U20.7 (GND), U20.12, U20.13, U21.7 (GND), U21.12, U21.13; also elsewhere on the board
unnamed: Q15.3 (D), R18.2, U14.10, U15.10, U16.10, U17.10, U18.10, U19.10, U20.10, U21.10
unnamed: Q15.1 (G), Q16.1 (G), R19.1
unnamed: Q16.2 (S), R20.1, U14.2, U15.2, U16.2, U17.2, U18.2, U19.2, U20.2, U21.2
unnamed: U14.3, U14.4
unnamed: U14.5, U14.8
unnamed: U15.3, U15.4
unnamed: U15.5, U15.8
unnamed: U16.3, U16.4
unnamed: U16.5, U16.8
unnamed: U17.3, U17.4
unnamed: U17.5, U17.8
unnamed: U18.3, U18.4
unnamed: U18.5, U18.8
unnamed: U19.3, U19.4
unnamed: U19.5, U19.8
unnamed: U20.3, U20.4
unnamed: U20.5, U20.8
unnamed: U21.3, U21.4
unnamed: U21.5, U21.8

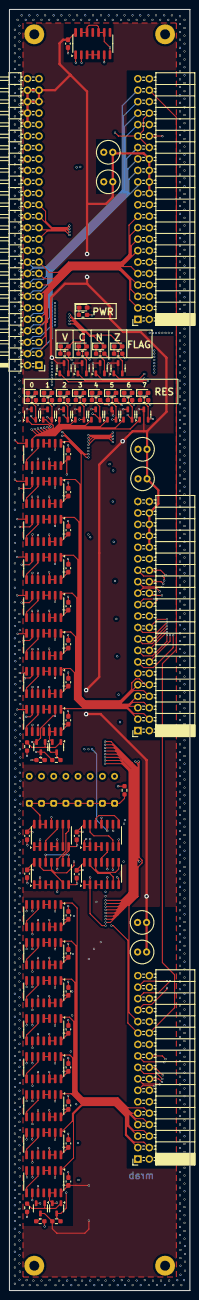
[picture p119: board alu_motherboard.kicad_pcb from above]

Board: 4 copper layers, 40.0 x 284.0 mm, 113 parts (0 on the bottom side), 148 nets.
