kantholz44mm/cpu/hardware/alu_bitops/alu_bitops.kicad_pcb

## KiCad design hardware/alu_bitops/alu_bitops.kicad_pcb (2025-02-12)

Schematic: alu_bitops.kicad_sch

Parts:
C1, C2, C3, C4, C5, C6, C7, C8, C9, C10, C11, C12, C13, C14, C15, C16, C17, C18, C19, C20, C21, C22, C23, C24, C25, C26, C27, C28, C29, C30, C31, C32, C33, C34, C35: 330nF; C_0603_1608Metric_Pad1.08x0.95mm_HandSolder; LCSC C2918485
C36, C37, C38: 10uF; C_0603_1608Metric_Pad1.08x0.95mm_HandSolder; LCSC C2909630
D1, D2, D3, D4, D5, D6, D7, D8, D9, D10, D11, D12, D13, D14, D15, D16, D17, D18, D19, D20, D21, D22, D23, D24, D25, D26, D27, D28, D29, D30, D63: LED; LED_0603_1608Metric_Pad1.05x0.95mm_HandSolder; LCSC C84267
D31, D32, D33, D34, D35, D36, D37, D38, D39, D40, D41, D42, D43, D44, D45, D46, D47, D48, D49, D50, D51, D52, D53, D54, D55, D56, D57, D58, D59, D60, D61, D62: D_Schottky; DO35_Packed; not fitted
H1, H2, H3, H4: MountingHole_Pad; MountingHole_2.2mm_M2_Pad
J1: Conn_02x21_Odd_Even; PinHeader_2x21_P2.54mm_Horizontal; not fitted
Q1, Q2, Q3, Q4, Q5, Q6, Q7, Q8, Q9, Q10, Q11, Q12, Q13, Q14, Q15, Q16, Q17, Q18, Q19, Q20, Q21, Q22, Q23, Q24, Q25, Q26, Q27, Q28, Q29, Q30: IRLML6244; SOT-23_Handsoldering; LCSC C5123965
R1, R2, R3, R4, R5, R6, R7, R8, R9, R10, R11, R12, R13, R14, R15, R16, R17, R18, R19, R20, R21, R22, R23, R24, R25, R26, R27, R28, R29, R30, R31, R32, R33, R34, R35, R36, R37, R38, R39: 1000; R_0603_1608Metric_Pad0.98x0.95mm_HandSolder; LCSC C21190
TP1, TP2, TP3, TP4, TP5, TP6, TP7, TP8, TP9, TP10, TP11, TP12, TP13, TP14, TP15, TP16, TP17, TP18, TP19, TP20: TestPoint; TestPoint_Pad_D2.0mm; not fitted
U1, U2, U3, U4, U5, U6, U7, U8, U9, U10, U11, U12, U13, U14, U15, U16, U17, U18, U19, U20, U21, U22, U23, U24, U25, U26, U27, U28, U29, U30, U31, U32, U33, U34, U35: 74HC00; SOIC-14_3.9x8.7mm_P1.27mm; LCSC C5586

Connections:
+5V: C1.1, C2.1, C3.1, C4.1, C5.1, C6.1, C7.1, C8.1, C9.1, C10.1, C11.1, C12.1, C13.1, C14.1, C15.1, C16.1, C17.1, C18.1, C19.1, C20.1, C21.1, C22.1, C23.1, C24.1, C25.1, C26.1, C27.1, C28.1, C29.1, C30.1, C31.1, C32.1, C33.1, C34.1, C35.1, C36.1, C37.1, C38.1, D63.2 (A), J1.34, J1.36, J1.38, J1.40, Q1.3 (D), Q2.3 (D), Q3.3 (D), Q4.3 (D), Q5.3 (D), Q6.3 (D), Q7.3 (D), Q8.3 (D), Q9.3 (D), Q10.3 (D), Q11.3 (D), Q12.3 (D), Q13.3 (D), Q14.3 (D), Q15.3 (D), Q16.3 (D), Q17.3 (D), Q18.3 (D), Q19.3 (D), Q20.3 (D), Q21.3 (D), Q22.3 (D), Q23.3 (D), Q24.3 (D), Q25.3 (D), Q26.3 (D), Q27.3 (D), Q28.3 (D), Q29.3 (D), Q30.3 (D), U1.14 (VCC), U2.14 (VCC), U3.14 (VCC), U4.14 (VCC), U5.14 (VCC), U6.14 (VCC), U7.14 (VCC), U8.14 (VCC), U9.14 (VCC), U10.14 (VCC), U11.14 (VCC), U12.14 (VCC), U13.14 (VCC), U14.14 (VCC), U15.14 (VCC), U16.14 (VCC), U17.14 (VCC), U18.14 (VCC), U19.14 (VCC), U20.14 (VCC), U21.14 (VCC), U22.14 (VCC), U23.14 (VCC), U24.14 (VCC), U25.14 (VCC), U26.14 (VCC), U27.14 (VCC), U28.14 (VCC), U29.14 (VCC), U30.14 (VCC), U31.14 (VCC), U32.14 (VCC), U33.14 (VCC), U34.14 (VCC), U35.14 (VCC)
/A0: J1.23, Q1.1 (G)
/A1: J1.24, Q2.1 (G)
/A2: J1.25, Q3.1 (G)
/A3: J1.26, Q4.1 (G)
/A4: J1.27, Q5.1 (G)
/A5: J1.28, Q6.1 (G)
/A6: J1.29, Q7.1 (G)
/A7: J1.30, Q8.1 (G)
/B0: J1.13, Q9.1 (G)
/B1: J1.14, Q10.1 (G)
/B2: J1.15, Q11.1 (G)
/B3: J1.16, Q12.1 (G)
/B4: J1.17, Q13.1 (G)
/B5: J1.18, Q14.1 (G)
/B6: J1.19, Q15.1 (G)
/B7: J1.20, Q16.1 (G)
/RES0: D19.2 (A), J1.3, Q19.2 (S)
/RES1: D20.2 (A), J1.4, Q20.2 (S)
/RES2: D21.2 (A), J1.5, Q21.2 (S)
/RES3: D22.2 (A), J1.6, Q22.2 (S)
/RES4: D23.2 (A), J1.7, Q23.2 (S)
/RES5: D24.2 (A), J1.8, Q24.2 (S)
/RES6: D25.2 (A), J1.9, Q25.2 (S)
/RES7: D26.2 (A), J1.10, Q26.2 (S)
/S0: J1.35, Q17.1 (G)
/S1: J1.37, Q18.1 (G)
GND: C1.2, C2.2, C3.2, C4.2, C5.2, C6.2, C7.2, C8.2, C9.2, C10.2, C11.2, C12.2, C13.2, C14.2, C15.2, C16.2, C17.2, C18.2, C19.2, C20.2, C21.2, C22.2, C23.2, C24.2, C25.2, C26.2, C27.2, C28.2, C29.2, C30.2, C31.2, C32.2, C33.2, C34.2, C35.2, C36.2, C37.2, C38.2, H1.1, H2.1, H3.1, H4.1, J1.1, J1.2, J1.11, J1.12, J1.21, J1.22, J1.31, J1.32, J1.33, J1.39, J1.41, J1.42, R1.2, R2.2, R3.2, R4.2, R5.2, R6.2, R7.2, R8.2, R9.2, R10.2, R11.2, R12.2, R13.2, R14.2, R15.2, R16.2, R17.2, R18.2, R19.2, R20.2, R21.2, R22.2, R23.2, R24.2, R25.2, R26.2, R27.2, R28.2, R29.2, R30.2, R31.2, R32.2, R33.2, R34.2, R35.2, R36.2, R37.2, R38.2, R39.2, U1.7 (GND), U2.7 (GND), U3.7 (GND), U4.7 (GND), U5.7 (GND), U6.7 (GND), U7.7 (GND), U8.7 (GND), U9.7 (GND), U10.7 (GND), U11.7 (GND), U12.7 (GND), U13.7 (GND), U14.7 (GND), U15.7 (GND), U16.7 (GND), U17.7 (GND), U18.7 (GND), U19.7 (GND), U20.7 (GND), U21.7 (GND), U22.7 (GND), U23.7 (GND), U24.7 (GND), U25.7 (GND), U26.7 (GND), U27.7 (GND), U28.7 (GND), U29.7 (GND), U30.7 (GND), U31.7 (GND), U32.7 (GND), U33.7 (GND), U33.9, U33.10, U33.12, U33.13, U34.7 (GND), U35.7 (GND)
unnamed: D1.2 (A), Q1.2 (S), U1.1, U1.2, U2.1, U2.4
unnamed: D1.1 (K), R1.1
unnamed: D2.2 (A), Q2.2 (S), U5.1, U5.2, U6.1, U6.4
unnamed: D2.1 (K), R2.1
unnamed: D3.2 (A), Q3.2 (S), U9.1, U9.2, U10.1, U10.4
unnamed: D3.1 (K), R3.1
unnamed: D4.2 (A), Q4.2 (S), U13.1, U13.2, U14.1, U14.4
unnamed: D4.1 (K), R4.1
unnamed: D5.2 (A), Q5.2 (S), U17.1, U17.2, U18.1, U18.4
unnamed: D5.1 (K), R5.1
unnamed: D6.2 (A), Q6.2 (S), U19.1, U19.2, U20.1, U20.4
unnamed: D6.1 (K), R6.1
unnamed: D7.2 (A), Q7.2 (S), U21.1, U21.2, U22.1, U22.4
unnamed: D7.1 (K), R7.1
unnamed: D8.2 (A), Q8.2 (S), U23.1, U23.2, U24.1, U24.4
unnamed: D8.1 (K), R8.1
unnamed: D9.2 (A), Q9.2 (S), U1.4, U1.5, U2.2, U2.10
unnamed: D9.1 (K), R9.1
unnamed: D10.2 (A), Q10.2 (S), U5.4, U5.5, U6.2, U6.10
unnamed: D10.1 (K), R10.1
unnamed: D11.2 (A), Q11.2 (S), U9.4, U9.5, U10.2, U10.10
unnamed: D11.1 (K), R11.1
unnamed: D12.2 (A), Q12.2 (S), U13.4, U13.5, U14.2, U14.10
unnamed: D12.1 (K), R12.1
unnamed: D13.2 (A), Q13.2 (S), U17.4, U17.5, U18.2, U18.10
unnamed: D13.1 (K), R13.1
unnamed: D14.2 (A), Q14.2 (S), U19.4, U19.5, U20.2, U20.10
unnamed: D14.1 (K), R14.1
unnamed: D15.2 (A), Q15.2 (S), U21.4, U21.5, U22.2, U22.10
unnamed: D15.1 (K), R15.1
unnamed: D16.2 (A), Q16.2 (S), U23.4, U23.5, U24.2, U24.10
unnamed: D16.1 (K), R16.1
unnamed: D17.2 (A), Q17.2 (S), TP17.1, U33.4, U33.5, U34.9, U35.9
unnamed: D17.1 (K), R17.1
unnamed: D18.2 (A), Q18.2 (S), TP19.1, U33.1, U33.2, U35.2, U35.10
unnamed: D18.1 (K), R18.1
unnamed: D19.1 (K), R19.1
unnamed: D20.1 (K), R20.1
unnamed: D21.1 (K), R21.1
unnamed: D22.1 (K), R22.1
unnamed: D23.1 (K), R23.1
unnamed: D24.1 (K), R24.1
unnamed: D25.1 (K), R25.1
unnamed: D26.1 (K), R26.1
unnamed: D27.2 (A), Q27.2 (S), U3.1, U7.1, U11.1, U15.1, U25.1, U27.1, U29.1, U31.1
unnamed: D27.1 (K), R27.1
unnamed: D28.2 (A), Q28.2 (S), U3.4, U7.4, U11.4, U15.4, U25.4, U27.4, U29.4, U31.4
unnamed: D28.1 (K), R28.1
unnamed: D29.2 (A), Q29.2 (S), U4.1, U8.1, U12.1, U16.1, U26.1, U28.1, U30.1, U32.1
unnamed: D29.1 (K), R29.1
unnamed: D30.2 (A), Q30.2 (S), U4.4, U8.4, U12.4, U16.4, U26.4, U28.4, U30.4, U32.4
unnamed: D30.1 (K), R30.1
unnamed: D31.2 (A), U3.8
unnamed: D31.1 (K), D32.1 (K), D33.1 (K), D34.1 (K), Q19.1 (G), R31.1
unnamed: D32.2 (A), U3.11
unnamed: D33.2 (A), U4.8
unnamed: D34.2 (A), U4.11
unnamed: D35.2 (A), U7.8
unnamed: D35.1 (K), D36.1 (K), D37.1 (K), D38.1 (K), Q20.1 (G), R32.1
unnamed: D36.2 (A), U7.11
unnamed: D37.2 (A), U8.8
unnamed: D38.2 (A), U8.11
unnamed: D39.2 (A), U11.8
unnamed: D39.1 (K), D40.1 (K), D41.1 (K), D42.1 (K), Q21.1 (G), R33.1
unnamed: D40.2 (A), U11.11
unnamed: D41.2 (A), U12.8
unnamed: D42.2 (A), U12.11
unnamed: D43.2 (A), U15.8
unnamed: D43.1 (K), D44.1 (K), D45.1 (K), D46.1 (K), Q22.1 (G), R34.1
unnamed: D44.2 (A), U15.11
unnamed: D45.2 (A), U16.8
unnamed: D46.2 (A), U16.11
unnamed: D47.2 (A), U25.8
unnamed: D47.1 (K), D48.1 (K), D49.1 (K), D50.1 (K), Q23.1 (G), R35.1
unnamed: D48.2 (A), U25.11
unnamed: D49.2 (A), U26.8
unnamed: D50.2 (A), U26.11
unnamed: D51.2 (A), U27.8
unnamed: D51.1 (K), D52.1 (K), D53.1 (K), D54.1 (K), Q24.1 (G), R36.1
unnamed: D52.2 (A), U27.11
unnamed: D53.2 (A), U28.8
unnamed: D54.2 (A), U28.11
unnamed: D55.2 (A), U29.8
unnamed: D55.1 (K), D56.1 (K), D57.1 (K), D58.1 (K), Q25.1 (G), R37.1
unnamed: D56.2 (A), U29.11
unnamed: D57.2 (A), U30.8
unnamed: D58.2 (A), U30.11
unnamed: D59.2 (A), U31.8
unnamed: D59.1 (K), D60.1 (K), D61.1 (K), D62.1 (K), Q26.1 (G), R38.1
unnamed: D60.2 (A), U31.11
unnamed: D61.2 (A), U32.8
unnamed: D62.2 (A), U32.11
unnamed: D63.1 (K), R39.1
unnamed: Q27.1 (G), U34.6
unnamed: Q28.1 (G), U34.11
unnamed: Q29.1 (G), U35.6
unnamed: Q30.1 (G), U35.11
unnamed: TP1.1, U1.8, U3.2
unnamed: TP2.1, U5.8, U7.2
unnamed: TP3.1, U9.8, U11.2
unnamed: TP4.1, U13.8, U15.2
unnamed: TP5.1, U17.8, U25.2
unnamed: TP6.1, U19.8, U27.2
unnamed: TP7.1, U21.8, U29.2
unnamed: TP8.1, U23.8, U31.2
unnamed: TP9.1, U1.12, U1.13, U2.3, U2.5, U2.9, U4.5
unnamed: TP10.1, U5.12, U5.13, U6.3, U6.5, U6.9, U8.5
unnamed: TP11.1, U9.12, U9.13, U10.3, U10.5, U10.9, U12.5
unnamed: TP12.1, U13.12, U13.13, U14.3, U14.5, U14.9, U16.5
unnamed: TP13.1, U17.12, U17.13, U18.3, U18.5, U18.9, U26.5
unnamed: TP14.1, U19.12, U19.13, U20.3, U20.5, U20.9, U28.5
unnamed: TP15.1, U21.12, U21.13, U22.3, U22.5, U22.9, U30.5
unnamed: TP16.1, U23.12, U23.13, U24.3, U24.5, U24.9, U32.5
unnamed: TP18.1, U33.6, U34.1, U35.1
unnamed: TP20.1, U33.3, U34.2, U34.10
unnamed: U1.3, U1.9
unnamed: U1.6, U1.10
unnamed: U1.11, U3.5
unnamed: U2.11, U4.2
unnamed: U2.6, U2.12
unnamed: U2.8, U2.13
unnamed: U3.3, U3.9, U3.10
unnamed: U3.6, U3.12, U3.13
unnamed: U4.3, U4.9, U4.10
unnamed: U4.6, U4.12, U4.13
unnamed: U5.3, U5.9
unnamed: U5.6, U5.10
unnamed: U5.11, U7.5
unnamed: U6.11, U8.2
unnamed: U6.6, U6.12
unnamed: U6.8, U6.13
unnamed: U7.3, U7.9, U7.10
unnamed: U7.6, U7.12, U7.13
unnamed: U8.3, U8.9, U8.10
unnamed: U8.6, U8.12, U8.13
unnamed: U9.3, U9.9
unnamed: U9.6, U9.10
unnamed: U10.11, U12.2
unnamed: U10.6, U10.12
unnamed: U10.8, U10.13
unnamed: U9.11, U11.5
unnamed: U11.3, U11.9, U11.10
unnamed: U11.6, U11.12, U11.13
unnamed: U12.3, U12.9, U12.10
unnamed: U12.6, U12.12, U12.13
unnamed: U13.3, U13.9
unnamed: U13.6, U13.10
unnamed: U13.11, U15.5
unnamed: U14.11, U16.2
unnamed: U14.6, U14.12
unnamed: U14.8, U14.13
unnamed: U15.3, U15.9, U15.10
unnamed: U15.6, U15.12, U15.13
unnamed: U16.3, U16.9, U16.10
unnamed: U16.6, U16.12, U16.13
unnamed: U17.3, U17.9
unnamed: U17.6, U17.10
unnamed: U17.11, U25.5
unnamed: U18.11, U26.2
unnamed: U18.6, U18.12
unnamed: U18.8, U18.13
unnamed: U19.3, U19.9
unnamed: U19.6, U19.10
unnamed: U19.11, U27.5
unnamed: U20.11, U28.2
unnamed: U20.6, U20.12
unnamed: U20.8, U20.13
unnamed: U21.3, U21.9
unnamed: U21.6, U21.10
unnamed: U21.11, U29.5
unnamed: U22.11, U30.2
unnamed: U22.6, U22.12
unnamed: U22.8, U22.13
unnamed: U23.3, U23.9
unnamed: U23.6, U23.10
unnamed: U23.11, U31.5
unnamed: U24.11, U32.2
unnamed: U24.6, U24.12
unnamed: U24.8, U24.13
unnamed: U25.3, U25.9, U25.10
unnamed: U25.6, U25.12, U25.13
unnamed: U26.3, U26.9, U26.10
unnamed: U26.6, U26.12, U26.13
unnamed: U27.3, U27.9, U27.10
unnamed: U27.6, U27.12, U27.13
unnamed: U28.3, U28.9, U28.10
unnamed: U28.6, U28.12, U28.13
unnamed: U29.3, U29.9, U29.10
unnamed: U29.6, U29.12, U29.13
unnamed: U30.3, U30.9, U30.10
unnamed: U30.6, U30.12, U30.13
unnamed: U31.3, U31.9, U31.10
unnamed: U31.6, U31.12, U31.13
unnamed: U32.3, U32.9, U32.10
unnamed: U32.6, U32.12, U32.13
unnamed: U34.3, U34.4, U34.5
unnamed: U34.8, U34.12, U34.13
unnamed: U35.3, U35.4, U35.5
unnamed: U35.8, U35.12, U35.13

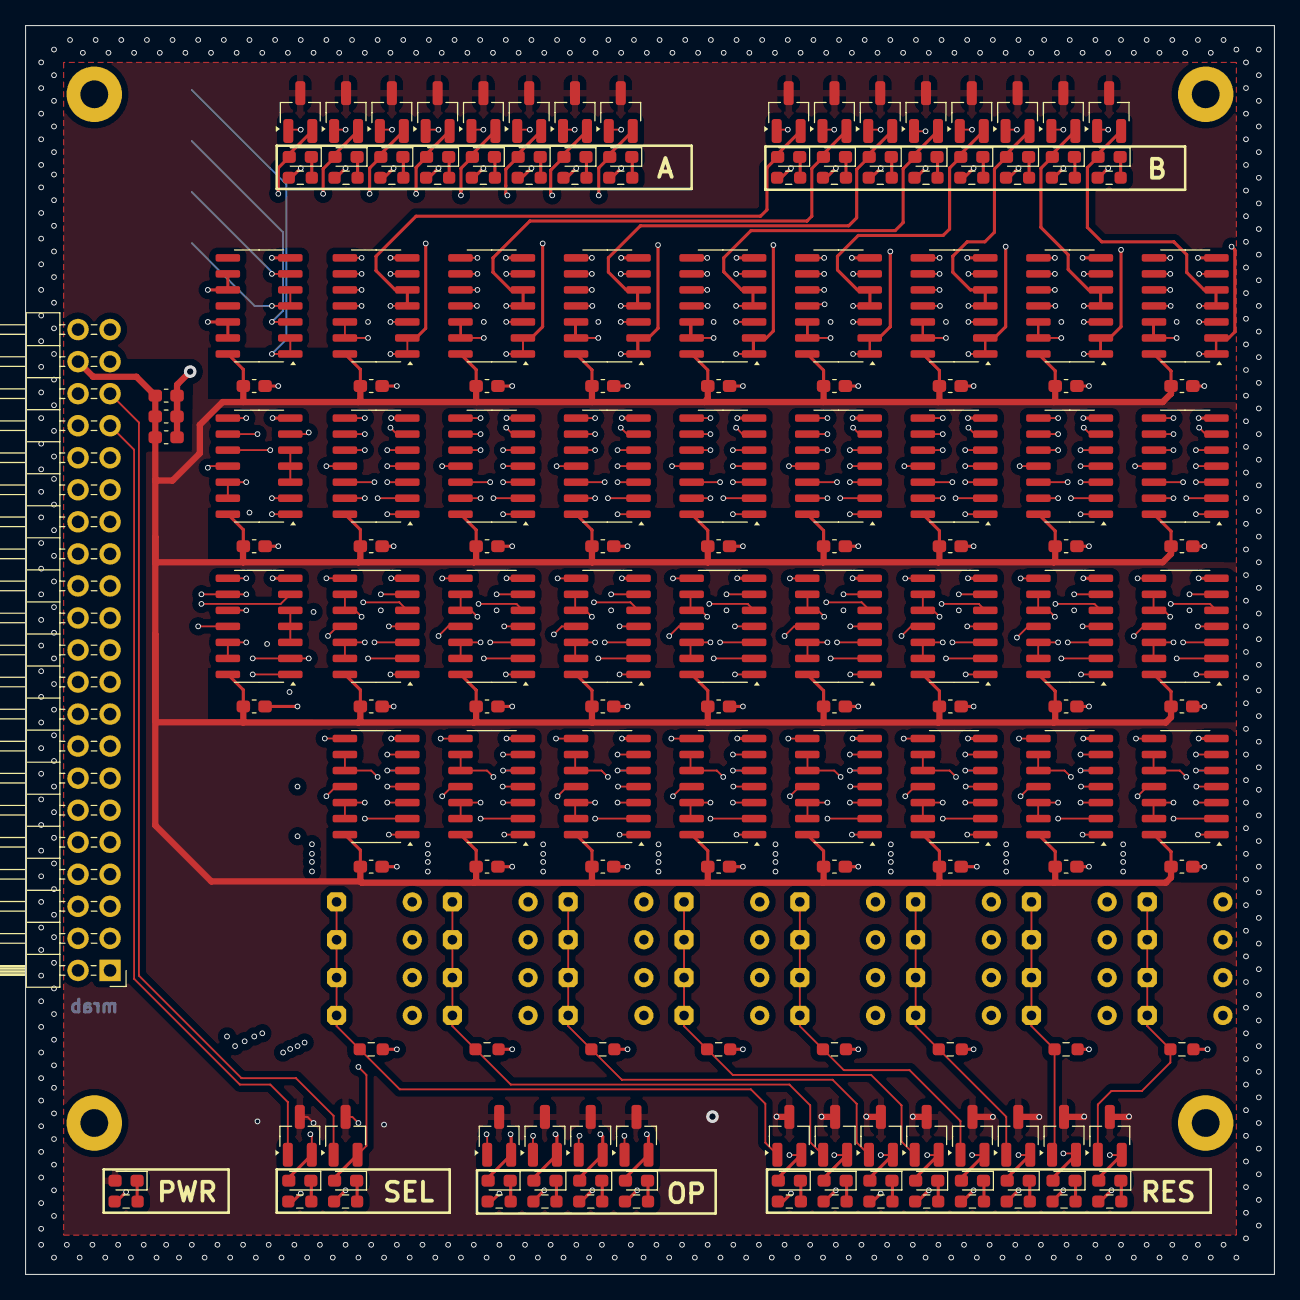
[picture p120: board alu_bitops.kicad_pcb from above]

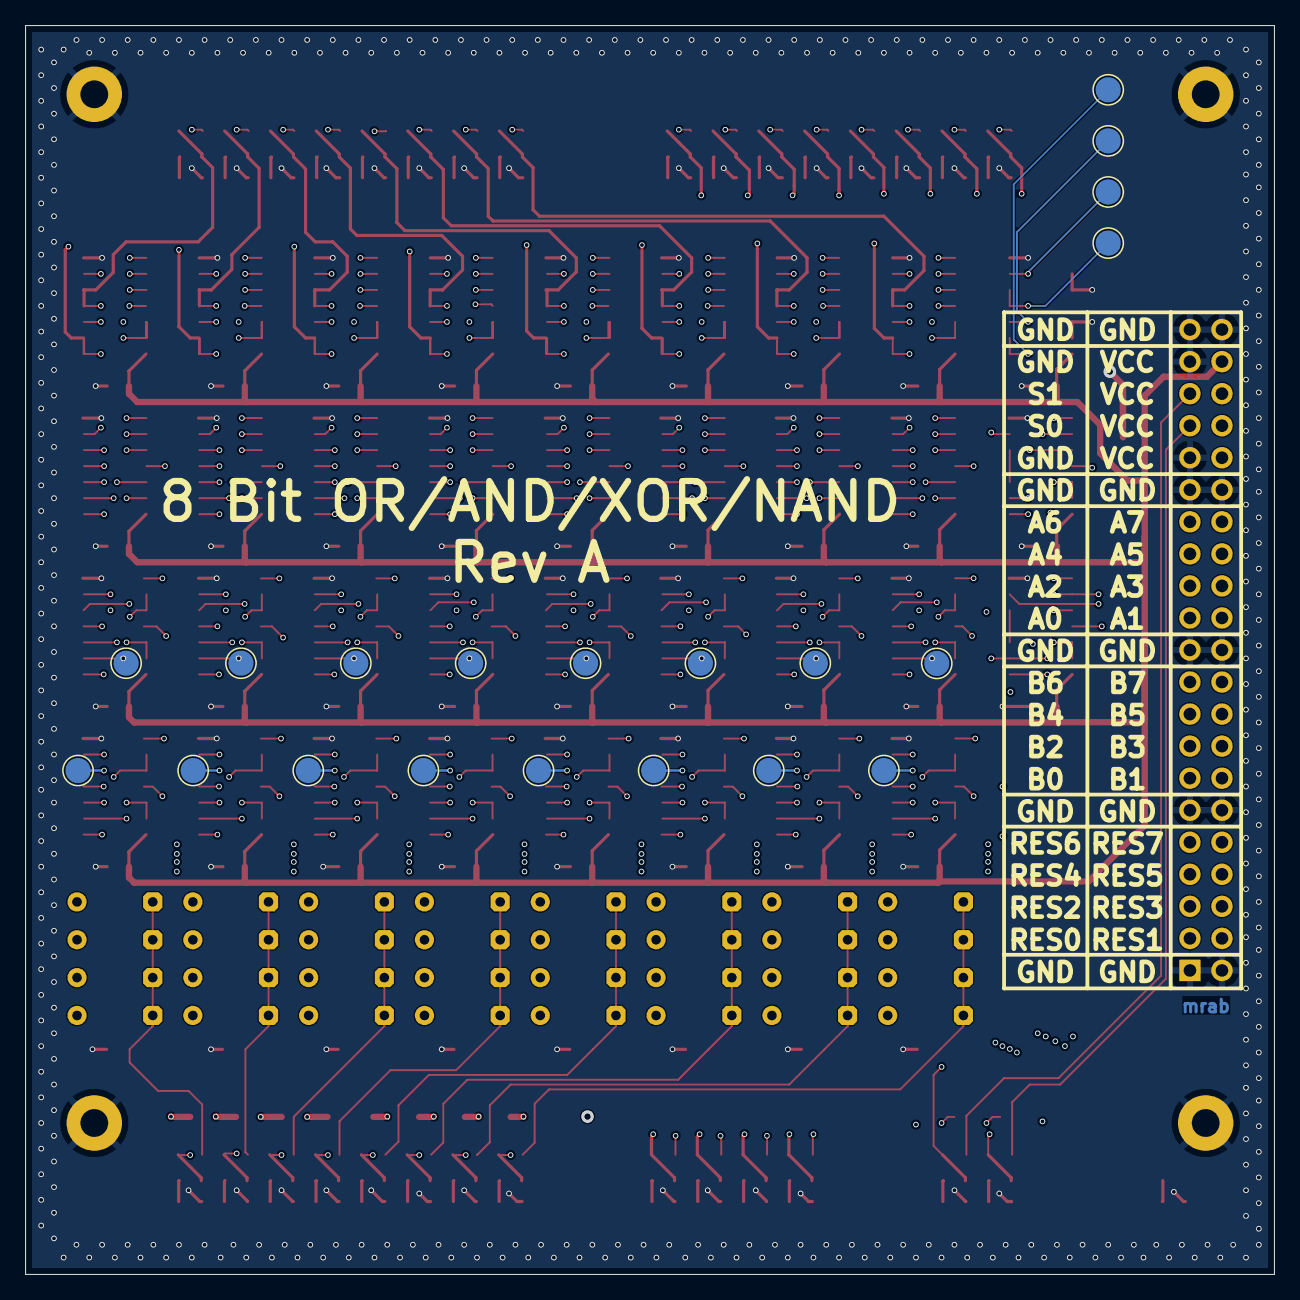
[picture p121: board alu_bitops.kicad_pcb from below]

Board: 4 copper layers, 99.0 x 99.0 mm, 230 parts (20 on the bottom side), 227 nets.
