kantholz44mm/cpu/hardware/8bit_mux/8bit_mux.kicad_pcb

## KiCad design hardware/8bit_mux/8bit_mux.kicad_pcb (2025-01-25)

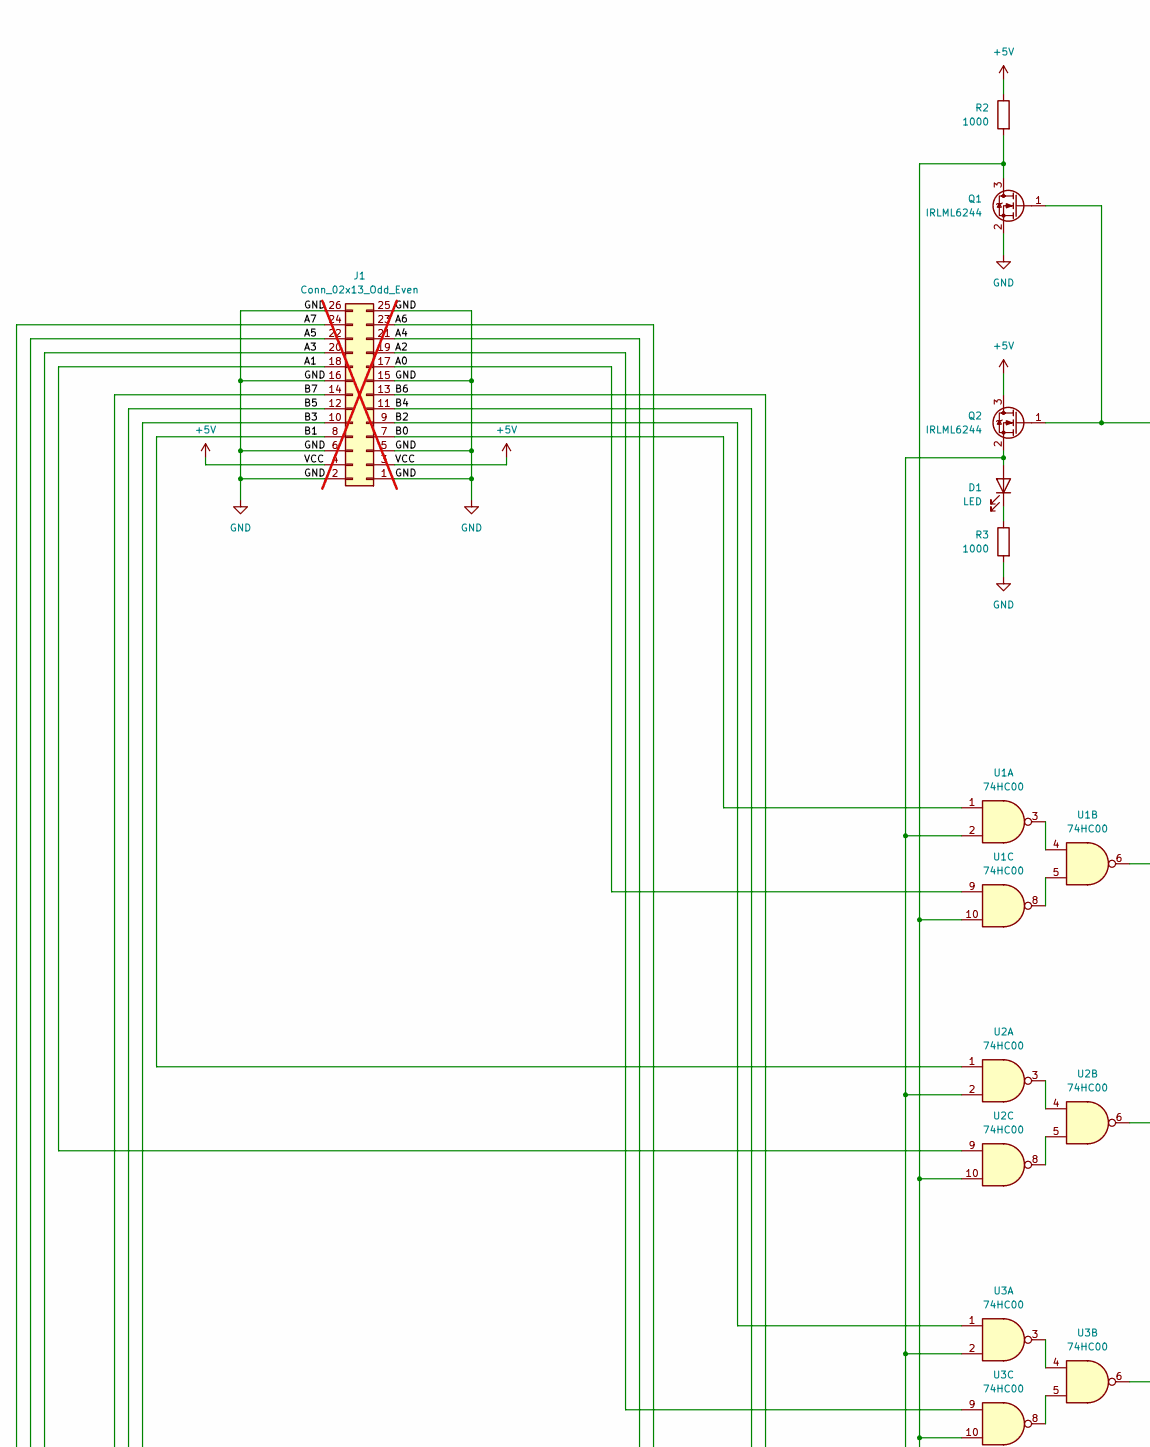
[picture p122: schematic 8bit_mux.kicad_sch, part in row 1, column 1]

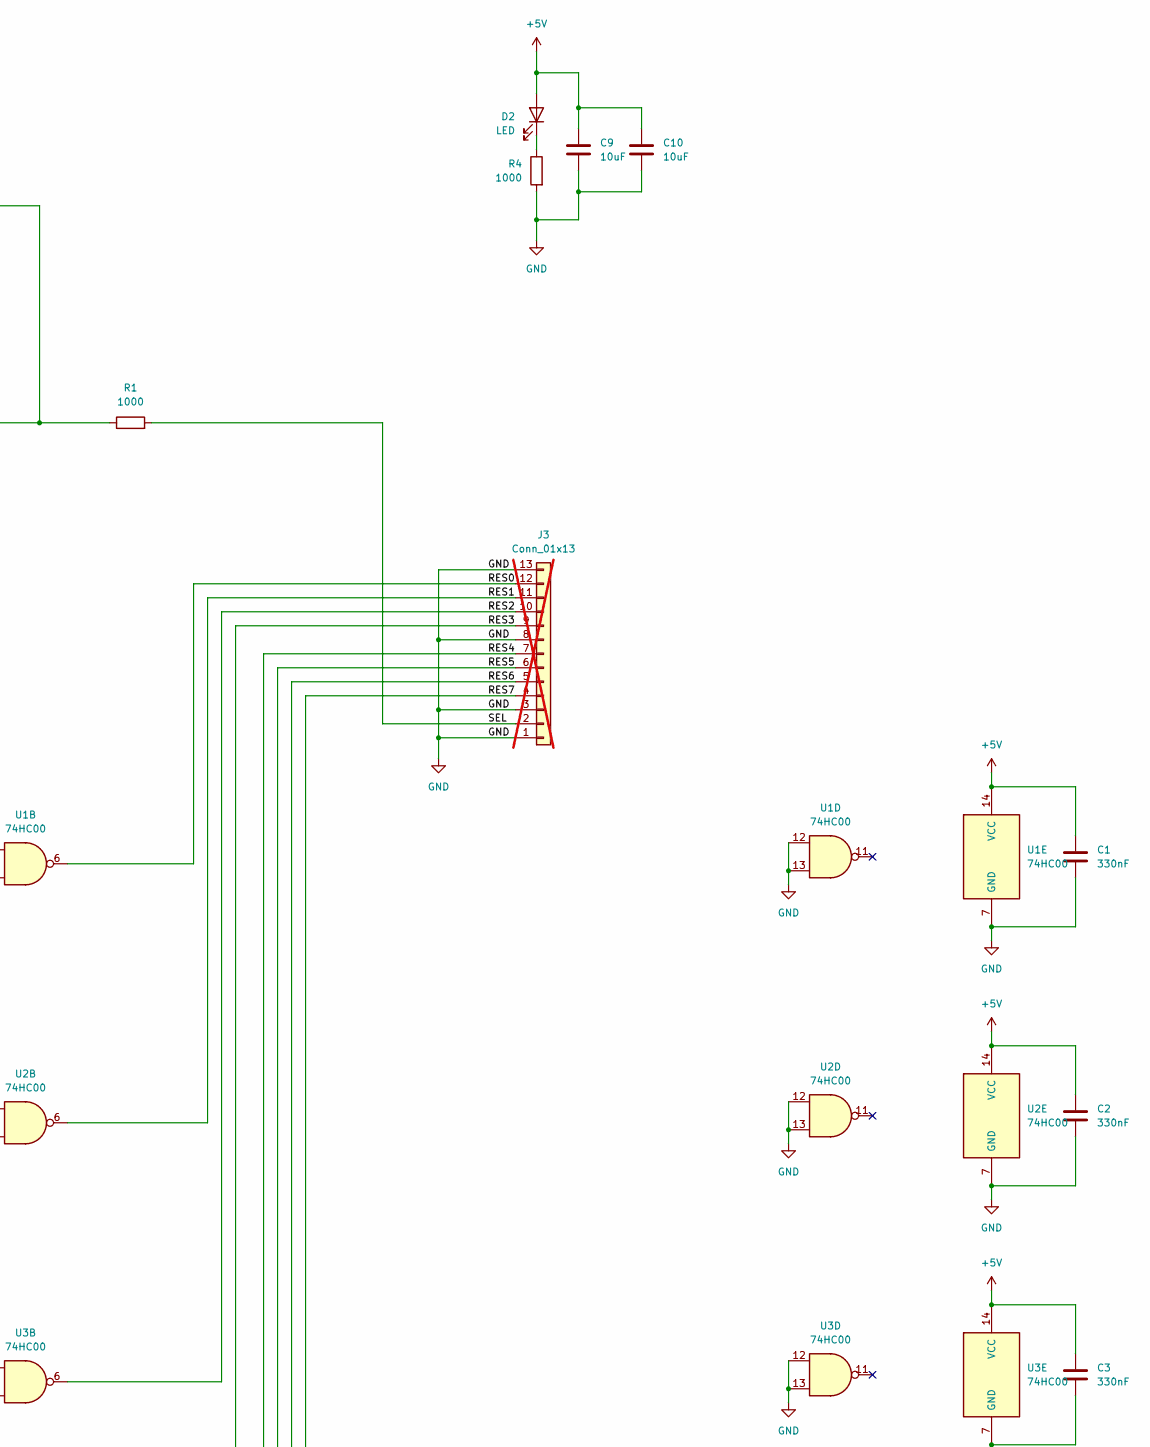
[picture p123: schematic 8bit_mux.kicad_sch, part in row 1, column 2]

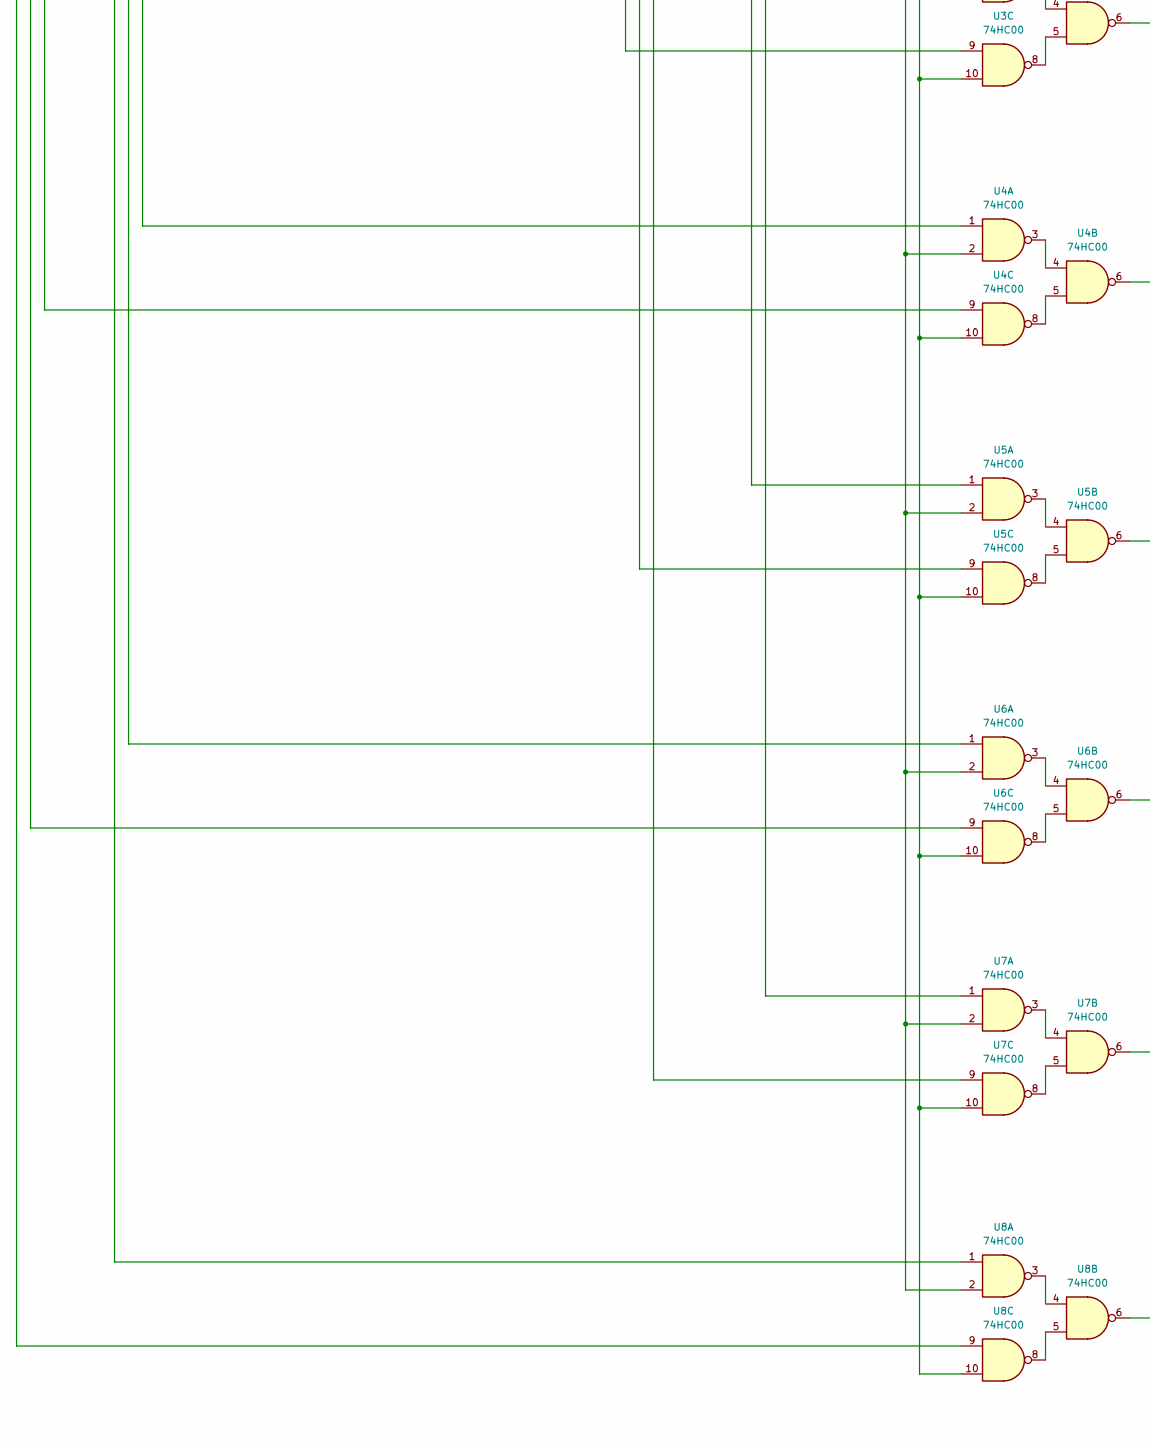
[picture p124: schematic 8bit_mux.kicad_sch, part in row 2, column 1]

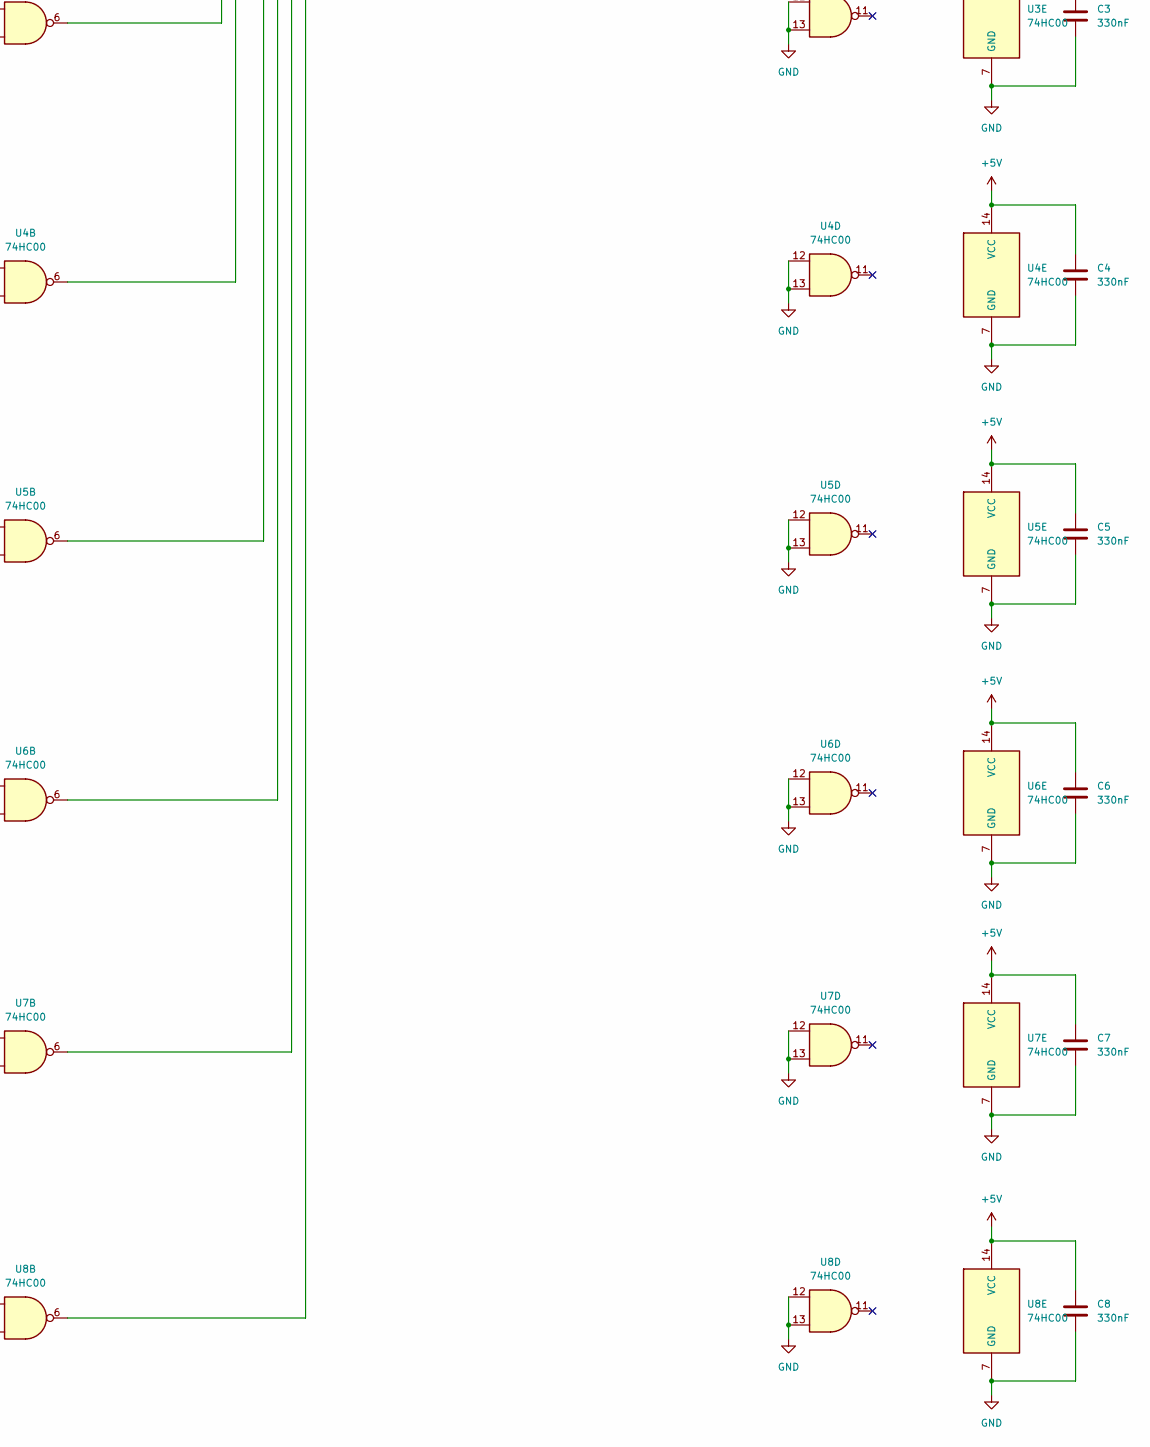
[picture p125: schematic 8bit_mux.kicad_sch, part in row 2, column 2]

Parts:
C1, C2, C3, C4, C5, C6, C7, C8: 330nF; C_0603_1608Metric_Pad1.08x0.95mm_HandSolder; LCSC C2918485
C9, C10: 10uF; C_0603_1608Metric_Pad1.08x0.95mm_HandSolder; LCSC C2909630
D1, D2: LED; LED_0603_1608Metric_Pad1.05x0.95mm_HandSolder; LCSC C84267
J1: Conn_02x13_Odd_Even; PinHeader_2x13_P2.54mm_Vertical; not fitted
J3: Conn_01x13; PinHeader_1x13_P2.54mm_Vertical; not fitted
Q1, Q2: IRLML6244; SOT-23-3; LCSC C5123965
R1, R2, R3, R4: 1000; R_0603_1608Metric_Pad0.98x0.95mm_HandSolder; LCSC C21190
U1, U2, U3, U4, U5, U6, U7, U8: 74HC00; SOIC-14_3.9x8.7mm_P1.27mm; LCSC C5586

Connections:
+5V: C1.1, C2.1, C3.1, C4.1, C5.1, C6.1, C7.1, C8.1, C9.1, C10.1, D2.2 (A), J1.3, J1.4, Q2.3 (D), R2.1, U1.14 (VCC), U2.14 (VCC), U3.14 (VCC), U4.14 (VCC), U5.14 (VCC), U6.14 (VCC), U7.14 (VCC), U8.14 (VCC)
/A0: J1.17, U1.9
/A1: J1.18, U2.9
/A2: J1.19, U3.9
/A3: J1.20, U4.9
/A4: J1.21, U5.9
/A5: J1.22, U6.9
/A6: J1.23, U7.9
/A7: J1.24, U8.9
/B0: J1.7, U1.1
/B1: J1.8, U2.1
/B2: J1.9, U3.1
/B3: J1.10, U4.1
/B4: J1.11, U5.1
/B5: J1.12, U6.1
/B6: J1.13, U7.1
/B7: J1.14, U8.1
/RES0: J3.12, U1.6
/RES1: J3.11, U2.6
/RES2: J3.10, U3.6
/RES3: J3.9, U4.6
/RES4: J3.7, U5.6
/RES5: J3.6, U6.6
/RES6: J3.5, U7.6
/RES7: J3.4, U8.6
/SEL: J3.2, R1.2
GND: C1.2, C2.2, C3.2, C4.2, C5.2, C6.2, C7.2, C8.2, C9.2, C10.2, J1.1, J1.2, J1.5, J1.6, J1.15, J1.16, J1.25, J1.26, J3.1, J3.3, J3.8, J3.13, Q1.2 (S), R3.2, R4.2, U1.7 (GND), U1.12, U1.13, U2.7 (GND), U2.12, U2.13, U3.7 (GND), U3.12, U3.13, U4.7 (GND), U4.12, U4.13, U5.7 (GND), U5.12, U5.13, U6.7 (GND), U6.12, U6.13, U7.7 (GND), U7.12, U7.13, U8.7 (GND), U8.12, U8.13
unnamed: D1.2 (A), Q2.2 (S), U1.2, U2.2, U3.2, U4.2, U5.2, U6.2, U7.2, U8.2
unnamed: D1.1 (K), R3.1
unnamed: D2.1 (K), R4.1
unnamed: Q1.3 (D), R2.2, U1.10, U2.10, U3.10, U4.10, U5.10, U6.10, U7.10, U8.10
unnamed: Q1.1 (G), Q2.1 (G), R1.1
unnamed: U1.3, U1.4
unnamed: U1.5, U1.8
unnamed: U2.3, U2.4
unnamed: U2.5, U2.8
unnamed: U3.3, U3.4
unnamed: U3.5, U3.8
unnamed: U4.3, U4.4
unnamed: U4.5, U4.8
unnamed: U5.3, U5.4
unnamed: U5.5, U5.8
unnamed: U6.3, U6.4
unnamed: U6.5, U6.8
unnamed: U7.3, U7.4
unnamed: U7.5, U7.8
unnamed: U8.3, U8.4
unnamed: U8.5, U8.8

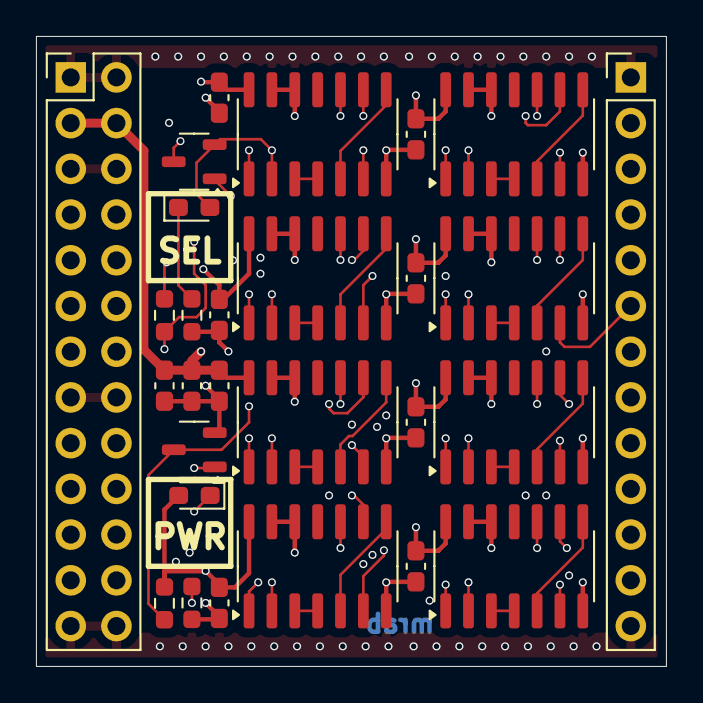
[picture p126: board 8bit_mux.kicad_pcb from above]

Board: 4 copper layers, 35.0 x 35.0 mm, 28 parts (0 on the bottom side), 48 nets.
