kantholz44mm/cpu/(commit log)

2023-11-20 started work on assembler
2023-11-20 assembler: encoding done, mostly untested as of yet
2023-11-20 added test case
2023-11-21 parsing first couple instructions
2023-11-21 all mnemonics can be assembled
2023-11-25 reverted to 4 register core
    [lexer.rs]
2023-12-21 added kicad files for register
    [register.kicad_pcb, register.kicad_sch]
2024-01-16 register file
    [register.kicad_pcb, register.kicad_sch, register_file.kicad_pcb, register_file.kicad_sch]
2024-04-21 label support for assembler
2024-04-21 comma = whitespace in assembler
2024-04-24 Fixed B Operand flag for ALUI and CMPI
    [arch.rs]
2024-10-23 clean up repo
    [register-B_Cu.gbr, register-B_Mask.gbr, register-B_Paste.gbr, register-B_Silkscreen.gbr, register-Edge_Cuts.gbr, register-F_Cu.gbr, register-F_Mask.gbr, register-F_Paste.gbr]
2024-11-07 added framework for thesis
2024-11-24 added register pcb
    [register.kicad_pcb, register.kicad_sch]
2024-11-24 started CPU emulator software
    [register.kicad_pcb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]
2024-11-24 added emulator tick logic, only ALU missing
    [main.rs, state.rs]
2024-11-25 fixed order of ALU flags
    [main.rs, state.rs]
2024-11-26 fixed overflow flag checking in fib example
    [main.rs]
2024-11-26 fixed unused imports, added 'current address' ($) to assembler
    [lexer.rs, main.rs, parser.rs, state.rs]
2024-12-04 redesigned register PCB with SMD components
    [register.kicad_pcb, register.kicad_sch]
2024-12-05 generated production files, including BOM and POS
    [bom.csv, designators.csv, positions.csv, register.kicad_pcb]
2024-12-08 redesigned register using SMD components
    [bom.csv, designators.csv, positions.csv, register.kicad_pcb, register.kicad_sch, template.kicad_sch]
2024-12-10 Added schematic for alu sub/add module
    [alu_add_sub.kicad_pcb, alu_add_sub.kicad_sch]
2024-12-11 layout done for alu add sub (missing test points)
    [alu_add_sub.kicad_pcb, alu_add_sub.kicad_sch]
2024-12-11 finalized PCB for ordering (LCSC parts, silkscreen, etc)
    [alu_add_sub.kicad_pcb, bom.csv, designators.csv, positions.csv]
2025-01-19 worked some on the thesis, started next alu module
    [alu_bitops.kicad_pcb, alu_bitops.kicad_sch]
2025-01-19 WIP, moved all control signals into OPROM, modified assembler as such
2025-01-19 added johnson 4 bit counter for synchronisation (fixes branching)
    [arch.rs]
2025-01-21 finished design of ALU binary logic module
    [alu_add_sub.kicad_sch, alu_bitops.kicad_pcb, bom.csv, designators.csv, freerouting.dsn, positions.csv, temp-freerouting.dsn]
2025-01-21 added initial schematic for ALU shifter module
    [alu_bitops.kicad_sch, alu_shift.kicad_pcb, alu_shift.kicad_sch, mux.kicad_sch]
2025-01-22 added LED indicators for ALU shift module
    [alu_shift.kicad_sch, mux.kicad_sch]
2025-01-25 added 8 bit mux pcb, started work on ALU shifter
    [8bit_mux.kicad_pcb, 8bit_mux.kicad_sch, alu_bitops.kicad_pcb, alu_bitops.kicad_sch, alu_shift.kicad_pcb, alu_shift.kicad_sch, mux.kicad_sch]
2025-01-28 finished ALU Shift module, all ALU modules completed
    [alu_shift.kicad_pcb, alu_shift.kicad_sch, bom.csv, designators.csv, positions.csv]
2025-01-31 added math expression evaluator to assembler, updated emulator
2025-02-04 started work on ALU motherboard
    [alu_motherboard.kicad_pcb, alu_motherboard.kicad_sch, mux.kicad_sch]
2025-02-04 fixed schematic of ALU motherboard
    [alu_motherboard.kicad_pcb, alu_motherboard.kicad_sch, mux.kicad_sch]
2025-02-05 finished schematic and draft of ALU motherboard
    [alu_motherboard.kicad_pcb, alu_motherboard.kicad_sch]
2025-02-09 feedback to ALU motherboard PCB
    [alu_motherboard.kicad_pcb, bom.csv, designators.csv, positions.csv]
2025-02-09 more ALU motherboard feedback
    [alu_motherboard.kicad_pcb, alu_motherboard.kicad_sch, bom.csv, designators.csv, positions.csv]
2025-02-11 reverted changes to alu_shift
    [mux.kicad_sch]
2025-02-11 added PWR indicator to alu_shift
    [alu_motherboard.kicad_pcb, alu_shift.kicad_pcb, alu_shift.kicad_sch, mux.kicad_sch]
2025-02-12 fixed mux include
    [alu_motherboard.kicad_pcb, alu_motherboard.kicad_sch, mux.kicad_sch]
2025-02-12 ALU shifter, bitops and motherboard as ordered
    [alu_bitops.kicad_pcb, alu_motherboard.kicad_pcb, alu_motherboard.kicad_sch, alu_shift.kicad_pcb, alu_shift.kicad_sch, bom.csv, designators.csv, positions.csv]
2025-03-19 finished PCB assembly layout
2025-03-20 added single-pcb ALU V2
    [alu.kicad_pcb, alu.kicad_sch, alu_add_sub.kicad_sch, alu_bitops.kicad_sch, alu_motherboard.kicad_sch, alu_shift.kicad_sch, mux.kicad_sch, register.kicad_pcb]
2025-03-23 WIP progress on ALU V2 pcb
    [alu.kicad_pcb]
2025-03-24 more WIP work on ALU V2
    [alu.kicad_pcb, alu.kicad_sch]
2025-03-25 further WIP on ALU V2 pcb
    [alu.kicad_pcb]
2025-03-25 ALU V2 done?
    [BOM-alu.csv, alu.kicad_pcb, alu.kicad_sch, bom.csv, designators.csv, positions.csv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]
2025-03-26 small fixes in ALU V2, started work on register fabric, schematic done (?)
    [alu.kicad_pcb, alu.kicad_sch, io.kicad_pcb, io.kicad_sch, register_fabric.kicad_pcb, register_fabric.kicad_sch]
2025-04-01 fixed ALU order of Op bits, finished register fabric schematic
    [alu.kicad_pcb, alu.kicad_sch, register_fabric.kicad_sch]
2025-04-01 started work on register fabric PCB layout, grouped LEDs
    [register_fabric.kicad_pcb, register_fabric.kicad_sch]
2025-04-02 finished Rev A of register fabric pcb
    [register_fabric.kicad_pcb, register_fabric.kicad_sch]
2025-04-03 added fiducials and markers to ALU, started on register fabric
    [alu.kicad_pcb, register_fabric.kicad_pcb, register_fabric.kicad_sch]
2025-04-04 added fiducials to register fabric REV A
    [register_fabric.kicad_pcb]
2025-04-06 small fixes on register fabric
    [alu.kicad_sch, io.kicad_sch, register_fabric.kicad_sch]
2025-04-08 did a good chunk of IO PCB schematic
    [io.kicad_sch, register.kicad_sch]
2025-04-15 IO PCB schematic REV A done?
    [io.kicad_pcb, io.kicad_sch]
2025-04-19 almost done with placement for IO board
    [io.kicad_pcb, io.kicad_sch]
2025-04-21 finished IO PCB placement
    [io.kicad_pcb]
2025-04-21 large chunk of IO PCB routing is done
    [io.kicad_pcb, io.kicad_sch]
2025-04-22 more work on IO PCB routing
    [io.kicad_pcb, io.kicad_sch]
2025-04-22 added section on PCB
2025-04-22 io pcb done. :)
    [io.kicad_pcb, io.kicad_sch]
2025-04-23 silkscreen done for IO PCB
    [io.kicad_pcb]
2025-04-25 added Traco DCDC, not hooked up yet
    [io.kicad_pcb, io.kicad_sch]
2025-04-27 all PCBs passing all CRC & vibe checks
    [alu.kicad_pcb, bom.csv, designators.csv, io.kicad_pcb, positions.csv, register_fabric.kicad_pcb]
2025-04-27 as ordered
    [alu.kicad_pcb, alu.kicad_sch, bom.csv, io.kicad_pcb, io.kicad_sch, register_fabric.kicad_pcb, register_fabric.kicad_sch]
2025-05-28 wrote some stuff in schematic and simulation
2025-05-29 wrote a lot about schematics and pcb, almost done.
2025-05-30 added loads of text to schematic, pcb, outro and abstract
